MaverickUK/HDDSynthPro/docs/activity-link.md

# Activity link to the HDD Synth

IDE Synth Bay knows exactly what the emulated drive is doing; the HDD Synth only sees an activity LED. This link sends the drive's activity to an HDD Synth over a one-way UART, so the synth can play a different sound for sustained sequential transfers than for random access.

> **Protocol version 2 (0.19.0):** head positions (`$HDE`) for the HDD Synth's modelled drives, and authentic seek timing (`seek_timing`, with the model from the synth's `$HDM` on the reply wire): [below](#protocol-version-2-head-positions-and-the-synths-model), from [hddsynth-head-position-brief.md](hddsynth-head-position-brief.md). The HDD Synth side is in its firmware v0.21.0. Host-tested; not yet run on the rig or with the synth.

Status: **the IDE Synth Bay side is built (0.9.0)** and sends on the rig, with a loopback test (0.10.1): fit a jumper from GPIO 0 to GPIO 1 (EXT1 pins 4 and 5), then console `U`, or `pytest -m link`. Not yet run with the jumper; with the UART's internal loopback it passes. Still to do: the HDD Synth side, briefed in [hddsynth-activity-link-brief.md](hddsynth-activity-link-brief.md); its receiver can copy `activity_link::Receiver`.

As built, it differs from the plan below in two places:
- **UART0 is driven through the Pico SDK, transmit only**, not Arduino's `Serial1`. `Serial1.availableForWrite()` only says whether one byte fits and `write()` waits when the FIFO is full, so it couldn't keep the rule that core 0 never waits; it also enables a receive interrupt, which a floating GPIO 1 could trigger. Now GPIO 1 isn't touched, and a sentence is written only when the 32-byte TX FIFO is empty, so it always fits.
- **The last operation is tracked next to the link** (`activity_link::opOf()` on each media command), not in `activity::Classifier`, which stays as it was.

## What is sent

Three things, all of which the drive already knows:

| Field | Values | Source |
|---|---|---|
| Busy | 0 or 1 | The activity LED's own rule: a command is running, or one started in the last 25 ms (`cfg::LED_MIN_MS`). Instant, so the synth can start its access sound at once, as it does from the LED today. |
| Class | `I` idle, `S` sequential, `R` random | The activity classifier (`src/activity.*`): the recent mix of sequential commands and seeks. It decides within about 100-250 ms (`activity::Config`). |
| Operation | `R` read, `W` write, `-` none | The last media command. Not used by the synth yet; sent so a later version can play different read and write sounds without a protocol change. |

The synth plays its access sound while busy, as today, and chooses the sample by class: `sequential.wav` while sequential, `access.wav` otherwise.

## HDD Synth side

Built in HDDSynth_Native **v0.18.0**. On the synth's SD card, in `settings.json`:

```json
"EXPERIMENTAL_HDDSYNTHPRO_SUPPORT": true,
"SEQUENTIAL_LED_COLOUR": "#FF1800"
```

- `EXPERIMENTAL_HDDSYNTHPRO_SUPPORT` (default `false`) turns on the receiver on J6 and `sequential.wav`; it switches the synth's OLED off, since they share J6.
- `SEQUENTIAL_LED_COLOUR` is optional (default orange, `#FF1800`): the activity LED's colour during sequential transfers.
- `sequential.wav` is optional per pack; a pack without it plays `access.wav` for sequential transfers too.
- The synth's serial `s` stats show the link (`up`/`lost`, the last class, valid and rejected sentence counts), and it logs `[link] up` and `[link] lost`.

## Wiring

Ground and one data wire. **Never connect the two boards' 3.3 V pins:** each is powered on its own.

| IDE Synth Bay (BB48) | | HDD Synth MK5 (header J6) |
|---|---|---|
| GPIO 0 (UART0 TX), EXT1 pin 4 | 1 kΩ in series | pin 3, GP25 (UART1 RX; the OLED's SCL) |
| GND, EXT1 pin 2 | | pin 2, GND |
| GPIO 1 (UART0 RX), EXT1 pin 5 | 1 kΩ in series; only for `seek_timing = synth` | pin 4, GP24 (UART1 TX; the OLED's SDA) |
| (not connected) | | pin 1, 3.3 V |

- **Power over the link (IDE Synth Bay PCB, rev 0.3 on):** the board's J3 pin 1 takes **5 V** through a Schottky diode into its supply, so a future HDD Synth can power both boards from one supply. The Mk5's J6 pin 1 carries 3.3 V, so with the Mk5 leave pin 1 unconnected (the BB48 has no such input at all).

- The 1 kΩ resistor limits the current into the synth's pin if one board is powered and the other isn't (the HDD Synth runs on its supercap after a power cut, and an unpowered RP2350's pin would otherwise be fed through its protection diodes). It doesn't matter at 115200 baud.
- J6 carries either the OLED or the link, not both: the same pins.
- GPIO 0 and 1 are off the IDE bus and away from the BB48's pull-ups on GPIO 2/3 (see [wiring.md](wiring.md)).

## Protocol, version 1

- UART, **115200 baud, 8N1**, 3.3 V logic, one way (IDE Synth Bay → synth).
- ASCII lines in the style of NMEA, so a USB-serial adapter and a terminal show them as they are:

```
$HDA,1,<busy>,<class>,<op>*<checksum>\r\n
```

| Part | Meaning |
|---|---|
| `$HDA` | Sentence name: HDD activity |
| `1` | Protocol version |
| `<busy>` | `0` or `1` |
| `<class>` | `I`, `S` or `R` |
| `<op>` | `R`, `W` or `-` |
| `*<checksum>` | Two upper-case hex digits: the XOR of every byte between `$` and `*`, as in NMEA |

Examples, with their real checksums (use them as known answers in tests):

```
$HDA,1,0,I,-*28      idle
$HDA,1,1,S,R*4C      busy, sequential reads
$HDA,1,1,R,W*48      busy, random writes
$HDA,1,1,S,W*49      busy, sequential writes
$HDA,1,0,R,R*4C      not busy this instant, recent mix still random
```

Rules:
- A sentence is sent **on every change** of any field, and **every 200 ms** regardless, as a heartbeat.
- A receiver ignores any line that doesn't start with `$HDA`, fails its checksum or is longer than 80 bytes, and ignores extra fields after the ones it knows. A later version adds fields at the end and keeps these.
- A receiver treats the link as **present** after one valid sentence, and **lost** after 1 s without one. When lost it falls back to its own activity input.
- Bandwidth: a sentence is 20 bytes (about 1.7 ms on the wire). Even random 4 KB reads at ~76 commands a second change busy far less often than that, because busy holds for 25 ms; the link stays well under its 11.5 KB/s.

## Protocol, version 2: head positions and the synth's model

Added in 0.19.0 for the HDD Synth's modelled drives (its v0.20.0 on), which synthesise the drive with a virtual head. `$HDA` stays version 1, unchanged, and a synth older than v0.21.0 ignores the new sentences.

### `$HDE`: where the head goes (IDE Synth Bay → synth)

```
$HDE,2,<pos>,<op>,<sectors>*<checksum>\r\n
```

| Field | Value |
|---|---|
| `2` | Protocol version |
| `pos` | The command's first LBA as a fraction of the disk: `lba * 65535 / (total_sectors - 1)`, 0-65535. The synth places it on the stroke itself (zoned recording puts LBA 0 at the outer edge) |
| `op` | `R`, `W` or `-` (a verify or seek), as `$HDA`'s |
| `sectors` | The command's sector count |
| checksum | As `$HDA`'s |

Known answers: `$HDE,2,0,R,8*21`, `$HDE,2,32768,W,128*2F`, `$HDE,2,65535,R,1*28`.

- One for each media command as it starts: a read or write when core 0 gets its first sector (`Fetch` carries the command's first LBA and count), a verify or seek from its trace event. Always on with the link.
- At most one every 2 ms (`cfg::LINK_HEAD_GAP_US`, about its time on the wire): faster commands keep only the newest target (`s`: `head_replaced`). A due `$HDA` (a change, or the 200 ms heartbeat) goes first, and `$HDE` takes the gaps (`activity_link::nextSentence`).
- With seek timing on, each target goes out when the modelled seek starts, not when the command arrives, so the synth's head moves when IDE Synth Bay's does.
- `s` shows `head_sent`, `head_replaced` and `head_last`.

### `$HDM`: the synth's model (synth → IDE Synth Bay)

On the link's other wire (the synth's J6 pin 4, GP24, into GPIO 1), every 2 s and at once when its pack changes:

```
$HDM,2,<V|S>,<rpm>,<cylinders>,<fullStroke ms x10>,<track ms x10>,<settleDamp x100>,<step ms x10>,<stepRamp x100>,<zoned 0|1>*hh
$HDM,2,-*hh          a recorded pack: no model
```

- GPIO 1 is UART0 RX from start-up, pulled up inside (a UART line idles high, and only pull-downs are forbidden), so unconnected it reads idle. Core 0 reads the RX FIFO on every loop pass into a `LineAssembler` (from HDD Synth's `sentence.*`) and parses with HDD Synth's own `parseModelSentence()` (`drive_timing.*`). A lost sentence doesn't matter: the next comes 2 s later.
- Bad lines are counted (`s`: `hdm_valid`, `hdm_rejected`, `link_rx_errors`), never acted on. After 5 s without a valid `$HDM` the model is forgotten.
- Only `seek_timing = synth` needs it; `$HDE` and the presets work with TX and GND alone.

### Authentic seek timing

`seek_timing` in `HDDSYNTH.INI` ([settings.md](settings.md)): `off` (default), `synth`, or a preset (`stepper85`, `voice91`, `voice97`, `fdb05`, the synth's own). Console `H` switches it off and on until a restart.

For each sector core 0 reads or writes, `seek_timing::Scheduler` says when its result may go to core 1; until then the drive shows BSY, as a real drive does during a seek (IORDY is never held for it). Read-ahead and write-behind work underneath as before: the timing only decides when each sector is released. The same holds for writes, and for DMA, whose bursts wait for each sector's result.

```
x       = lbaToStroke(lba / total_sectors, zoned)              where the head must go
start   = max(now, head_free_at)                                the head must be free
arrive  = start + seekTimeUs(head_x, x)                         0 on the same track
wait    = rotationalWaitUs(arrive, lba, 63)                     the sector coming round
ready_k = arrive + wait + transferUs(k + 1, 63)                 sector k under the head
```

- One free-running microsecond clock; the platter's angle is that clock modulo a revolution. 63 sectors a track (identify's default geometry) set the rotational and transfer times.
- **Reading straight on:** a command that starts at the sector after the last one's doesn't seek or wait for the platter: it carries on from where the last ended, with up to a revolution read ahead if the host was slow to ask, as a drive's read-ahead or write cache allows. Without this a host whose next command comes a fraction of a millisecond after the last ended (DMA through the adapter) would wait nearly a whole turn every command, and sequential transfers would run at half the media rate.
- No command is held more than 1 s (`seek_capped` in `s`). The slowest preset, `stepper85`, takes 528 ms for a full stroke.
- Not modelled yet: `SEEK` commands don't move the modelled head (no fetch reaches core 0 for them), and a write's first sector is timed from when it arrives, after the host has sent it.

## IDE Synth Bay side: the plan (version 1)

All on core 0. Core 1 and the bus timing are untouched.

1. **Pins and docs.** `cfg::PIN_LINK_TX = 0` (and `PIN_LINK_RX = 1`, reserved) in `src/config.h`; a section in `docs/wiring.md` and the wiring diagram; a note in CLAUDE.md's pin rules.
2. **Last operation in the classifier.** `activity::Classifier` keeps whether the last media command read or wrote (from the command byte it already sees). Host-tested.
3. **`src/activity_link.*`**, in two parts:
   - pure C++, host-tested: `formatSentence(busy, state, op, buf)` with the checksum, and `LinkSender`, which decides when to send (on change, or 200 ms since the last);
   - the hardware part: `Serial1` (UART0) on GPIO 0 at 115200. It writes only when `Serial1.availableForWrite()` has room for the whole sentence, so it never blocks core 0 (which must keep serving fetches). A sentence that can't be sent is replaced by the next.
4. **`main.cpp`**: `loop()` feeds the link from the same busy flag as the LED and the classifier's state, once a millisecond with the activity update.
5. **Console:** `s` shows `link_sent=` and the last sentence; `L` turns the link on or off (on by default).
6. **Tests:**
   - C++: sentence format and checksum (known answers shared with the Python parser), the send rules (change, heartbeat, a full UART);
   - Python: `host/hddproto/activity_link.py`, a parser that is also the reference for the synth's, with `sim` tests;
   - on the rig, a loopback test: a jumper from GPIO 0 to GPIO 1, and console `U` reads back what was sent. No HDD Synth needed;
   - with the synth: run the activity rig test (`-m activity`) and watch the synth switch samples.
7. Version bump, CHANGELOG, and a section in [activity.md](activity.md).

## Later

- **Protocol version 3, designed (4 Nov 2026):** the CD-ROM on the HDD Synth's OLED, FDDSynthPro-style, and discs swapped from the synth: per-drive activity (`$HDU`), the disc (`$HDD`), the CD-ROM's position (`$HDP`), the disc list (`$HDL`) and requests from the synth (`$HDQ`, answered by `$HDR`), for the synth's next hardware revision, which gives the link pins of its own: [hddsynth-cdrom-display-brief.md](hddsynth-cdrom-display-brief.md).

- More sounds from the same link: separate read and write samples (the `op` field), seek sizes, spin-down and spin-up from the drive's STANDBY and wake.
- A reply from the synth on GPIO 1 (link up, which pack, volume), if it turns out to be useful.
