MaverickUK/HDDSynthPro/docs/dma.md

# Multiword DMA

Why the drive needs DMA modes, how the data phase works, and the steps to get there.

## Why

The USB-IDE adapter paces PIO reads itself, at about one data word per 1.1 µs, whatever the mode: PIO mode 3 gained reads 2% over mode 0 (0.15.0, `speed-log.md`). In DMA the drive raises DMARQ when it has data and the host strobes it out, rather than polling, so the adapter's PIO pace and its 10 ms poll after each READ may not apply. DMA is also how faster hosts expect a drive to move data.

## How multiword DMA works on the bus

1. The host writes READ DMA (C8h) or WRITE DMA (CAh). The drive sets BSY while it gets ready.
2. The drive raises **DMARQ** (IDE pin 21). The host answers with **DMACK#** (pin 29), and strobes DIOR# (read) or DIOW# (write) once per word, **with the chip selects off**.
3. **There's no IORDY.** Each read word must be on DD within tE of DIOR# falling (50 ns in mode 2), and each write word is valid only tG (20 ns) before DIOW# rises.
4. To pause, the drive lowers DMARQ **as a strobe begins** (within tL, 35 ns in mode 2): the host finishes that word and stops until DMARQ rises again.
5. After the last word the drive clears DRQ, sets the status and raises INTRQ.

| Mode | Cycle t0 | Strobe tD | Read data tE (max) | Write setup tG | DMARQ off tL (max) |
|---|---|---|---|---|---|
| 0 | 480 ns | 215 ns | 150 ns | 100 ns | 120 / 40 ns |
| 1 | 150 ns | 80 ns | 60 ns | 30 ns | 40 ns |
| 2 | 120 ns | 70 ns | 50 ns | 20 ns | 35 ns |

## The design

**A second PIO program for the data phase** ([src/ide_dma.pio](../src/ide_dma.pio)): `ide_dma_read` and `ide_dma_write`, which fill a PIO block's 32 instructions between them. `ide_bus` keeps every register access and ignores DMA strobes (no chip select). Each burst:
- core 1 puts the number of words, less one, in the TX FIFO;
- the program raises DMARQ (side-set on GPIO 31);
- reading, RP2350 DMA streams the sector buffer into the TX FIFO, one word per entry (16-bit DMA writes); the program presents each word when DIOR# falls and releases DD when it rises, so DD is driven only during a strobe;
- writing, the program takes each word as DIOW# rises (DIOW# skips the input synchroniser and DD doesn't, so `in pins` sees DD from just before the edge), and DMA moves the RX FIFO into the sector buffer;
- DMARQ falls on the instruction after the last strobe is seen (side-set takes effect when an instruction issues, even one that then waits, so it can't go on the `wait` itself), and the program raises IRQ 0.

A burst is a sector: the device has the next one fetched (read-ahead) or a buffer free (write-behind), or DMARQ stays low until it has.

**Core 1 starts each burst** (`serviceDma` in `main.cpp`): from the main loop's step 1, and with early answers also from the tight bus loop's idle work, since in DMA the host waits for DMARQ instead of polling, so the bus is quiet between bursts and the main loop's steps would wait out `EARLY_BUS_ONLY_US` (10 ms) each time: 12 s per 64 KB read until 0.30.0-dev.3.

**The CD-ROM build** ([atapi.md](atapi.md)) uses the same programs for PACKET's data phase (0.30.0-dev.3): each block of a reply or a disc read is one burst, of any length, with the packet itself still by PIO.

**DMACK# isn't watched.** A strobe with the chip selects off only comes after DMACK#, and DD is driven only while DIOR# is low, so a host that stops early never finds the bus driven. On the PCB DMACK# is on GPIO 3 for later use (Ultra DMA needs it).

**PIO blocks:** `ide_dma` takes the third block, which SDIO will want too; how they and the diagnostics share the three is in [pio-allocation.md](pio-allocation.md).

**The data lines change hands each burst.** On the RP2350 a GPIO is driven by one PIO block at a time (its function select), and `ide_bus` fills one block, so the DMA programs go in another (the IORDY timer and bus observer share the second; the third is free). Core 1 hands DD0-15 to the DMA block before a burst and back after it, so a status read between bursts is still answered by `ide_bus`. Inputs aren't affected: every block reads every pin.

**DMARQ is driven only during a DMA command**: an input otherwise, which the host pulls down.

## Steps

1. **Simulator (done):** `ide_dma.pio` against a multiword DMA host (`host/hddproto/mdma_host_model.py`, `host/tests/test_dma_sim.py`) in modes 0-2: every word right over two-sector transfers, read data within tE and held tF, DMARQ falling 10 ns after each burst's last strobe begins, short and single-word bursts, DD released between strobes.
2. **Firmware (done, 0.16.0; not yet tried on hardware):** READ DMA and WRITE DMA in `ata_device` (unit-tested), IDENTIFY's multiword DMA words (49 bit 8, 63) and SET FEATURES 20h-22h; `ide_dma.cpp` (the DMA channel, handing DD between blocks, DMARQ only during a DMA command, tidying up when a command is cut short). Offered only when `HDDSYNTH.INI` says `mode = mdma0-2`: a host told the drive does DMA would wait for DMARQ forever where it isn't wired.
3. **Hardware (done on the rig, 0.16.2, 29 Oct):** the adapter takes multiword DMA mode 2. Against PIO mode 3 on the built-in disk: sequential reads 5.14 MB/s (1.36), random 4 KB reads 969 a second (78), writes 9.76 MB/s (1.79). The adapter's 10 ms poll after each READ, a PIO behaviour, is gone. Slices 3-4 pass in DMA. Found and fixed on the way: DMARQ rose before the first word was in the FIFO, so word 0 of every sector was lost, and the end of each command held a status poll 1.54 µs.
4. **The bus observer checks DMA data (0.16.3):** reads with no chip select count as data; 331,090 sectors checked on the rig, 0 bad. Checking every word costs core 0 enough to halve DMA reads on the built-in disk (2.6 MB/s).
5. **Next:** a soak in DMA; then SDIO ([pio-allocation.md](pio-allocation.md)), since on an SD image the card (about 1.8 MB/s over SPI) is now the limit.

## The two wires on the BB48 rig

Added on 29 Oct 2026; the PCB's pins, so the same firmware runs on both:

| IDE pin | Signal | GPIO | BB48 pin | Direction |
|---|---|---|---|---|
| 21 | DMARQ | 31 | EXT2-11 | out, only during a DMA command |
| 29 | DMACK# | 3 | EXT1-7 | in (not read yet) |

GPIO 3 carries the BB48's 2.2 kΩ pull-up to 3.3 V (R17, for I2C). The host drives DMACK#, so that's harmless. With the wires in, set `mode = mdma2` (console `E`, then `!`), and the adapter can choose DMA. At rest console `p` shows `DMARQ=0 DMACK#=1`; those levels don't prove the wires (a loose DMARQ also reads 0), DMA working does.
