MaverickUK/HDDSynthPro/host/reference/slice0_probe_jmicron_summary.txt

2 lines before the first RESET# release (power coming up), not judged:
  RESET 520963297 ASSERT
  EV 521022282 WR BOTH 2 - d532 x1 0 0142d532
From the first release:
3001 trace lines, 3001 accesses, 0 commands, 5 reset edges, 0 stalls, 0 dropped
By register:
  RD   CMD.STATUS    430
  WR   CMD.DEVICE    429
  WR   CMD.SECCOUNT  428
  WR   CMD.LBALOW    428
  WR   CMD.LBAMID    428
  WR   CMD.LBAHIGH   428
  RD   CMD.DEVICE    428
  WR   CTL.DEVCTRL   1
  RD   CTL.ALTSTATUS 1
Sequence (first 60):
  +         0 us  RESET RELEASE
  +      4608 us  WR   CTL.DEVCTRL   0000
  +      5000 us  RESET ASSERT
  +     54985 us  RESET RELEASE
  +   2641261 us  WR   CMD.DEVICE    00a0
  +   2641320 us  RD   CMD.STATUS    0000
  +   2641321 us  RD   CTL.ALTSTATUS 0000
  +   2641322 us  RD   CMD.STATUS    0000
  +   2641323 us  WR   CMD.DEVICE    00a0
  +   2641324 us  WR   CMD.SECCOUNT  00a5
  +   2641325 us  WR   CMD.LBALOW    005a
  +   2641326 us  WR   CMD.LBAMID    00aa
  +   2641327 us  WR   CMD.LBAHIGH   0055
  +   2641327 us  RD   CMD.DEVICE    0000
  +   2641328 us  RD   CMD.STATUS    0000
  +   2641331 us  WR   CMD.DEVICE    00a0
  +   2641331 us  WR   CMD.SECCOUNT  00a5
  +   2641332 us  WR   CMD.LBALOW    005a
  +   2641333 us  WR   CMD.LBAMID    00aa
  +   2641334 us  WR   CMD.LBAHIGH   0055
  +   2641335 us  RD   CMD.DEVICE    0000
  +   2641336 us  RD   CMD.STATUS    0000
  +   2641338 us  WR   CMD.DEVICE    00a0
  +   2641339 us  WR   CMD.SECCOUNT  00a5
  +   2641339 us  WR   CMD.LBALOW    005a
  +   2641340 us  WR   CMD.LBAMID    00aa
  +   2641341 us  WR   CMD.LBAHIGH   0055
  +   2641342 us  RD   CMD.DEVICE    0000
  +   2641343 us  RD   CMD.STATUS    0000
  +   2641345 us  WR   CMD.DEVICE    00a0
  +   2641346 us  WR   CMD.SECCOUNT  00a5
  +   2641347 us  WR   CMD.LBALOW    005a
  +   2641347 us  WR   CMD.LBAMID    00aa
  +   2641348 us  WR   CMD.LBAHIGH   0055
  +   2641349 us  RD   CMD.DEVICE    0000
  +   2641350 us  RD   CMD.STATUS    0000
  +   2641352 us  WR   CMD.DEVICE    00a0
  +   2641353 us  WR   CMD.SECCOUNT  00a5
  +   2641354 us  WR   CMD.LBALOW    005a
  +   2641355 us  WR   CMD.LBAMID    00aa
  +   2641355 us  WR   CMD.LBAHIGH   0055
  +   2641356 us  RD   CMD.DEVICE    0000
  +   2641357 us  RD   CMD.STATUS    0000
  +   2641359 us  WR   CMD.DEVICE    00a0
  +   2641360 us  WR   CMD.SECCOUNT  00a5
  +   2641361 us  WR   CMD.LBALOW    005a
  +   2641362 us  WR   CMD.LBAMID    00aa
  +   2641362 us  WR   CMD.LBAHIGH   0055
  +   2641363 us  RD   CMD.DEVICE    0000
  +   2641364 us  RD   CMD.STATUS    0000
  +   2641366 us  WR   CMD.DEVICE    00a0
  +   2641367 us  WR   CMD.SECCOUNT  00a5
  +   2641368 us  WR   CMD.LBALOW    005a
  +   2641368 us  WR   CMD.LBAMID    00aa
  +   2641369 us  WR   CMD.LBAHIGH   0055
  +   2641370 us  RD   CMD.DEVICE    0000
  +   2641371 us  RD   CMD.STATUS    0000
  +   2641373 us  WR   CMD.DEVICE    00a0
  +   2641374 us  WR   CMD.SECCOUNT  00a5
  +   2641375 us  WR   CMD.LBALOW    005a
Opening sequence:
  RESET RELEASE
  WR CTL.DEVCTRL 0000
  RESET ASSERT
  RESET RELEASE
  WR CMD.DEVICE 00a0
  RD CMD.STATUS
  RD CTL.ALTSTATUS
  RD CMD.STATUS
  WR CMD.DEVICE 00a0
  WR CMD.SECCOUNT 00a5
  WR CMD.LBALOW 005a
  WR CMD.LBAMID 00aa
  WR CMD.LBAHIGH 0055
  RD CMD.DEVICE
  RD CMD.STATUS
  WR CMD.DEVICE 00a0
  WR CMD.SECCOUNT 00a5
  WR CMD.LBALOW 005a
  WR CMD.LBAMID 00aa
  WR CMD.LBAHIGH 0055
  RD CMD.DEVICE
  RD CMD.STATUS
  WR CMD.DEVICE 00a0
  WR CMD.SECCOUNT 00a5
  WR CMD.LBALOW 005a
  WR CMD.LBAMID 00aa
  WR CMD.LBAHIGH 0055
  RD CMD.DEVICE
  RD CMD.STATUS
  WR CMD.DEVICE 00a0
  WR CMD.SECCOUNT 00a5
  WR CMD.LBALOW 005a
  WR CMD.LBAMID 00aa
  WR CMD.LBAHIGH 0055
  RD CMD.DEVICE
  RD CMD.STATUS
  WR CMD.DEVICE 00a0
  WR CMD.SECCOUNT 00a5
  WR CMD.LBALOW 005a
  WR CMD.LBAMID 00aa
Quiet afterwards: True
Before: STATS events=197891954 dropped=195262929 stalls=0 ring=0 window=1 skipped=6040631
After:  STATS events=197894962 dropped=195262929 stalls=0 ring=0 window=1 skipped=8137725
