MaverickUK/HDDSynthPro/media/Defrag.png

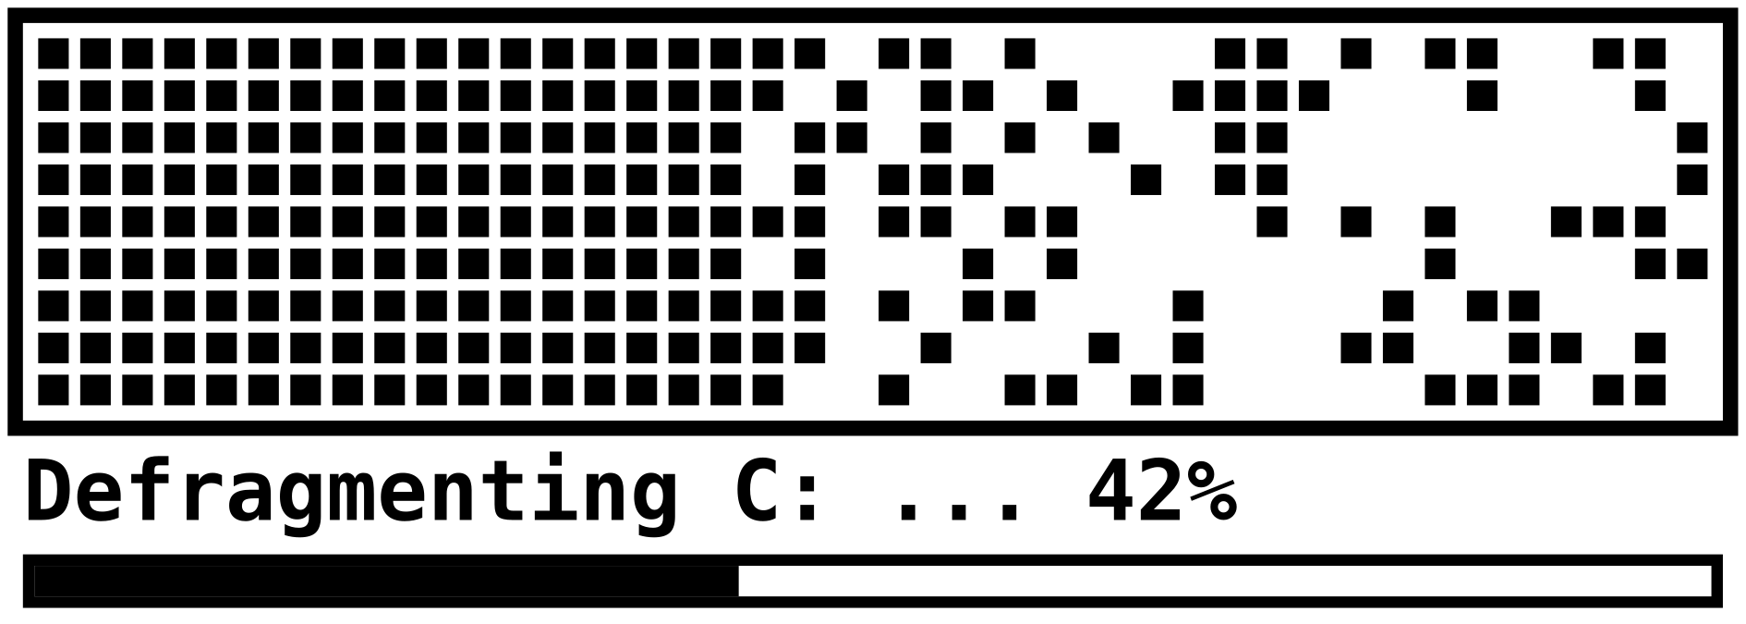
media/Defrag.png
