MaverickUK/HDDSynthPro/media/HDDSynthPro.png

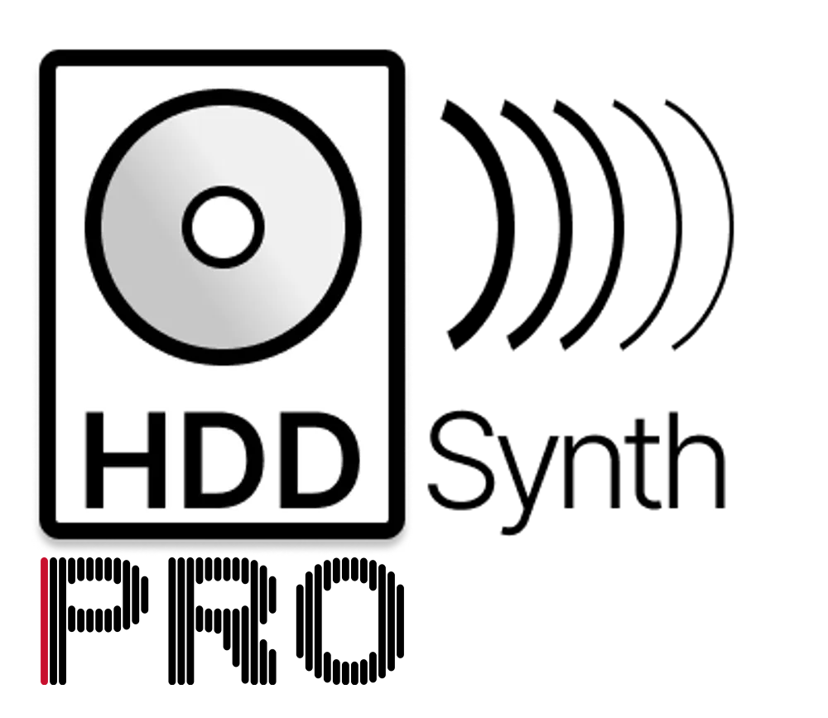
media/HDDSynthPro.png
