MaverickUK/HDDSynthPro/media/HDDSynthProMockSheet2.png

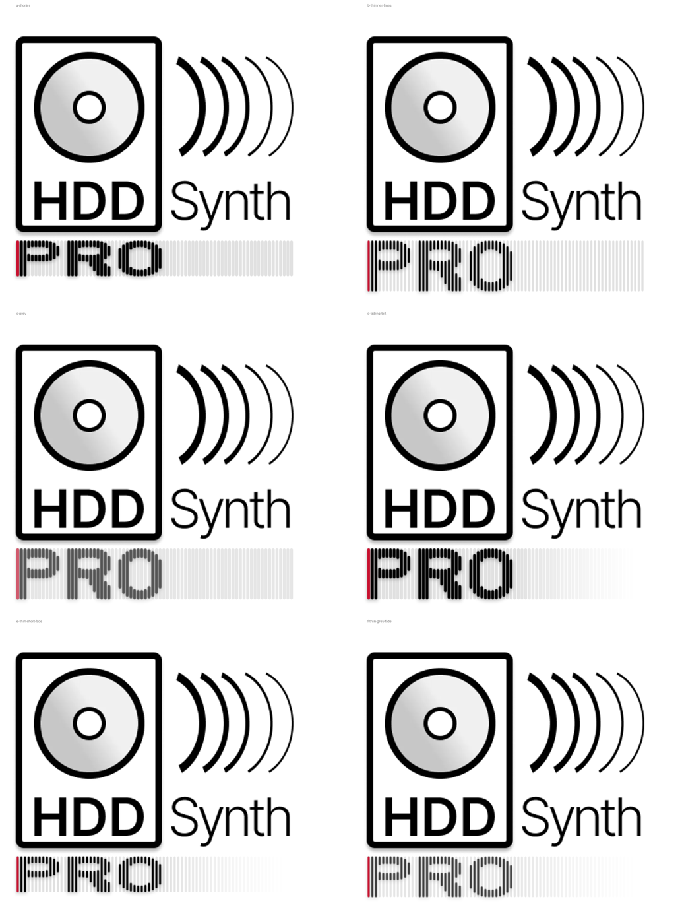
media/HDDSynthProMockSheet2.png
