MaverickUK/HDDSynthPro/media/HDDSynthProMockSheet.png

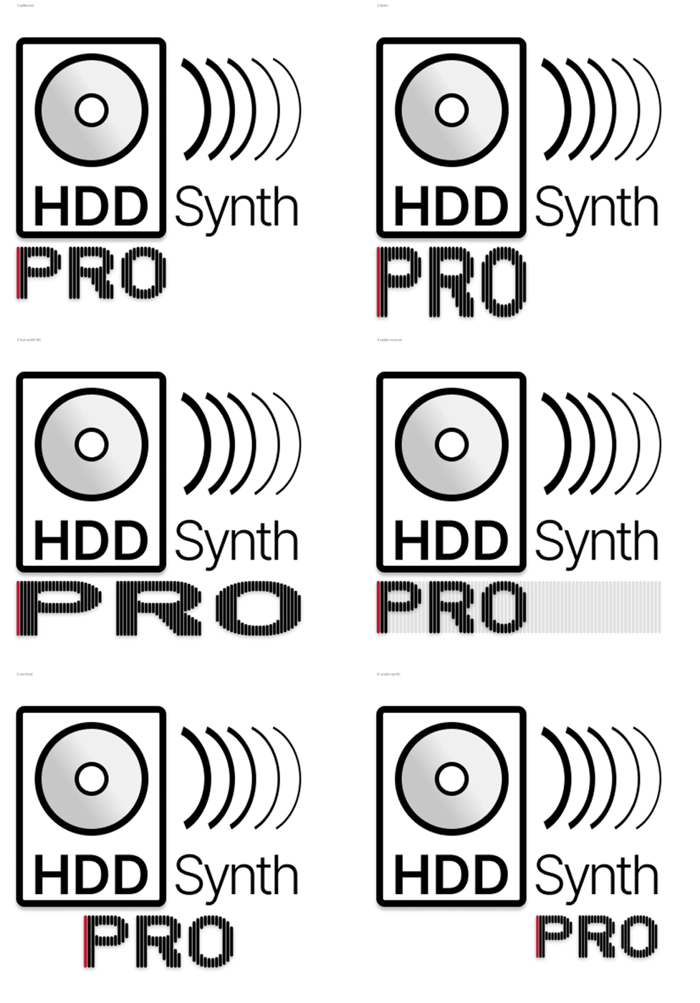
media/HDDSynthProMockSheet.png
