MaverickUK/HDDSynthPro/media/HDDSynthProWide2.png

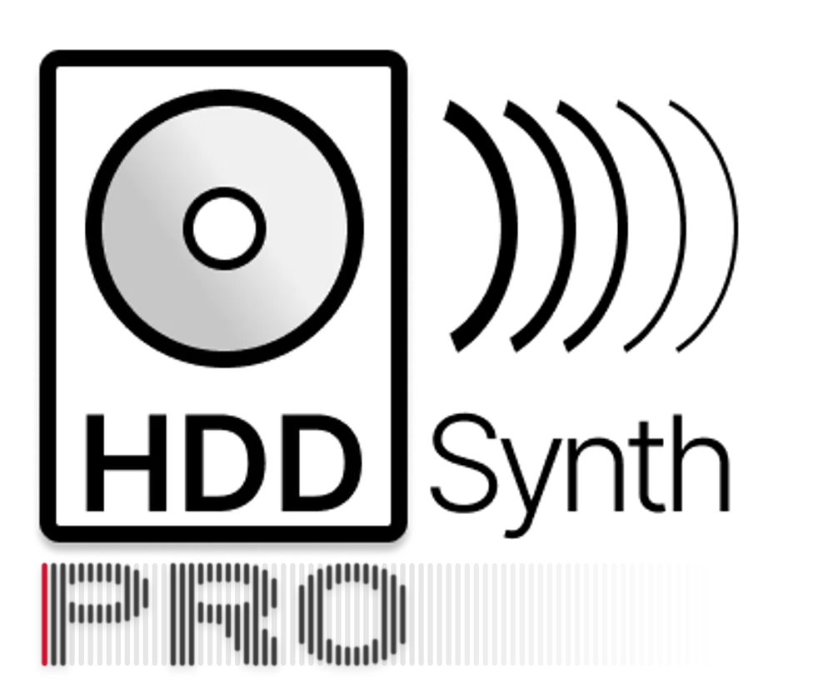
media/HDDSynthProWide2.png
