MaverickUK/HDDSynthPro/media/HDDSynthProWide.png

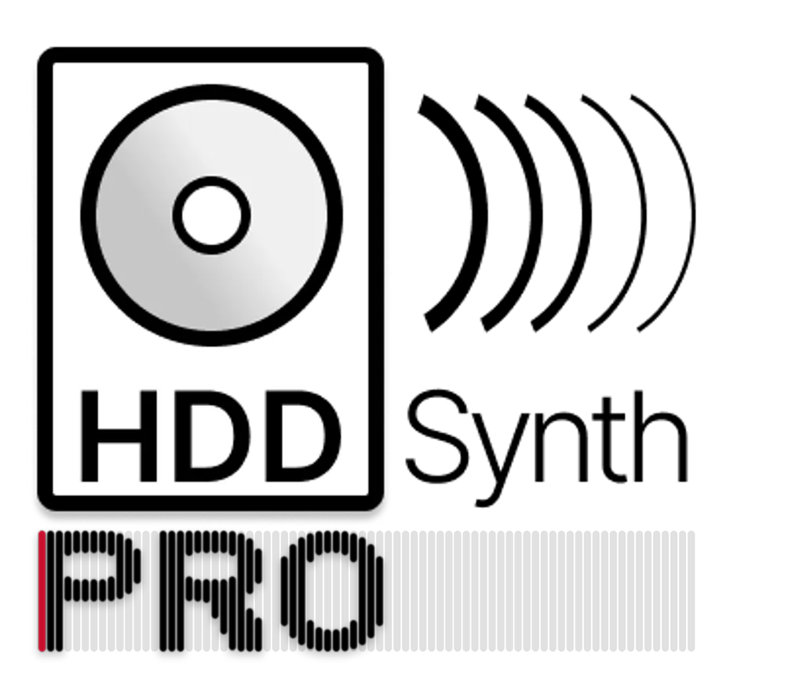
media/HDDSynthProWide.png
