MaverickUK/HDDSynthPro/media/ParkHeads.png

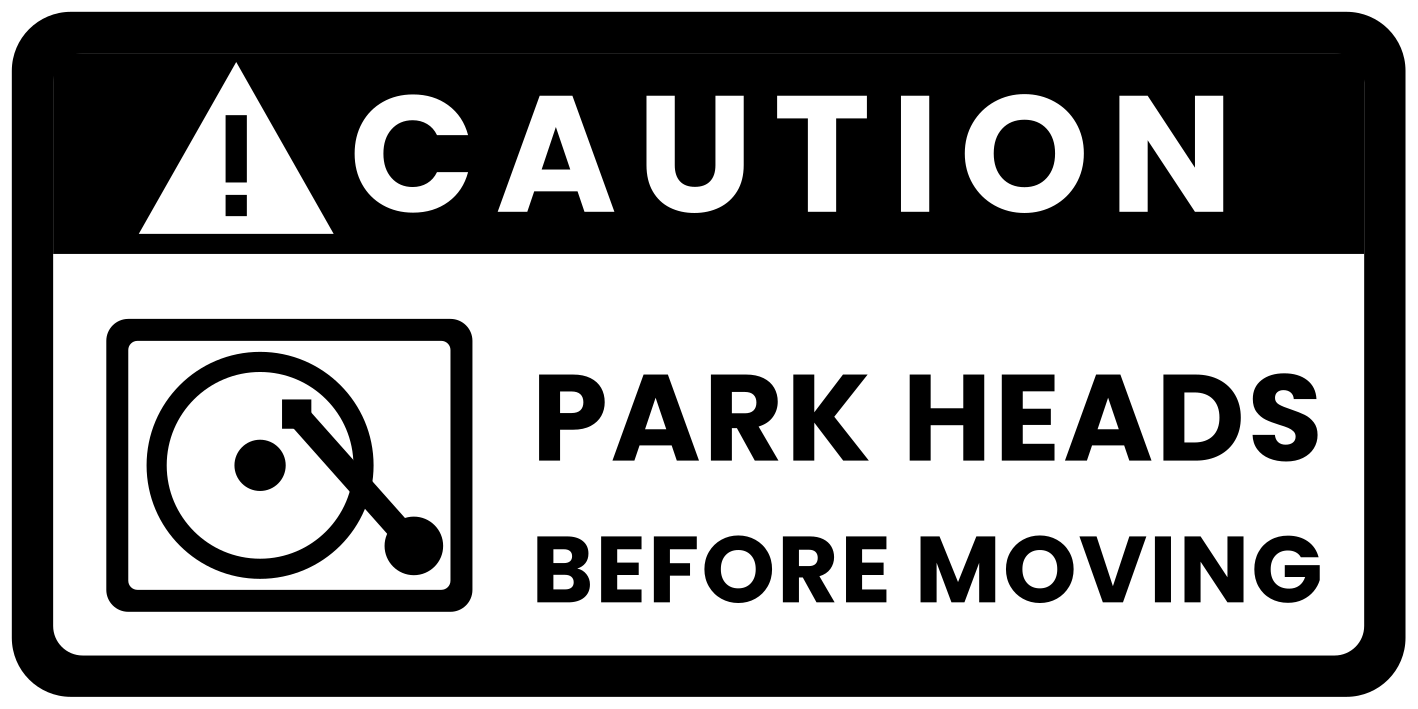
media/ParkHeads.png
