MaverickUK/HDDSynthPro/hardware/production/bom.csv

Designator | Footprint | Quantity | Value | LCSC Part #
C1, C2, C29, C36, C37, C6 | 0805 | 6 | 10uF | C15850
C10, C11, C9 | 0402 | 3 | 4.7uF | C23733
C12, C13, C14, C15, C16, C17, C18, C19, C20, C21, C22, C23, C24, C25, C26, C30 | 0402 | 16 | 100nF | C1525
C27, C28 | 0402 | 2 | 15pF | C1548
C3, C4, C5, C7, C8 | 0603 | 5 | 100nF | C14663
C31 | 0402 | 1 | 1uF | C52923
C32, C33, C34, C35 | 0402 | 4 | 10nF | C15195
D1, D2, D6 | D_SMA | 3 | SS14 | C2480
D3 | 0805 | 1 | Activity | C2297
D4 | 0805 | 1 | Power | C84256
D5, D7 | D_SOD-123 | 2 | B5819W | C8598
F1, F2, F3 | 1206 | 3 | 500mA | C19193043
J1 | USB_C_Receptacle_HRO_TYPE-C-31-M-12 | 1 | USB-C | C165948
J2 | JST_XH_B2B-XH-A_1x02_P2.50mm_Vertical | 1 | 5V in | C158012
J3 | PinSocket_1x04_P2.54mm_Vertical | 1 | Link | C2718488
J4 | microSD_TF-PUSH | 1 | microSD | C393941
J5 | IDC-Header_2x20_P2.54mm_Vertical_Pin20Unplated | 1 | IDE | C19193815
J6 | PinHeader_1x03_P2.54mm_Vertical | 1 | SWD | C2937625
J7 | PinHeader_2x22_P2.00mm_Vertical_Pin20Unplated | 1 | IDE 44 | C5371836
J8 | Molex_8981_1x04_P5.08mm_Vertical | 1 | Disk power | Molex 8981 style, 4 pins, 5.08 mm
J9 | PinHeader_1x04_P2.54mm_Vertical | 1 | CD audio
L1 | L_Abracon_AOTA-B201610S3R3 | 1 | 3.3uH | C42411119
Q1 | SOT-23 | 1 | AO3401A | C15127
R1, R2 | 0603 | 2 | 5.1k | C23186
R10, R11, R12, R13, R7, R8, R9 | 0603 | 7 | 10k | C25804
R14, R15 | 0603 | 2 | 33 | C23140
R16 | 0402 | 1 | 33 | C25105
R17, R19, R49, R50, R51, R52 | 0402 | 6 | 1k | C11702
R18, R44, R45, R46, R47, R53 | 0402 | 6 | 10k | C25744
R20, R3, R4, R6 | 0603 | 4 | 1k | C21190
R21, R22 | 0402 | 2 | 27 | C25100
R23, R24, R25, R26, R27, R28, R29, R30, R31, R32, R33, R34, R35, R36, R37, R38, R39, R40, R41, R42, R43 | 0402 | 21 | 0 | C17168
R48 | 0402 | 1 | 4.7k | C25900
R5 | 0603 | 1 | 470 | C23179
SW1 | SW_Push_1P1T_XKB_TS-1187A | 1 | BOOTSEL | C318884
SW2 | SW_Push_1P1T_XKB_TS-1187A | 1 | RESET | C318884
U1 | QFN-80-1EP_10x10mm_P0.4mm_EP3.4x3.4mm_ThermalVias | 1 | RP2350B | C42415655
U2, U3, U5, U6 | TSSOP-20_4.4x6.5mm_P0.65mm | 4 | SN74CB3T3245PWR | C15298
U4 | SOT-23-6 | 1 | USBLC6-2SC6 | C2687116
U7 | SOIC-8_5.3x5.3mm_P1.27mm | 1 | W25Q128JVSIQ | C97521
U8 | SOT-223-3_TabPin2 | 1 | AMS1117-3.3 | C6186
U9 | SOIC-8_3.9x4.9mm_P1.27mm | 1 | APS6404L-3SQR-SN | C5333729
Y1 | Crystal_SMD_3225-4Pin_3.2x2.5mm | 1 | 12MHz | C20625731
