MaverickUK/HDDSynthPro/hardware/HDDSynthPro.step

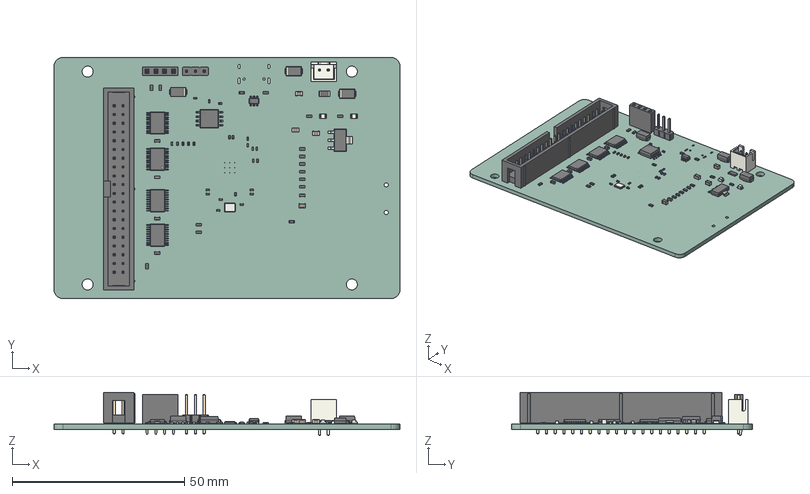
[picture p24: CAD file, 2026-10-28]
hardware/HDDSynthPro.step
100.3 x 69.9 x 12.5 mm
C_0603_1608Metric x 5
TSSOP-20_4.4x6.5mm_P0.65mm x 4
R_0603_1608Metric x 16
R_0402_1005Metric x 6
C_0402_1005Metric x 18
D_SMA x 3
JST_B2B_XH_A
C_0805_2012Metric x 4
SOIC-8_5.3x5.3mm_P1.27mm
PinSocket_1x04_P2.54mm_Vertical
IDC_Header_2x20_P254mm_Vertical
Crystal_SMD_3225-4Pin_3.2x2.5mm
LED_0805_2012Metric x 2
SOT-23-6
Fuse_1206_3216Metric
SOT-223
PinHeader_1x03_P254mm_Vertical
hddsynthpro_PCB
