MaverickUK/HDDSynthPro/docs/wiring.html

IDE Synth Bay · IDE wiring · pin map unchanged since firmware v0.1.0

# Olimex BB48 to a 40-pin IDE header

26 signal wires and the grounds. No power crosses between the boards: they share ground only. Pick any pin or row to see its wire.

Use a plain BB48, not the BB48R

On the R, GPIO 8 is the PSRAM chip-select and GPIO 9–11 and 24 go to its SD slot. Here those pins carry DD4–DD7 and CS1#.

Power order

BB48 on (USB-C) before the adapter's USB is plugged in; adapter unplugged before the BB48. Its pins are 5 V tolerant only while powered. The adapter drives the IDE lines whenever it is powered, even with nothing powered at the drive end, so an unpowered BB48 would be fed through its pins.

One strip per header pin

Before soldering the IDC helper, check with a meter that pins 1 and 2 (RESET# and GND) are on different Perma-Proto strips.

Leave these unconnected

BB48 +3.3V, 3V3_EN, VBUS and VSYS. IDE pins 20, 21, 28, 29, 32, 34 and 39.

## Pin to pin

Show all wires

Data DD0–15 Address DA0–2 Chip selects Strobes (33 Ω) IORDY · INTRQ · RESET# Ground

Left: the IDE header seen from above, pin 1 at the top, odd pins in the left column, pin 20 being the key. Right: the BB48 as drawn in Olimex's pinout, with USB-C at the top; EXT1 (GPIO 0–23) is the left row and EXT2 (GPIO 24–47) the right. Check this against the board's silkscreen. Grounds run through the Perma-Proto ground rail; they are drawn to the BB48's GND pin for clarity.

## Wiring checklist

Clear ticks

Done | IDE pin | Signal | BB48 pin | GPIO | Notes

The ticks are saved in this browser only.

## On the Perma-Proto

- Solder female headers for the BB48 rather than the board itself, so it can be swapped for your spare.
- Seat it across the centre channel at one end, with the EXT1 row (GPIO 0–23) facing the IDC helper at the other end. 21 of the 27 signals are on EXT1.
- Put the two 33 Ω resistors in DIOR# and DIOW#, close to the BB48.
- Run the IDE grounds and the BB48's GND to the same ground rail. Wire all seven IDE grounds if you can, and at least three spread along the header.
- Keep signal wires short, under 15 cm.
- Leave GPIO 32–37 free for the SD breakout in slice 5.

## First power-up check

With the adapter powered and idle, type p in the serial monitor. You should see something close to this:

PINS DD=.... DA=. CS0#=1 CS1#=1 DIOR#=1 DIOW#=1 IORDY=1 INTRQ=0 RESET#=1
- Strobes, chip selects and RESET# are high (idle).
- IORDY is high: the host pulls it up to 5 V.
- INTRQ and DD7 are low: the host pulls them down.
- The other DD and DA lines may float.

A strobe or chip select reading 0 at idle usually means a wire is on the wrong pin.
