MaverickUK/HDDSynthPro/CHANGELOG.md

# Changelog

All notable changes to this firmware. The format follows [Keep a Changelog](https://keepachangelog.com/en/1.1.0/) and versions follow [SemVer](https://semver.org/).

## [Unreleased]

## [0.32.3-dev.1] - 2026-11-11 (on `main`)

### Added
- **The drive says which bus program it would choose for the host** (step one of [docs/auto-bus.md](docs/auto-bus.md); nothing switches). `src/auto_bus.*` applies the design's rule from each RESET# release: no DMA offered, no ISA signature (DIOR# with no chip select), no read the host didn't wait for, 20 reads held past 1,000 ns all waited for, and 1,000 data sectors served. Core 0 prints `AUTOBUS lane|early (why) ... ms after reset` on each change; `s` adds `autobus`, `autobus_why`, `autobus_sectors` and `autobus_long`. Its inputs are new never-cleared totals (`bus_observer::dmaWordsTotal`, `iordy_timer::ignoredTotal` and `longTotal`, sectors served), so `r` and the timer's reset at RESET# can't upset it. Core 0 only: core 1's code unchanged (layout check). `test_auto_bus.cpp`: 7 tests. `retro_log.py` shows `AUTOBUS` and `EARLYDATA` lines. Not yet run on hardware.

## [0.32.2] - 2026-11-11

The CD-ROM's status polls held less: with a CD-ROM configured, register writes that can't change anything take a short path, and INTRQ is worked out inline (dev.1-4, below; [docs/release-notes/v0.32.2.md](docs/release-notes/v0.32.2.md)). The hard disk alone runs 0.32.1's code (layout unchanged).

- **On the Evesham** (`pcb_drive`, the card on SDIO, Doom's demo from `DOOM_SE.ISO`, 25 minutes): 0.55 reads per READ(10) past 1,250 ns, against 0.32.1's 1.32, all Alternate Status; the worst 2,390 ns, against 4,270. 1,405 READ(10), 20,546 sectors checked on the cable, 0 bad, `iordy_ignored=0`, no early reads, no card lost or restarted.
- **On the USB adapter:** `-m cdrom` on both drive builds, slices 3-4 with the CD-ROM beside the disk, and an hour's `-m cdsoak` (dev.4's entry). Slice 2 with a CD-ROM needs physical replugs (the adapter goes silent after `V`, as on 0.32.1).

## [0.32.2-dev.4] - 2026-11-11 (on `main`)

### Changed
- **Reads keep their INTRQ update with a CD-ROM again**, undoing that part of dev.2-3. On the USB adapter, which reads the CD-ROM by DMA, it made `-m cdrom` on `pcb_drive` a quarter slower (2.2-2.4 MB/s against 0.32.1's 3.1). The drive's time per READ(10) was unchanged at 7.1 ms; the gap to the next command grew from 13 to 19 ms. With it built out, 3.06 MB/s. The cause, something in the DMA path that still relies on a poll's INTRQ update, isn't found yet. The quiet writes and inline INTRQ stay. On the Evesham: 0.55 slow reads per READ(10), worst 2,390 ns (0.32.2's entry).

### Tested
- **`-m cdsoak`'s first run, an hour** on `pcb_drive` (dev.3 built without the read-side skip, the same core 1 code as dev.4), the USB adapter, the test disc as device 1 and the test disk as device 0: 498,293 CD reads (1,891,118 frames, by multiword DMA) and 99,935 disk reads between them, 0 wrong; 8,414,965 sectors checked on the cable, 0 bad, no gaps; `iordy_ignored=0`, worst read 2,850 ns. `-m cdrom` 3.06 MB/s (0.32.1: 3.1).

## [0.32.2-dev.3] - 2026-11-11 (branch `cd-slow-status`)

### Changed
- **Register accesses with a CD-ROM cost core 1 less**, so the CD-ROM's Status polls are held less. On the Evesham, slow reads per READ(10) went from 1.32 to 0.49, and the worst from 4,270 ns to 2,420. Each register write had cost core 1 about 1.6 µs, so a poll after the DOS driver's Device Control and Device writes waited behind both. `hdcd::Device::writeQuiet` handles the writes that can't start a command without `write()`'s bookkeeping; Device Control rewritten unchanged does nothing. Core 1 skips the INTRQ update after accesses that can't change it, and INTRQ is worked out inline. For `hdcd::Device` only: the hard disk alone keeps its code (layout unchanged). New test `hdcd_quiet_writes_match_write`. On the USB adapter (`bb48_drive`, the test disk and disc, MDMA 2): `-m cdrom` passes (64 MB of the disc at 2.95 MB/s), and slices 3 and 4 beside it (1,000 write-and-read-back cycles). Slice 2 sticks after its first re-detection on 0.32.1 just the same: with a CD-ROM configured the adapter goes silent after a `V` as after a restart, until a physical replug. Details: [docs/atapi.md](docs/atapi.md).

### Added
- `s` shows core 1's enabled interrupts (`c1_irq`): IRQ 26, the doorbell Arduino-Pico rings only for flash writes. `-DHDDPRO_C1_NO_IRQ=1` (bench) masks them.
- The access log (`-DHDDPRO_ACCESS_LOG=1`) splits each write into the device's part and INTRQ's, and no longer flags data reads falsely (core 1's PIO data loop now notes an empty FIFO).

## [0.32.1] - 2026-11-11

A CD-ROM on a PCI PC could hand it a wrong data word, about one in 2.5 million: fixed. From branch `cd-stale-word` (0.32.1-dev.1-6, below). For the people flashing it: [docs/release-notes/v0.32.1.md](docs/release-notes/v0.32.1.md).

- **Fixed:** a CD-ROM no longer turns `isa` on (dev.5), so the IORDY watchdog runs only where `HDDSYNTH.INI` asks for it. On the Evesham it had released IORDY mid-read, and Doom quit with a texture not found. 82,176 sectors were checked on the cable since the fix, none wrong, where the old rate gave about one per 15,000.
- **Changed:** with a CD-ROM on an ISA PC, set `isa = on` yourself; up to 0.32.0 the CD-ROM set it.
- **Added:** `EARLYDATA` and `iordy_early_data` (dev.4); the bus observer's strobe timing, `-DHDDPRO_OBSERVER_STROBE=1` (dev.1); `-m cdsoak` (dev.1); `STUCK` names a CD-ROM's command (dev.1).
- **Not in this release:** dev.6's watchdog, which starts its count over at every strobe. It's on branch `watchdog-strobes` until it has run on the ICL 386, which needs IOCS16# and so the BB48 rig or PCB rev 0.4. This release's watchdog is 0.32.0's.
- Tested: builds `bb48`, `bb48_drive` and `pcb_drive`, the core 1 checks (layout unchanged), 5,708 native checks and 426 simulation tests, and the Evesham (above).

## [0.32.1-dev.6] - 2026-11-11 (branch `cd-stale-word`; not in 0.32.1, kept on branch `watchdog-strobes`)

### Fixed
- **The IORDY watchdog (`isa = on`) starts its count over at every strobe**, not only when it sees IORDY high. Between back-to-back data reads IORDY is high at the pin only for a moment, so the old watchdog could take 23 µs of reads for one hold and release IORDY mid-read: the Evesham's wrong word (dev.5), which any host fast enough with `isa = on` could still have hit. It now also reads DIOR# and DIOW# on each 30 ns pass (a strobe lasts at least 70 ns), and its count, 767 passes, sits in ISR, set by `ide_bus.cpp` from the clock. A chip select left asserted with no strobe is released as before, 23 µs after the last strobe. 9 instructions (7 before): with `ide_bus`'s 23 they fill the block. Tested in simulation (`test_iordy_watchdog_sim.py`): back-to-back reads with IORDY never reading high between them are left alone (the old program released IORDY among them, and fails the new tests), and a stuck chip select after reads is still released. On the Evesham with `isa = on` (console `P i`, so the observer's image checks are off): it boots and serves Doom. Early reads came at a steady 1.3 per command (98 in 75, 2 of them `EARLYDATA`). The old watchdog gave about 4 per command and dev.5 none, so the new one still releases IORDY at times: perhaps legitimately, in gaps over 23 µs with the drive selected and no strobe (the ICL 386's longest was 11 µs), after which a read starts with IORDY high. Not proven safe on a PCI host: keep `isa = off` there. With the card's own settings (`isa = off`): Doom's demo on the Evesham read 40,536 sectors, all checked on the cable, with none wrong, no early reads, `iordy_ignored=0` and no card lost. With dev.5 that's about 82,000 sectors clean since the fix, where the old rate would have given about 5. Not yet tried on the ICL 386.

## [0.32.1-dev.5] - 2026-11-11 (branch `cd-stale-word`)

The Evesham's wrong CD-ROM data word, found and fixed. dev.2-4 were bench builds for the hunt. Their two experiments are gone again; dev.4's report stays.

### Fixed
- **A CD-ROM no longer turns `isa` on, so the IORDY watchdog no longer runs on PCI hosts.** To keep a CD-ROM on `ide_bus` (the data lane serves only the hard disk's blocks), the firmware forced `isa` on, which also starts `iordy_watchdog.pio`. On the Evesham (PCI, PIO 3, `isa = off` in `HDDSYNTH.INI`), the watchdog released IORDY in the middle of about one data read in 2.5 million words. It took a run of back-to-back reads for a single 23 µs hold, because it checks IORDY once every 45 ns and IORDY is high only for a moment between reads. The host then ended that read at its minimum, 225 ns, and latched DD before the drive drove it. It read the previous word, with DD7 drained low by its pull-down. Doom quit with `R_TextureNumForName: GST0T01` (10 Nov) and `DOORORAK` (11 Nov) not found. `ide_bus::begin` takes a new `lane` argument instead, and `isa` stays as `HDDSYNTH.INI` sets it, so the watchdog and IOCS16# run only with `isa = on`. Evidence, run by run: [docs/atapi.md](docs/atapi.md#a-wrong-data-word-on-the-evesham-doom-quits-10-nov-2026-0320).

### Added
- **`EARLYDATA t`**, a line for each data register read that starts with IORDY still high (the IORDY timer's early reads, data only), and `iordy_early_data` in `s`. On the Evesham it found one, at IDENTIFY PACKET during boot, and none near a wrong word.

### Tested
- **The Evesham, Doom's demo, observer on full checks, strobe timed:** 0.32.1-dev.1 gave 2 bad words in 20,344 sectors. dev.2 (DIOR# through the input synchroniser) gave 1 in 14,432 and dev.3 (DD at 8 mA) 1 in 20,545, so it isn't a DIOR# spike or slow drive. dev.4 (`EARLYDATA`) gave 1 in 19,284, with IORDY low at the bad read's start. dev.5 gave none in 41,640 sectors (where the four before averaged one per 15,000), with no early reads at all. Every bad word had a 225 ns strobe, the shortest in its sector.
- Builds `bb48`, `bb48_drive` and `pcb_drive`, the core 1 checks (layout unchanged), 5,708 native checks and 426 simulation tests.

### Known
- **The watchdog's weakness remains with `isa = on`:** an ISA host fast enough to read back to back with IORDY high only briefly between reads could hit it. A sturdier watchdog would start its count again at every strobe.

## [0.32.1-dev.1] - 2026-11-11 (branch `cd-stale-word`)

Diagnostics for the Evesham's wrong data word (below, *Found*). Core 1's code is unchanged: `check_core1_layout.py` finds every function of both drive builds where 0.32.0 had it, with and without the new build flag.

### Added
- **The bus observer can time each read's strobe** (`-DHDDPRO_OBSERVER_STROBE=1`, a bench diagnostic, off by default): `bus_observer_strobe`, a second program in `bus_observer.pio` (10 instructions to 8; the diagnostics' block then holds 31 of 32), counts its sampling loop's 15 ns passes while DIOR# is low. Its words keep the 21 sample bits and give 6 bits to the count (wrapping every 960 ns) and 5 to the sequence number (gaps still show, modulo 32). `BUSERR` then ends with `strobe_ns=` (the wrong word's read), `before_ns=`/`after_ns=` (the reads either side) and `sector_ns=min-max`. That tells the two explanations left apart: a read the host cut short (tens of ns, against hundreds for the rest) points at something electrical ending the strobe early; one as long as its neighbours means the drive offered the wrong word. Without the flag the observer, its words and `BUSERR` are as before. Tested: `test_bus_observer_sim.py` (the program's lengths, wrap and sequence), `test_pio_plan_sizes.py` (its 10 slots), and `test/run_native_tests.sh` now builds the C++ tests a second time with the flag (`run_tests_strobe`, the new `test_sector_check_reports_the_strobe_of_the_wrong_word` in both). On the PCB (`bb48_drive`, no host): it boots with the observer and the IORDY timer both on.
- **`-m cdsoak`** (`host/tests/test_cdrom_soak.py`): the test disc as device 1 read for `HDDPRO_SOAK_MINUTES` in Doom's pattern (mostly 1-3 frames anywhere), every byte checked, the observer on full checks, and device 0 read between if `HDDPRO_DISK_DEV` names it. Through the rig's adapter the CD's data goes by multiword DMA (it sets the DMA bit on every PACKET), so it can't reproduce a fault in `ide_bus`'s PIO data path; the test says which path it ran on. Not yet run.
- **The simulator's host model** (`ide_host_model.run_host`) can run read-only state machines beside the bus program (`observers=`), keep the last value on undriven DD lines (`dd_keeper=`), let IORDY rise slowly through the host's pull-up (`iordy_rise_ns=`), and end a chosen strobe after t2 whatever IORDY says (`Access.ignore_iordy`). Defaults unchanged.

### Changed
- **`STUCK` names the last command started on either device**, a CD-ROM's packet command included (`STUCK cmd=a0 READ_10 lba=3812 count=3 d1 ...`): it named the last hard disk command, as it recorded only ATA media commands.

### Tested (simulation; `host/tests/test_stale_word_sim.py`)
- **IORDY isn't late for back-to-back data reads:** `ide_bus` pulls it low again about 25-30 ns after DIOR# rises, so it's low at the next strobe's tA with recovery (t2i) down to 20 ns, far below PIO mode 3's 70 ns. The race guessed on 10 Nov (candidate 1 in docs/atapi.md) can't happen in the model.
- **A data read the host doesn't wait for, and so reads wrong, is always flagged** by `iordy_check` running beside `ide_bus`: in 1,165 such cases over core 1 latencies of 40-300 ns, strobes of 60-300 ns, recovery of 10-70 ns, a DD keeper and IORDY rising over 0-25 ns, every one flagged. So the Evesham's wrong word, with `iordy_ignored=0`, wasn't a host skipping its wait as the model knows it. Found on the way: with strobes 10 ns apart the synchronised observer can merge two reads into one word (iordy_check still flags the unwaited one).

### Found (0.32.0)
- **A wrong data word on the cable from the CD-ROM, in a retro PC** (10 Nov, the Evesham, PCB, 0.32.0, `ICL386MB.IMG` as C: and `DOOM_SE.ISO` as device 1, `ide_bus`, PIO 3). Doom's demo quit after about an hour with `R_TextureNumForName: GST0T01 not found`. The bus observer (`bb48_drive`, with the card on SPI to make room for it, full checks) flagged one sector: frame 4341, word 93 carried word 92's value (`TO` for `NE`), so `GSTONE1` arrived as `GSTOTO1`. The rest of the sector was right, and the card had read it right. That was 1 bad word in 11,294 sectors checked, with `iordy_ignored=0`. The same session's earlier failures fit it: errors on D: on dev.6, and a freeze with a striped screen on 0.32.0 over SDIO. The likeliest cause is the host reading a data word without waiting for IORDY, from a stale DD that `ide_bus.pio` had released; perhaps IORDY is pulled low too late for back-to-back reads. Analysis and next steps: [docs/atapi.md](docs/atapi.md#a-wrong-data-word-on-the-evesham-doom-quits-10-nov-2026-0320).
- **`STUCK` names the wrong command for a CD-ROM:** it records only ATA media commands, so it showed the last hard disk READ SECTORS while device 1's READ(10) was the one stuck.
- On 0.32.0 the Evesham also ran Doom cleanly for a session: 2,550 READ(10) and 253 READ SECTORS, none failed.

## [0.32.0] - 2026-11-10

One drive build per board, from branch `one-build` (0.32.0-dev.1-7); each step is below. For the people flashing it: [docs/release-notes/v0.32.0.md](docs/release-notes/v0.32.0.md).

- **`bb48_drive` and `pcb_drive` serve a hard disk, a CD-ROM drive or both, by `HDDSYNTH.INI`** (`device1 = cdrom` beside the disk, `device0 = cdrom` alone); `bb48_cdrom` and `bb48_hdcd` are gone. Core 1 has a loop per device kind, picked at boot, so the hard disk alone runs 0.31.0's code: PIO reads at 0.31.0's speed, writes within 2%.
- **The CD-ROM on the PCB's SDIO card bus.** A CD-ROM always runs `ide_bus`.
- **Core 1's hard disk code has a fixed place in RAM**, checked by CI (`scripts/core1_layout.py`, `check_core1_layout.py`); `check_core1_ram.py` follows calls through function pointers.
- **The access log** (`-DHDDPRO_ACCESS_LOG=1`), a bench diagnostic: what core 1 did before a read it answered late.
- Fixed: on the PCB, device 1's image or disc read through a PIO block the parked card had only borrowed.
- Tested: an hour's soak of each drive build (8.9 million sectors checked on the cable, 0 bad), `-m cdrom` with the CD-ROM as device 0 and 1, slices 2-4, a 30-minute SDIO card soak (0 wrong). Known: the CD-ROM's slow register reads at detection (up to about 8 us; docs/atapi.md): core 1 isn't late for them, and two candidate fixes made no difference, so the cause is looked for before the access reaches core 1. Slice 1's IORDY check still fails, as on every build since 0.28.0.
- The project is renamed IDE Synth Bay (below).

### Changed
- **The project is now IDE Synth Bay** (formerly HDD Synth Pro), as it serves CD-ROM drives as well as hard disks: the README (with the new logo, `media/IDESynthBay.png`), CLAUDE.md, the docs and these release notes use the new name. The repository, file names, identifiers, the console's `READY HDDSynthPro` and the drive's IDENTIFY model keep the old one, so nothing that matches them changes. The PCB (rev 0.4, branch `pcb-rev04`) carries the new logo.

### Tested
- **The PCB build in PIO (9 Nov, 0.31.0, the USB adapter):** `-m speed` from `HDDBENCH.IMG` over SDIO: reads 1.20 MB/s, 75 random 4 KB reads a second, writes 1.02 (the adapter's PIO pace); then `-m cardsoak` for 272 minutes: 4.97 GB written, 8.04 GB read, 606,804 commands, 8 full read-backs, **0 wrong**, no card lost or restarted, `iordy_ignored=0`. The IORDY timer, beside SDIO in that plan, counted 15.4 million reads past 1,250 ns (11.9 million Status, worst 2,070 ns; 3.5 million data, worst 1,710 ns), all waited for: early answers' known slow reads, at the rate the test disk showed without SDIO (8 Nov), so SDIO doesn't slow core 1.
- **The PCB in a retro PC (9 Nov, the Evesham, PIO 3), the benchmark image (`DOSBENCH.IMG`):**
  - `pcb_drive` on early answers: reads 2.29 MB/s (random 0.98 ms), writes 1.25 (the BB48 over SPI: 1.81 and 1.28); a 15-minute `HDDBENCH` soak: 64,792 commands, 2,390,875 sectors checked on the cable, 0 bad; no `NOIORDY`; worst Status read 1,020 ns, worst data read 500 ns. One data read at start-up was held 289 µs (at 52 s, as the BIOS started; waited for): not looked into yet.
  - `pcb_drive` on the data lane (`early_answers = off`): **reads 4.24 MB/s** (random 0.76 ms), writes 2.03 (the BB48 on the lane: 2.18 and 1.98, so SPI was what held the lane's reads back); 0 bad; 2,741 Status reads past 1,250 ns (worst 1,650 ns, the lane's known ones, [docs/data-lane.md](docs/data-lane.md)), all waited for.
- **The Evesham's unwaited CD data reads are gone on the PCB** (`bb48_hdcd`, `ide_bus`, Doom from `DOOM_SE.ISO` with its saves on C:, as on 4 Nov): 2,966 READ(10), **0 `NOIORDY`** (the BB48: 26); 3,663 data reads held past 400 ns, every one waited for, the worst 1,100 ns. So the 5 Nov guess (the Evesham doesn't sample IORDY on the data port) was wrong; the BB48's hand-wired, undamped DIOR# (the PCB has 33 Ω on DIOR#/DIOW#) is the likelier cause, by ringing seen as an early strobe end or a real one ([docs/atapi.md](docs/atapi.md)). The CD's slow Status reads are unchanged (worst 3,620 ns).

## [0.32.0-dev.7] - 2026-11-10 (branch `one-build`)

### Removed
- **dev.6's two candidate fixes for the CD-ROM's slow register reads** (`HDDPRO_HDCD_FAST_WRITES`, `HDDPRO_HDCD_LAZY_INTRQ`), measured on the bench and no help (below). The firmware's code is dev.5's again; the two tests dev.6 added to `test_hdcd` stay, as plain tests of two devices on one cable.

### Tested (10 Nov, the PCB, the USB adapter)
- **Slices 1-2** (`device1 = none`, the test disk, `mode = mdma2`, re-detections from the console): slice 2 passes; slice 1 fails its IORDY check as every build has since 0.28.0, at 1,640 ns (213 reads past 1,250 ns at detection, worst 1,730 ns, on Device). So the slow Device reads at detection aren't the CD-ROM's alone; with a CD-ROM they're three to five times longer.
- **A 30-minute card soak** (`-m cardsoak`, `HDDBENCH.IMG` over SDIO): 0 wrong, no card lost or restarted, writes 1.75 MB/s and reads 2.86 (0.31.0: 1.72 and 2.79).
- **The access log on the CD-ROM's slow reads** (three re-detections, `device1 = cdrom`, `dma = off`): about 140 reads held 4.9-7.7 us, and none of them froze the log. So core 1 had found its FIFO empty less than 1.25 us before answering each one: no long step and no backlog of register writes. The time goes before the access reaches core 1, in `ide_bus.pio`'s path from the strobe to its push, or in a way the log can't see. Its one freeze was a false alarm: core 1's PIO data loop doesn't note an empty FIFO, so 11.7 ms waiting there for the adapter counted as busy.
- **The candidate fixes, compared** (`cd_fixes.sh`, two re-detections each, the access log on; counts from the `SLOWREAD` lines): none 48 slow reads, worst 7,980 ns; fast writes 121 (twice the detections), worst 6,480; lazy INTRQ 213, worst 4,990. Per detection no fewer, and every variant far past 1,250 ns. Both together wasn't run (a console process held the port for its flash).

## [0.32.0-dev.6] - 2026-11-10 (branch `one-build`)

### Added
- **The access log** (`src/access_log.h`), a bench diagnostic built in only with `-DHDDPRO_ACCESS_LOG=1`: core 1 keeps a ring of its last 48 jobs (each access taken from the FIFO, each command run, each loop step over 0.5 us, the FIFO found empty) with its cycle counter, and when it answers a read the host is already strobing after more than 1.25 us busy, it freezes a copy, which core 0 prints as `ACCLOG` lines (how long before the late answer each began). `SLOWREAD` names a slow read but not its cause, and comes up to half a millisecond later. Off, every call compiles to nothing: core 1's layout is unchanged (`check_core1_layout.py`), and no log data is built in. On: RAM 96.3%, `check_core1_ram.py` passes.

### Build
- **`check_core1_ram.py` follows calls through function pointers.** Its docstring said core 1 makes none, but the early answers loop (`serveBusEarly`) calls its `timers`, `command` and `bus` callbacks through pointers, since before 0.30.0, so nothing checked that they and what they call were in RAM. They were. A function's address in a literal pool (odd, for Thumb, and exactly a function's start) now counts as a call: 95 functions reachable from `loop1` instead of 85, all in RAM. Found reviewing `one-build` before its merge; the review found nothing else to fix.

### Added, off
- **Two candidate fixes for the CD-ROM's slow register reads**, build switches in `src/hdcd_device.h`, off until measured on the bench (`host/runs/bench/cd_fixes.sh`, git-ignored, compares them): `HDDPRO_HDCD_FAST_WRITES` sends a Data write to the selected device only (the other's `write()` ignored it anyway) and a task-file register's (Features, Sector Count, LBA) to both by an inlined `latch()` (new in `ata::Device` and `atapi::Device`: `write()`'s path for those registers), skipping `write()`'s calls and `noteStarts`; `HDDPRO_HDCD_LAZY_INTRQ` skips `updateIntrq` after a task-file register's write, which can't change the interrupt or who drives it. Both keep what the host sees as it is: `test/run_native_tests.sh` now also builds `test_hdcd` with the fast writes on (`run_hdcd_fast`), and both builds pass, with two new tests (`hdcd_disk_writes_with_a_cdrom_beside_it`, `hdcd_task_file_writes_reach_both_devices`). Off, the firmware's hard disk code is unchanged (`check_core1_layout.py`) and so is the CD-ROM's (`hdcd::Device::write` 128 bytes); on, `hdcd::Device::write` is 300 bytes and `check_core1_ram.py` passes.
- **`docs/bench-checklist.md` rewritten** for the next session: the old one (4-5 Nov) named the builds 0.32.0 removed.

### Found, to measure
- **The CD-ROM's slow Device reads on `ide_bus`** (10 Nov, `pcb_drive` dev.5, `device1 = cdrom`, `dma = off`, detection through the USB adapter): one Device read held 4,900-5,620 ns just before every IDENTIFY and IDENTIFY PACKET, with an Alternate Status read of 2,100-2,400 ns after it, and Alternate Status at 3,300-3,400 ns before device 1's SET FEATURES and TEST UNIT READY. Repeatable to within 15%, so systematic. Not flash (core 1's literal pools hold flash addresses only in `mmc`'s per-command sense codes), not `selectUnit` (a few stores). The adapter's register check writes five registers back to back, then reads Device: with a CD-ROM each write runs both devices' `write`, `noteStarts` and `updateIntrq`'s two `intrq()` calls, perhaps 0.6 us, but that can't build a 5 us backlog by itself. The access log will say; [docs/atapi.md](docs/atapi.md) has the details.

## [0.32.0-dev.5] - 2026-11-09 (branch `one-build`, overnight)

### Build
- **Core 1's hard disk code has a fixed place in RAM, and CI checks it.** Arduino-Pico's linker script took `.time_critical*` in link order, the source files' alphabetical order, which is how `atapi_device.cpp` once landed between `ata_device.cpp` and `ide_bus.cpp`. `scripts/core1_layout.py`, run by PlatformIO after it generates the linker script, puts `CORE1_RAM` code first in `.data`, file by file in a listed order (0.31.0's), any other file's after them, between the symbols `__core1_hd_start` and `__core1_hd_end`. `scripts/check_core1_layout.py` compares every function there (address, size, name) with `scripts/core1_layout/<env>.txt` and fails on a difference; CI runs it, `rig.sh` warns. Every symbol in both drive builds is where it was (`nm` compared), so the firmware is unchanged; swapping two files in the list moved them, and the check failed, as meant. `host/tests/test_core1_layout.py` tests the linker patch.

### Changed
- **The hard disk's core 1 code is back where 0.31.0 had it.** dev.2-4 read 2.5% slower in PIO than 0.31.0 with byte-identical functions: the CD-ROM's code (`atapi::Device`, from `atapi_device.cpp`, which links before `ide_bus.cpp`) sat between `ata::Device` and `ide_bus`, moving everything after it about 3.6 KB. The CD-ROM's core 1 code now has a section of its own, `CORE1_RAM_CD` (`.after_data.core1_cd`, still RAM, placed after all of `CORE1_RAM`): `atapi_device`, `hdcd_device`, `mmc`, and the `hdcd::Device` copies of `ide_bus`'s and `main.cpp`'s per-access functions, which are now a plain function per device around an inlined template (`IDE_BUS_FOR`, `CORE1_FOR`), defined in 0.31.0's order. `ide_bus`'s hard disk functions start at 0.31.0's addresses (`laneSyncSlow` 0x20000e2c on); GCC's own order puts `serveOther` before `serviceOnce`, so the rest are within 0x390 bytes of theirs, and `main.cpp`'s are together as before.
- **Measured** (`pcb_drive` builds on the PCB, the USB adapter, PIO 3, early answers, the test disk): reads 1.20 MB/s at 337-338 µs a sector and 75.6-75.8 random reads a second, the same as 0.31.0's `pcb_drive` (1.20, 337 µs, 75.7); dev.4 1.18 (345 µs, 75.1). Writes 1.11 MB/s against 1.13 (dev.4 1.11): not core 1's per-access code, which matches 0.31.0's but for literal pools (disassembly compared) and `updateIntrq` (`intrqDriven()` forced inline, as GCC otherwise shares an out-of-line copy in flash); core 0, whose flash code grew, is the next suspect. Worst read 2,100 ns (0.31.0: 2,070).
- **Soaked** (10 Nov, overnight, the PCB, the USB adapter, the test disk, PIO 3, early answers, the bus observer on full checks, an hour each): `bb48_drive` dev.5 2,537 MB, 87,615 commands, 4,350,249 sectors checked on the cable, 0 bad, 0 gaps, no mismatches; `pcb_drive` dev.5 (the card on SPI, left so by the `bb48_drive` run) 2,664 MB, 91,741 commands, 4,567,256 sectors, 0 bad, 0 gaps, no mismatches. Both: `iordy_ignored=0`, worst read 2,110 ns (Status, early answers; 0.31.0 reaches 2,070), worst data read 1,740 ns, no resets.
- **The CD-ROM's code from its new section works** (10 Nov, `pcb_drive` on the PCB, the card on SDIO, the USB adapter, `device1 = cdrom`, `mode = mdma2`): Windows mounted `DOOM_SE.ISO` as D:, and with the test disc and the test disk `-m cdrom` passes (64 MB of the disc read at 3.46 MB/s, random and first and last frames), as do slices 3-4 beside it. Overnight it had looked broken: the card's settings were the Evesham's (`dma = off`), and this adapter sets the DMA bit on every PACKET (docs/atapi.md), so the drive refused TEST UNIT READY (ABRT), the adapter reset and detected again every 20 s, and Windows showed neither drive. Not a firmware fault; the release notes now say so.
- **Rig tests:** with a CD-ROM configured, Windows polls it (GET EVENT STATUS NOTIFICATION) once a second, so `DriveLog.wait_quiet()` never saw a quiet second and slices 1-2 timed out before their first cycle. A CD-ROM's routine polls (`GET_EVENT`, `TEST_UNIT_READY` and the `DONE` after each) no longer count as activity (`PollFilter`, `tests/test_drive_log.py`). Not yet rerun on the rig: the adapter went silent after the drive restarted with a CD-ROM configured (the known limit) and needs a replug.

## [0.32.0-dev.4] - 2026-11-09 (branch `one-build`)

### Fixed
- **`S` and `s` said the diagnostics ran after a disc had taken their PIO block** (console `M` into a CD-ROM that started with no disc on the card, on the PCB): `CONFIG pio ... iordy_timer=off bus_observer=off (the card took the diagnostics' block for a disc, until a restart)`, and `s` says `diag=off`.

### Tested (the PCB, `pcb_drive` dev.3)
- **SDIO with a CD-ROM as device 0:** after the BB48 builds the card ran over SPI with the warning; taken out and put back, it came up on SDIO, parked (`sdio-idle`) with the test disc served, and the adapter detected the CD-ROM on `ide_bus` from the settings alone. `M DOOM_SE.ISO` put the owner's ISO in over the borrowed block, which the card kept (`bus=sdio`); a following `S` didn't take it back. Windows read all 27 files (22.7 MB) at 6.70 MB/s, twice, the passes agreeing; no card lost or restarted, `iordy_ignored=0`.

## [0.32.0-dev.3] - 2026-11-09 (branch `one-build`)

### Fixed
- **A CD-ROM as device 0 was never detected through the USB adapter** on early answers (the setting's default): the adapter polled Status, held 1.8-2.4 µs each, and never sent a command, then dropped off USB, as with a CD-ROM as device 1 on 4 Nov (0.30.0-dev.10). `bb48_cdrom` had managed on early answers with `atapi::Device` alone; through `hdcd::Device` each access costs more. Now any CD-ROM runs `ide_bus` (console `P e` still picks early answers); `S` says `CONFIG with a CD-ROM as device 0, ide_bus`.

### Tested (the PCB, the USB adapter, Windows; dev.2 and dev.3)
- **A CD-ROM as device 1** beside the test disk (`mode = mdma2`): `-m cdrom` reads the whole 64 MB test disc right at 3.37 MB/s (0.30.0-dev.3, without read-ahead: 2.42), random and first/last reads pass; 9,107 sectors checked on the cable, 0 bad, `iordy_ignored=0`. The hard disk beside it in MDMA 2: reads 8.63 MB/s, 1,066 random 4 KB reads a second, writes 12.94 MB/s (0.30.0's `bb48_hdcd`: 9.02, 13.25).
- **A CD-ROM alone as device 0** (`device0 = cdrom`, `ide_bus`): the whole disc at 3.19 MB/s, random and first/last reads pass, 9,196 sectors checked on the cable, 0 bad, IDENTIFY PACKET DEVICE checked too; console `M`: `none`, `test`, a missing ISO (`not found`, then no disc), `test` again, and the host reads the disc after.

## [0.32.0-dev.2] - 2026-11-09 (branch `one-build`)

### Changed
- **One binary, two loops.** dev.1 ran `hdcd::Device` for every configuration, and the hard disk alone paid for it: on the PCB through the USB adapter, PIO 3, early answers, the test disk, 0.31.0's `bb48_drive` read 1.20 MB/s and wrote 1.13; 0.31.0's `bb48_hdcd` (no CD-ROM) 1.14 and 0.90; dev.1 1.17 and **0.83**, its worst read 2,730 ns (2,070), and five times the data reads past 700 ns. Now core 1's bus code is compiled twice: for `ata::Device`, the hard disk alone (with a second disk or folder as device 1, or none), and for `hdcd::Device`, with a CD-ROM as device 0 or 1. `loop1` picks one at boot (`runDrive<Dev>`) and builds the device in storage both share, so RAM holds one. `ide_bus`'s functions are a `CORE1_RAM` overload per device around an always-inlined template (an explicit template instantiation goes to flash whatever its section attribute; `check_core1_ram.py` caught it). `ata::Device::intrqDriven()` is always inlined, as GCC stopped inlining it in the new copy. RAM 95.5% (dev.1: 94.1%; 0.31.0's `bb48_drive`: 91.7%).
- **Measured, A-B-A-B** (each figure repeated to the digit on the same build, so differences are real):

  | | 0.31.0 `bb48_drive` | dev.2 |
  |---|---|---|
  | Early answers: reads | 1.20 MB/s | 1.17 |
  | Random 4 KB reads | 75.0-75.7 a second | 74.9-75.1 |
  | Writes | 1.13 MB/s | 1.11 |
  | Worst read | 2,070-2,080 ns | 2,130 |
  | Data reads past 700 ns (a speed run) | 24,700-28,100 | 21,100-21,300 |
  | Data lane: reads, random, writes | 1.53, 80.0, 1.68 | 1.53, 79.8-80.0, 1.64 |
  | Data lane: worst read | 1,380-1,410 ns | 1,360-1,370 |

  Slices 3-4 pass (259,397 sectors checked on the cable, 0 bad, `iordy_ignored=0`). The 2-2.5% left is where the code sits, not what it does: the hard disk's core 1 functions are byte for byte the size they were in 0.31.0, only about 3.6 KB further on in RAM, behind the CD-ROM code the linker now keeps (CLAUDE.md: *Core split*). A device at a fixed address in place of the pointer changed nothing (tried before dev.3, not kept).

## [0.32.0-dev.1] - 2026-11-09 (branch `one-build`)

One drive build per board ([docs/one-build-per-board.md](docs/one-build-per-board.md), step 2). Built and host-tested; not yet run on the board.

### Changed
- **`bb48_drive` and `pcb_drive` serve a hard disk, a CD-ROM drive or both, by `HDDSYNTH.INI`:** the `bb48_cdrom` and `bb48_hdcd` builds (and `HDDPRO_CDROM`, `HDDPRO_HDCD`) are gone. Core 1 always runs `hdcd::Device`, which before was `bb48_hdcd`'s alone, so the hard disk alone now pays its `cdSelected()` per access: to measure against 0.31.0's `bb48_drive` in PIO (the plan's step 1) before this merges. `cdSelected()` is now one mask and one compare, for no CD-ROM, one as device 1, or one alone as device 0.
- **The CD-ROM on the PCB:** discs are served over SDIO, as images are.
- **The READY line no longer names a build** (`READY HDDSynthPro 0.32.0-dev.1 slice3`). The rig tests find a CD-ROM drive by console `S` instead (`CONFIG device0=... kind=cdrom ...` or `device1=`); `host/bench_session.py` runs every step on `bb48_drive`, with each step's settings on top of those it found.
- `S` reports a CD-ROM as device 0 as `CONFIG device0=NAME kind=cdrom disc=... frames=N` (`bb48_cdrom` said `CONFIG cdrom=... serving=...`).
- CI builds, checks and releases three UF2s: `bb48-listen`, `bb48-drive` and `pcb-drive`.

### Added
- **`device0 = cdrom`** (or a `device0` name ending in `.ISO` or `.CUE`): a CD-ROM drive alone as device 0, as `bb48_cdrom` was: its disc from `cdrom`, the test disc with `cdrom = none` or console `T` (`J` still serves `HDDBENCH.IMG`, as a hard disk), on `ide_bus` (dev.3: below). `device1` is left out, and `S` says so. Settings files from 0.31.0 work unchanged (`device1 = cdrom`, `cdrom = NAME`).
- Host tests: the CD-ROM alone as device 0 in `hdcd::Device`, by PIO and by DMA; `device0 = cdrom` in `drive_config`.

### Fixed
- **The PCB parked the card under device 1's image** when device 0 served nothing from the card (`device0 = none`, or a CD-ROM with no disc): the PIO blocks were shared out before device 1's image, folder or disc was opened, so it was read through a borrowed block that the next console `S` gave back to the diagnostics. Device 1 is now chosen first. On 0.31.0 this already struck `device0 = none` with a `device1` image.
- **Console `M` on the PCB** putting a disc in a drive that started with none (the card parked): the disc now keeps the card's PIO block, as if served from boot, and the diagnostics stay off until a restart (it says so); a disc that can't be opened gives the block back.

## [0.31.0] - 2026-11-09

The PCB build, from branch `sdio` (0.31.0-sdio.1-4); each step is below. For the people flashing it: [docs/release-notes/v0.31.0.md](docs/release-notes/v0.31.0.md).

- **`pcb_drive`: the SD card on 4-bit SDIO** for the HDDSynthPro PCB, on our own copy of SdFat's PIO SDIO driver (`src/sdio_card.*`, fixed). By multiword DMA from the card through the USB adapter: reads 6.2-6.6 MB/s, writes 5.8-7.2, against SPI's 1.38 and 2.00.
- **`src/pio_plan.h`** shares out the PIO blocks at start-up; the test disk parks the card so the diagnostics keep their block, and console card operations borrow it back.
- A card left in SPI mode falls back to SPI with a warning, and the drive restarts onto SDIO when it's put back.
- `-m cardsoak`: hours of checked writes and reads on `HDDBENCH.IMG`. 10 hours on the release's driver, 0 wrong.
- CI runs on every branch, and releases `hddsynthpro-pcb-drive-vX.Y.Z.uf2`. The BB48 builds are unchanged from 0.30.0 (core 1 at dev.13's addresses and sizes).

## [0.31.0-sdio.4] - 2026-11-08 (branch `sdio`)

### Fixed
- **sdio.3's driver broke every multi-sector write** (found on the board, the first speed test): the driver's own `isBusy()` asks `status()`, inside writes and inside `syncDevice()`, so sdio.3's "end the transfer first" ended each write mid-stream (and `syncDevice()` called itself). Every other 128-sector WRITE DMA failed, took about 6 s, and was saved by the card restart and retry (`CARD lost and back`, 102 times in 10 minutes; `STUCK` lines); the data stayed right. Now the driver's own checks use `cardStatus()` (CMD13 as it stands) and only `status()`, for callers outside it, ends the transfer first.
- **On the PCB after the fix:** 20 of 20 `S` lookups; `-m speed` by DMA from the card: reads 6.32 MB/s, 688 random 4 KB reads a second, writes 5.83 MB/s, no `CARD` or `STUCK` lines; two whole-image write-and-verify passes (6.4-6.9 MB/s writing, 5.9 reading), 0 bad.
- **And the rest of sdio.2's checks, on sdio.4's driver:** a 10-minute card soak (1.07 GB written, 1.72 GB read, 0 wrong, no `CARD` lines); the test disk parks the card (`sdio-idle`, the diagnostics beside `ide_dma`), 20 of 20 borrowed lookups, `C` sees `HDDSYNTH.INI`, then slices 3-4 with full observer checks: 259,505 sectors checked on the cable, 0 bad, none dropped or lost, worst read 1,160 ns; and after `bb48_drive` the SPI fallback with its warning, then the card put back and the drive restarting onto SDIO by itself.
- **The overnight card soak on sdio.4 (8-9 Nov, 19:02-05:02, the PCB):** `pcb_drive` serving `HDDBENCH.IMG` over SDIO by multiword DMA, `-m cardsoak` for 600 minutes: 54.72 GB written and 83.26 GB read, every sector checked and 19 full read-backs, **0 wrong**, no card lost or restarted, no `CARD` or `STUCK` lines. Writes 1.42-1.97 MB/s and reads 2.15-2.73 in this random mix, about 15% slower after the first hour and steady after, as sdio.2's soak on SdFat's driver was.

## [0.31.0-sdio.3] - 2026-11-08 (branch `sdio`)

### Changed
- **`pcb_drive` runs the card on our own copy of SdFat's SDIO driver** (`src/sdio_card.*`, from SdFat 2.3.1's `PioSdioCard`, MIT licence; every change marked `HDDSynthPro:`), mounted through a small volume class (`CardFs` in `sd_card.cpp`, as SdFs does it), since SdFs can only use the library's own. The BB48 builds still use SdFs and SPI, and don't link it; their core 1 functions are at dev.13's addresses and sizes. Fixed in the copy:
  - `status()` (CMD13) and `cardCMD6()` end a read or write in progress first, so the wrong-sector reads of sdio.1 can't happen from any caller (sdio.1 worked around it in `cardSilent` only).
  - It claims the two state machines it uses, not all four, and frees only those; and it stops them, and gives the card's pins back to SIO, before removing its programs. The library's freed all four, other users' included, and left two machines running over whatever was loaded next: here, the diagnostics, after a parked card's borrow (sdio.2).
  - No debug printing to `Serial` (the library's `USE_DEBUG_MODE 1`).
  - No input synchroniser bypass, said so: the library's shifted by the GPIO number, past bit 31 for GPIO 34-39, so it never set any. 25 MHz has always run with the synchronisers in.
- `host/tests/test_pio_plan_sizes.py` checks `SDIO_SLOTS` against `src/sdio_card.pio`.
- **Not yet on the board:** built and host-tested while the card soak runs on sdio.2.
- **The card soak on sdio.2 (8 Nov, 14:03-17:53, the PCB, SdFat's driver):** `pcb_drive` serving `HDDBENCH.IMG` over SDIO by multiword DMA (no diagnostics in that set-up), `-m cardsoak` for 230 minutes: 20.73 GB written and 31.55 GB read in runs of 1-128 sectors, every sector checked as read and seven full read-backs of the image, **0 wrong**, no card lost or restarted. Random mixed transfers ran 1.66-1.85 MB/s writing and 2.4-2.5 reading for the first hour, then about 15% slower from 70-80 minutes on (1.36-1.46 and 2.13-2.27; a full read-back 11.1 s, then 13.5-13.8 s) and steady after; reads slowed too, so maybe the card warming up rather than its write housekeeping. Not measured further.

## [0.31.0-sdio.2] - 2026-11-08 (branch `sdio`)

### Added
- **`pcb_drive`: the test disk gets the diagnostics back.** With nothing on the card served (the test disk, `T`), SDIO is ended at boot and the card waits in SD mode (`card_bus=sdio-idle`), so the PIO plan is the BB48's: the IORDY timer and the bus observer run beside `ide_dma`, for soaks and timing runs. A card operation (`S`, `E`, `C`, `I`, `K`, a CUE sheet) borrows the block: `iordy_timer::end()` and `bus_observer::end()` (new: they free their state machines, programs and DMA channel) let SdFat's driver have it, and they start again when it's done (`sd_card::setPioLender`). `configExists()` and `mounted()` count a parked card as there, so `C` can't take it for missing and overwrite `HDDSYNTH.INI`. On the board: with `mode = mdma2`, `CONFIG pio card=sdio-idle dma=on iordy_timer=on bus_observer=on`; 20 of 20 `S` lookups, each borrowing the block; `C` said the file exists.
- **`pcb_drive` restarts to put a card back on SDIO.** Running over SPI because the card didn't start over SDIO at boot, the drive watches card detect: once the card has been taken out and one put back (power-cycled, so in SD mode), it restarts (`SD: a card was put back; restarting to run it over SDIO`), keeping `J` or `T`. Until then nothing sends the card an SPI CMD0, which would put it back in SPI mode (as `S` did on 8 Nov, after the card was put back by hand).
- **Tested on the PCB (8 Nov):** after 20 borrows, slices 3-4 on the test disk in multiword DMA with full observer checks: 263,190 sectors checked on the cable, 0 bad, none dropped or lost; worst read 1,160 ns, `iordy_ignored=0`. The restart: with the card on SPI after `bb48_drive`, the card taken out and put back printed the line and restarted, and the card came back on SDIO (parked, as the test disk was served).
- The BB48 builds' core 1 functions are still at dev.13's addresses and sizes.

## [0.31.0-sdio.1] - 2026-11-08 (branch `sdio`, from `hdd-cd`)

### Added
- **The PCB build, `pcb_drive`, with the SD card on 4-bit SDIO** ([docs/pio-allocation.md](docs/pio-allocation.md)). On the PCB (rev 0.3, 8 Nov), with an uncommitted experiment of the same driver serving `HDDBENCH.IMG` by multiword DMA: reads 6.59 MB/s against SPI's 1.38, random 4 KB reads 651 a second against 285, writes 7.20 MB/s against 2.00; two whole-image write-and-verify passes, 0 bad; 20 of 20 directory lookups (17 of 20 failed on the BB48's hand-wired leads, 29 Oct). The BB48 builds stay on SPI.
  - SdFat's PIO SDIO driver, at 25 MHz (a divider of 2 at 200 MHz). It takes a whole PIO block, so **`src/pio_plan.h`** (pure, `test_pio_plan.cpp`) decides at start-up what else runs: with the card on SDIO and DMA offered, `ide_dma` and no diagnostics; without DMA, the IORDY timer with the bus observer, or with IOCS16# for `isa = on`; on SPI, everything as before. `host/tests/test_pio_plan_sizes.py` holds its instruction counts to the assembled programs, SdFat's included.
  - A card that won't start over SDIO at boot while card detect (GPIO 40) says one is in (most likely left in SPI mode by other firmware: only a power cycle ends that) runs over SPI, and `S` says to take it out and put it back. SdFat's driver keeps its PIO block when it fails to start, so it's ended first.
  - A card that stops answering is found by card detect and CMD13 instead of the SPI CMD0, which would leave it in SPI mode.
  - **Found on the board: SdFat's SDIO driver returns the wrong sectors after a CMD13 in the middle of a read.** Its `readSector` leaves a multi-sector read (CMD18) open between calls and takes the next sector from it without a command; `status()` (CMD13) doesn't end it first, so the reads after it came from a stream out of step: CRC good, no error, other sectors' data. 19 of 20 `S` lookups failed (`image=none config=none` with both files there) while `wakeIfSilent` sent a CMD13 before each; ending the read first (`syncDevice()`, CMD12) made it 20 of 20. Its `readCID()` and `sectorCount()` give what it read at start-up, so a changed card's "still in?" check uses card detect instead.
  - `S`: `bus=sdio|spi` on the `SD ok` line, and `CONFIG pio card=... dma=... iocs16=... iordy_timer=... bus_observer=... bus_timing=...` with why any are off; `s`: `card_bus` and `diag=on|iordy_timer|off`.
  - CI builds and checks it and releases `hddsynthpro-pcb-drive-vX.Y.Z.uf2`.
- The BB48 builds' core 1 functions are at the same addresses and sizes as in 0.30.0-dev.13; `pcb_drive`'s are the same as `bb48_drive`'s.
- **On the PCB (8 Nov):** the card starts over SDIO from power-up (`bus=sdio`), 20 of 20 lookups; the plan as designed (`mode = auto`: the IORDY timer and bus observer; `mode = mdma2`: `ide_dma`, no diagnostics). After `bb48_drive` had left the card in SPI mode, `pcb_drive` ran it over SPI with the warning, and the plan gave the diagnostics and `ide_dma` back.
- **Not yet:** while the test disk is served the card still holds its block (so with DMA offered there are no diagnostics); giving it to the diagnostics, and lending it back for the console's file commands, is next.
## [0.30.0] - 2026-11-08

Everything since 0.28.0, from the branches `two-drives` (0.29.0-2d.x), `atapi-cdrom` (0.29.0), `data-lane`, `merge-cdrom` and `hdd-cd` (0.30.0-dev.1-13); each step is below. For the people flashing it: [docs/release-notes/v0.30.0.md](docs/release-notes/v0.30.0.md).

- **Two drives:** `device1` serves a second image, or a folder as a read-only FAT16 disk ([docs/two-drives.md](docs/two-drives.md)); `image` became `device0`.
- **CD-ROM drives** (exploratory): `bb48_cdrom` (the CD-ROM as device 0) and `bb48_hdcd` (a hard disk and a CD-ROM as device 1), serving an ISO or a BIN/CUE's data track by PIO or multiword DMA, discs changed from the console (`M`) ([docs/atapi.md](docs/atapi.md)).
- **The data lane** (`early_answers = off`), multiword DMA under early answers fixed, device 1 recovering from SD card dropouts, and the diagnostics for the Evesham's unwaited CD reads.

### Tested for the release (8 Nov, the HDDSynthPro PCB rev 0.3 on the Mac, the USB adapter)
- `bb48_drive` dev.13 (the PCB runs the BB48's firmware unchanged): slices 3-4 and `-m speed` on early answers, the default (reads 1.06 MB/s, writes 1.12, 74,143 sectors checked on the cable, 0 bad), and in multiword DMA 2 (reads 7.60 MB/s, writes 10.92; 259,432 sectors checked with full observer checks, 0 bad).
- **Device 1 gets over a card dropout (dev.11):** `bb48_hdcd`, `DOOM_SE.ISO` as device 1, read whole in a loop (23.4 MB, 1.29 MB/s); the card pulled and put back mid-read: reads failed while it was out, the board printed `CARD restarted: it stopped answering (1 in all)`, and every pass after matched the first (SHA-256).
- **Found: macOS reads a CD's whole device with READ CD (0xBE),** asking for raw 2,352-byte frames, which the drive refuses (ILLEGAL REQUEST): `/dev/diskN` fails, its data volume (`/dev/diskNs0`, READ(10)) reads. Windows and DOS use READ(10). Raw frames would need sync, header and EDC/ECC built for each frame (or taken from a BIN's raw frames).

## [0.30.0-dev.13] - 2026-11-05 (branch `hdd-cd`)

### Added
- **Measurements for the Evesham's unwaited CD data reads** ([docs/atapi.md](docs/atapi.md#the-eveshams-unwaited-cd-data-reads-4-nov-2026)), core 0 only:
  - `NOIORDY` lines name the command the last unwaited read fell in or followed, its device, and how long after it started and, if it had finished, after its DONE: `NOIORDY t reads=N data=N last=DATA after=READ(10) d1 +1840us`. `data=` counts the data register's. `src/command_history.h` (pure, `test_command_history.cpp`) keeps the last 16 commands from the CMD/DONE events, so a report collected after the next command started still finds the right one.
  - `s` adds `iordy_ignored_data` and, for the data register alone, its reads held past 400 ns by how long (`iordy_data_slow=` up to 700 ns / 1,000 / 1,250 / longer) and the worst (`iordy_data_max_ns`): how late core 1 answers data words, apart from the status polls that dominate `iordy_max_ns`.
- Every core 1 function in `bb48_drive`, `bb48_hdcd` and `bb48_cdrom` is at the same address and size as in dev.12 (only the linker's veneers moved), and `check_core1_ram.py` passes. **Not yet run on the board.**

## [0.30.0-dev.12] - 2026-11-05 (branch `hdd-cd`)

### Changed
- **dev.11's card retry is host-tested.** What to do when device 1's read, write or sync fails (retry once, after restarting the card; only while the card isn't lost or changed; reopen device 1's file first, and only at the same size) and how to restart the card (as device 0's image read would with an image on it, any card that answers CMD0 without one, nothing while lost or changed) moved from `sd_card.cpp` to `src/card_retry.h`: header-only templates over the card's operations, with no SdFat or SDK code, so `test_card_retry.cpp` drives them with a fake card (17 tests). Behaviour is unchanged. Core 0 only: every core 1 function in `bb48_drive`, `bb48_hdcd` and `bb48_cdrom` is at the same address and size as in dev.11 (only the linker's veneers are in a different order), and `check_core1_ram.py` passes. **Not yet run on the board** (nor is dev.11).

## [0.30.0-dev.11] - 2026-11-05 (branch `hdd-cd`)

From the Evesham session (dev.10, "Tested on a retro PC"). Core 0 only: every core 1 function in `bb48_drive`, `bb48_hdcd` and `bb48_cdrom` is at the same address and size as in dev.10 (only literal-pool words differ, the addresses of core 0's variables), and `check_core1_ram.py` passes. Built and host-tested; **not yet run on the board.**

### Fixed
- **Device 1 gets over a card that stopped answering.** Its image's reads and writes (a CD-ROM's ISO or BIN, or a second hard disk's image in `bb48_hdcd`) went through SdFat's file layer with no retry, so after one card dropout every read failed until the drive restarted: on the Evesham every read of a BIN failed with MEDIUM ERROR, and then `M DOOM_SE.ISO` said `not found`. Now a device 1 read, write or sync that fails is retried once after restarting the card (`device1Attempt`, `restartCard` in `sd_card.cpp`), with device 0's checks: with device 0's image on the card, its watch marks the card lost and `reattach()` brings it back only if it's the same card and image; with none (the test disk), any card that answers CMD0. Device 1's file is closed before every restart and reopened by name at its next read, only if it's still the same size. While device 0's card is lost or changed, device 1's reads fail at once, as device 0's do. A folder's reads aren't retried.
- **`S` and `M` wake a card that has gone silent.** SdFat keeps its volume after a card is pulled, so `S` printed `SD ok ... size_mb=0 image=none bench=none config=none` with the card in (as it did twice on the Evesham), and `M` couldn't find files that were there. Both now ask the card for its size first (CMD9, a few hundred microseconds), and restart it if it doesn't answer: `SD restarted: it had stopped answering`, or `SD error: the card doesn't answer, and couldn't be restarted`. So does reading a CUE sheet.
- **CARD lines for a loss and return between two looks.** `printCardChanges()` printed only when the card's state differed when it looked, so a dropout recovered by the retry within one pass printed nothing (two on the Evesham). It now also compares the loss and restart counts: `CARD lost and back NAME: it stopped answering and was restarted (N in all)`, and, with device 0 not on the card, `CARD restarted: it stopped answering (N in all)`. `s` gains `card_restarts`.

### Found (from the session's logs; no change)
- **Why the card dropped out.** The first dropout is explained: the card was moved to the Mac and back while the board ran, and nothing read the card until the Evesham booted, so SdFat still held the old volume and the card had woken in SD mode (`S`: `size_mb=0`). The first read of C: failed, and `attempt()` restarted it (`card_lost=1`). That's the design working, but `S` and `M` didn't notice (fixed above). The second came during Doom; the likeliest moment is a WRITE SECTORS to `C:\DOOMDATA` that took 174 ms (at 459 s; the others took under 20 ms), long enough for a write that failed, a restart and the retry, though a slow card write can take that long by itself. The third left the card silent between 23:13 and the power cycle: the CUE sheet and the BIN's directory entry were read (from the card: the board had never read them before), then the BIN's first data read failed within 150-200 µs, too fast for a card that is busy (SdFat's timeouts are hundreds of milliseconds) and as fast as one that doesn't drive MISO at all. So the card stopped responding in SPI mode, from a reset or the socket's contacts after it was reseated, not from anything the BIN's reads asked of it; after a power cycle the same reads worked. With dev.11 each dropout prints a timed CARD line. A bench check: pull and reseat the card with the board running, then `-m card` and a CD-ROM read.
- **The Evesham's unwaited CD data reads:** see [docs/atapi.md](docs/atapi.md#the-eveshams-unwaited-cd-data-reads-4-nov-2026).

## [0.30.0-dev.10] - 2026-11-04 (branch `hdd-cd`)

### Fixed
- **`bb48_hdcd` with a CD-ROM as device 1 runs on `ide_bus`, not early answers.** On the bench (USB adapter, Windows) early answers never got past the adapter's power-on probe: its register check (A5/5A/AA/55 written to Sector Count and LBA Low/Mid/High, then read back) recorded LBA High as 00 every time (11,879 times in 75 s) and no read-back, every Status read was held 1.7-2.4 µs, and the adapter retried for good, never offered USB a disk and dropped off USB (a replug after a long spell of it). With or without DMA offered; the hard disk alone (`device1 = none`) on early answers and `bb48_drive` were detected as before. Why is still open (the trace is kept for it). Console `P e` still picks early answers, to reproduce it; `S` says which program runs.

### Tested on the bench (4 Nov, the USB adapter on Windows)
- **PIO speed after dev.3's DMA fix:** the data lane 1.54 MB/s reads, 1.68 writes; early answers 1.21 and 1.13; as before. Slices 3-4 pass on the lane.
- **`bb48_hdcd` on `ide_bus`, `mode = mdma2`, a CD-ROM as device 1:** Windows shows both drives (the disk, and the CD-ROM as D:). The disk in MDMA 2: 9.02 MB/s reads, 1,142 random 4 KB reads a second, 13.25 MB/s writes (as `bb48_drive`). The CD-ROM's 64 MB test disc, every byte checked: 3.42 MB/s with read-ahead (the CD-ROM build without it: 2.42). Both at once: the disk 4.16/5.16 MB/s, the CD-ROM read without errors. Console `M` disc changes seen by Windows as they happen (`DOOM_SE.ISO` mounted as CDFS, ejected, mounted again), and every file on it read through Windows (22.7 MB).
- **`bb48_hdcd` soaked 60 minutes** (dev.10, `ide_bus`, MDMA 2, the test disk as device 0 with the bus observer's full checks, the CD-ROM's test disc read throughout): 1,981 MB written and read back with no mismatches, 139,009 commands (68,354 DMA), 11,976,335 sectors checked on the cable, 0 bad, 0 gaps, none dropped; the CD-ROM read 4.4 GB without an error. Worst read 3,280 ns (Alternate Status, the CD-ROM's known slow reads, [docs/atapi.md](docs/atapi.md)), so it ran with `HDDPRO_SOAK_IORDY_MAX_NS=4000`; at the default 2,000 it stopped after 5 minutes, with the data clean. An earlier try stopped after 10 minutes on two packets the CD-ROM refused with ILLEGAL REQUEST (opcodes it doesn't handle, which Windows sends now and then, as a real drive would answer): the soak now counts those instead of failing.
- **The adapter hangs when a CD-ROM vanishes under it, it seems:** every time the board was flashed, restarted or taken off the bus (console `V`) while the adapter had a CD-ROM as device 1, the adapter went silent (no bus accesses, gone from USB) until it was unplugged and plugged back in; with hard disks alone, flashes and re-detections worked all evening. So `bench_session.py`'s flash-then-re-detect can't run `bb48_hdcd` steps with a CD-ROM unattended: after a flash, replug the adapter by hand. (A retro PC restarts with the drive, so it shouldn't meet this.)
- `host/bench_session.py`: the soak (`--only hdcd-soak`) reads the CD-ROM throughout, and the background reader loads the test disc first and wraps at its end.
- Without DMA offered (`mode = auto`) the adapter's TEST UNIT READY (a PACKET with the DMA bit set) is refused and it resets and re-detects for good: `bb48_hdcd` with a CD-ROM needs `mode = mdma2` on this adapter, as the CD-ROM build does.

### Tested on a retro PC (4 Nov, evening, the Evesham: Athlon XP 2000+, PCI IDE, Windows 98 startup floppy)
`bb48_hdcd` dev.10, a normal build: `device0 = ICL386MB.IMG` (PIO 3, geometry 756/13/51 from its partition table), `device1 = cdrom`, `cdrom = DOOM_SE.ISO`, `mode = auto`, `early_answers = on`, `isa = off`, so `ide_bus`. Logs: `host/runs/retro-20261104-{225907,231130,232103}-evesham-hdcd*.log`.
- **Both drives found, on the primary channel** (the PC's own optical drive on the secondary). From the floppy, `OAKCDROM.SYS` and MSCDEX made the CD-ROM D: and C: was the image's MS-DOS 5 disk; `DIR` listed both.
- **Doom from the CD, its saves on C:** (`C:\DOOMDATA`): 3,361 commands (3,079 READ(10) from the CD, 237 READ SECTORS and 27 WRITE SECTORS on C:, 18 TEST UNIT READY), **every one with good status**; 5,360 sectors checked on the cable, `bus_bad=0`; no `STUCK`, `BUSERR` or `NOCS` (`dior_no_cs=0`, a PCI controller).
- **The host didn't wait for IORDY on 26 CD data reads** (`NOIORDY ... last=DATA`, each just after a READ(10), in its data phase); none on the hard disk's reads (0 at the DOS prompt). The game ran, so they were answered in time, but `ide_bus` doesn't promise that. On the CD-ROM build (early answers) this PC had 107 the same way (3 Nov).
- **The CD's slow status reads:** 16,746 reads held past 400 ns during Doom, worst 3,590 ns (Alternate Status, the driver polling between packets), 2,418 by the DOS prompt (worst 3,160 ns). The host waited for every one (`iordy_ignored` counts none on Status). The known slow reads ([docs/atapi.md](docs/atapi.md)); step 2b of the bench checklist profiles them.
- **Disc changes under MSCDEX** (console `M`): to `none`, `DIR D:` gave `CDR101: Not ready`; to the test disc, the next command got UNIT ATTENTION (medium may have changed), MSCDEX re-read the TOC and sector 16 and said `CDR103: CDROM not High Sierra or ISO-9660 format`, so it noticed the change rather than listing from its cache; to `DOOMBIN.CUE`, the same unit attention, then `DIR D:` and `DIR D:\DOOMCD` listed Doom's files.
- **BIN/CUE works on the board, on a retro PC:** `DOOMBIN.CUE`/`.BIN` (from `tools/iso_to_bincue.py DOOM_SE.ISO --audio 30`: MODE1/2352, then a silent audio track) read as `DOOMBIN.BIN, track 1 of 2 (2352-byte frames from byte 16), 11431 frames`, and served `DOOM_SE`'s files, no errors.
- **Found: the SD card dropped out several times during the session** and a disc change then failed. The card had been put back in while the board ran, and `S` twice reported `size_mb=0 image=none bench=none config=none` with the card in, recovering on its own in between (`card_lost=2 card_back=2`). Device 0 carried on (its reads go through `attempt()`, which restarts the card after a failed read); **device 1's reads go through SdFat's file layer with no retry**, so after a dropout every BIN read failed (MEDIUM ERROR, 3/xx, in 150-200 µs, MSCDEX resetting the CD-ROM and retrying) and `M DOOM_SE.ISO` gave `not found`. Unplugging the BB48 cleared it, and the BIN then read cleanly. Also, **no `CARD` line was printed for those dropouts**: `printCardChanges()` compares the state when it looks, so a loss and recovery between two looks goes unreported. Both to fix.

### Changed
- `scripts/retro_log.py` sends `M disc` lines with their Enter, as it does `E` lines (it sent `M` lines without one, so the drive waited at its disc prompt and took the next character typed as part of the name).

## [0.30.0-dev.9] - 2026-11-04 (branch `hdd-cd`)

### Added
- **BIN/CUE images for the CD-ROM drive** ([docs/atapi.md](docs/atapi.md#bincue-images-0300-dev9)): `cdrom = NAME.CUE`, `device1 = NAME.CUE` or console `M NAME.CUE` serves the CUE sheet's first track, if it is data, from the BIN it names: MODE1/2048, MODE1/2352, MODE2/2352 (XA form 1) or MODE2/2336, each frame's 2,048 data bytes read out of the raw ones. The data track ends where the next track in its file starts, so a mixed-mode game serves its data without its music (no audio tracks: the drive has no audio output); an audio CD is refused with the reason. `src/cue_sheet.*` (pure, `test_cue_sheet.cpp`) reads the first 1.5 KB of the sheet and maps the drive's sectors into the BIN (`RawTrackDisk`); `sd_card::readFileStart` reads the sheet (only reads). Core 0 only: the hard disk build's core 1 functions are at the same addresses and sizes; the CD-ROM builds use about 1.7 KB more RAM (`bb48_hdcd` 94.0%). The BIN's frames aren't 512-byte aligned, so it's read through SdFat's file layer, not the extent map. **Not yet tried on the board.**
- **A design for the drive choosing its own bus program** ([docs/auto-bus.md](docs/auto-bus.md)): `bus = auto`, early answers after every reset, the data lane once the host has shown no ISA signature (`dior_no_cs`), proved it waits for IORDY (reads held past its own strobe, none ignored) and got past detection, and back at the next reset or the first read it didn't wait for; switching block 0's program live; what's still unknown (a host changing timing without a reset), and what to record on each PC for it. Design only.
- **Found reviewing it:** a CUE sheet that failed to parse could blank the name of the BIN still open from the disc before (the card code keeps it, to reopen the file when a card comes back); it's now parsed into a copy and kept only on success. `INDEX 1` (no leading zero, as some tools write it) is read as `INDEX 01`.
- **`tools/iso_to_bincue.py`:** a BIN/CUE from an ISO to test with (MODE1 or `--mode2`, `--audio N` for a silent audio track after it; EDC/ECC left as zeros, which the drive never reads). Its four kinds read back through `RawTrackDisk` identical to the ISO.

## [0.30.0-dev.8] - 2026-11-04 (branch `hdd-cd`)

### Added
- **A candidate fix for the CD-ROM build's slow reads, off by default:** `-DEARLY_POLL_FIRST_NS=1000` makes early answers' tight loop wait up to that long after a command is queued for the host's next access (its first status poll), answer it (BSY), and only then run the command, so a long packet holds the host's second poll, which comes later, rather than its first. For the bench to measure with `CMD_PROFILE` ([docs/bench-checklist.md](docs/bench-checklist.md)); compiled and checked (`check_core1_ram.py`), not yet run on hardware. Normal builds are unchanged.

- **Release notes for 0.30.0** (`docs/release-notes/v0.30.0.md`, for the people flashing it), and CI's release uses `docs/release-notes/vX.Y.Z.md` when there is one (GitHub's generated notes otherwise) and publishes the CD-ROM and hard disk + CD-ROM UF2s too (`hddsynthpro-bb48-cdrom-...`, `hddsynthpro-bb48-hdcd-...`).

- **The register table's design brought up to date** ([docs/no-iordy.md](docs/no-iordy.md)): today's PIO block map (every block nearly full), where the table program would fit (DD's drivers in block 0, write capture in block 1, IORDY's diagnostics off), BSY after a command across blocks (`irq next`, two tables), and why it might end slow reads on every host and the ISA/PCI split with them.

- **A design for the HDD Synth's CD-ROM screen and disc swapping** ([docs/hddsynth-cdrom-display-brief.md](docs/hddsynth-cdrom-display-brief.md)): activity link protocol version 3, with known answers for both sides' tests, the synth's screens, HDDSynthPro's work, and the owner's decisions. Design only.
- **`host/bench_session.py`:** runs a bench session's rig steps by itself (docs/bench-checklist.md): flashes each build, sets the console up (settings, test disk, bus program), re-detects, runs the speed, slice and CD-ROM tests, changes discs while Windows watches, and writes a summary beside the last figures; restores the settings it changed.
- **Mock-ups of those screens** in the brief, drawn with the synth's own font and FDDSynthPro's layouts (`docs/oled-cdrom/`, from `tools/oled_mockups/render_cdrom.py`): the CD-ROM's home screen reading, seeking, idle, with no disc and with no link; the disc picker; ejecting, loading and a refused load; a laser trace; both drives at once. Protocol v3's `$HDL` gains each disc's frames (the picker's sizes), and `bb48_hdcd` sends `$HDD` for its hard disk too (the drives screen).

### Fixed
- Compiler warnings in the builds that don't use everything `main.cpp` holds (`chooseDevice1` in the CD-ROM build, `restart` in the listen build), and a device 1 note that could be cut short.

## [0.30.0-dev.7] - 2026-11-04 (branch `hdd-cd`)

### Added
- **Changing the CD-ROM's disc at run time:** console `M`, then an ISO's name, `test` (the test disc) or `none` (eject), and Enter, in `bb48_cdrom` and `bb48_hdcd`, until a restart. The host sees a real tray's behaviour: a media-removal event and NOT READY while it's out, then a new-media event and a unit attention, medium may have changed (28h; `mmc::discChanged`, `State::attention`). Core 0 ejects first and swaps files only once core 1 has taken the eject, which it does only when the device is idle (`atapi::Device::idle`), so no fetch for one disc is served from the next. Host tests: `mmc_disc_changes`, `atapi_changing_the_disc`, `hdcd_changing_the_disc_leaves_the_disk_alone`. On the board (no host on the bus): swaps between `DOOM_SE.ISO`, the test disc, none and a missing file, in both builds. Not yet seen by Windows or MSCDEX. The hard disk build is unchanged (its core 1 code at the same addresses).

## [0.30.0-dev.6] - 2026-11-04 (branch `hdd-cd`)

From a review of everything since 0.28.0 (`main`), before the next bench session.

### Fixed
- **`bb48_hdcd`: a device could act on what the other was selected for.** A device ignores register writes while it's busy, so with the host selecting the disk while the CD-ROM fetched, the CD-ROM still thought itself selected: the wrapper routed the disk's Status reads to it, and the CD-ROM could take the disk's next command (in a host test, an IDENTIFY DEVICE meant for the disk returned the CD-ROM's IDENTIFY PACKET DEVICE). `hdcd::Device` now keeps the Device register itself, from every write (and 0 after RESET#, SRST and EXECUTE DEVICE DIAGNOSTIC), routes by it, and gives both devices the register again before each command. Host tests: `hdcd_selecting_the_disk_while_the_cdrom_is_busy` (failed five ways before), `hdcd_resets_select_device_0`.
- **A CD-ROM's ISO marked read-only didn't open** (`can't open`), in both CD-ROM builds: images open for writing. Discs now open read-only (`sd_card::openImage`'s and `openDevice1Image`'s `read_only`), so an ISO copied off a CD with its read-only attribute works. A hard disk's image still opens for writing or not at all, since device 0's writes can reach the card's sectors directly.
- **Not a bug, but a measurement for the bench:** `-DCMD_PROFILE=1` (off in normal builds) adds `cmd_run_max_ns` and `cmd_run_max` to `s`, the longest time core 1 spent on a command while the host's next access waited, to tell whether the CD-ROM build's slow reads (up to 3.6 µs on the rig) come from running each packet in early answers' tight loop or from early answers itself. Read from the code: not flash (no function core 1 reaches loads from it), not the bus code's size ([docs/atapi.md](docs/atapi.md)).
- **The welcome disk's README** lists every setting (it lacked `early_answers`, `iordy`, `geometry` and `cdrom`), the CD-ROM options for `device1`, and a new "which settings for your computer" table, as does `docs/settings.md`; the sample `HDDSYNTH.INI` gains `cdrom` and the CD-ROM option in `device1`'s comment.
- **Device 1 could be device 0's own image** (`device1 = DOS.IMG` beside `device0 = DOS.IMG`, or naming `HDDSYNTH.IMG` when device 0 had fallen back to it): the PC would see one filesystem as two disks, and writes through either would corrupt it. Refused now: `CONFIG device1 not used: NAME: device 0 serves it already` (seen on the board).

## [0.30.0-dev.5] - 2026-11-04 (branch `hdd-cd`)

### Added
- **CD-ROM read-ahead** (`bb48_cdrom` and `bb48_hdcd`): a disc read fetches the next 512-byte sector into a second buffer while the host takes the one before, as the hard disk does, so the next block is usually ready at once; `read_ahead = off` or console `A` turns it off, as for the disk. Host-tested (`atapi_read_ahead_keeps_the_next_sector_ready`: one BSY wait for a two-frame read, eight without; a failing read-ahead reports MEDIUM ERROR after the sector before; one cut short by a reset is stale). Not yet measured on the bus. +512 bytes of RAM.

## [0.30.0-dev.4] - 2026-11-04 (branch `hdd-cd`)

### Added
- **`bb48_hdcd`: a hard disk as device 0 and a CD-ROM drive as device 1**, from one board. `device1 = cdrom` (serving the `cdrom` setting's disc) or a device1 name ending in `.ISO` makes device 1 a CD-ROM drive: the ISO, the test disc after console `T` or with `cdrom = none`, or no disc if the file isn't there. Otherwise the build serves what `bb48_drive` does. `hdcd::Device` (`src/hdcd_device.*`) behaves as two devices on one cable: both take every register write and RESET#, the selected one answers reads, runs commands and drives INTRQ, and DMA goes to whichever runs it. `atapi::Device` takes a position: at 1 it answers when DEV is 1, its fetches carry unit 1 and ids with the top bit set (so each result reaches the device that asked), and DEVICE RESET leaves it selected. With a CD-ROM, early answers replace the data lane. `CONFIG device1=cdrom kind=cdrom disc=... frames=...`; the READY line ends `slice3 hdcd`. Host tests: `test_hdcd.cpp` (nine cases), `test_config_device1_cdrom`. On the board: it starts and reports `ICL386MB.IMG` as device 0 and `DOOM_SE.ISO` as device 1; not yet on the bus (the USB adapter was off USB).
- A build of its own for now, since every access takes one more branch: `bb48_drive`'s core 1 code is unchanged (its bus functions at the same addresses), and in the hard disk build `device1 = cdrom` or an ISO isn't served (`CONFIG device1 not used: ... needs the bb48_hdcd build`) rather than served as a hard disk. CI builds `bb48_hdcd` and runs `check_core1_ram.py` on it. RAM: 8.9 KB more than `bb48_drive`.
- `bus_observer::begin` checks device 1's IDENTIFY PACKET DEVICE block when device 1 is the CD-ROM.
- DMA simulation: bursts of a CD-ROM's lengths (4, 9, 18 and 256 words) in modes 0-2, every word within tE and held tF.

## [0.30.0-dev.3] - 2026-11-04 (branch `merge-cdrom`)

### Added
- **The CD-ROM build moves PACKET's data by multiword DMA** when it's offered (by the same settings as the hard disk: `mode = mdma0-2`, or `dma = on` with `mode = auto`, and DMARQ wired). IDENTIFY PACKET DEVICE offers modes 0 to 2 (word 49 bit 8, word 63), SET FEATURES selects one, and a PACKET with its DMA bit takes the packet by PIO, then sends each block as an `ide_dma` burst (a reply whole, a disc read a 512-byte sector per burst), with no byte count limit and one interrupt, at the status phase. Not offered, the DMA bit is still refused (ABRT). Host tests: `atapi_offers_multiword_dma`, `atapi_dma_packets`, `atapi_dma_errors_and_resets_end_the_dma_command`.
- **On the rig** (the Windows rig's adapter, which sends every packet by DMA and so found no CD-ROM drive before): Windows 11 lists `HDDSYNTH PRO CD-ROM USB Device` as D:. `-m cdrom` passes: the whole 64 MB test disc read and checked byte for byte (2.42 MB/s) and random reads, 103,103 sectors checked on the cable by the bus observer, 0 bad, from 31 million DMA words. With the card's `DOOM_SE.ISO`, Windows mounts the CDFS volume `DOOM_SE` and all 27 files (22.7 MB) read without an error (1.36 MB/s: the card over SPI, and no read-ahead yet). Its polling (GET EVENT STATUS NOTIFICATION, once a second) completes in 25 us.

### Fixed
- **Multiword DMA under early answers** (the default bus program since 0.27.0) **took about 12 s per 64 KB read**: the tight bus loop never served DMA, and the main loop's DMA step waited for the bus to be quiet for 10 ms (`EARLY_BUS_ONLY_US`), which in DMA it is between every burst, since the host waits for DMARQ instead of polling. The tight loop's idle work now runs DMA as well. On the rig (hard disk build, MDMA 2, early answers): reads 8.84 MB/s, 1,000 random 4 KB reads a second, writes 12.48 MB/s, worst read 1,140 ns (0.18.1 on `ide_bus`: 7.70, 1,100, 13.9). Unseen until now because DMA is off by default and the retro PCs ran PIO; found by the CD-ROM build, which always runs early answers. The hard disk's core 1 bus functions are where they were; `loop1` grew by 92 bytes.
- **Not yet benchmarked in PIO after this change** (`-m speed` on the lane and early answers): the USB adapter dropped off USB when the board went back from the CD-ROM build to the hard disk's (below), and needs replugging.

### Rig
- The adapter went off USB altogether after the switch back from the CD-ROM build (no USB device, no probing on the IDE side: its controller hung), and only a replug or a PC restart will bring it back (restarting its root hub needs a reboot). Its USB serial number has come through in about 25 garbled variants over the weeks, so this is its decline as much as the switch. Earlier the same day one switch back went cleanly.

## [0.30.0-dev.2] - 2026-11-04 (branch `merge-cdrom`)

### Added
- **`dior_no_cs` in `s`, and a `NOCS` line:** DIOR# strobes with no chip select while the drive offers no DMA (`n/a` while it does). An ISA card passes every I/O read the PC makes to the cable this way (the ICL 386: 19.9 million in a session, which the bus observer counted as DMA words); a PCI controller or a USB adapter shouldn't strobe at all outside the drive's addresses. `NOCS <ms> ms after RESET# release` says how soon the first came after each release (or boot). Evidence for choosing the bus program by itself one day (the lane on PCI hosts, `ide_bus` on ISA ones); [docs/retro-test.md](docs/retro-test.md) asks for it on every PC. Core 0 only. On the rig: 0 through the USB adapter, over a speed run.

### Tested
- **The merge (dev.1) on the rig** (USB adapter, generated disk, the lane, PIO mode 3): `-m speed` as 2d.6 (1.54 MB/s reads, 80 IOPS, 1.68 MB/s writes, worst read 1,320 ns, Alternate Status), slices 3 and 4 pass. The hard disk build's core 1 bus functions are at 2d.6's addresses.
- **A 60-minute soak of dev.2** (the lane, generated disk, full observer checks): 3.3 GB, no mismatches, 112,290 commands, no resets, 5.6 million sectors checked on the cable, 0 bad; worst read 1,330 ns (Alternate Status, as last night's).
- **The CD-ROM build through the USB adapter** (first time; dev.2, the test disc): detected, but no CD-ROM drive for Windows. The adapter sends every PACKET with the DMA bit set (FEATURES 01h), though IDENTIFY PACKET DEVICE offers no DMA; the drive aborts it, as written, and the adapter polls for 17 s, resets it and starts again, every 20 s, never trying PIO. Not from the merge (the adapter decides before the drive answers anything but IDENTIFY). The fix would be PACKET in multiword DMA ([docs/atapi.md](docs/atapi.md)). Worst read 2,830 ns (Alternate Status), the CD build's known slow reads, now repeatable on the rig.

## [0.30.0-dev.1] - 2026-11-04 (branch `merge-cdrom`)

`two-drives` (0.29.0-2d.6) and `atapi-cdrom` (0.29.0) merged: one codebase with the data lane, two drives and the CD-ROM build. Their entries follow, each under its own branch.

### Changed
- **The bus code takes `DriveDevice`** (atapi-cdrom's per-build alias) throughout, the data lane's functions included; `atapi::Device` has every call the lane makes, so both builds compile it.
- **The CD-ROM build runs early answers where the settings would pick the data lane** (`CONFIG the CD-ROM build runs early answers, not the data lane`): the lane was written and tested for the hard disk's 256-word blocks, the CD-ROM proven on early answers and `ide_bus`. `isa = on` still gives `ide_bus`.
- **The CD-ROM build has one drive**, the CD-ROM as device 0: `device1` is the hard disk build's. Its notes read `CONFIG cdrom not used`, the hard disk's `CONFIG device0 not used`.
- `HDDSYNTH.INI` has `device0`, `device1` and `cdrom`; `image` is still device0's old name.

### Fixed
- **A trace clash the merge would have made:** two-drives marked device 1's `CMD` in bit 31 of the event, atapi-cdrom put the packet's opcode in bits 24-31, so a READ(12) (A8h) would have printed as device 1's. The unit now has its own byte, in the padding after the event's kind (still 16 bytes, now checked by a `static_assert`; `config.h` said 12, which the padding never allowed); a host test holds READ(12) to device 0.

## Branch `two-drives`, unreleased

### Tested
- **The data lane soaked 400 minutes** on the USB adapter (2d.6, built-in disk, PIO mode 3, full observer checks, 3-4 Nov): 18.6 GB, no mismatches, 642,672 commands, no resets, 31.9 million sectors checked on the cable, 0 bad. Worst read 1,340 ns, Alternate Status ([docs/data-lane.md](docs/data-lane.md)).

## [0.29.0-2d.6] - 2026-11-03 (branch `two-drives`)

### Added
- Console `P` then `e`, `l`, `i` or `0`: the bus program (early answers, the data lane, `ide_bus`, or the settings') until a power cycle, whatever `HDDSYNTH.INI` says, kept in watchdog scratch 1 across the restart it triggers. For comparing programs on the rig with no card, or without editing the file.

### Fixed
- **The bus observer didn't check image data on the lane:** image checks were switched on with `early_answers` only. They are on now whenever `isa` is off (early answers or the lane), and off with `isa = on` even if `early_answers` is on (the ISA card's DIOR# with no chip select looks like data). On the rig, 16 MB read from `HDDSYNTH.IMG` on the lane: 5,805 sectors checked on the cable, 0 bad, no reads over 1,250 ns, 1.51 MB/s.
- With `RIG_WATCHDOG_MS`, the console's restarts (`!`, `J`, `T`, `P`) didn't happen: `watchdog_reboot` arms the watchdog and returns, and `loop()` went on feeding it. They now wait for the reset.
- The folder drive (2d.5) seen on the board: the test folder listed (its 32 KB list didn't fit, so half was taken) and read through the USB adapter, byte for byte as far as the adapter shows it ([docs/two-drives.md](docs/two-drives.md)).

## [0.29.0-2d.5] - 2026-11-03 (branch `two-drives`)

### Fixed
- **The board didn't start with a folder as device 1** (found on the ICL 386, below). Arduino-Pico's libstdc++ is built without exceptions, so `new (std::nothrow)` doesn't return nullptr when memory runs out: the `bad_alloc` it throws inside becomes `abort()`, and core 0 halts, USB with it. `chooseDevice1()` asked for 32 KB for the folder's list first, with 35,848 bytes free in all but not in one piece, so the board halted before it could try half. It now uses `malloc`, which returns nullptr, and halves as intended. Found on the rig with a build that printed each step (it stopped at the allocation); on the host, nothrow `new` does return nullptr, so `make_folder_img` never showed it. **Not yet seen working on the board:** the rig's card stopped answering after a restart (ACMD41 times out until it's power-cycled), so the folder wasn't listed again.

### Added
- `RIG_WATCHDOG_MS` (build flag, rig only): the hardware watchdog, fed by core 0's loop, so a build that halts restarts by itself and can be flashed again over USB, for work on the rig with nobody to replug it. Not for releases: console `K` and `I` block core 0 longer than it allows.

## 0.29.0-2d.4 on the retro PCs, 3 Nov evening

0.29.0-2d.4 on the ICL 386 and the Evesham, 3 Nov evening ([docs/retro-test.md](docs/retro-test.md#results-3-nov-2026-evening)). No firmware change.
- **The data lane on the Evesham:** it boots and runs HDDBENCH cleanly, reads 2.18 MB/s and writes 1.98 (early answers: 1.78 and 1.24). But about 1,400 Status reads a benchmark were held past ATA's 1,250 ns (worst 1,540), and the bus observer doesn't check data on the lane.
- **Two drives:** both PCs' BIOSes find device 1 without DASP#. An image as D: passed FDISK, FORMAT and `FC /B` on the 386 (`isa = on`) and `FC /B` on the Evesham (on the lane), with no failed commands.
- **Found: the board doesn't start with a folder as device 1** (`device1 = GAMES`): no USB serial port at power-up, every time, while the same folder lays out cleanly on the host. Fixed in 2d.5.

### Added
- `host/hddproto/test_folder.py`: a test folder for the folder drive, its files' contents following from their names, with `CHECK.BAT` for the retro PC (copies D: to `C:\HDDTEST` and compares each file) and a check of the copies on the Mac afterwards; `test_test_folder.py`.

## [0.29.0-2d.4] - 2026-11-03 (branch `data-lane`)

### Added
- **The data lane** ([docs/data-lane.md](docs/data-lane.md)): with `early_answers` and `isa` both off, data register reads are answered by PIO and DMA, without core 1. `ide_bus_data` (`ide_bus` with an address check at the strobe) hands each data read to `ide_data_in`, a second state machine in the same block whose FIFO (joined, 8 deep) a DMA channel fills from the device's block; the pair fill the block's 32 instructions. Core 1 starts the channel before the host can see DRQ, moves the device on as soon as the channel has queued the block's last word (STATUS still shows the block's DRQ, and INTRQ waits, until the host has read it), and starts the next block when `ide_data_in` takes the spare word the channel adds after each block. On the USB adapter (built-in disk, PIO mode 3): sequential reads 1.54 MB/s (`ide_bus` 1.38-1.41, early answers 1.18), random reads 80 a second, writes 1.65 MB/s; about 10 reads over 1,250 ns in a `-m speed` run, against about 50,000 with early answers. `s` shows `bus=` (which program serves the bus), and with the lane `lane_blocks` and `lane_switch_max_ns`.
- `pio_sim`: several state machines in one block (`PioBlock`), WAIT on an IRQ flag, and a DMA channel's model (`DmaToTx`); `test_data_lane_sim.py` (92 tests).

### Fixed
- **A command written while the host polled STATUS back to back could be left queued for good** (STATUS then read BSY forever): core 1's loop reached its command check only when the bus program's FIFO was empty. It now runs a queued command as soon as it has served the access. Found with the lane, which made each answer a little slower; `ide_bus` had the same weakness.

### Changed
- `early_answers` keeps its default (on) for now: the lane is chosen with `early_answers = off`. With the lane there's no IORDY watchdog (no room), so ISA cards need `isa = on`, and hosts that ignore IORDY on register reads still need `early_answers = on`.
- `-m timing` skips on the lane (console `D` can't delay reads core 1 doesn't answer). The raw trace doesn't show data reads on the lane.

## [0.29.0-2d.3] - 2026-11-03 (branch `two-drives`)

### Changed
- **The settings are `device0` and `device1`**, ATA's own names for the two drives on a cable, in place of `image` and `slave` (`drive_config`). `image` still works, as `device0`'s old name, so settings files from 0.28.0 and earlier need no change; if a file has both, `device0` counts, with a warning. Console `E` treats the two names as one setting and rewrites an `image` line as `device0` in place, keeping its comment. `C` and the welcome disk's sample write `device0 = HDDSYNTH.IMG` and `device1 = none`.
- `S` prints `CONFIG ... device0=...`, `CONFIG device0 not used: ...`, `CONFIG device1=... kind=... sectors=...` and `CONFIG device1 not used: ...`; `s` shows `device1=` and `device1_sectors=`.
- Device 1's IDENTIFY: model `HDDSYNTH PRO D1`, serial `HSP-000001-D1`.
- `test/run_native_tests.sh` runs from Git Bash on Windows (MinGW g++, e.g. WinLibs): `python` for the welcome text, and UBSan in trap mode, since MinGW has no sanitizer runtimes (CI still runs ASan and UBSan). `scripts/rig.sh` passes it the Python it chose.

- **Going back to 0.28.0 or earlier** after `E` has rewritten a settings file: those releases don't know `device0`, warn `unknown key 'device0'` and serve `HDDSYNTH.IMG`. Put an `image =` line back for them.

### Tested
- On the rig (Windows, the JMicron-ID adapter, the built-in disk, PIO mode 3, early answers on), with no device 1: `-m speed` on 0.29.0-2d.2 against 0.28.0, the same day: sequential reads 1.18 MB/s on both, writes 1.06 MB/s against 1.08, 74.9 random 4 KB reads a second on both. The worst read (2,140 ns against 2,130, STATUS) is the same on both.
- **The USB adapter shows device 1** (its bridge is a JMicron JM20337): at each detection it sends IDENTIFY and SET FEATURES to both devices, and once its USB connection restarts (`pnputil /restart-device`; it reports its units only when it enumerates) Windows lists device 1 as a second disk (`USBSTOR\...&1`, named `HDDSYNTH PRO D`: the adapter keeps a short product name). Device 0 on the built-in disk and device 1 on `HDDBENCH.IMG`, 300 rounds of reads from device 0 interleaved with writes and read-backs on device 1: 13,158 and 15,534 sectors, 0 mismatches; the bus observer checked 13,456 of device 0's sectors on the cable, 0 bad, and no read went without IORDY.
- **The adapter's garbled names are its own fault:** after six re-detections with device 1 off, Windows had blank and ` P` names and a corrupted USB serial (`980220290922`) while the bus observer checked all 28 IDENTIFY blocks on the cable, 0 bad. A USB restart alone doesn't make it read IDENTIFY again (it keeps what it read at its last detection). Unplugging it cleared it for a few minutes; a PC restart didn't.
- **Early answers hold reads past ATA's 1,250 ns, a lot:** on 0.28.0 and on this branch alike, about 50,000 reads per `-m speed` run (mostly STATUS, median 1,350 ns, the worst 2,140), and 158,000 in slice 1's 20 detections (up to 3,670 ns), timed from DIOR# falling to IORDY's release. With `early_answers = off`: the worst read in traffic 1,160 ns, and reads 1.38 MB/s, writes 1.76, 78.4 random reads a second. Detection still has a few over 1,250 ns in normal mode (slice 1: 32 on this branch, worst 1,390 ns; 33 on 0.28.0, worst 1,580 ns; mostly Device register and STATUS reads around IDENTIFY), so slice 1 fails its IORDY check either way. Not from this branch; what to do about early answers is open.

## [0.29.0-2d.2] - 2026-11-02 (branch `two-drives`)

### Added
- Device 1's commands are marked in the trace: their `CMD` lines end in `d1` (`trace_format`, bit 31 of the event; `host/hddproto/trace.py` reads it as `Command.unit`). Device 0's lines are unchanged.

### Changed
- The folder drive's partition is whole tracks, to the disk's end, as FDISK makes them: mtools refused one that wasn't. CI checks a folder image with `fsck.fat`, `mtools` and pyfatfs on each push to the branch, and reports a failing tool's output as an annotation.

## [0.29.0-2d.1] - 2026-11-02 (branch `two-drives`)

An experiment: two drives on one cable, and a folder on the card as a drive ([docs/two-drives.md](docs/two-drives.md)). **Not yet tried on hardware**: built and host-tested overnight with the rig unplugged.

### Added
- **Device 1 (slave)**: `slave = NAME` in `HDDSYNTH.INI` gives the drive a second unit, so a retro PC sees two hard disks. `ata::Device` keeps each unit's identity, geometry, IDENTIFY block, standby and write cache, and swaps the selected unit's status, error and interrupt into place when the host changes the Device register's DEV bit. One command runs at a time on a cable, so the command engine, sector buffers, read-ahead, write-behind and DMA are shared; each `Fetch` carries its unit, and core 0 serves it from that unit's disk. Every per-access path is the one-drive code: the only new work on core 1 is at a Device register write. Both units reset together (the signature, diagnostics 01h); EXECUTE DEVICE DIAGNOSTIC selects device 0. The slave's IDENTIFY: model `HDDSYNTH PRO S`, serial `HSP-000001-S`, its own size and geometry (from its image's partition table), the master's transfer modes. With no `slave`, device 0 answers for an absent device 1 as before.
- **A folder as device 1, read-only** (`src/folder_disk.*`, host-tested): `slave = GAMES` serves the card's folder `GAMES` (and its subfolders) as a FAT16 volume laid out at start-up. Each file and folder gets one run of clusters in listing order, so the FAT is computed, not stored, and every sector is made when it's read: the partition table, boot record, FATs and folders from the list, files' sectors from the files on the card through one open file kept between reads. 8.3 names are made from the long names as Windows makes them (`LONGFI~1.TXT`); hidden and system entries and dot-files are left out. 32 bytes of RAM per entry, on the heap, up to `cfg::FOLDER_MAX_ENTRIES` (1,024) while leaving 16 KB of heap; the root holds 511; FAT16 stops at 2 GB (32 KB clusters). A folder that doesn't fit is served cut short, with a `CONFIG` line saying why. Writes fail with ABRT (DOS: a write fault); nothing on the card is written. Files are read-only in their attributes too.
- **A second image as device 1** (`slave = DATA.IMG`): through SdFat's file layer only (no extent map, no card watch), so the master's proven image path is untouched.
- Console: `S` prints `CONFIG slave=... kind=folder|image sectors=...`, the folder's entries, cluster size and whether it was cut short, or `CONFIG slave not used: ...`; `s` shows `slave=` and `slave_sectors=`.
- The bus observer checks IDENTIFY blocks against either unit's.
- Tests: `test_two_drives.cpp` (13: per-unit status, error, interrupt, geometry, standby, resets, a BIOS probe of both units, read-only refusals, the lone master unchanged); `test_folder_disk.cpp` (9: short names, volumes read back through a small FAT16 reader that follows the MBR, boot record, folders and FAT chains, cluster sizes up to 32 KB, the 2 GB budget, the entry and root caps, and the folder as device 1 through ATA commands); the `slave` setting; IDENTIFY of either unit. `make_folder_img` writes the volume for a real directory, and `scripts/check_folder_img.py` compares it, file by file, through pyfatfs; CI also runs `fsck.fat` and `mtools` on one.

### Not yet known
- Whether retro BIOSes see the slave without DASP#/PDIAG# (the BB48 has neither; PCB rev 0.4 adds them).
- Core 1's read timing with this build, one drive or two: `-m speed` and slices 1-4 first.
## Branch `atapi-cdrom`, unreleased

No firmware change: 0.29.0 on its first hardware, and a checker for DOS.

### Added
- **`CDCHECK.COM` on the test ISO** (`tools/cdcheck/cdcheck.asm`, NASM): checks every file on DOS, through the CD-ROM driver and MSCDEX, by size and CRC-32 against a table `hddproto.test_iso` builds into it. It reads the names DOS sees back from a first build of the disc (`iso9660_files`, `dos_names`), since `hdiutil` keeps long ISO 9660 names DOS can't open; those files are left out and counted. `CDCHECK /R` repeats until a key. Tested in DOSBox-X: the disc passes, a copy with one byte changed fails with ERRORLEVEL 1.

### Tested
- **The Evesham (Athlon XP 2000+), 3 Nov:** its BIOS lists the drive as an ATAPI device and tries to boot from it (READ(10), NOT READY with no disc). From a Windows 98 startup floppy (`OAKCDROM.SYS`, MSCDEX) the drive is D:; with `HDDSYNTH.ISO` (the test ISO), `DIR` lists it and `CDCHECK` passes all 13 files (216 READ(10) commands, none failed). The driver probes device 1 and correctly finds nothing (LBA High reads 00h after DEVICE RESET to it); its E: was the PC's own optical drive. It asks READ SUB-CHANNEL (42h) and gets ILLEGAL REQUEST, harmlessly. **A real disc**, `DOOM_SE.ISO` (22 MB): Doom runs from the CD in its `-cdrom` mode, its settings and saves in `C:\DOOMDATA` on the floppy's RAM drive (C: with no hard disk): 2,474 READ(10), none failed. 107 data reads didn't wait for IORDY (as the hard disk build's 247 on this PC on 31 Oct; early answers cover them), none with the test disc. **Reads past 1,250 ns:** about 19,500 over the session, worst 1,960 ns (Alternate Status), with `iordy_ignored=0`: the host waited for every one, but they're over ATA's limit. The hard disk build on early answers had none on this PC, so the CD build costs core 1 more per access somewhere; not yet found.

## [0.29.0] - 2026-11-03 (branch `atapi-cdrom`)

**Exploratory (branch `atapi-cdrom`), host-tested only; not yet on hardware.** A first CD-ROM drive: the MVP of [docs/atapi.md](docs/atapi.md)'s slices C1 and C2, a data disc over PIO. No audio, no DMA, no disc changes. The hard disk build is unchanged by it: its core 1 code is the same, instruction for instruction and address for address, as 0.28.0's (only the calls into flash for one-offs and the addresses of data moved, by 0x40 bytes, which keeps every word in its SRAM bank).

### Added
- **The `bb48_cdrom` build** (`-DHDDPRO_CDROM=1`): the drive as an ATAPI CD-ROM drive. `atapi::Device` (`src/atapi_device.*`) takes `ata::Device`'s place behind the same interface, picked per build by `src/drive_device.h`'s `DriveDevice`, so `ide_bus` and `loop1` are written once. It has the packet device's reset signature (14h/EBh), aborts IDENTIFY DEVICE with it, answers IDENTIFY PACKET DEVICE and DEVICE RESET, and runs PACKET in PIO: the 12-byte packet, data blocks of up to the host's byte count with an interrupt each, then the status phase; errors are CHECK CONDITION with the sense key in the Error register.
- **The packet commands** (`src/mmc.*`, pure C++): TEST UNIT READY, REQUEST SENSE, INQUIRY, START STOP UNIT, PREVENT ALLOW MEDIUM REMOVAL, READ CAPACITY, READ(10), READ(12), SEEK(10), VERIFY(10), READ TOC (formats 0, 1 and 2, LBA or MSF), GET CONFIGURATION (the CD-ROM profile), GET EVENT STATUS NOTIFICATION (polled, media events), MODE SENSE(6) and (10) (pages 01h and 2Ah) and SET CD SPEED. A unit attention after power-on and each hardware reset, as a real drive gives.
- **A disc read is one 512-byte DRQ block per sector fetched**: CD frame n is sectors 4n to 4n+3 of the image, so `ImageDisk` serves an ISO unchanged, and the fetch mailbox and core 1's fast lane carry the blocks. No read-ahead yet.
- **`cdrom = NAME.ISO`** in `HDDSYNTH.INI` (`HDDSYNTH.ISO` by default; the hard disk build ignores it): the ISO to serve, or `none` (or console `T`) for the generated test disc, CD frame n being generated sectors 4n to 4n+3. No ISO: an empty drive. `CONFIG cdrom=... serving=... frames=...`.
- The trace names a packet: `CMD <t> a0 READ_10 <frame> <frames>`. The READY line ends `slice3 cdrom`, and the hard disk's rig tests skip on that build. A first rig test, `-m cdrom` (`host/tests/test_cdrom.py`: the test disc read whole and at random), not yet run.
- CI builds `bb48_cdrom` and runs `check_core1_ram.py` on it; it isn't part of a release.
- **For the bench:** `hddproto/test_iso.py` builds a test ISO whose files can all be checked once mounted (checked here by mounting it with `hdiutil`), and `test_cdrom_iso.py` checks them on the disc the drive serves. `hddproto/packets.py` lists the ATAPI exchanges in a raw trace and the opcodes the CD-ROM build doesn't handle, for slice C0's recording of a real drive. docs/atapi.md has the bench steps. Host tests for awkward hosts: a byte count limit of 0 or odd, polling with interrupts off, a host giving up mid-block or mid-packet, a stale fetch after a reset, reads past a block.

## [0.28.0] - 2026-10-31

**Not yet tried on hardware** (built while the rig was out of reach); host-tested only. On the same firmware, 0.27.0's automatic geometry booted the ICL 386's MS-DOS 5 image on the Evesham with its BIOS on auto and only `image =` set (7,476 sectors checked on the cable, 0 bad; core 1 released IORDY 43,490 times, harmlessly). And the ICL 386 booted MS-DOS 5 and ran games on all defaults, early answers with `isa = off`: core 1's IORDY release (0.27.0) took over from `iordy_watchdog.pio`, 44,002 times in the session. There the bus observer flagged 11 of 3,667 sectors falsely: the ISA card strobes DIOR# with no chip select (19.9 million times), which it counts as DMA words, losing its place in the sectors.

### Added
- **Images split across files**, for disks over FAT32's 4 GB file limit (the Amiga 1200's 8 GB CF card): `image = NAME.IMG` continues in `NAME.I01`, `NAME.I02`... (up to 8 parts, `image_parts.h`), served as one disk. Every part's clusters go into the one extent map, each part checked against the file layer at its runs' starts, middle and end; a split image is served only through the map, so one that can't be mapped (more than 256 runs in all, a part before the last that isn't whole sectors) is refused with the reason in `CONFIG`. `CONFIG ... parts=`. The card's identity (media_watch) takes the size of all the parts.
- **`tools/split_image.py`** copies a disk or image into such parts on the card (4,095 MiB each), checking each part and the whole against the source.

## [0.27.0] - 2026-10-31

Toward working with no settings file: the geometry from the image's own partition table, and early answers for everyone, made safe for ISA cards.

### Added
- **`geometry = auto` uses the geometry the image's partition table was made with** (`geometryFromPartitions`): a partition ends on a cylinder boundary, so an entry whose start and end CHS agree with its LBA fields gives the heads and sectors per track (the ICL 386's image: 13 x 51). Only what IDENTIFY can report (16 heads at most); a table for a translated geometry (255 heads), or none, leaves 16 x 63. `CONFIG geometry=... (partition table)`.
- **Early answers let IORDY go after 23 us with no strobe** (`cfg::IORDY_STALL_US`, `ide_bus::checkIordyStall`): core 1 runs one instruction in the bus program that releases IORDY's side-set, the same rule as `iordy_watchdog.pio` with `isa = on`, for ISA cards that assert the chip selects for memory and refresh cycles. PCs look at IORDY only during a strobe, so it's harmless to them (the Evesham holds a chip select up to 75 us before a read). `s` shows `iordy_stall_released`.

### Fixed
- **Early mode records each command's DONE as it completes** (`recordDone`, from the tight loop's idle work and before the next command runs): it used to wait for the bus to go quiet, so a command followed straight by another had none, and the rig's checks failed although the data was right.

### Changed
- **`early_answers` is on by default.** It answers at the chip select and still holds IORDY for hosts that wait for it. `isa = on` overrides it with the program the ICL 386 was proven on (no early answers, `iordy_watchdog.pio`). On the USB adapter (Mac rig) slices 3-4 and `-m speed` pass in early mode (8 of 8), at a cost to a host that waits for IORDY, since every access takes core 1 two round trips and a write holds IORDY until core 1 has answered (that wait is also its flow control: releasing IORDY first lost every other word of a burst in simulation): reads 1.17 MB/s (1.40 in normal mode), writes 1.08 (1.74), random reads 75/s (77). The retro PCs are held to about 1.8 MB/s by the SD card anyway; `early_answers = off` gives the adapter its full speed.

## [0.26.2] - 2026-10-31

The USB adapter's regression run (slices 1-4, the first since 0.22.0) hung the drive at its first re-detection: after `ABSENT off` and the adapter's RESET#, core 0 printed nothing more and answered no console command, and the adapter never found the drive again.

After the fixes, on the Mac rig (NS1081): slices 3-4 pass (7 tests: the whole 64 MB disk, random reads, 1,000 write-and-read-back cycles, the long write), and `-m speed` matches the reference: 1.40 MB/s reads, 1.74 MB/s writes, 77 IOPS (1.36/1.79 in 0.15.0). Slices 1-2's re-detections work on the drive's side (each cycle: ABSENT, the adapter's RESET# after about 62 s, IDENTIFY twice, all 6 checked on the cable, 0 bad, worst read 1,320 ns), but afterwards the NS1081 gives macOS an empty vendor and product name, so the harness, which finds the drive by name, doesn't see it ("Media"; once "P"). A physical replug restores "PROTO".

### Fixed
- **Core 1's per-pass profiling is compiled out** (`C1_PROFILE`, off): the cycle counts, gap statistics and pass counter added for the Pentium (0.23.x) ran on every pass of the main loop, and in the normal (non-early) mode reads then ran past ATA's 1,250 ns IORDY limit through the adapter (up to 3,570 ns; nearly all over 400 ns). The adapter never saw DRQ after IDENTIFY and polled status for good, though the drive ran both IDENTIFYs. Early mode answers from its own tight loop, so the retro PCs never showed it. `c1_gap_ns`, `c1_pass_ns` and `c1_fifo_cyc` print only when it's built in.
- **`bus_timing::poll()` takes at most 16 reports a call.** It drained its FIFO in an unbounded loop, and while the drive is off the bus the adapter probes it about once a microsecond: the reports came faster than core 0 converted them, so the loop never ended and core 0 hung. The retro PCs never read that fast.

## [0.26.1] - 2026-10-31

After the card was pulled and put back while the drive ran, console `E` wrote `HDDSYNTH.INI` after restarting the card (0.23.16's retry, seen working: "the first try failed: code 12"), but reading the file had failed too, and `E` took it for missing: it rewrote the file from the defaults plus the one setting, losing `early_answers` and `geometry`.

### Fixed
- **Reading `HDDSYNTH.INI` is retried once after restarting the card**, as writing it is (unless the card answers and the file simply isn't there).
- **Console `E` never rewrites an existing settings file it can't read:** it says so and changes nothing. It starts from the defaults only when there's no file.

## [0.26.0] - 2026-10-31

The Evesham's BIOS (auto-detect) gave `ICL386MB.IMG` 16 heads x 63 sectors, from the drive's IDENTIFY, and stopped at "Missing operating system": the image comes from the 386's CF card, laid out for 13 heads x 51 sectors, so its boot code read sector 63 where the DOS boot sector is at 51.

### Added
- **`geometry` in `HDDSYNTH.INI`:** `auto` (16 x 63, as before) or `C/H/S`, e.g. `756/13/51`: the default geometry IDENTIFY reports (words 1, 3, 6) and the one the drive translates CHS by at power-up and after a hardware reset, so a BIOS's auto-detect matches an old drive's image. For an image on the card only (the welcome and generated disks keep the default); cylinders 1-16383, heads 1-16, sectors 1-63, and the cylinders are cut to fit an image that's smaller. `CONFIG geometry=` shows the one in use. `IdentifyInfo::geometry` and `startGeometry()` carry it.

## [0.25.0] - 2026-10-31

On the real Amiga 1200, 0.25.0 stopped after RECALIBRATE, before IDENTIFY, so it doesn't boot yet (see CLAUDE.md's status for what's next). On the same firmware, with `early_answers = on` and `iordy = on`, an Evesham Athlon XP 2000+ booted the benchmark image first time in PIO mode 3: 1.81 MB/s reads, 0.98 ms a random read, 1.28 MB/s writes, 0 bad sectors, and 43,799 sectors checked on the cable with 0 bad.

The raw trace (0.24.2) showed the Amiga 1200 reading IDENTIFY correctly word by word, but the drive missed most of the reads: the second IDENTIFY's command was still waiting for data when the Amiga, which had read all 256 words, gave up 4.5 s later and rebooted. Gayle's DA2-0 and chip selects are valid only before the strobe (110-200 ns from the chip select to DIOR#) and change as it starts, or just before. `ide_bus_early` took a change of address with no strobe yet as a new access and asked again; when the strobe followed at once, it either served it as another register or, with nothing selected, never saw it.

### Added
- **`ide_bus_noiordy`**, the bus program for `early_answers = on` with `iordy = off`: no side-set, so IORDY is never driven; once armed, a strobe is the armed address's whatever the lines show; and an address that changes with no strobe yet gets 60 ns, in which a strobe starting is the armed address's read. It fills its PIO block's 32 instructions. 60 ns is under Gayle's shortest t1 (110 ns), but a PC host's PIO mode 3 or 4 (t1 30 ns) could be misread, so it's for Amiga-like hosts only.
- **Core 1 ignores answer requests with neither chip select asserted** as the address of what follows (`earlyAddress`), so a write that starts as Gayle's lines change still lands on the armed register.
- Sim: `test_pio_bus_noiordy_sim.py`, a Gayle host model (address valid 110-200 ns before the strobe, garbage from it or 20 ns before it, 300 ns strobes): IDENTIFY's 256 words all right and all counted, Kickstart's register test, writes on the armed address.

## [0.24.2] - 2026-10-31

### Changed
- **With the raw trace on (`t`), early mode's tight loop serves data reads one access at a time** instead of in its fast data loop, so every access is recorded: the Amiga 1200's accesses after IDENTIFY were missing from the trace.

## [0.24.1] - 2026-10-31

With `iordy = off` the Amiga 1200 ran Kickstart's detection at Gayle's own pace (110-200 ns from chip select to strobe, strobes of 305-335 ns): the register test, RECALIBRATE, IDENTIFY. Then, 4.5 s after each IDENTIFY, it reset and started again. Some reads' reports showed no chip select (`NONE NONE` in the raw trace): Gayle drops the chip select early in the strobe, and the listen-only build saw none on any strobe. Early mode chose each answer from the address at the chip select, but took a read's side effects from its report, sampled 50 ns into the strobe, so a data read with no chip select there was never counted, and IDENTIFY would have come back as its first word over and over.

### Fixed
- **Early mode takes every access's address from its answer request** (`earlyAddress`, core 1): a read's report and a write's sample get the address of the request before them, made when the chip select appeared. The program only starts a strobe for the address it asked about (it asks again if the address changes first), so that's right by construction, whatever the host does with the chip select during the strobe.

## [0.24.0] - 2026-10-31

An Amiga 1200 (Gayle) stayed on a black screen with the drive on its IDE port, though it reached Kickstart's "insert disk" screen with nothing there, booted from its own CF card on the same adapter, and with the listen-only build attached. Gayle checks IORDY before it starts a strobe and waits while it's low, and the drive pulls IORDY low at the chip select and lets go only once the strobe has come: a deadlock. Early answers froze at once (CS0# held low, IORDY low, no strobe); `isa = on`'s watchdog broke each one after 23 us (a read 24.7 us after its chip select), and it still stalled after 4 reads.

### Added
- **`iordy = off` in `HDDSYNTH.INI`:** the drive never touches IORDY (it stays an SIO input, so the bus programs' side-set can't reach it). With `early_answers = on` each register's value is ready by the strobe anyway: Gayle leaves about 200 ns from the chip select to the strobe, and its strobes last 0.9-1.6 us. `CONFIG` shows `iordy=`.

## [0.23.16] - 2026-10-31

The benchmark image (`tools/bench-image`) ran on the ICL 386: 1.51 MB/s reads, 0.72 MB/s writes, 1.09 ms a random read, and 0 bad sectors over a 14-minute soak. That morning console `E` failed twice with `SD error: can't write HDDSYNTH.INI`, though reads of the card worked and a restart cleared it. The first time the card had been pulled and put back while the drive was idle, which nothing noticed (`card_lost=0`), so SdFat still held the old card's state; the second time had no clear cause.

### Fixed
- **Console `E` restarts the card and tries again when writing `HDDSYNTH.INI` fails**, as image reads and writes already do: the image is reopened and checked to be on the same card (`reattach`), or with no image served the card is just restarted. A failure now prints SdFat's error code and data from both tries.

## [0.23.15] - 2026-10-31

0.23.13's on-cable check then caught three bad sectors with Windows' driver loaded: each time word 0 alone, with bit 12 set where it should be clear (959c for 859c). The DD lines idle high (`p`: DD=ffff), so the first word of a sector has to pull its zeros down from high, and DD12, the line that floated high on writes too (0.23.11), sometimes hadn't got there when DIOR# rose.

### Changed
- **With `early_answers = on`, DD0-15 are driven at 8 mA** (4 mA otherwise, as before: on the USB adapter's DMA, 8 mA with fast slew made the lines noisier, 0.17.1).

## [0.23.14] - 2026-10-31

With 0.23.13 the Pentium booted Windows 95 with its driver loaded, cleanly, and ran about 11,000 commands: 21,360 sectors checked on the cable, none wrong (spot checks: about three in four served sectors went unchecked).

### Fixed
- **Image sectors holding text were taken for IDENTIFY blocks** (338 false `BUSERR ... IDENTIFY` lines in one boot): a block that matches a served sector is now data, checked before IDENTIFY, and the space padding of IDENTIFY's strings no longer counts towards recognising one.

## [0.23.13] - 2026-10-31

With 0.23.12 the Pentium's FAT copies matched after two boots (0.23.11's write fixes hold), but with Windows' driver loaded it showed its registry error screen. `SYSTEM.DAT` and `USER.DAT` on the image were sound, so Windows read them wrongly.

### Added
- **The bus observer checks image data on the cable** (with `early_answers = on`): core 0 keeps a copy of each of the last 16 sectors it serves (`sector_check::Checker::expect`), and each 256-word data block the host takes off the bus is matched against them. A block that matches none prints `BUSERR ... lba=` against the closest copy, with the first wrong word and the bits lost and gained; `bus_sectors`/`bus_bad` count them, and `s` shows `bus_image` and `bus_expect_missed` (copies the host never read).

## [0.23.12] - 2026-10-31

With 0.23.11 the Pentium still crashed with Windows' driver loaded (fatal exception 0E), with no late reads and no failed commands. The one anomaly: Windows' driver issues each of its first reads twice, about 1.2 ms apart, the first abandoned while still BSY. That's typical of a driver that gave up waiting, perhaps for an interrupt.

### Added
- **The raw trace (`t`) works in early mode:** the tight bus loop records each access it serves (not the answer requests). It used to turn the tight loops off, which changed the timing being traced.
- **`s` shows `intrq_rises` and `commands`:** interrupts raised (INTRQ driven high from low) beside commands started, to see whether interrupts go missing.

## [0.23.11] - 2026-10-31

**With Windows 95's 32-bit disk driver (`ESDI_506.PDR`) loaded, the Pentium reached its desktop** (0.23.10, 3,758 reads and 158 writes). Then ScanDisk found the two FAT copies differing, which they still did after its repair and a proper shutdown. Windows writes both copies from one buffer, so the drive had stored writes wrongly. Reads were sound: `gm15.bnk`, which WaveSynth failed to load, was identical to the clean backup's, and FC had compared 187 files cleanly.
- Two entries differed by bit 12 alone, set where it should have been clear: DD12 floating high. `ide_bus_early` sampled writes about 5 ns after DIOW# rose (since 0.22.0), and a PIIX in compatible timing lets DD go at once.
- 24 entries in one copy were the other's shifted by a 16-bit word: a whole write missed. A write waits for its request's answer before the program arms again, and core 1 could be up to about 1 µs into a main-loop pass (after 50 µs of quiet, or returning to start each command), so the next write went by unseen.

### Fixed
- **`ide_bus_early` samples a write while DIOW# is still low.** `not_read` waits 35 ns before jumping to `write`, so the data has settled. IORDY stays low until the sample is taken and the answer thrown away, then is released for the strobe's end and pulled low again for a next write with CS held. Still 32 instructions; the armed loop is 35 ns slower to see a strobe.
- **Core 1 stays in the tight bus loop through commands:** `serveBusEarly` runs a queued command itself (`runCommandEarly()`, which records its `CMD` line), and returns to the main loop only after 10 ms of quiet (`EARLY_BUS_ONLY_US`, was 50 µs). `DONE` lines and core 0's view of a running command now update only when the bus goes quiet, so a long busy spell may print a spurious `STUCK`.
- Sim: `test_write_data_gone_as_diow_rises` (t4 = 0, waiting and non-waiting hosts).

## [0.23.10] - 2026-10-31

0.23.9's `contiguous=` showed the Pentium's image fragmented. It was fragmented by restoring it with macOS `cp`, which frees the file's clusters and allocates new ones, and still fragmented after rewriting it, as macOS reused the holes.

### Changed
- **Image reads and writes go straight to card sectors through a map of the image's runs** (`sd_card`'s extents, up to 256). The map comes from `contiguousRange()` (one run, FAT32 or exFAT) or a walk of the image's FAT32 chain at open (about 0.3 s for 4 GB). Whatever the fragmentation, a sector costs the same wherever it is, and it's quicker than SdFat's file layer even for one run. Before using the map, a few sectors are read both ways (the map, the file layer) and compared: the first runs' and the last one's starts, the middle, the end. A fragmented exFAT image, more than 256 runs or a map that doesn't check out keeps the file layer. `CONFIG ... extents=` shows the runs in use (0: the file layer).

## [0.23.9] - 2026-10-30

### Fixed
- **Seeks in a large image are direct again.** The image is opened with `seekSet()` reads, and SdFat seeks directly only in a file it knows is one unbroken run (`FILE_FLAG_CONTIGUOUS`). Otherwise a seek backwards walks the cluster chain from the file's start. With the Pentium's 4 GB image, FC comparing two files in safe mode took 172 ms a read, alternating between sectors 33,371 and 5,504,290. `sd_card` now calls `contiguousRange()` after opening the image (and after a card comes back), which sets the flag. `CONFIG ... contiguous=yes|no` reports it: a fragmented image still seeks slowly.

## [0.23.8] - 2026-10-30

With 0.23.7 and a fresh copy of the CF card, Windows got as far as its desktop stage, then MSGSRV32 failed: corrupt data still, though only a few data reads were counted late (after Windows' own IDENTIFY). Two ways to deliver bad data without `iordy_ignored` counting it, both when core 1 is in its 660 ns main loop after a quiet spell of over 50 µs, between Windows' commands:

### Changed
- **`ide_bus_early` samples a write before throwing its answer away.** It waited for core 1's answer first, so with a late answer a host that doesn't wait had ended its strobe, and taken its data with it, before the program sampled: a register write (an LBA byte, say) captured wrong, and the wrong sector read cleanly. Still 32 instructions.
- **In early mode core 1 goes back into the tight bus loop after every main-loop pass,** not only after an access, so a quiet spell's first access finds it polling.
- **The tight loop runs the device's BSY timers** (`busyTimers()`: the data-out hold and waking, which were loop1's step 3). The host may poll status throughout the hold, and the loop never went quiet to return to the main loop.
- Sim: `test_no_iordy_write_with_a_late_answer` (core 1 answering 300 ns after the request, after the strobe).

## [0.23.7] - 2026-10-30

**With 0.23.6 the Pentium 200 got through its BIOS's detection** (IDENTIFY, INIT_PARAMS, SET FEATURES for PIO mode 3) **and started Windows from `P200.IMG`:** 1,047 reads and 92 writes, all completing cleanly. Then a fatal exception 0D. Seven data reads had been late, all in the second after Windows' own disk driver identified the drive again; it evidently reads in the PIIX's compatible timing for a moment (data words get t1 80 ns and strobes of 185 ns).

### Changed
- `early_answers`' data lane only polls the FIFO and RESET# while waiting. The fetch handshake (posting the read-ahead, taking results) happens straight after each data read, when the next request is a recovery time away; each item took 100-200 ns, enough to make a request miss.

## [0.23.6] - 2026-10-30

With 0.23.5 eight data reads failed, all among IDENTIFY's first words, answered 1.3-3 µs late: core 1 left its tight loops for the main loop around the command (its bookkeeping, a timer read) and whenever the lane met a status poll.

### Changed
- `early_answers`: after starting a command, core 1 goes straight back to the tight bus loop; the command's bookkeeping waits until the bus is quiet. The bus loop runs the data lane itself when a block starts. The lane serves other accesses (status polls) inline and carries on, leaving only for a new command or the block's end. Some commands' `CMD` trace lines may be lost in this mode.

## [0.23.5] - 2026-10-30

With 0.23.4 only the first status read after the reset failed, but 12 of IDENTIFY's 256 data words were late. The PIIX drops the chip select between data words and gives each t1 80 ns and a strobe of 175-195 ns (`RDTIME`), so core 1 has about 200 ns.

### Changed
- The early lane and bus loop check the RX FIFO (up to 32 reads in a row, `rxWaiting`) between each housekeeping item (RESET#, fetch posts and results), not once a round, so a request waits a few cycles.
- `ide_bus.cpp` reads the FIFO's empty flag with its own always-inlined `rxEmpty()`; the SDK's had ended up out of line in flash.

## [0.23.4] - 2026-10-30

`c1_gap_ns` showed core 1's main loop taking about 660 ns a pass on average, and up to 880, even idle. That's about 150 cycles of calls and checks, not slow memory: a micro-benchmark (`c1_bench_*`, in `s`) puts PIO, RAM and SIO reads at about a cycle each from RAM code. A request could wait most of the PIIX's 400 ns before core 1 looked at it.

### Changed
- **`early_answers`: after an access, core 1 stays in a tight bus loop** (`ide_bus::serveBusEarly`). It serves each access inline, posts fetches and takes their results (so BSY ends while the host polls), and leaves when the bus has been quiet for `EARLY_BUS_ONLY_US`, a command is queued, a data-in block starts, or RESET# changes. Not while the raw trace is on.
- Console `D`'s delay waits on core 1's cycle counter, always inlined: the SDK's `busy_wait_at_least_cycles()` had ended up out of line in flash.

### Added
- `s`: `c1_pass_ns` (core 1's average loop pass), `c1_fifo_cyc` (its FIFO check, average/longest) and the micro-benchmark (diagnostics on this branch).

## [0.23.3] - 2026-10-30

On the Pentium the timing probe measured t1 = 110 ns and strobes of 335-345 ns in the PIIX's compatible timing. That's more relaxed than PIO mode 0's minimum, yet the drive answered as late as 490 ns into the strobe. So it's core 1's response time, not the host's speed.

### Added
- **`c1_gap_ns` in `s`:** core 1's longest main-loop pass, by what the pass did (an access, the fast lane, a command, bus-only, steps 0-4), timed with core 1's own cycle counter (DWT CYCCNT, enabled in `setup1`). A long pass is a register read left waiting. Console `r` clears it.

## [0.23.2] - 2026-10-30

### Added
- **`bus_timing.pio`, a read timing probe** (22 instructions, only reads pins, in the third PIO block when DMA isn't offered). For each read it measures t1 (chip select to DIOR# falling) and the strobe (DIOR# low), to ±20 ns. Core 0 prints the first 64 after start-up or console `r` as `RDTIME n t1_ns= strobe_ns=` lines; `s` shows `rd_timed`, `rd_t1_ns` and `rd_strobe_ns` (minimum-maximum). It sizes the no-IORDY design to a real host: on the Pentium's PIIX, IORDY was often not yet low when DIOR# fell (`iordy_early`), so t1 there is short.
- `pio_sim`: `in` shifting left (`in_shift_left`). `test_bus_timing_sim.py` checks t1 from 0 to 200 ns and strobes from 100 to 400 ns.

## [0.23.1] - 2026-10-30

On the Pentium, 0.23.0 got the BIOS as far as IDENTIFY, but data reads took 1.3-2 µs and 28 words were wrong: core 1 answered each request only after a pass of its main loop.

### Changed
- **`early_answers` gets a fast lane** (`ide_bus::serveDataInEarly`): during a data block, core 1 answers data requests from the sector buffer in a tight loop. A data read's report moves it on by one; anything else catches the device up and is served normally.
- **After any access, core 1 watches only the bus for `EARLY_BUS_ONLY_US` (50 µs),** skipping its bookkeeping, so the next request finds it free.
- `Device::dataInRemaining()` is always inlined (`check_core1_ram.py` found an out-of-line copy in flash).

## [0.23.0] - 2026-10-30

Early answers, for hosts that don't wait for IORDY (docs/no-iordy.md). A Pentium 200's PIIX runs in compatible timing, which ignores IORDY, until its Phoenix BIOS has identified the drive, and the BIOS never got that far. Its register reads ended before core 1 answered: the DEVICE read-back that checks a drive is there got `9004`, and 31 of IDENTIFY's 256 words were wrong. Experimental, and off by default.

### Added
- **`early_answers` in `HDDSYNTH.INI`:** runs `ide_bus_early` (in `ide_bus.pio`) in place of `ide_bus`. At the chip select it asks core 1 for the register's value, an answer request with bits 21-31 zero, so the value is in the TX FIFO when DIOR# falls, t1 (70 ns or more) sooner than now.
  - A write throws its answer away. So does an address or chip select that changes while armed; Y holds the address asked about, and the program asks again.
  - A read still reports itself, in a sample taken during the strobe, so core 1 applies its side effects.
  - After each access the program arms again, so the next data word is asked for before the host's next strobe.
  - IORDY is low from the chip select as before, released only when nothing is selected, so hosts that wait still can.
  - 32 instructions, so no `iordy_watchdog` (not with `isa`), and core 1's fast data path is off in this mode.
- Core 1 (`ide_bus::serve`): an answer request gets `peek()`, with no side effects. A read's sample gets `consumeRead()`. Writes are unchanged.
- Sim: `ide_host_model` can be a host that never waits for IORDY (`waits_for_iordy=False`), and keeps DA's t1 when the address changes with CS held. `test_pio_bus_early_sim.py`:
  - a never-waiting host gets register reads, IDENTIFY's 256 words and a written register's read-back right, as long as core 1 answers within 160 ns of the chip select;
  - hosts that wait still get their data in PIO modes 0-3;
  - an address change with CS held; flow-controlled writes; a chip select with no strobe.
- **Not yet run on any host.**

## [0.22.0] - 2026-10-30

`isa = on` done with a watchdog. 0.21.2's 60 ns releases didn't free the ICL 386: it froze again after F1. A released IORDY rises through the host's pull-up and the cable's capacitance, which takes far longer than 60 ns. And the old trace showed the BIOS waits up to 11 µs between a status read and its first data read, with the drive still selected, more than the bus program's countdown (31 passes at most) can hold.

### Changed
- **`ide_bus.pio` is one program for every host again,** with no countdown. IORDY goes low at the chip select (`arm`) and stays low until a strobe or the chip select ends, as up to 0.20.0. Down from 32 instructions to 23:
  - **Writes are sampled as DIOW# rises.** `wait 1 gpio 27` and then `in pins, 23` take DD, DA and the chip selects about 5 ns after the edge (ATA holds the data 10-30 ns, t4). `in null, 9` forces DIOW# and the bits above it to 0, so core 1 still reads the sample as a write. Before, the program kept the last sample taken while DIOW# was low, in a loop.
  - **Flow control moved to the push:** the autopush stalls with IORDY low while the RX FIFO is full, so the host's next access waits.
  - **A read's sample** comes from `in pins, 32` with autopush, and DIOR# is tested with `jmp pin`. The state machine starts at `idle`.

### Added
- **`iordy_watchdog.pio`** (7 instructions, in `ide_bus`'s PIO block, started with `isa = on`): when IORDY has been held low for 4,608 cycles (23 µs) without being released, it writes the pin's direction to released. `ide_bus` pulls it low again at its next `arm` or `read`, so a stalled cycle gets as long as the pull-up needs. Real accesses hold IORDY about 1 µs at most. The block always holds the watchdog, so the diagnostics' `iordy_check` can't land beside `ide_bus`'s DIOR# synchroniser bypass.
- Sim: `pio_sim` counts the bits shifted into ISR (partial `in` with autopush) and does `set pindirs`. `test_pio_bus_sim.py` passes in PIO modes 0-3 on the new program (writes included), and on the ISA host. `test_iordy_watchdog_sim.py` covers: a stuck hold released at 23.2 µs; reads, and a 15 µs hold, left alone; and holds that don't add up.
- **Not yet run on the USB adapter:** the write path changed for every host. Run slices 1-4 (writes) and `-m speed` there before trusting it.

### Removed
- 0.21.x's countdown and `isaProgram()` patching.

## [0.21.2] - 2026-10-30

On 0.21.1 the ICL 386 got through detection and the BIOS ran on, with no freeze. But its MBR read lost one word (`NOIORDY reads=1`), and the boot code stopped with part of a message ("ion"). The card keeps the drive selected while an address stays on the bus. After the status read, the BIOS took longer than the 2.6 µs timeout to start reading data, and the timeout had released IORDY until the chip select went.

### Changed
- **The ISA timeout repeats:** after 2.6 µs without a strobe, `timeout` releases IORDY for 60 ns (`jmp idle side 0 [7]`, then `idle` and `arm`) and pulls it low again, for as long as the chip select lasts. A stalled memory or refresh cycle ends at the first IOCHRDY sample (every 125 ns) that falls in a release, and a read is held whenever it comes. The ATA program never gets there.
- Tried and dropped: an 11.5 µs timeout made by delaying all nine steps of the armed loop. The loop then acted on a chip select sampled 120 ns earlier. The 386 deselects the drive briefly between a status read and the first data read, and the sim caught the data read losing IORDY (`test_isa_program_meets_ata_timing[0]`).
- Sim: the timeout's periodic release (held 2-3.2 µs, released 50-80 ns), and a read whose strobe lands anywhere in that cycle after a long chip select, which must have IORDY low within 80 ns.

## [0.21.1] - 2026-10-30

`isa = on` reworked: 0.21.0's IORDY from the strobe was too late for the ICL 386's 16-bit ISA cycles. IORDY went low about 76 ns after DIOR#; 12 data reads ended first (`iordy_ignored=12`), IDENTIFY reached the BIOS with 28 wrong words (`BUSERR`), and it then verified a nonexistent sector 64 times (IDNF). IORDY from the chip select (0.20.0) had read IDENTIFY cleanly.

### Changed
- **`ide_bus.pio` rearranged, with a countdown on a chip select that brings no strobe.** `arm` pulls IORDY low at the chip select, as ever, and loads Y. As assembled, Y = 2^32 - 1, which never times out (ATA hosts). With `isa = on`, `ide_bus.cpp` patches it to `set y, 31` and gives the `timeout` step 7 cycles' delay: about 2.6 µs without a strobe, then `timeout` releases IORDY until the chip select goes, ending a stalled memory or refresh cycle. That's longer than an ISA host's gaps between data reads, about 1.5 µs. A read after a timeout pulls IORDY low as it starts (late, as in 0.21.0).
- To fit the countdown's three instructions into 32: DIOR# is tested with `jmp pin` (from the pin, which skips the synchroniser) instead of from the sample; a read's sample is `in pins, 32` with autopush instead of `mov isr` and `push`; the write path falls into `arm` and the read path into `idle`. The state machine starts at `idle` (`pio_sm_init`, `restart()`).
- Sim: the PIO simulator gained autopush and `set`. All of `test_pio_bus_sim.py`'s PIO mode 0-3 timing tests pass on the rearranged program, and the ISA program passes them too. New tests: the ISA timeout (released 2.6 µs after a chip select with no strobe, and stays released), the ATA program holding IORDY throughout, and IDENTIFY bursts and flow-controlled writes on the ISA host.
- **Not yet run on the USB adapter:** the bus program every host uses has changed shape. Run slices 1-2 and `-m speed` there before trusting it.

## [0.21.0] - 2026-10-30

`isa = on`, for ISA IDE cards that pass IORDY to the ISA bus. On 0.20.0 the ICL 386 detected the drive, then froze for good while printing "Hard disk 0 auto initialization", with the keyboard dead. The pins showed CS0# low with DA2-0 = 0, IORDY low and no strobe, for minutes. Console `V` (the drive off the bus) released IORDY: it read high, so the card does wire it, and the address lines moved again. The card decodes CS0# from the address alone, so a memory cycle (or a DRAM refresh) whose address aliased 1F0h selected the drive. The bus program pulls IORDY low at a chip select, to meet ATA's 35 ns, and holds it until a strobe that a memory cycle never brings, while the card passes IORDY to IOCHRDY, which stalled that very cycle.

### Added
- **`isa` in `HDDSYNTH.INI`** (off by default; `CONFIG ... isa=`). On, `ide_bus::begin()` loads the bus program with three side-sets moved (`isaProgram()`, from the public labels `armed`, `read` and `write`): IORDY stays released in `armed` and goes low at `read` and while `write` waits for room. So a chip select with no strobe never touches IORDY. IORDY goes low at most 76 ns after DIOR# falls, against an ISA bus's first IOCHRDY sample about 125 ns in (`IsaBus` in `ide_host_model.py`). Too slow for ATA hosts, hence the setting. A write with room in the FIFO pulls IORDY low for one PIO cycle (5 ns): at most one extra ISA wait state.
- `test_pio_bus_sim.py`: the patched program against the ISA host (reads, IDENTIFY's 256 words, flow control on writes, and a chip select held for 10 µs with no strobe, which must leave IORDY alone), and checks that the default program still pulls IORDY low at the chip select. `pio_sim.assemble()` reads a program's public labels.

## [0.20.0] - 2026-10-30

IOCS16#, for 16-bit ISA IDE cards that pass it to the ISA bus. On 0.19.1 the ICL 386's BIOS got through detection, but every 16-bit data read reached the drive as two 8-bit reads, of the data register (1F0h) and then the error register (1F1h): 513 pairs for one sector and IDENTIFY. So each word's high byte came from the error register, and the BIOS took 15 heads and 17 sectors from the garbled IDENTIFY. Needs one wire on the rig: IDE pin 32 to GPIO 2 (EXT1-6).

### Added
- **`iocs16.pio`** (6 instructions): pulls IOCS16# (GPIO 2, open drain) low while CS0# is low and DA2-0 = 0, and only then, since an 8-bit register addressed as 16-bit would come back on the wrong byte lane. Two loops that set the pin on every pass, so it doesn't glitch. In simulation it follows the address within 40 ns, both ways (`test_iocs16_sim.py`; ATA-1 allows 90 ns).
- It needs a PIO block, and the diagnostics' has 3 instructions spare, so it takes `ide_dma`'s: `setup1()` starts `ide_dma` when multiword DMA is offered and `iocs16` otherwise. ISA hosts never use DMA. Every `ide_dma` entry point already did nothing until `begin()`.

### Changed
- `docs/wiring.md`, `docs/wiring.html` and CLAUDE.md: IDE pin 32 is IOCS16# on GPIO 2. GPIO 2 used to be kept off the bus for the BB48's 2.2k pull-up (R17), which is harmless for an open-drain line the host also pulls up. PCB rev 0.4 already plans it there.

## [0.19.1] - 2026-10-30

Two fixes for real ISA IDE controllers, found on the first retro PC (an ICL 386): its BIOS sent EXECUTE DIAGNOSTIC, never got the interrupt and reported "Hard disk controller error".

### Fixed
- **INTRQ is driven low between interrupts** while the drive is selected with nIEN clear, and released otherwise (`Device::intrqDriven()`, `ide_bus::updateIntrq(dev)`). It used to be driven high only, and released otherwise, relying on the host's pull-down (the USB adapters have one). The ICL's ISA card has none: the undriven line floated high (`p` showed `INTRQ=1` throughout), so the BIOS's edge-triggered IRQ 14 never saw the diagnostic's interrupt.
- **Reads of the control block other than Alternate Status aren't driven.** An ISA card's CS1# covers 3F0-3F7, where the floppy controller answers 3F2-3F5 and bit 7 of 3F7; the trace showed the BIOS setting up the floppy there, and the drive answered those reads too, against the floppy controller. Core 1's answer now carries which DD lines to drive in its upper half (all, or none for `Reg::None`), and `ide_bus.pio` drives them with `out pindirs, 16` in place of `mov pindirs, ~null`, so the program keeps its 32 instructions. `test_pio_bus_sim.py` checks CTL 2-5 and 7 reads leave DD alone, in PIO modes 0-3.

## [0.19.0] - 2026-10-30

Activity link protocol version 2, for the HDD Synth's modelled drives: where the head goes, and authentic seek timing. From docs/hddsynth-head-position-brief.md; the synth's side is HDDSynth_Native v0.21.0. Host-tested; not yet run on the rig or with the synth.

### Added
- **`$HDE`, head targets** (`activity_link.*`): `$HDE,2,<pos>,<op>,<sectors>*hh` for each media command, `pos` being its first LBA as a fraction of the disk (0-65535), so the synth's head goes where the host's commands really go. Reads and writes are sent when core 0 gets their first sector, verifies and seeks from their trace events. At most one every 2 ms, the newest (`HeadPacer`); a due `$HDA` goes first (`nextSentence()`). `s` shows `head_sent`, `head_replaced`, `head_last`.
- **Authentic seek timing** (`seek_timing` in `HDDSYNTH.INI`: `off` by default, `synth`, or the synth's presets `stepper85`, `voice91`, `voice97`, `fdb05`). `seek_timing::Scheduler` (pure, host-tested) works out when the modelled drive would have each sector (seek, rotation, transfer, on one microsecond clock), and core 0 keeps each fetch's result until then, so the drive shows BSY as a real one does; IORDY is never held for it. Reads, writes (with write-behind too) and DMA alike. A command carrying straight on from the last one's next sector doesn't seek or wait a turn (a drive's read-ahead), so sequential transfers run at the media rate. Capped at 1 s a command. With timing on, `$HDE` goes out when the modelled seek starts. Console `H` switches it off and on until a restart; `S` shows the setting and model, `s` shows `seek_timing`, `seek_active`, `seek_rpm`, `seek_actuator` and the counts (`seek_commands`, `seek_held`, `seek_avg_us`, `seek_max_us`, `seek_total_us`, `seek_capped`).
- **`$HDM`, the synth's model**, on the link's other wire: GPIO 1 is now UART0 RX, with the internal pull-up. Core 0 assembles lines on each loop pass; `seek_timing = synth` follows the model it names, and forgets it after 5 s without one. `s` shows `hdm_valid`, `hdm_rejected`, `link_rx_errors`.
- **`drive_params.*`, `drive_timing.*`, `sentence.*`**, copied unchanged from HDDSynth_Native (6a68a71, v0.21.0), with their host tests (less the one against the synth's engine).
- **`-m seek`** (`host/tests/test_seek_timing.py`): with `seek_timing` set to a preset, random 4 KB reads run within 20% of the modelled time, sequential reads at about the media rate, and with `H` off as before.

### Changed
- **`ata::Fetch`** carries the command's first LBA and sector count (core 1 sets them from the command it already decoded), so core 0 can tell where each command starts. It grows from 16 to 20 bytes.
- **The loopback test (`U`)** checks both directions: `$HDA` and `$HDE` read back, plus one `$HDM` it sends itself and reads back. `LOOPBACK` adds `head_sent`, `head_valid` and `model=ok|missing|bad`; GPIO 1 no longer changes function for it.
- `HDDSYNTH.INI`'s defaults (and the welcome disk's copy) list `seek_timing = off`; the README lists it.

## [0.18.1] - 2026-10-30

The bus observer no longer holds multiword DMA back: spot checks by default, full checks on request.

### Changed
- **Spot checks** (`bus_observer.*`, the default). Checking a sector costs core 0 more than serving it, so at DMA's rate the observer slowed the drive to about 2.2 MB/s on the test disk. Now the drive comes first: core 0 serves fetches every 32 words checked, and when the checks fall more than half the ring (2,048 samples) behind, the waiting samples are dropped, counted in `bus_dropped`. Checking resumes at the next sector start, found from its header (the LBA, then the LBA inverted) even in the middle of a DMA command, or at the next status read. Every sector of PIO and of short DMA commands is still checked; on long DMA transfers a few percent. On the test disk, MDMA 2: sequential reads 7.70 MB/s (5.14 on 0.16.2, before the observer checked DMA; 2.0 with full checks), random 4 KB reads 1,100 a second (969), writes 13.9 MB/s (9.76).
- **Full checks** (console `O`, until a restart): every sector, as before, slowing DMA reads to about 2 MB/s. `s` shows `bus_checks=spot|full`. The soak switches to full checks itself (`HDDPRO_SOAK_SPOT_CHECKS=1` keeps spot checks).

### Fixed
- **Overruns the observer couldn't see.** Its samples are numbered in 11 bits (2,048), and since 0.17.1 its ring holds 4,096, so core 0 falling a whole ring behind left no jump in the numbers. Spot checks now treat any spell of more than 400 µs between looks at the ring as a possible overrun (DMA could fill it in 490 µs), drop what's waiting, and count it in `bus_lost`. Full checks slow the drive instead, so the ring isn't overrun (the 10-hour soak's high-water mark was 2,570); the soak's 0 bad sectors show it wasn't.
- After dropped samples or a gap the checker waits for a sector boundary, rather than taking the next 256 words for a sector: in a DMA command those could be two sectors' halves.

### On the rig
- Test disk, MDMA 2 (`host/runs/tools/observer_load.py`, 48 MB in 64 KB reads): spot checks 8.77 MB/s, 767 sectors checked, 0 bad; full checks 2.00 MB/s, all 98,320 checked, 0 bad, 0 dropped. LBA 65535 5,000 times: 0 flagged. Slices 3-4 pass; a 3-minute DMA soak (full checks): 304 MB, 522,221 sectors checked, 0 bad. PIO mode 3 on the test disk: reads 1.38 MB/s, writes 1.87, as 0.18.0.

## [0.18.0] - 2026-10-29

A welcome disk with a README, instead of the test disk, when there's no card or no image to serve.

### Added
- **The welcome disk** (`src/welcome_disk.*`, host-tested): with no microSD card, or no image it can use, the drive serves a 64 MB disk with an MBR partition table and one FAT16 volume, `HDDSYNTHPRO` (partition type 06h, 2 KB clusters, ending with the last whole cylinder of IDENTIFY's 16-head, 63-sector geometry). It holds `README.TXT`, how to set the drive up, and `HDDSYNTH.INI` with the defaults, ready to copy to a card. Every sector is computed when read, like the test disk's, so it costs no RAM; writes go to the same RAM overlay, until a restart. Neither the MBR nor the boot record boots: both run INT 18h.
- **`welcome/README.TXT`**, the README's text, with ASCII art. `scripts/embed_welcome.py` checks it (plain ASCII, at most 80 characters a line), turns its line endings into CRLF, fills in `{VERSION}` and writes `src/welcome_text.h` (git-ignored) before each build (`extra_scripts` in `platformio.ini`) and before the host tests.
- **`.pio/native-tests/make_welcome_img`**, built by `test/run_native_tests.sh`: writes the welcome disk to a file, to see the README as a computer will before flashing. macOS's `fsck_msdos` passes it, and mounts it as `HDDSYNTHPRO` with both files.
- **Console `T`**: restarts the drive serving the test disk, card or no card, or back. It shares `J`'s watchdog scratch register, so a power cycle undoes it, and `T` and `J` undo each other. `s` shows `disk=welcome` or `disk=generated`.

### Changed
- **The test disk is served only on request** (`image = none`, or `T`), no longer whenever there's no card. The bus observer checks data sectors only on it, as before. Rig tests that need it (slices 3-4, the soak, `-m timing`) now skip on the welcome disk too, and say how to get the test disk.
- `RamOverlayDisk` takes the disk underneath at boot (`setBase()`), so the welcome disk and the test disk share its 256 KB.
- The defaults in `HDDSYNTH.INI` (console `C`, and the welcome disk's copy): the image falls back to the welcome disk.

### Fixed
- The host tests didn't compile on macOS: `activity_link::LINE_MAX` clashed with the `LINE_MAX` macro in macOS's `<limits.h>` (not seen on Windows or Linux). Now `MAX_LINE`.

### On the rig
- **Windows** (30 Oct, no card): mounts the welcome disk as `HDDSYNTHPRO` (FAT, healthy) with `README.TXT` and `HDDSYNTH.INI`, and adds its `System Volume Information` folder, which fits in the overlay. Slices 1-2 pass on it (20 re-detections each). `-m speed` on the test disk (`T`), PIO mode 3: reads 1.41 MB/s, writes 1.87, worst read 1,030 ns (0.17.x: 1.36 and 1.79), so the core 1 changes cost nothing.
- **Windows keeps the old disk's partitions after a switch**: after `T` from the welcome disk it still listed D: on the test disk, and refused raw writes inside it (`EBADF`), failing `-m speed`. The rig's Windows host now runs `Update-Disk` before opening the disk for writing, which makes Windows read the partition table again (`host_windows.py`; not firmware).
- Still to check: macOS mounting it (`.fseventsd`, `.Spotlight-V100`, in the 256 KB overlay).

## [0.17.1] - 2026-10-29

The three bus observer findings from the 6-hour DMA soak, fixed.

### Fixed
- **LBA 65535's word 3 in multiword DMA** (`ide_dma.pio`). That word takes all 16 data lines from 0 to 1 at once, and the switching was enough for the DMA read program, which watches DIOR# without the input synchroniser, to see the strobe end early and release DD before it had. The host had already latched the word (it read it right all through the soak), but the bus observer, sampling as DIOR# rises, saw `0000` in about one read of that sector in four. The program now waits 4-5 cycles (20-25 ns) after driving DD before watching DIOR#, well inside mode 2's 70 ns strobe (tD). On the rig (`host/runs/tools/dma_settle.py`, 5,000 reads of LBA 65535): 24% flagged before, 0 in 3 runs (about 7,600 checked) after; the host 0 wrong throughout. Stronger drive made it worse, as more switching noise would: 8 mA with fast slew failed the read at the host every time, so DD stays on the RP2350's default 4 mA, slow slew.
- **The observer's ring is 16 KB** (4,096 samples, from 1,024), and `s` shows its high-water mark, `bus_ring_max=used/size`. Sequential DMA reads on the built-in disk now peak at about 1,030 samples waiting, just over the old size: hence the soak's 94,071 missed words. 48 MB read in 64 KB requests: 0 gaps.
- **`bus_dma_words` is 64-bit**: at DMA's rate 32 bits wrap in a few hours.

### On the rig
- **A 60-minute DMA soak** (29 Oct, `soak_dma.sh 60`, built-in disk, write-behind on): passed. 6,455 MB, no mismatches, 221,957 commands all DMA, no resets, worst read 1,150 ns. The bus observer checked 11.1 million sectors: 0 bad (the 6-hour soak's rate would have given about 22), 0 gaps, `bus_ring_max` 1,034 of 4,096, and `bus_dma_words` 3.03 billion. The soak's progress lines now show `ring max`.
- **A 10-hour DMA soak** (29-30 Oct, `soak_dma.sh 600`, the same setup, with the soak's hourly 11-minute idle pauses): passed. 51.9 GB moved (693,681 reads, 375,843 writes), no mismatches, 1,791,444 commands all DMA, no resets, worst read 1,170 ns. The bus observer checked 89.0 million sectors: 0 bad and 0 gaps, through eight idle pauses (where 0.17.0's soak lost most of its words); `bus_ring_max` 2,570 of 4,096 (it rose in steps, to 2,322 by 4 hours and 2,570 at 8); `bus_dma_words` 24.4 billion. 5.2 GB an hour with the pauses, as 0.17.0's 6-hour soak.

## [0.17.0] - 2026-10-29

Write-behind on by default, and settings for it and the other options in `HDDSYNTH.INI`.

### Added
- **Four on/off settings in `HDDSYNTH.INI`** ([docs/settings.md](docs/settings.md)): `dma` (whether `mode = auto` may offer multiword DMA where DMARQ is wired; off), `write_behind` (on), `read_ahead` (on) and `activity_link` (on). They take on/off, yes/no, true/false or 1/0; a bad value or a repeat is a warning, as for the other settings. Console `E` sets them, and adds one the file doesn't have yet. `S` shows them all. The console's `W`, `A` and `L` still switch them until the next restart.
- The file `C` creates has them, with comments, and no longer says the firmware supports PIO mode 0 only.

### Changed
- **Write-behind is on by default.** Re-measured on 0.16.5: card writes 1.65 MB/s against 1.05, 192 MB written and read back clean, worst read 1,040 ns (its slow reads at 150 MHz are gone). The drive acknowledges a sector while storing it, so a power cut in that millisecond loses it; this adapter never sends FLUSH CACHE. `write_behind = off` puts it back.
- `cfg::AUTO_DMA` is now the `dma` setting (default `drive_config::DEFAULT_DMA`, off until the DMA soak).

### On the rig
- **A 20-minute DMA soak** (`host/runs/tools/soak_dma.sh 20`, the dry run for the long one): 2,242 MB, 0 mismatches, 77,415 commands all DMA, 3.84 million sectors checked on the cable, 0 bad, worst read 1,150 ns, no host resets. About 112 MB a minute, twice the PIO mode 3 soak's rate, with the observer checking every DMA word.
- **The 6-hour DMA soak** (29 Oct, multiword DMA mode 2, built-in disk, write-behind on): passed. 32.9 GB moved in 6 hours (439,693 reads, 237,479 writes), no mismatches, 1,134,579 commands all DMA, no host resets, worst read 1,150 ns; about 92% more data than the PIO mode 3 soak in the same time. The bus observer checked 51.6 million sectors and flagged 102, every one LBA 65535 word 3 (`0000` seen where `ffff` was due, all 16 lines rising at once, which the host read correctly): the bus still settling when the observer samples, up to about 15 ns before the host does, so later than DMA mode 2's 50 ns (tE). The data lines run on the RP2350's default 4 mA, slow-slew drive, the first suspect. It also missed 94,071 words (`bus_gaps`), almost all after the first idle pause: core 0 falling behind its 1,024-word buffer at DMA's rate. And `bus_dma_words` wraps at 2^32. All three to fix before DMA becomes the default.
- **DMA writes to the card**, with write-behind (the scratch image, `writeverify.py`): 2.23 MB/s against 1.65 in PIO mode 3, 128 MB written and read back clean, worst read 1,150 ns. The card is the limit (the built-in disk takes DMA writes at 9.8 MB/s).

## [0.16.6] - 2026-10-29

Ready for the PCB: the firmware switches its IDE bus on.

### Added
- **BUS_EN# (GPIO 41)**: rev 0.3's bus switches stay off until the firmware drives it low. Core 1 does, right after `ide_bus` has set the bus pins up, so the host never sees them in another state; the listen build does too, after setting its pins up. On the BB48 GPIO 41 is unconnected. With it, JP1 (which bypasses BUS_EN#) can stay open.
- `p` also shows `SD_CD=` (GPIO 40, the PCB's card detect; it floats on the BB48) and `BUS_EN#=`.
- [docs/pcb-bringup.md](docs/pcb-bringup.md): the first day with the board, step by step.

### Changed
- **The DMARQ test runs on core 1, after the bus switches are on** (it ran on core 0 before the bus was set up, so on the PCB it would have found the pin bare and never offered DMA). Core 1 also decides the DMA offer there, before anything builds IDENTIFY. On the rig: still `dmarq=wired`, reads unchanged.

## [0.16.5] - 2026-10-29

Catches a host that doesn't wait for IORDY, before trying a retro machine.

### Added
- **`iordy_check.pio`**: counts reads the host ended (DIOR# rising) while IORDY was still low, so it didn't wait for the data. ATA lets hosts ignore IORDY in PIO modes 0-2, and some older controllers do; they'd read garbage whenever core 1 is slower than their strobe. `s` shows `iordy_ignored=` and `iordy_ignored_reg=` (should be 0), and a `NOIORDY` line appears, at most once a second, if it isn't. It runs in the diagnostics' PIO block beside the IORDY timer and the bus observer (now 29 of its 32 instructions). Simulator tests: a host that waits, one that doesn't, back-to-back data reads where `ide_bus` pulls IORDY low again 20 ns after each strobe, and DMA strobes.
- On the rig, through the USB adapter (which honours IORDY): 0 across detection, reads and `-m speed`.

## [0.16.4] - 2026-10-29

The drive finds out at start-up whether DMARQ is wired.

### Added
- **DMARQ detection:** before choosing the disk and modes, core 0 turns on GPIO 31's internal pull-up (only pull-downs are forbidden) and reads it 1 ms later. The host pulls DMARQ down, so a wired pin reads 0 and a bare one 1; the pull-up goes off again. `S` shows `CONFIG dmarq=wired|absent auto_dma=0|1`. On the rig: `wired`.
- **DMA is never offered without DMARQ**, even when `HDDSYNTH.INI` asks for it (`mode = mdma2`): `S` warns, and the drive offers PIO. A host told the drive does DMA would otherwise wait for DMARQ forever.
- **`cfg::AUTO_DMA`**: whether `mode = auto` offers DMA when DMARQ is wired. Off until DMA has had a soak; then `auto` gives DMA on the PCB and the wired rig, and PIO mode 3 on a BB48 without the wire. On the PCB the bus switches must be on (BUS_EN#) for the test to see the host.
- Not yet tried on the rig: a BB48 without the wire reading `absent`.

## [0.16.3] - 2026-10-29

The bus observer checks DMA data on the cable.

### Added
- **The bus observer checks multiword DMA reads**, as it does PIO data reads. It already recorded every DIOR# strobe; the checker (`sector_check`) now takes a read with no chip select, which is a DMA word, as data. A DMA transfer is whole sectors back to back, and the status poll after each command starts a new sector, so they stay in step. `s` shows `bus_dma_words=`. Three new unit tests, one replaying 0.16.1's lost first word (caught).

### On the rig (built-in disk, `mode = mdma2`)
- Slices 3-4 and `-m speed` pass with the observer checking: 331,090 sectors checked on the cable, 0 bad, 0 gaps, from 89 million DMA words (the 17,188 skipped were the tests' own random writes read back). Worst read 1,030-1,100 ns.
- **With the observer checking every DMA word, reads on the built-in disk run at 2.60 MB/s instead of 5.14**: core 0 now computes each sector twice, once to serve it and once to check it. Writes (9.77 MB/s) and images (where the observer checks only IDENTIFY) aren't affected. A soak checks everything; if full speed is wanted under test, the checker could skip sectors when it falls behind.

## [0.16.2] - 2026-10-29

Multiword DMA works on the rig: reads 3.8 times faster, writes 5.5 times, random reads 12 times.

### Fixed
- **The first word of every DMA read burst was lost.** `ide_dma_read` raised DMARQ on its `pull` of the first word, and side-set takes effect when an instruction issues, even one that then waits. Core 1 puts the burst's count in the FIFO and only then starts the DMA channel, so DMARQ rose while the FIFO was empty, and the host's first strobe found nothing on DD: word 0 of every sector read 0048h on the rig, the other 255 right. DMARQ now rises on the first instruction after the pull. The simulator's DMA model now brings the words a little after the count, as the hardware does (`dma_delay_ns`); with the old program 9 of its 15 DMA tests fail.
- **A status poll after each DMA command was held 1,540 ns.** `ide_dma::endCommand()` reset the whole program even after a command that finished normally, in one bookkeeping step, just as the host polls. It now only switches DMARQ off then; the full reset is kept for a command cut short mid-burst.
- The trace names READ DMA's no-retry form and WRITE DMA (`ca ?` before). The activity classification and the HDD Synth link already counted DMA commands as reads and writes.
- Rig tests count DMA commands as well as PIO ones (slices 3-4, `-m speed`).

### On the rig (Windows, the built-in disk, with DMARQ and DMACK# wired; `mode = mdma2`)
- **The adapter takes multiword DMA mode 2** (SET FEATURES 03h, 22h) and reads and writes by READ DMA and WRITE DMA.
- Against PIO mode 3 on the same disk (`-m speed`): sequential reads 5.14 against 1.36 MB/s; random 4 KB reads 969 against 78 a second; sequential writes 9.76 against 1.79 MB/s. **The adapter's 10.9 ms per read command is gone (0.11 ms)**: in DMA the drive tells the adapter it's ready, where in PIO the adapter waited about 10 ms before polling. Reads now cost 98 µs a sector on the drive's side (the bus, fetches from the built-in disk, and a burst per sector), where the bus itself would allow 31.
- Data: slices 3 and 4 pass in DMA (the whole disk read and compared, writes read back), and 8,200 sectors read and checked by hand, 0 wrong. Six redetect cycles took DMA every time, no slow reads, no lost disk. Worst read 1,080-1,100 ns. The bus observer can't check DMA data yet.

## [0.16.1] - 2026-10-29

### Fixed
- **DMARQ (GPIO 31) was left with the RP2350's internal pull-down on**, its power-on default: `ide_dma` never turned it off. The rules forbid internal pull-downs (erratum E9), and the host pulls DMARQ low anyway. Off now.
- DMACK# (GPIO 3) is set up as an input with no internal pulls, so it can be read.

### Added
- `p` also prints `PINS DMARQ=... DMACK#=...` (drive build). With the two DMA wires added on the rig (29 Oct): DMARQ 0, DMACK# 1 at rest, as expected; idle levels can't prove the wires, DMA working does.

## [0.16.0] - 2026-10-28

Multiword DMA, built but not yet tried on hardware: it needs DMARQ wired.

### Added
- **READ DMA and WRITE DMA** (C8h-CBh) in multiword DMA modes 0-2 ([docs/dma.md](docs/dma.md)), offered only when `HDDSYNTH.INI` says `mode = mdma0`, `mdma1` or `mdma2`: on the BB48 rig DMARQ and DMACK# aren't wired yet, and a host told the drive does DMA would wait for DMARQ forever. The PIO mode offered alongside is `auto`'s (3).
  - `ide_dma.pio`: the data phase, in a PIO block of its own, fed (reads) or drained (writes) by an RP2350 DMA channel, since DMA has no IORDY and mode 2 gives 50 ns from DIOR# to data. Proven in the simulator against a multiword DMA host in modes 0-2 (`host/tests/test_dma_sim.py`).
  - `ide_dma.cpp`: core 1 runs a burst per sector, handing DD0-15 to the DMA block for a read burst and back to `ide_bus`'s after it, and drives DMARQ (GPIO 31) only during a DMA command (its output forced off otherwise). A command cut short (RESET#, SRST, a new command, an error) stops the burst and releases both.
  - `ata_device`: the same fetches, read-ahead and write-behind as PIO; one interrupt, at the end; no BSY between sectors. IDENTIFY word 49 bit 8 and word 63 (modes supported, the fastest selected), SET FEATURES 20h-22h. 10 new unit tests.
- `cfg::PIN_DMARQ` (GPIO 31) and `cfg::PIN_DMACK_N` (GPIO 3), as on the PCB. `S` shows `mdma_offered=`.

### On the rig
- With DMA not offered (the default), nothing changes: slices 3 and 4 pass in PIO mode 3, reads 1.38 MB/s and writes 1.79, and the bus observer checked 335,019 sectors on the cable, 0 bad (1 gap: words it missed, not wrong ones). The worst read during the tests was 1,030 ns (920 on 0.15.0): the new code moved core 1's in RAM.
- **10-hour soak** (Windows, generated disk, PIO mode 3, 200 MHz; 28-29 Oct): clean. 28.9 GB moved (385,288 reads, 209,009 writes), 0 mismatches, 995,797 commands, 49.5 million sectors checked on the cable with 0 bad and 0 gaps, no host resets, worst read 1,060 ns (steady all night). Against the 0.12.0 soak (150 MHz, PIO mode 0) at the same point: 7.8% more data, and 180 ns more margin on the worst read.

## [0.15.0] - 2026-10-28

PIO modes 1-3: the adapter now runs the bus in mode 3.

### Added
- **PIO modes 1, 2 and 3.** IDENTIFY offers modes up to `HDDSYNTH.INI`'s `mode` (word 51 for 1-2, word 64 for 3, words 67-68 the cycle time), and SET FEATURES accepts flow-control modes up to the one offered. `auto` offers mode 3, the fastest there is (`drive_config::AUTO_PIO_MODE`). The bus program is the same in every mode: IORDY holds the host while core 1 answers, as in mode 0.
- `S` shows `pio_offered=` in the CONFIG line.

### On the rig (Windows)
- **The adapter takes mode 3**: it asks for mode 4 (SET FEATURES 0Ch) and, refused, for the fastest IDENTIFY offers in word 64 (0Bh). It never asks for modes 1 or 2: offered mode 2, it fell back to mode 0.
- On the generated disk, mode 0 against mode 3: reads 1.33 against 1.36 MB/s (297 against 287 µs per sector), writes 1.58 against 1.79 MB/s (+13%). Reads barely change because the adapter, not the bus, sets their pace: about 1.1 µs a data word in both modes, where the simulator gives the bus program about 440 ns a word in mode 3. So faster PIO modes can't speed reads up much on this adapter; DMA modes may (on the PCB, which has DMARQ and DMACK#).
- Mode 3's data checked: slices 3 and 4 pass (reads against the generated disk, writes read back), and the bus observer checked 262,868 sectors on the cable, 0 bad. `iordy_early` now counts most reads: in mode 3 the chip selects come only 30 ns before the strobe, so IORDY falls just after it (about 10 ns), still well before the host samples it (35 ns).

### Simulator
- The host model has modes 1-4 (`ide_host_model.PIO_MODES`, `FAST_PIO_MODES`), with mode 3-4's strobe recovery (t2i), and records IORDY falling after the strobe as a negative lead. `test_pio_bus_sim.py` holds the bus program to modes 0-3's timings (IORDY low at least 15 ns before the host samples it: 24 ns in mode 3).
- **Mode 4 is not offered**: its write data is valid only 20 ns before DIOW# rises, and the program samples a write every 35 ns, so the last sample can miss it (the simulator loses words); and a read straight after a write leaves IORDY 6 ns. It needs a reworked write path.
- Fixed: `test_iordy_timer_sim.py` and the slice 3 test's read past the end of the disk (Windows refuses it, macOS returns nothing).

## [0.14.0] - 2026-10-28

200 MHz instead of 150: headroom on every read.

### Changed
- **The RP2350 runs at 200 MHz** (`board_build.f_cpu` in `platformio.ini`; Raspberry Pi certifies it), up from the default 150. Core 1 answers every read in instructions, so the time a read is held shrinks with the clock: the worst read during traffic and detection fell from 1,173-1,320 ns to 850-920 ns.
- **The peripheral clock stays on the system clock** (`peripheralClockFromSystem()`, before SPI and the link's UART start). Setting another clock moves it to the 48 MHz USB clock, where the card's SPI would top out at 24 MHz; at 200 MHz, 25 MHz is ÷8, exact as ÷6 was at 150.
- The bus program's data settle before IORDY is released is 8 cycles: 40 ns now, 53 before. ATA asks only that the data be valid when IORDY rises (tRD = 0), and the delay was already at its maximum. The PIO simulator runs at 200 MHz (`pio_sim.CLOCK_HZ`), and `ide_bus.pio` meets every ATA mode 0 timing there; the IORDY timer's test works its threshold out from the clock, as the firmware does.
- `s` shows `clk_sys_mhz=` and `clk_peri_mhz=`.

### On the rig (Windows)
- Reads 1.31 MB/s, up from 1.23 (`-m speed`: 10.9 ms per command + 301 µs per sector, against 318-328), worst read 850 ns.
- Detection: 12 redetect cycles, 0 slow reads (0.13.0: 2 in 24, 1,253-1,320 ns), worst 850 ns; 29 IDENTIFY blocks checked on the cable, 0 bad.
- Writes to `HDDBENCH.IMG`: 0.94 MB/s with write-behind off, as before. With write-behind on (`W`), 1.61 MB/s, and 160 MB written and read back with 0 bad sectors and 0 slow reads, against about 2,000 reads held 1.5-2.0 µs per 16 MB at 150 MHz; but the worst read was 1,250 ns, the limit itself, so write-behind stays off by default for now.

## [0.13.0] - 2026-10-28

A microSD card put back while the drive runs is served again, if it's the same card with the same image.

### Added
- **Re-mounting the card** (`src/media_watch.*`, host-tested; `sd_card.cpp`). A card pulled out is noticed when an image read or write fails: the drive prints `CARD lost`, and from then on the image's reads and writes fail at once instead of each waiting on the card. Every 250 ms core 0 looks for the card coming back, with a single CMD0 sent by hand (about half a millisecond; SdFat's own start-up retries it for 2 s with no card). A card that answers is started again and the image reopened, and it's served again (`CARD back HDDSYNTH.IMG`) only if it's the same card (its CID's maker and serial number) and the image is unchanged: the same size, place on the card and modify time (the drive never sets that time, so only a computer changes it).
- **Anything else isn't served**: `CARD changed: another card` (or `image modified`, `image replaced`, `image not found`, `can't mount`) and reads and writes keep failing until the right card is back, or the drive restarts. The host caches what it knows of the disk's file system, and its next writes would corrupt a different card or an edited image. While a different card is in, the drive checks once a second that it still is (reading its CID).
- **A card pulled and put back while the drive is idle costs nothing**: a read or write that fails is retried once after restarting the card, if it comes back as the same card.
- `s` shows `card=` (`none`, `present`, `lost` or `changed`), `card_lost=` and `card_back=`.
- **`-m card`** (`host/tests/test_card.py`): the card pulled and put back while idle and during reads, with the data compared before and after; with `HDDPRO_SECOND_CARD=1`, another card refused. Needs someone at the rig; reads only.

### On the rig
- Card in: reads 1.23 MB/s and writes to `HDDBENCH.IMG` 0.92 MB/s, as before, worst read 1,226 ns.
- `-m card` on Windows passes. A swap while idle is invisible: the next read found the card restarted, restarted it and was retried. Pulled during reads: the read in progress failed after 345 ms (UNC) with `CARD lost`, later ones in about 170 µs. The adapter resets and re-detects the drive about every 21 s and retries the read: with the card back within 20 s the retry succeeded and the host saw no error, only a slow read; left out 90 s, the host saw four failed reads, then the fifth retry succeeded. Either way Windows kept the disk and the data read the same afterwards. Not yet tried: a second card (`HDDPRO_SECOND_CARD=1`).
- Starting with no card, tried on the rig at last: the built-in disk after 2.0 s (`SD error: no card`, `card=none`), and Windows reads its pattern right.
- The overnight soak on 0.12.0 (generated disk, Windows): 10 hours clean. 26.8 GB moved (357,427 reads, 192,546 writes), 0 mismatches, 920,973 commands, 45.9 million sectors checked on the cable with 0 bad and 0 gaps, no host resets, worst read 1,240 ns (ALTSTATUS).

## [0.12.0] - 2026-10-27

Serve the built-in test disk with the card in.

### Added
- **`image = none`** in `HDDSYNTH.INI` (any case): serve the built-in 64 MB test disk instead of an image, leaving the card alone. The soak test needs it (only that disk's data can be checked on the cable by the bus observer), and until now it was served only with no card in. Set it with console `E image = none` and `!`; `E image = HDDSYNTH.IMG` and `!` put the image back. `J` still comes first. The file `C` creates mentions it.

## [0.11.1] - 2026-10-27

The STATUS read after IDENTIFY, within ATA's limit (nearly always).

### Fixed
- **The adapter's first status poll after a command was held 1,346-1,386 ns** (ATA allows 1,250): it polls at once after IDENTIFY and SET FEATURES 03h/08h, while core 1 was still on the command's trace bookkeeping or its next bookkeeping step. Core 1 now answers any access already waiting before that bookkeeping, and for 4 µs after a command starts (`cfg::COMMAND_QUIET_US`) only serves the bus. Recording the CMD line or posting a READ's fetch 4 µs later costs nothing; the adapter waits about 10 ms after a READ.

### On the rig (Windows, redetect cycles)
- Measured in A-B-A order against v0.11.0 after a PC restart, which cleared the adapter's decline (below): v0.11.0 6/24 double detections, 2 lost or renamed disks, 50 slow reads; this fix 2/24, 0, 4 slow reads (1,253-1,320 ns, around IDENTIFY: 4 in 48); v0.11.0 again 3/12, 2, 26. Reads 1.23 MB/s, worst read during traffic 1,173 ns, as before.
- Before the restart the same fix had looked far worse (11/12 double detections). The adapter was then declining in every build, the baseline included, after the PC had run for days with it plugged straight in: it was corrupting its own USB serial number and the disk's name. Restarting the PC cleared that, and 24 cycles on v0.11.0 afterwards didn't decline.

## [0.11.0] - 2026-10-27

Re-detection without a replug, and two detection bugs it found.

### Added
- **Console `V`**: the drive leaves the bus (the bus program stopped, DD, IORDY and INTRQ released, the device reset) and comes back at the adapter's next RESET# assert, a second `V`, or after 120 s. With a read sent meanwhile, the adapter fails it, resets about 20 s later and probes; the drive is back before that reset ends, so it is detected again (IDENTIFY, SET FEATURES) and the read is retried. About 30 s, and the host keeps the disk. Coming back later, after the adapter had started probing an empty bus, once left it with a garbled IDENTIFY.
- **`HDDPRO_REPLUG=redetect`**: `rig.replug()` does that cycle (`Host.redetect()`), so slices 1-2 run their 20 cycles with no hands on the rig. A re-detection, not a power-up probe: not for slice 0.
- **IDENTIFY checked on the cable**: the bus observer compares IDENTIFY blocks with the drive's own on the words that never change (serial, firmware, model, capacity), and prints `BUSERR t IDENTIFY ...` for a bad one; `s` shows `bus_identify=` and `bus_identify_bad=`. On an SD image only for 10 s after each RESET# release (detection), since checking every word costs core 0 enough to slow reads from 1.23 to 1.16 MB/s.
- **`STUCK`**: a command running over 3 s prints the last fetch core 0 served and whether its result is still waiting for core 1.

### Fixed
- **The drive stayed BSY for good when the host wrote a command over an unread block.** The JMicron sometimes gives up on a READ (or IDENTIFY) partway and writes the next command with no reset. `startCommand` kept the old data pointer, so the device looked mid-transfer: loop1 then never took the new fetch's result (`STUCK ... results_waiting=1`), and the new sector would have been taken for a read-ahead. Windows dropped the disk. A new command now abandons an unread block and any read-ahead; host tests reproduce both cases.
- **Busy (the activity LED and the HDD Synth link's busy flag) stayed on after a command was cut short** by RESET#, SRST or a new command, since it never counted as completed. After a detection the link said busy until the next command ended. A cut-short command now counts as completed.

### Found
- The STATUS read straight after each IDENTIFY is held 1,266-1,293 ns (now 1,346-1,386 with the fix above in the command path): the adapter polls at once while core 1 is still running the command. Deferring the command's trace bookkeeping only moved the slow read to SET FEATURES, so that was reverted. Slice 1's IORDY check fails on it.
- The JMicron read IDENTIFY with three words in four zero twice (once after a redetect that came back late, once after a reflash), and Windows named the disk "HD P". Not seen in 69 IDENTIFYs checked on the cable since.

### On the rig (Windows, no hands)
- 30 redetect cycles, each followed by 4 MB of reads from the SD image: all detected, 69 IDENTIFYs checked on the cable with none bad, 8 abandoned READs recovered (each a hang before the fix), the disk kept its name. Before the fix: hangs in about 1 cycle in 5. Reads 1.23 MB/s outside the IDENTIFY window.

## [0.10.2] - 2026-10-27

The slice 0 test, reworked so it can pass while the adapter probes forever.

### Added
- **The listen build's capture window** (console `w`, `cfg::LISTEN_WINDOW_EVENTS`): with it on, each RESET# assert opens a window of 3,000 bus accesses, and the rest are counted (`skipped=` in `s`) but not recorded until the next RESET#. Two windows fit in the 8,192-event ring, so the adapter's double reset pulse never drops an event, and the trace goes quiet between pulses. Off by default, so recording a real drive works as before.
- `trace.opening_sequence()`: the first steps of a trace in printed order, repeats merged and read data left out (the bus floats with no drive), for comparing one probe with another.

### Changed
- **`test_slice0`** turns the window on, asks for a replug, and judges the trace from the first RESET# release: no stalls, drops or overlapping strobes, STATUS read or DEVICE written, and the opening sequence matches the saved reference. The reference is kept per adapter, `host/reference/slice0_probe_<adapter>.txt`, named by `HDDPRO_ADAPTER` in `host/rig.env` (adapters probe differently).

### On the rig (Windows, no replug)
- The adapter on the Windows rig enumerates as a JMicron (USB `152D:2338`), not the NS1081. With the listen build on, a read from Windows failed after 23 s, then the adapter pulsed RESET# (first a double pulse: 49 ms low, 4.4 ms high, 49 ms low; then one every 4.78 s) and ran the device-presence check after each (DEVICE=A0, SECCOUNT/LBA=A5/5A/AA/55, read DEVICE and STATUS back), about 420,000 accesses a second. Over 90 s: 18 windows of 3,000 accesses, 0 dropped, 0 stalls, 33.5 million skipped; 16 of 18 openings identical (the other two: inside the double pulse, and the window cut off when the recording ended). The test's checks pass on that trace.
- Back on the drive build the adapter found the drive again by itself; Windows had dropped the disk, and `pnputil /restart-device` on the adapter brought it back without a replug.
- Still to do with a physical replug: `scripts/rig.sh -m slice0 --save-reference`, then a second run to compare.

## [0.10.1] - 2026-10-27

The activity link's loopback test.

### Added
- **Console `U`**: with a jumper from GPIO 0 (TX) to GPIO 1 (RX), reads back what the link sends for 1 s and prints `LOOPBACK pass|fail|no-data sent= valid= rejected= errors= bytes= last=`. It passes when every sentence sent arrived valid, with no UART errors. GPIO 1 is the UART's input, with a pull-up, only while the test runs, and goes back as it was afterwards. It runs on core 0 without waiting, and resets the UART between sentences as it starts, so what the UART read before (breaks from the unconnected input, and the overrun mark that follows) doesn't count.
- `activity_link::parseLine` and `Receiver`, a byte-at-a-time receiver with the reference parser's rules (`host/hddproto/activity_link.py`), host-tested with the cases the synth's brief lists. The HDD Synth's receiver can be a copy.
- `host/tests/test_link_loopback.py` (`-m link`): `U` idle and during reads.

### Changed
- The synth's brief no longer says to reject versions other than 1: a later version only adds fields at the end, so a receiver accepts it and ignores those fields, as both reference parsers do.

### On the rig (Windows, no jumper)
- `U` reports `no-data` (5 sent, nothing read, no errors) and the link carries on. With the UART's internal loopback (a throwaway build that set its LBE bit), `U` passed three times in a row, idle and during mixed reads from the SD image (5-6 sentences, all valid). Before the reset at the start, the second run failed on one overrun error.

## [0.10.0] - 2026-10-27

Settings on the SD card.

### Added
- **`HDDSYNTH.INI`** (docs/settings.md, `src/drive_config.*`): `image = <file>` chooses the disk image, and `mode = auto` (or `pio0`-`pio4`, `mdma0`-`mdma2`, `udma0`-`udma6`) the transfer mode to offer. Plain `key = value` text with comments; Notepad's CRLF and byte-order mark are fine. Missing file or keys mean the defaults (`HDDSYNTH.IMG`, `auto`), so a card without it behaves as before. Mistakes are reported and skipped, never fatal.
- The disk, in order: `HDDBENCH.IMG` after console `J`; the configured image; `HDDSYNTH.IMG` if that can't be used (not found, or empty); the generated disk. With no card the images aren't tried, so start-up without one still takes one 2-second wait.
- Modes other than PIO 0 are accepted with a warning and mean `auto` until they exist, so settings written now keep working.
- Console: `S` adds `CONFIG` lines (the settings, the image served, why a configured image wasn't used, warnings); `C` creates the file with the defaults; `E` then `key = value` sets one setting, keeping the file's comments and line endings; `!` restarts. `s` shows `image_name=` and `config=`.
- The firmware may now write `HDDSYNTH.INI` (only with `C` or `E`), as well as the image it serves and the images `I`/`K` create.

### On the rig (Windows)
- Without the file: as before. `C`, then `E image = HDDBENCH.IMG` and a restart: served the scratch image. `image = MISSING.IMG`: fell back to `HDDSYNTH.IMG`, reported as `MISSING.IMG: not found`. `mode = udma5`: warned, used auto. An unknown key was refused. `J` still wins over the file. Left the card with the default file.
- Not yet tried on the rig: starting with no card (needs the card pulled).

## [0.9.0] - 2026-10-27

The activity link to an HDD Synth, this side.

### Added
- **The activity link** (`src/activity_link.*`, docs/activity-link.md): the drive sends `$HDA,1,<busy>,<class>,<op>*<checksum>` sentences on UART0 TX (GPIO 0, 115200 8N1), on every change and every 200 ms, so an HDD Synth can play a different sound for sequential transfers than for random access. Busy is the LED's own flag; the class comes from the activity classifier; op is whether the last media command read or wrote.
- Driven through the Pico SDK, transmit only: a sentence is written only when the 32-byte TX FIFO is empty, so core 0 never waits on it. GPIO 1 (UART0 RX) is reserved and untouched.
- Console `L` turns it off and on; `s` shows `link=`, `link_sent=` and `link_last=` (the last sentence).
- `host/hddproto/activity_link.py`, the receiver's reference parser (it ignores bad checksums, other sentences and lines over 80 bytes, and accepts extra fields), with `sim` tests; C++ tests for the format, the checksum (the spec's known answers, shared with the Python tests) and the send rules.
- `test_ns1081_detection`: the adapter's detection sequence, from the drive's traces, as a host test.

### On the rig (Windows, SD scratch image)
- Sends: an idle heartbeat every 200 ms (`$HDA,1,0,I,-*28`), and 541 sentences over the speed and activity tests.
- No cost to the bus: reads 1.26 MB/s, 76 IOPS, writes 0.92 MB/s, worst read 1,120 ns, no slow reads, as 0.8.24. Core 1's code is unchanged and sits where it did.
- The activity test passes (each phase 95.5-99% in the right state).
- Not yet received by anything: the loopback test needs a jumper from GPIO 0 to GPIO 1.

## [0.8.24] - 2026-10-26

Write-behind's slow status reads traced to core 0, and fixed there.

### Fixed
- **Core 0 could spend hundreds of microseconds draining the IORDY timer's reports** (one for every read held over 400 ns). `iordy_timer::poll()` drained until the FIFO was empty, and since 0.8.23 converted every report to nanoseconds (a 64-bit division) to find the ones past 1,250 ns. When reports came every few microseconds it fell behind and stayed there. Read-aheads were picked up late, so the host found BSY at block ends and backed off (reads 0.87 instead of 1.27 MB/s), and the polling of the PIO's FIFO held up core 1's own PIO accesses. Each report is now compared with a limit worked out once at start-up, only reads past it are converted, and one call takes at most 8 reports. If reports come faster than that, the PIO drops the extra ones (it never waits), so `iordy_slow` can undercount. Core 1's code is unchanged.

### On the rig (Windows, generated disk)
- Write-behind on, 3-minute soaks: 0 slow reads (0.8.23: 32 and 39, worst 1,280 ns).
- Write-behind on, 30-minute soak: 1,609 MB, 55,660 commands, no mismatches, no resets, 0 slow reads; worst read 1,160 ns (STATUS); 2.76 million sectors checked on the cable, none bad.
- Write-behind on, 8-hour soak (27 Oct): 22.1 GB, 760,100 commands, clean; worst read 1,173 ns.
- **On the SD card (`HDDBENCH.IMG`, 16 MB of 64 KB writes) write-behind still holds reads**: writes 1.47 MB/s instead of 0.90, but about 1,600-2,800 ALTSTATUS reads per run past 1,250 ns, worst 1.5-2.0 us; off, none. There a store (about 550 us) outlasts the next block, so the drive waits in BSY for it at every block end, and core 0 is busy with SPI while the host reads status. Ruled out on the rig: contention on the fast peripheral bus (the bus counters show less with write-behind on), core 1's `time_us_32()` stalling behind core 0's SPI traffic on the APB (never over 12 cycles), and DMA (SdFat polls the SPI). Posting the next store before raising INTRQ, instead of in the following pass, didn't help and made the adapter hang (a write never completed; reverted). Next: watch it on a logic analyser, with GPIO markers from core 1.
- Reads 1.27 MB/s, as 0.8.23 (4 MB sequential, 64 KB requests).
- Found on the way, and not kept: inlining `Device::intrq()` or adding an inline data-word write changed only where core 1's code sat in RAM, yet held about 40% of data reads past 400 ns (3% before). That flood of reports is what exposed the core 0 problem. Caching the PIO FIFO pointers made the fast lane faster than ever, and with it the host reset the drive twice in 6 minutes (a command never completed); not understood yet.

## [0.8.23] - 2026-10-26

What holds status reads past 1.25 us with write-behind on: measured, not yet fixed.

### Added
- **`SLOWREAD t register ns`** for every read IORDY held past ATA's 1,250 ns (`cfg::IORDY_LIMIT_NS`), from the IORDY timer. The time is when core 0 collected the report, up to a sector's store after the read. The Python parser keeps them (`Trace.slow_reads`).
- `s` shows `write_behind=`.

### On the rig (Windows, generated disk, 3-minute soaks)
- Write-behind on: 32 and 39 slow reads in two runs, all ALTSTATUS, all during writes, median 1,253 ns, worst 1,280. Write-behind off: none in 13.5 hours.
- A pass probe (core 1 timing each pass of its loop by what it did, with its SysTick) showed bookkeeping passes of 400-730 ns even idle, and passes over 1 us for finishing a written sector, posting its store and taking the result. But its own bookkeeping pushed slow reads to 2,000-16,000 per run, so it was removed rather than kept as a tool that misleads.
- Finishing the written sector later instead of at its last word made it worse: as core 1's next job, 931 slow reads (ALTSTATUS); after the host's ALTSTATUS read, 18,820, and after its STATUS read, 18,431 (now STATUS). The work after a block (finish the sector, post the store, take the result) only fits before both status reads if it starts at once. Not kept.
- Next: make core 1's loop passes cheaper.

## [0.8.22] - 2026-10-25

A scratch image for benchmarks, and write-behind (built, measured, off by default). 0.8.16 to 0.8.21 were rig builds, not released.

### Added
- **`HDDBENCH.IMG`, a scratch image for tests that write freely.** Console `K` creates it (64 MB, zeros; refuses if it exists or there's no room). Console `J` restarts the drive serving it, or back: the choice is kept in a watchdog scratch register, which a power cycle clears, so after power-off the drive always serves `HDDSYNTH.IMG`. `s` shows `disk=bench`; `S` shows `image=` and `bench=` (open, present or none). The speed test measures writes on it; the soak and slices 3-4 still need the generated disk, and `require_generated_disk` now insists on it.
- **Write-behind** (`Device::setWriteBehind`, console `W`): the host sends the next sector into the other buffer while core 0 stores the last, and the command completes only when every sector is stored. A failed store is reported, at its sector, once the block in progress ends. Unit-tested, including under ThreadSanitizer. **Off by default**: on the rig it lifts writes to the SD card from 0.92 to 1.51 MB/s with every byte intact, but it holds some status reads during writes 1.5-2.0 µs (ATA allows 1.25), not yet understood.
- After each data-out block but the last, the drive shows BSY for at least 10 µs (`cfg::DATA_OUT_BSY_US`) before DRQ and INTRQ ask for the next one. The NS1081 reads Status straight after a block, clearing any interrupt, then waits for INTRQ; without the hold, write-behind sometimes left it waiting forever.

### Fixed
- `SpscRing::push`/`pop` and `FetchMailbox::post`/`takeResult` are always inlined; a new call site made GCC call copies in flash (caught by `check_core1_ram.py`).

### On the rig
- SD card writes on the bench image: 0.92 MB/s (553 µs a sector), against 1.55 MB/s into the RAM overlay. Creating the 64 MB image took 30 s.
- Generated disk, write-behind off: reads 1.27 MB/s, writes 1.55 MB/s, worst read 1,106-1,120 ns; 5-minute soak clean, 434,799 sectors checked on the cable.
- Handling the mailbox in the middle of every block (0.8.17) made the adapter stop after SET FEATURES at detection, twice; posting stores only (0.8.19) didn't. Not understood.

## [0.8.15] - 2026-10-25

The SD path made safe for real use, and the worst read back near 1 µs with read-ahead kept. 0.8.7 to 0.8.14 were rig builds, not released.

### Added
- **FLUSH CACHE flushes the storage.** The device goes BSY and core 0 calls `BlockSource::flush()`; on the image that is SdFat's `sync()`, which also waits for the card. A failed flush aborts.
- **IDENTIFY declares a write cache and FLUSH CACHE** (words 82/85 bit 5, 83/86 bit 12), so hosts that flush know to. **SET FEATURES 02h/82h** turn the write cache on and off; off, each written sector is synced before the write completes. A hardware reset turns it back on.
- SET FEATURES trace lines show the subcommand and its count.
- `disk_ms` in `s`: how long choosing the disk took at boot.
- Console `A` switches read-ahead (debug, for comparisons, like `F`).

### Changed
- Core 1's fast lane posts the read-ahead only after the block's first data word, answers a status poll before catching the device up, and handles anything but a data read out of line, so its loop keeps its values in registers.

### Fixed
- The worst read with read-ahead was 1,160-1,240 ns; it's 1,053-1,080 again (0.8.2: 960-1,053), with read-ahead on or off. Found by bisecting: 0.8.2 still measured 960-1,053 on the day, 0.8.6 1,160-1,173.

### On the rig
- The NS1081 never sends FLUSH CACHE, not on unmount and not for `F_FULLFSYNC`: the flush is for other hosts.
- At detection it asks for PIO flow-control mode 4 (SET FEATURES 03h, 0Ch) before falling back to mode 0, which we refuse because IDENTIFY doesn't offer it.
- With no card the drive gives up after 2.0 s (SdFat's timeout) and serves the generated disk.
- Generated disk: 1.24 MB/s, worst read 1,080 ns; 5-minute soak clean, the bus observer checked 431,217 sectors.

## [0.8.6] - 2026-10-25

### Added
- **Read-ahead.** The device keeps two sector buffers: while the host reads one, core 0 fills the other with the read's next sector, and DRQ for it comes as soon as the host finishes. A failed read-ahead is reported at its own sector; a late one after a reset is ignored. Core 1's fast lane posts the read-ahead and takes its result while it waits between words, one small job per pass.
- Unit tests for read-ahead (hidden fetch, separate buffers, failure at the right sector, stale after reset); also clean under ThreadSanitizer.

### On the rig
- Image-disk reads 1.26 MB/s (from 0.84), 318 µs a sector (from 519). Worst read 1,160-1,173 ns. Two full reads of the image identical.

## [0.8.3] - 2026-10-25

### Changed
- **The SD card's SPI clock is 25 MHz** (`cfg::SD_SPI_MHZ`, from 12). Image-disk reads go from 0.59 to 0.84 MB/s; three full reads of the image gave identical hashes.

## [0.8.2] - 2026-10-25

### Fixed
- **The worst read is back near 1 µs** (1,026-1,053 ns, from 1,146 in 0.8.1). Core 1's general access handling is inlined into `serviceOnce` and the fast lane again, instead of costing every access a call. The bus decode helpers (`bus_sample.h`) and `Device::peek` are always inlined, since GCC otherwise calls copies in flash, as `check_core1_ram.py` showed.

### On the rig
- 5-minute soak: no mismatches; the bus observer checked 381,436 sectors.

## [0.8.1] - 2026-10-25

The start of the speed work, logged in `docs/speed-log.md`: sequential reads from 0.87 to 1.05 MB/s.

### Added
- **Core 1's fast lane for data reads** (`ide_bus::serveDataIn`, `Device::dataInRemaining`/`consumeDataWords`): while the host reads a DRQ block, core 1 answers each data register read straight from the buffer. Anything else leaves the lane and is served as before. Off while the raw trace or the debug delay is on; console `F` switches it for comparisons.
- **`scripts/check_core1_ram.py`**: fails if anything core 1 calls from `loop1` (other than start-up and reset one-offs) is in flash. `scripts/rig.sh` runs it before flashing the drive build, and so does CI.
- `test -m speed`: the benchmark behind the speed log.

### Fixed
- 0.8.0 (not released) held reads up to 2.6 µs: GCC called an out-of-line `std::atomic<bool>::load`, which lives in flash. Core 1's shared flags are now `SharedFlag`, whose load and store are always inlined.

### On the rig
- Sequential reads 1.05 MB/s (from 0.87), 398 µs per sector (from 501); writes unchanged at 1.56 MB/s. Worst read 1,146 ns (from 1,000), the same with the lane off.
- 10-minute soak: no mismatches; the bus observer checked 762,610 sectors.

## [0.7.3] - 2026-10-25

### Added
- **A bus observer** (`bus_observer.pio`, `bus_observer.*`, `sector_check.*`): a third PIO program samples DD0-15 and the register bits just before every DIOR# rise, DMA copies the samples to a ring in RAM, and core 0 checks each data sector against the generated disk. `s` shows `bus_sectors`, `bus_bad`, `bus_skipped` and `bus_gaps`; a wrong sector prints a `BUSERR` line (LBA, first wrong word, bits lost and gained). It tells whether a mismatch the host sees was already wrong on the cable.
- The soak labels each mismatch "wrong on the cable" (with the `BUSERR` line) or "right on the cable", and logs the observer's counts.

### On the rig
- 3 minutes of soak traffic: 207,564 sectors checked, none wrong, no samples missed. The worst read rose from about 955 ns to 1,000 ns, probably the observer's DMA on the bus.

## [0.7.2] - 2026-10-25

Diagnostics for the rare read mismatch the overnight soak found: one sector in 8 hours (17 GB), always the first sector of the second command when a long read is split at 128 sectors, with bits that should be 1 read as 0.

### Added
- **The IORDY timer counts reads that start while IORDY is still high** (`iordy_early`, `iordy_early_reg` in `s`), when the host might not wait for the data. On the rig: none in 15 minutes of soak traffic, so the adapter's strobe recovery isn't racing the bus program's re-arm.
- **Console `D` and a digit** (debug): core 1 answers every data read that many × 250 ns later. `-m timing` steps it from 0 to 2,250 ns and checks the reads. On the rig the adapter waited for reads held up to 3.2 µs with no errors, so it doesn't give up on IORDY near our worst read (about 1 µs).
- The host model's strobe recovery (`Mode0.t2i`) for back-to-back accesses with CS held.

### Changed
- The soak waits 11 minutes once an hour, longer than macOS's disk sleep, so the drive goes into standby and the next access wakes it; it logs standbys, wakes and early reads. Overnight: 6 standbys and wakes, all clean.

## [0.7.1] - 2026-10-24

### Added
- **The BB48's LED (GPIO 25) is the drive's activity light**, like a hard disk's: lit while a command runs, and for at least 25 ms after any command starts (`cfg::LED_MIN_MS`), so a command of a few microseconds still shows. Core 1 counts commands as they start; core 0 drives the LED, so the bus loop gains two relaxed atomic stores per command.

### Documentation
- Brought the docs up to date with slices 4–5 on hardware: the README status, `docs/bringup.md` (the slice 1 IORDY limit, slice 4, the soak, an SD card section, the adapter's quirks), `docs/plan.md` (SD pins, slice status), `docs/wiring.md` (GPIO 25) and CLAUDE.md.

## [0.7.0] - 2026-10-24

The drive's disk can now live on the SD card (slice 5): macOS formatted it, mounted it, and the files survived a power cycle.

### Added
- **A disk image on the SD card, `HDDSYNTH.IMG`.** At boot core 0 mounts the card and, if the image is there, serves it as the disk (`ImageDisk`, over the `ImageFile` interface; SdFat over SPI underneath). Without a card or an image the drive uses the generated disk with its RAM overlay, as before.
  - Core 1 waits at boot for core 0 to choose the disk, so IDENTIFY reports the image's real size. Until then the bus pins stay inputs.
  - Console `s` shows `disk=image|generated` and `sectors=`; `S` adds `image=open|present|none`.
- **Console `I`** creates `HDDSYNTH.IMG`: 64 MB, one contiguous run, zero-filled (about 50 s). It refuses if the file exists or the card lacks room, and never touches any other file. The card's other contents are never formatted, deleted or changed.
- Host tests for `ImageDisk`: byte order, the last sector, out-of-range access, SD errors as failed fetches, and a write-then-read through the drive.

### Changed
- Slice 3, slice 4 and the soak skip when the drive serves an image. Their reads compare against the generated pattern, and slice 4 and the soak write to sectors 100,000–100,255, which would corrupt a formatted image. The read-write raw-disk fixture refuses an image outright.

### On the rig
- macOS partitioned and formatted the image (MBR, FAT32), mounted `HDDSYNTH`, and two files written to it, one a byte-exact copy of the README, were intact after a full power cycle. Worst read throughout: 993 ns.

## [0.6.4] - 2026-10-24

The first step of slice 5: the microSD card answers.

### Added
- **The microSD breakout's pin map** (`cfg::PIN_SD_*`): CLK, CMD and DAT0–DAT3 on GPIO 34–39, so the same leads serve SPI now (SPI0's pins, DAT3 as chip select) and 4-bit SDIO later (DAT0–3 consecutive). The breakout has no pull-ups; 10 kΩ ones are fitted on CMD and DAT0–DAT3.
- **Console `S`** (drive build): starts the card over SPI at 12 MHz with SdFat and reports its type, size and filesystem. It only reads. It refuses to start if SPI0 rejects the SD pins, because SPI0's default pins on this board are IDE data lines (GPIO 4–7).
- `docs/wiring-sd.html` (interactive) and a section in `docs/wiring.md`.

### On the rig
- `SD ok type=SDHC/SDXC size_mb=30436 fs=FAT32` on a 32 GB card, first time.

## [0.6.3] - 2026-10-24

### Fixed
- **The status poll straight after a command could wait up to 1.6 µs** (ATA allows 1.25 µs). The IORDY timer's register field showed it was always a STATUS read just after IDENTIFY or SET FEATURES.
  - Core 1 now runs a queued command and goes straight back to the bus. The CMD trace line is recorded later, with the time taken when the command ran.
  - Core 1 records at most one trace line per bookkeeping step, so a fast command's CMD and DONE lines no longer come back to back.
  - On the rig the worst read around detection is now 993–1006 ns over the last replugs, down from 1.03–2.2 µs.

### Changed
- Core 1 has high priority on the bus fabric (`BUSCTRL_BUS_PRIORITY`), so core 0's USB and other traffic can't delay its PIO accesses.
- Console `s` adds `bus_contested` and `bus_stalls`: contested accesses and stall cycles on the fast peripheral bus (where the PIO is), from the bus fabric's performance counters. They reset with the read timings. During detection they total about 3,000 stall cycles (20 µs), too few to matter.

## [0.6.2] - 2026-10-24

### Changed
- **The IORDY timer names the slow read.** Each report carries the register the read was for (DA2–0, CS0#, CS1#, sampled as DIOR# falls), and console `s` adds `iordy_max_reg` and `iordy_max_at_us` (when core 0 collected the worst report). The PIO simulator models `in`.

### Found on the rig
- The worst read around detection is a DATA read (2.2 µs on one replug), not a status poll. An earlier marker also put a slow read at the start of IDENTIFY's data.
- The NS1081 can't be made to re-detect the drive without a physical replug. A `uhubctl` replug doesn't reset its IDE side. A drive that only answers BSY makes it soft-reset at once. If the drive also ignores the soft reset, the adapter gives up on it until replugged.

## [0.6.1] - 2026-10-24

### Changed
- **A Command write only sets BSY on the bus** (`Device::queueCommand`); core 1 runs the command as its next job (`runQueuedCommand`). A status poll straight after the write sees BSY at once, as with a real drive. `write(StatusCommand, ...)` still runs a command at once, for tests and other callers.
- **Mid-sector, core 1 only serves the bus and watches RESET#.** While the host streams a DRQ block's 256 words (`Device::transferring()`), the other bookkeeping waits.
- The trace's CMD line is recorded when the command starts, from the queue.

### Measured on the rig
- Slices 1–4 and the activity test pass. Slice 1's IORDY check passes on some replugs and not others: the worst read around detection varies from 1.03 to 1.35 µs between runs (ATA allows 1.25 µs). In heavy traffic it stays at about 1 µs. The cause of the detection outliers is not yet known; these changes didn't move them.

## [0.6.0] - 2026-10-24

The drive is now a read/write IDE disk in PIO mode 0 (slice 4).

### Added
- **WRITE SECTORS** (30h, and the obsolete 31h). The data-out handshake follows ATA:
  - DRQ without an interrupt for the first sector;
  - BSY while core 0 stores each sector;
  - then DRQ and an interrupt for the next sector, or, after the last, completion with an interrupt.
  - A store that fails ends the command with ABRT and the failing LBA in the task file.
  - The handshake runs through the same `Fetch` and mailbox as reads, with `Fetch::store` set.
- **A RAM overlay disk** (`RamOverlayDisk`, `src/block_source.h`): writes are kept in RAM on top of the generated disk, for up to 512 distinct sectors (256 KB, `cfg::RAM_DISK_SECTORS`). Everything else reads the generated pattern; a write to a new sector when the overlay is full fails. `BlockSource` gains `write()`.
- **Write flow control in the bus program.** Writes don't wait for core 1, so a 256-word sector could outrun it and lose words. If the PIO's RX FIFO is full, IORDY now stays low until it has room, so the host waits instead.
  - In simulation, a core 1 taking 1 µs per word lost 98 of 256 words before this change and none after; the longest IORDY hold is 906 ns.
  - `ide_bus.pio` is now 32 instructions, a PIO block's whole instruction memory.
- Slice 4 rig test (`-m slice4`): 1,000 write-then-read cycles of random data in a 256-sector window, a long write, and the sectors around the window unchanged. It writes the generated content back afterwards, so slice 3 still passes.
- The PIO simulator models `mov x, status` (the RX FIFO level), and core 1 taking time over each access (`Core1(service_ns=...)`).

### Measured on the rig
- **Slice 4 passes:** 16,000 sectors written and read back at random, no mismatches, 0.5 MB/s each way.
- **Slices 3 and 4 pass together.** Over about 245 million reads, the longest IORDY hold was 986 ns, inside ATA's 1250 ns. The 1.28 µs seen in 0.5.5 happens only around detection.

## [0.5.5] - 2026-10-24

### Changed
- **Core 1 puts the bus first.** It serves every access waiting in the FIFO back to back, and only when the FIFO is empty does it do one small bookkeeping step before looking again.
- **Reads are answered before their side effects.** `Device::read()` is split into `peek()` (inline, no side effects) and `consumeRead()`. The bus layer hands `peek()`'s value to the PIO, then calls `consumeRead()`. The register is looked up from a 32-entry table instead of being decoded on every access.
- Slice 1 checks the IORDY timer against ATA's 1250 ns (tB). Core 1's own `read_max_ns` estimate is gone, with its cycle-counter setup.

### Measured on the rig
- The longest read went from 3.7 µs to 1.79 µs (tight loop), then to 1.28 µs (lean read path). Typical reads are still over 400 ns: what is left is fixed overhead around core 1. The next step is DMA-fed data reads, which would bypass core 1.

## [0.5.4] - 2026-10-24

### Added
- **An IORDY timer** (`src/iordy_timer.pio`, drive build): a second PIO program that only reads pins and times each read from the host's side, from DIOR# falling until IORDY is high again. Reads held longer than `cfg::IORDY_REPORT_NS` (400 ns) are counted and timed; console `s` shows `iordy_slow` and `iordy_max_ns`.
  - It runs in simulation too (`tests/test_iordy_timer_sim.py`).

### Changed
- `read_max_ns` and the IORDY timer both restart when the host releases RESET#. While the host powers up its strobes float low, which looked like one long read (up to 11 µs).

### Measured on the rig
- Nearly every read is held over 400 ns, and about 45% over 1 µs; the worst is 3.7 µs, against ATA's 1250 ns (tB). The NS1081 waits for IORDY, so nothing fails, but core 1 is too slow to answer reads.
- `read_max_ns`, core 1's own estimate, reads about 7 µs: it overestimates and will be replaced by the timer.

## [0.5.3] - 2026-10-23

### Fixed
- **The NS1081 hung after waking the drive from standby**, failing every read until it was replugged. When IDLE IMMEDIATE (or IDLE) wakes the drive from standby, it now shows BSY for 50 µs (`cfg::WAKE_BUSY_US`) and then completes with an interrupt, as a CF card does.
  - The adapter reads Status straight after the command, so an interrupt raised at once was cleared before it waited for it.
  - Found by listening to a CF card on the adapter's 44-pin header with the listen build.
  - After the wake the adapter waits about 2.5 s, as it does with the CF card, then reads normally.

### Verified on the rig
- **Slice 3 passes:** a full 64 MB read (0.65 MB/s) and random reads, with no mismatches, resets or errors.
- With the raw bus trace off, `read_max_ns` is about 1.9 µs. The 7–10 µs in 0.5.2 was measured with the trace on, which records every access on core 1.

### Known problems
- With the raw bus trace (`t`) on, one full-disk read stalled: the adapter set nIEN, waited 30 s, then reset the drive, and later dropped off USB. The trace slows core 0's sector fetches. Keep it off for data tests.
- `read_max_ns` (about 1.9 µs) is still over the slice 1 limit of 800 ns.

## [0.5.2] - 2026-10-23

### Fixed
- **An 18 µs stall on core 1 at every hardware reset.** Restoring the default geometry recomputed the IDENTIFY checksum over all 512 bytes, from flash. It now adjusts the checksum for the five changed words, in RAM. INITIALIZE DEVICE PARAMETERS benefits too.
- **The PIO program restarts when the host releases RESET#**, with empty FIFOs and DD and IORDY released. When the host is unplugged or powering up, its strobes float low. A write-path sample with DIOR# also low got an answer the PIO never pulled, which would leave every later read one answer behind.

### Changed
- Console `s`: `loop_max_ns` is now `read_max_ns`, the longest a read waited for its answer. It is measured from the last time core 1 saw the FIFO empty. Console `r` resets it.

### Known problems
- `read_max_ns` reports 7–10 µs on the rig, mostly during the adapter's register probe, although no read was answered after its strobe ended (0 in about 23,000). Not yet explained; a logic analyser on DIOR#, IORDY and CS0# should settle it.
- After the NS1081 puts the drive in standby and wakes it (IDLE IMMEDIATE), it fails every read without touching the bus, until it is replugged. The drive answers both commands with status 50.

## [0.5.1] - 2026-10-23

First run on hardware: the NS1081 adapter detects the drive build, and macOS sees the 64 MB disk.

### Fixed
- **Core 1 was too slow to answer reads on hardware** (up to 37 µs, against a budget of about 1 µs). The adapter gave up on reads, and the bus program fell out of step with the bus.
  - Core 1's per-access code ran from flash, and core 0 kept evicting it from the shared cache. It now runs from RAM (`CORE1_RAM`, `src/core1_ram.h`).
  - Arduino-Pico's periodic SysTick interrupt on core 1 is turned off.
  - Core 1 now checks the bus FIFO between each step of its loop, not once per pass.
  - `loop_max_ns` now reports the longest gap between those checks, which is how long a read can wait to be seen: about 650 ns (it was a whole pass).

### Changed
- Docs: the adapter is USB-powered (its brick only powers a drive), so the power-order rule is about its USB cable. `uhubctl` doesn't cut VBUS on the rig's hub, so only a physical replug restarts the adapter's IDE side.

## [0.5.0] - 2026-10-22

### Added
- **Activity classification (drive build), for the HDD Synth to choose a sequential or a random sound.**
  - Each media command is sequential (it carries on one of 4 tracked streams) or a seek, with its distance. The state comes from the share of seeks over a 250 ms window, with hysteresis and a 100 ms dwell.
  - The first command of a burst is neutral, and the drive wakes as Sequential and needs 3 commands to call Random.
  - Idle comes 150 ms after the last command ends.
  - Printed as `ACT` lines on each change; `s` shows the totals and the state.
  - See `docs/activity.md`.
- Console `m` prints a `MARK` timestamp, so tests can line phases up with the trace.
- `test/tools/classify_trace`: replays a recorded trace through the classifier, for tuning.
- Rig test `-m activity`: sequential, idle, random and interleaved phases from the Mac, each at least 90% in the right state.

## [0.4.0] - 2026-10-22

### Added
- A solder-bridge test, run from the console in both builds with the IDE cable unplugged: `x` explains it, then `Y` within 10 s runs it.
  - Every bus pin and its header neighbours (GPIO 0–3, 31) are pulled up; each bus pin in turn is driven low for 50 µs.
  - It reports `STUCK` (low with nothing driven: shorted to GND or the LED) and `SHORT` pairs, then reboots.
  - Core 1 is paused while it runs.
  - The analysis (`short_test.*`) is host-tested against simulated boards with known faults.
- `docs/bringup.md`: the checklist for hardware day, from continuity checks to slice 3.

## [0.3.0] - 2026-10-22

### Added
- The housekeeping commands that USB bridges and BIOSes send while setting a drive up, pulled forward from slice 6 so a bridge doesn't give up on the drive during setup:
  - SET FEATURES "set transfer mode": accepts PIO default (00h) and PIO flow-control mode 0 (08h); aborts DMA, faster PIO, IORDY off and the other subcommands;
  - INITIALIZE DEVICE PARAMETERS: sets the CHS translation used by CHS reads and reported in IDENTIFY words 54–58 (checksum updated); kept across a soft reset, reset by a hard one;
  - READ VERIFY (range check, no data), SEEK (70h–7Fh) and RECALIBRATE (10h–1Fh);
  - STANDBY, IDLE (and their immediate forms) and CHECK POWER MODE, in both the current and the ATA-1 opcodes;
  - FLUSH CACHE.
- SET MULTIPLE MODE is explicitly aborted, since IDENTIFY offers no multiple mode.
- A virtual-host test of a bridge's setup sequence.

## [0.2.0] - 2026-10-22

### Added
- **The drive build (`bb48_drive`)**, for slices 1–3. Core 1 serves the bus with `ide_bus` and runs the ATA device. Core 0 fetches sectors from the generated 64 MB disk through a cross-core mailbox, and never blocks on USB serial.
  - It traces commands as `CMD`/`DONE` lines, with LBA, count, status, error and duration.
  - Console `t` adds raw register accesses; `r` resets the loop-time maximum.
  - `s` now reports `loop_max_ns`: core 1's longest loop pass, measured with the M33 cycle counter.
- READ SECTORS (and its no-retry alias) in `ata_device`:
  - core 1 shows BSY while core 0 fetches each sector, then one DRQ block and one interrupt per sector;
  - a sector count of 0 means 256;
  - LBA and default-geometry CHS addressing;
  - IDNF for out-of-range addresses, before any data is sent;
  - UNC when a fetch fails;
  - stale fetches after a reset are ignored.
- `BlockSource` with a `GeneratedDisk` backend, and `FetchMailbox`, the core 1 ↔ core 0 handoff. A two-thread test is clean under ThreadSanitizer.
- Rig tests for slice 1 (gets past detection, plus core 1's loop time). The slice 2 and 3 tests now check the drive's trace as well as the Mac's view, and every rig test skips unless the board runs the build it needs.
- `scripts/rig.sh` takes `PIO_ENV` to choose the build. CI builds both, and releases carry both UF2s.

### Added (no firmware change)
- `ata_device`: the drive's register file and command state machine for slices 1 and 2. It covers:
  - status and interrupts;
  - hard and soft reset with the ATA signature;
  - answering for the absent device 1;
  - IDENTIFY DEVICE and EXECUTE DEVICE DIAGNOSTIC;
  - aborting everything else.
  It is tested against a virtual host's start-up probe. Not yet on the bus.
- `ide_bus.pio`: the slice 1 bus program. It pulls IORDY low as soon as a chip select is asserted, answers reads with values from core 1, and captures writes. A co-simulation with a mode 0 host checks every timing it must meet. Built but not yet run by the firmware.
- `gen_disk`: the slice 3 test disk, computed from the LBA, in C++ and Python with shared known answers.
- Rig tests for slice 2 (capacity and IDENTIFY over repeated replugs) and slice 3 (full-disk and random reads through the raw device).
- GitHub Actions: builds the firmware and runs the no-hardware tests on every push; a `vX.Y.Z` tag publishes a release with the UF2.

## [0.1.0] - 2026-10-22

### Added
- Slice 0, listen only: a PIO program captures every IDE register access (DIOR#/DIOW#) without driving any pin.
- Core 1 timestamps each access and every RESET# edge into a trace ring; core 0 merges repeated accesses and prints the trace over USB serial.
- Serial console: `h` help, `p` pin levels, `s` stats, `b` reboot to bootloader.
- IDENTIFY DEVICE block builder for slice 2 (not yet served on the bus).
- Host tests:
  - C++ unit tests;
  - a PIO simulator that runs the real program against ATA mode 0 timings;
  - the slice 0 rig test with a manual or uhubctl replug.
