MaverickUK/HDDSynthPro/hardware/hddsynthpro.kicad_pcb

## KiCad design hardware/hddsynthpro.kicad_pcb (2026-11-12)

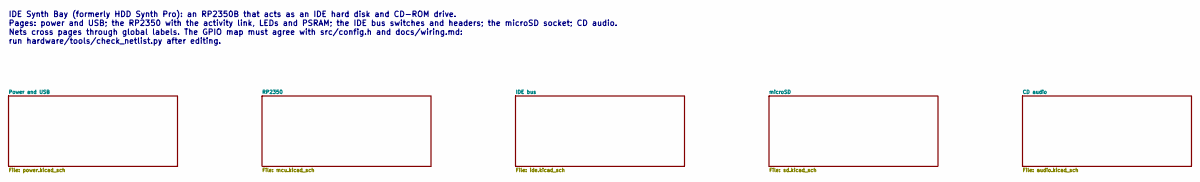
[picture p25: schematic hddsynthpro.kicad_sch, IDE Synth Bay]

Notes on the sheet:
IDE Synth Bay (formerly HDD Synth Pro): an RP2350B that acts as an IDE hard disk and CD-ROM drive. Pages: power and USB; the RP2350 with the activity link, LEDs and PSRAM; the IDE bus switches and headers; the microSD socket; CD audio. Nets cross pages through global labels. The GPIO map must agree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

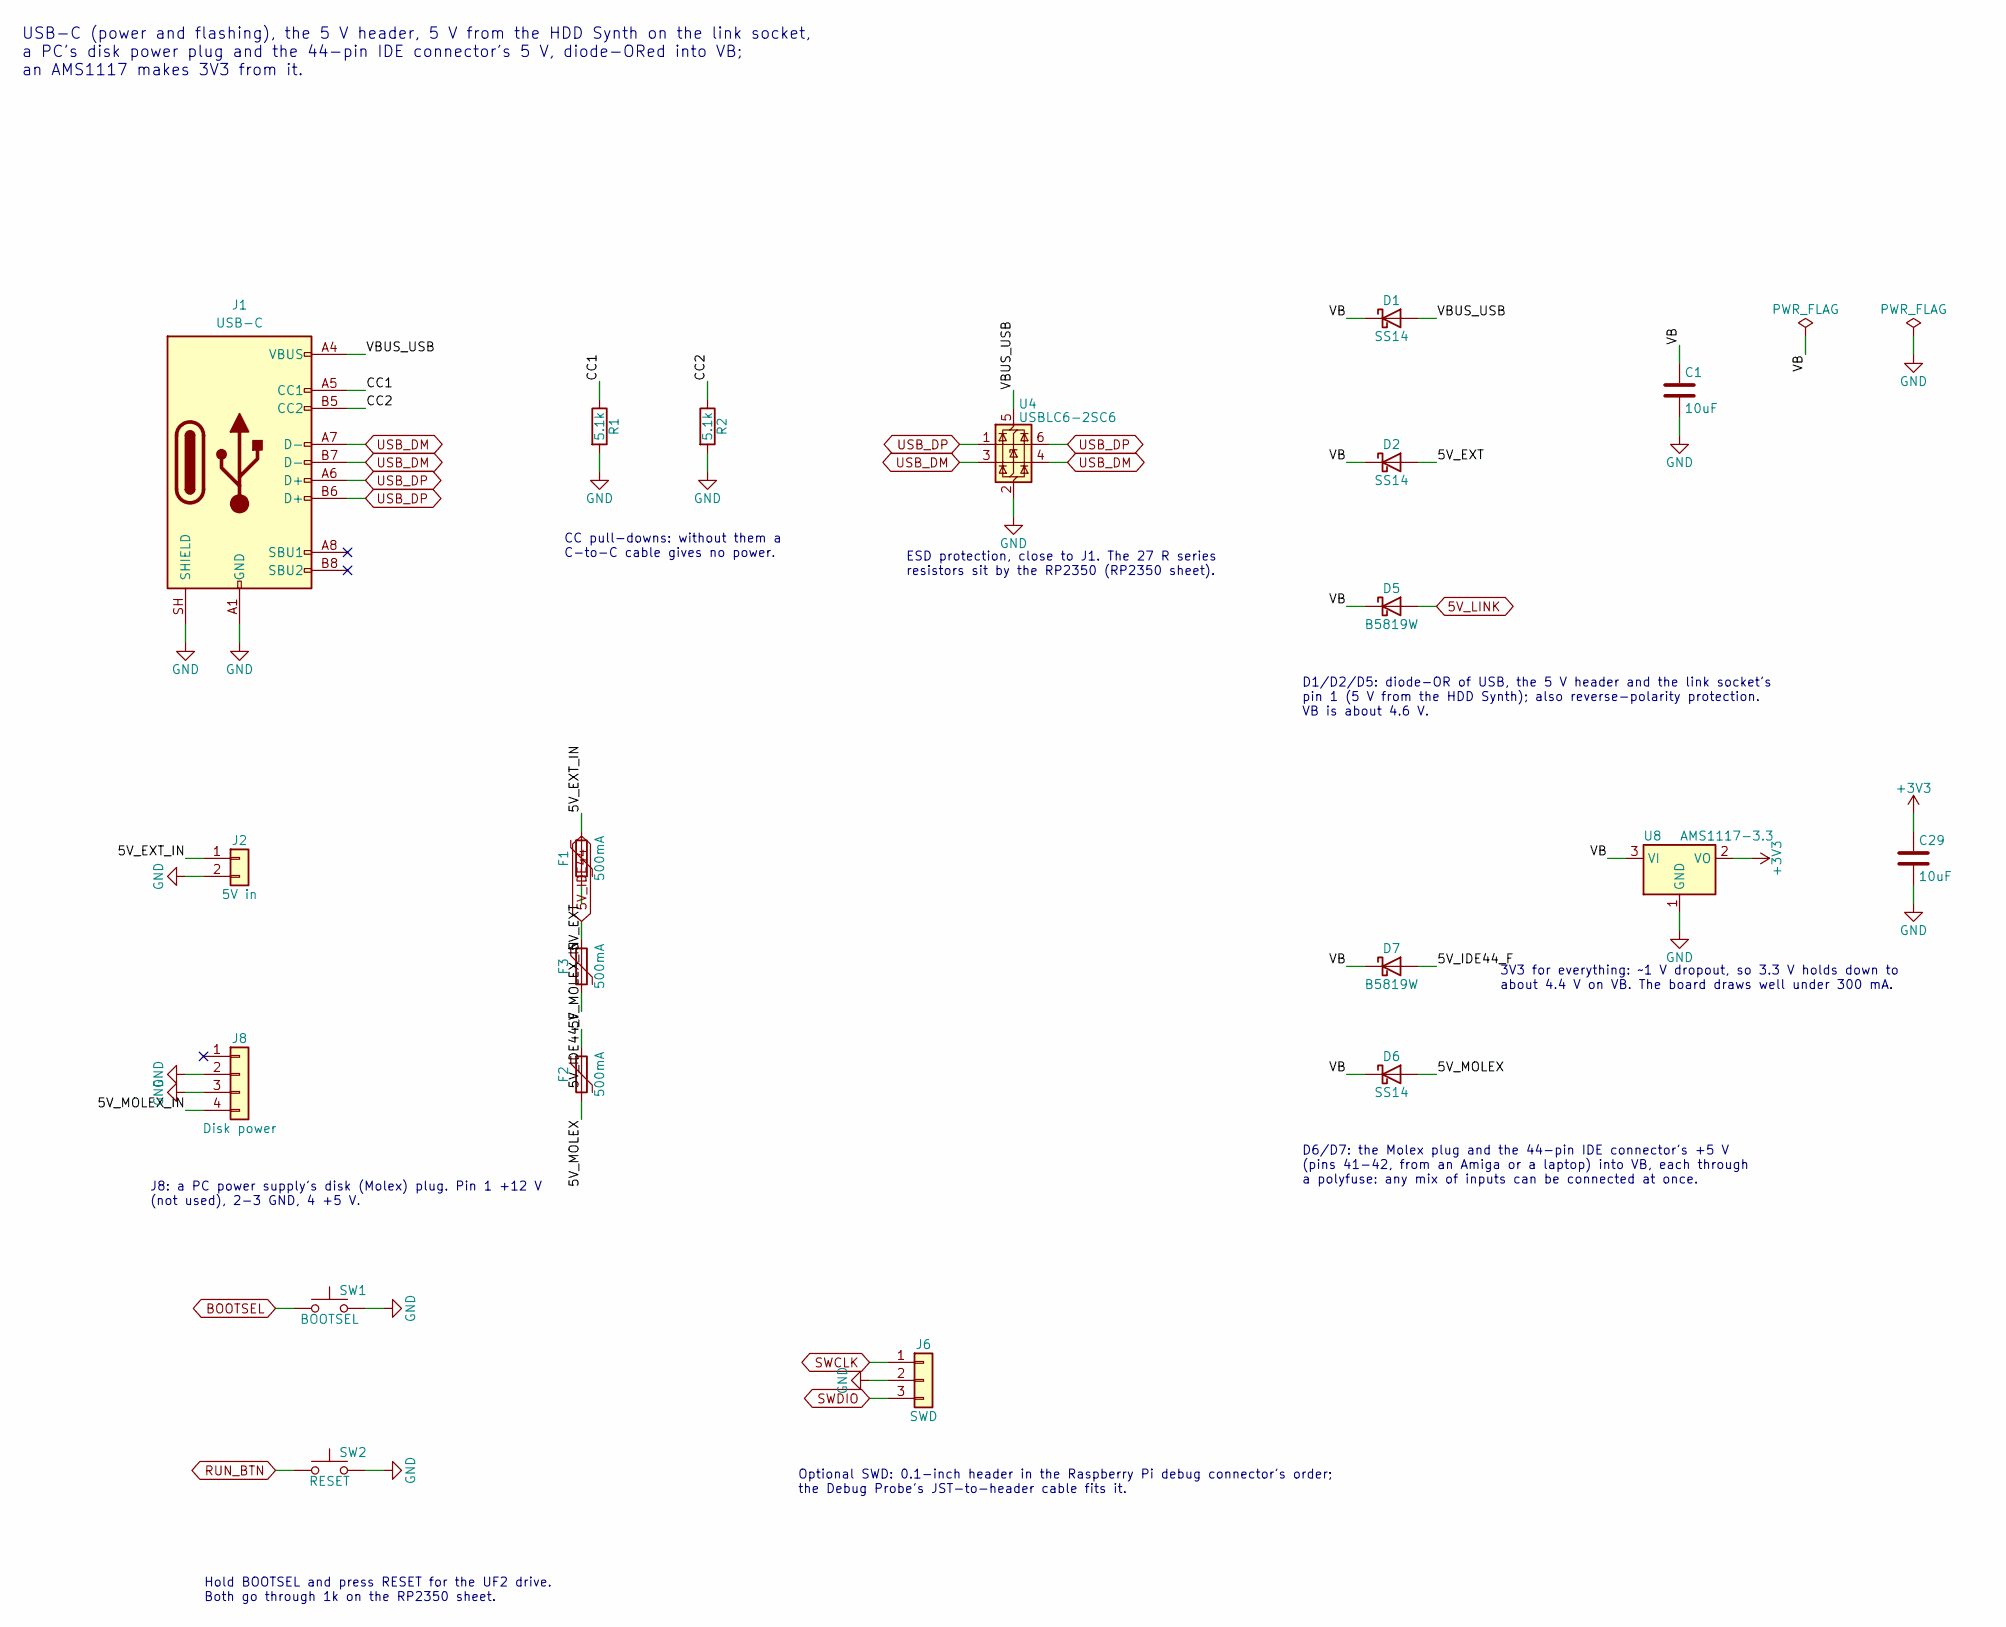
[picture p26: schematic power.kicad_sch, IDE Synth Bay: Power and USB]

Parts:
C1, C29: 10uF; C_0805_2012Metric; LCSC C15850
D1, D2, D6: SS14; D_SMA; LCSC C2480
D5, D7: B5819W; D_SOD-123; LCSC C8598
F1, F2, F3: 500mA; Fuse_1206_3216Metric; LCSC C19193043
J1: USB-C; USB_C_Receptacle_HRO_TYPE-C-31-M-12_OneMaskOpening; MPN HRO TYPE-C-31-M-12; LCSC C165948
J2: 5V in; JST_XH_B2B-XH-A_1x02_P2.50mm_Vertical; LCSC C158012
J6: SWD; PinHeader_1x03_P2.54mm_Vertical; LCSC C2937625
J8: Disk power; Molex_8981_1x04_P5.08mm_Vertical; MPN Molex 8981 style, 4 pins, 5.08 mm
R1, R2: 5.1k; R_0603_1608Metric; LCSC C23186
SW1: BOOTSEL; SW_Push_1P1T_XKB_TS-1187A; LCSC C318884
SW2: RESET; SW_Push_1P1T_XKB_TS-1187A; LCSC C318884
U4: USBLC6-2SC6; SOT-23-6; LCSC C2687116
U8: AMS1117-3.3; SOT-223-3_TabPin2; LCSC C6186

Connections:
5V_IDE44: F3.1; also elsewhere on the board
5V_LINK: D5.2 (A); also elsewhere on the board
+3V3: C29.1, U8.2 (VO); also elsewhere on the board
/Power and USB/5V_EXT: D2.2 (A), F1.2
/Power and USB/5V_EXT_IN: F1.1, J2.1
/Power and USB/5V_IDE44_F: D7.2 (A), F3.2
/Power and USB/5V_MOLEX: D6.2 (A), F2.2
/Power and USB/5V_MOLEX_IN: F2.1, J8.4
/Power and USB/CC1: J1.A5 (CC1), R1.1
/Power and USB/CC2: J1.B5 (CC2), R2.1
/Power and USB/VB: C1.1, D1.1 (K), D2.1 (K), D5.1 (K), D6.1 (K), D7.1 (K), U8.3 (VI)
/Power and USB/VBUS_USB: D1.2 (A), J1.A4 (VBUS), J1.A9 (VBUS), J1.B4 (VBUS), J1.B9 (VBUS), U4.5 (VBUS)
BOOTSEL: SW1.1; also elsewhere on the board
GND: C1.2, C29.2, J1.A1 (GND), J1.A12 (GND), J1.B1 (GND), J1.B12 (GND), J1.SH (SHIELD), J2.2, J6.2, J8.2, J8.3, R1.2, R2.2, SW1.2, SW2.2, U4.2 (GND), U8.1 (GND); also elsewhere on the board
RUN_BTN: SW2.1; also elsewhere on the board
SWCLK: J6.1; also elsewhere on the board
SWDIO: J6.3; also elsewhere on the board
USB_DM: J1.A7 (D-), J1.B7 (D-), U4.3 (I/O2), U4.4 (I/O2); also elsewhere on the board
USB_DP: J1.A6 (D+), J1.B6 (D+), U4.1 (I/O1), U4.6 (I/O1); also elsewhere on the board

Notes on the sheet:
USB-C (power and flashing), the 5 V header, 5 V from the HDD Synth on the link socket, a PC's disk power plug and the 44-pin IDE connector's 5 V, diode-ORed into VB; an AMS1117 makes 3V3 from it.
CC pull-downs: without them a C-to-C cable gives no power.
ESD protection, close to J1. The 27 R series resistors sit by the RP2350 (RP2350 sheet).
D1/D2/D5: diode-OR of USB, the 5 V header and the link socket's pin 1 (5 V from the HDD Synth); also reverse-polarity protection. VB is about 4.6 V.
J8: a PC power supply's disk (Molex) plug. Pin 1 +12 V (not used), 2-3 GND, 4 +5 V.
D6/D7: the Molex plug and the 44-pin IDE connector's +5 V (pins 41-42, from an Amiga or a laptop) into VB, each through a polyfuse: any mix of inputs can be connected at once.
3V3 for everything: ~1 V dropout, so 3.3 V holds down to about 4.4 V on VB. The board draws well under 300 mA.
Hold BOOTSEL and press RESET for the UF2 drive. Both go through 1k on the RP2350 sheet.
Optional SWD: 0.1-inch header in the Raspberry Pi debug connector's order; the Debug Probe's JST-to-header cable fits it.

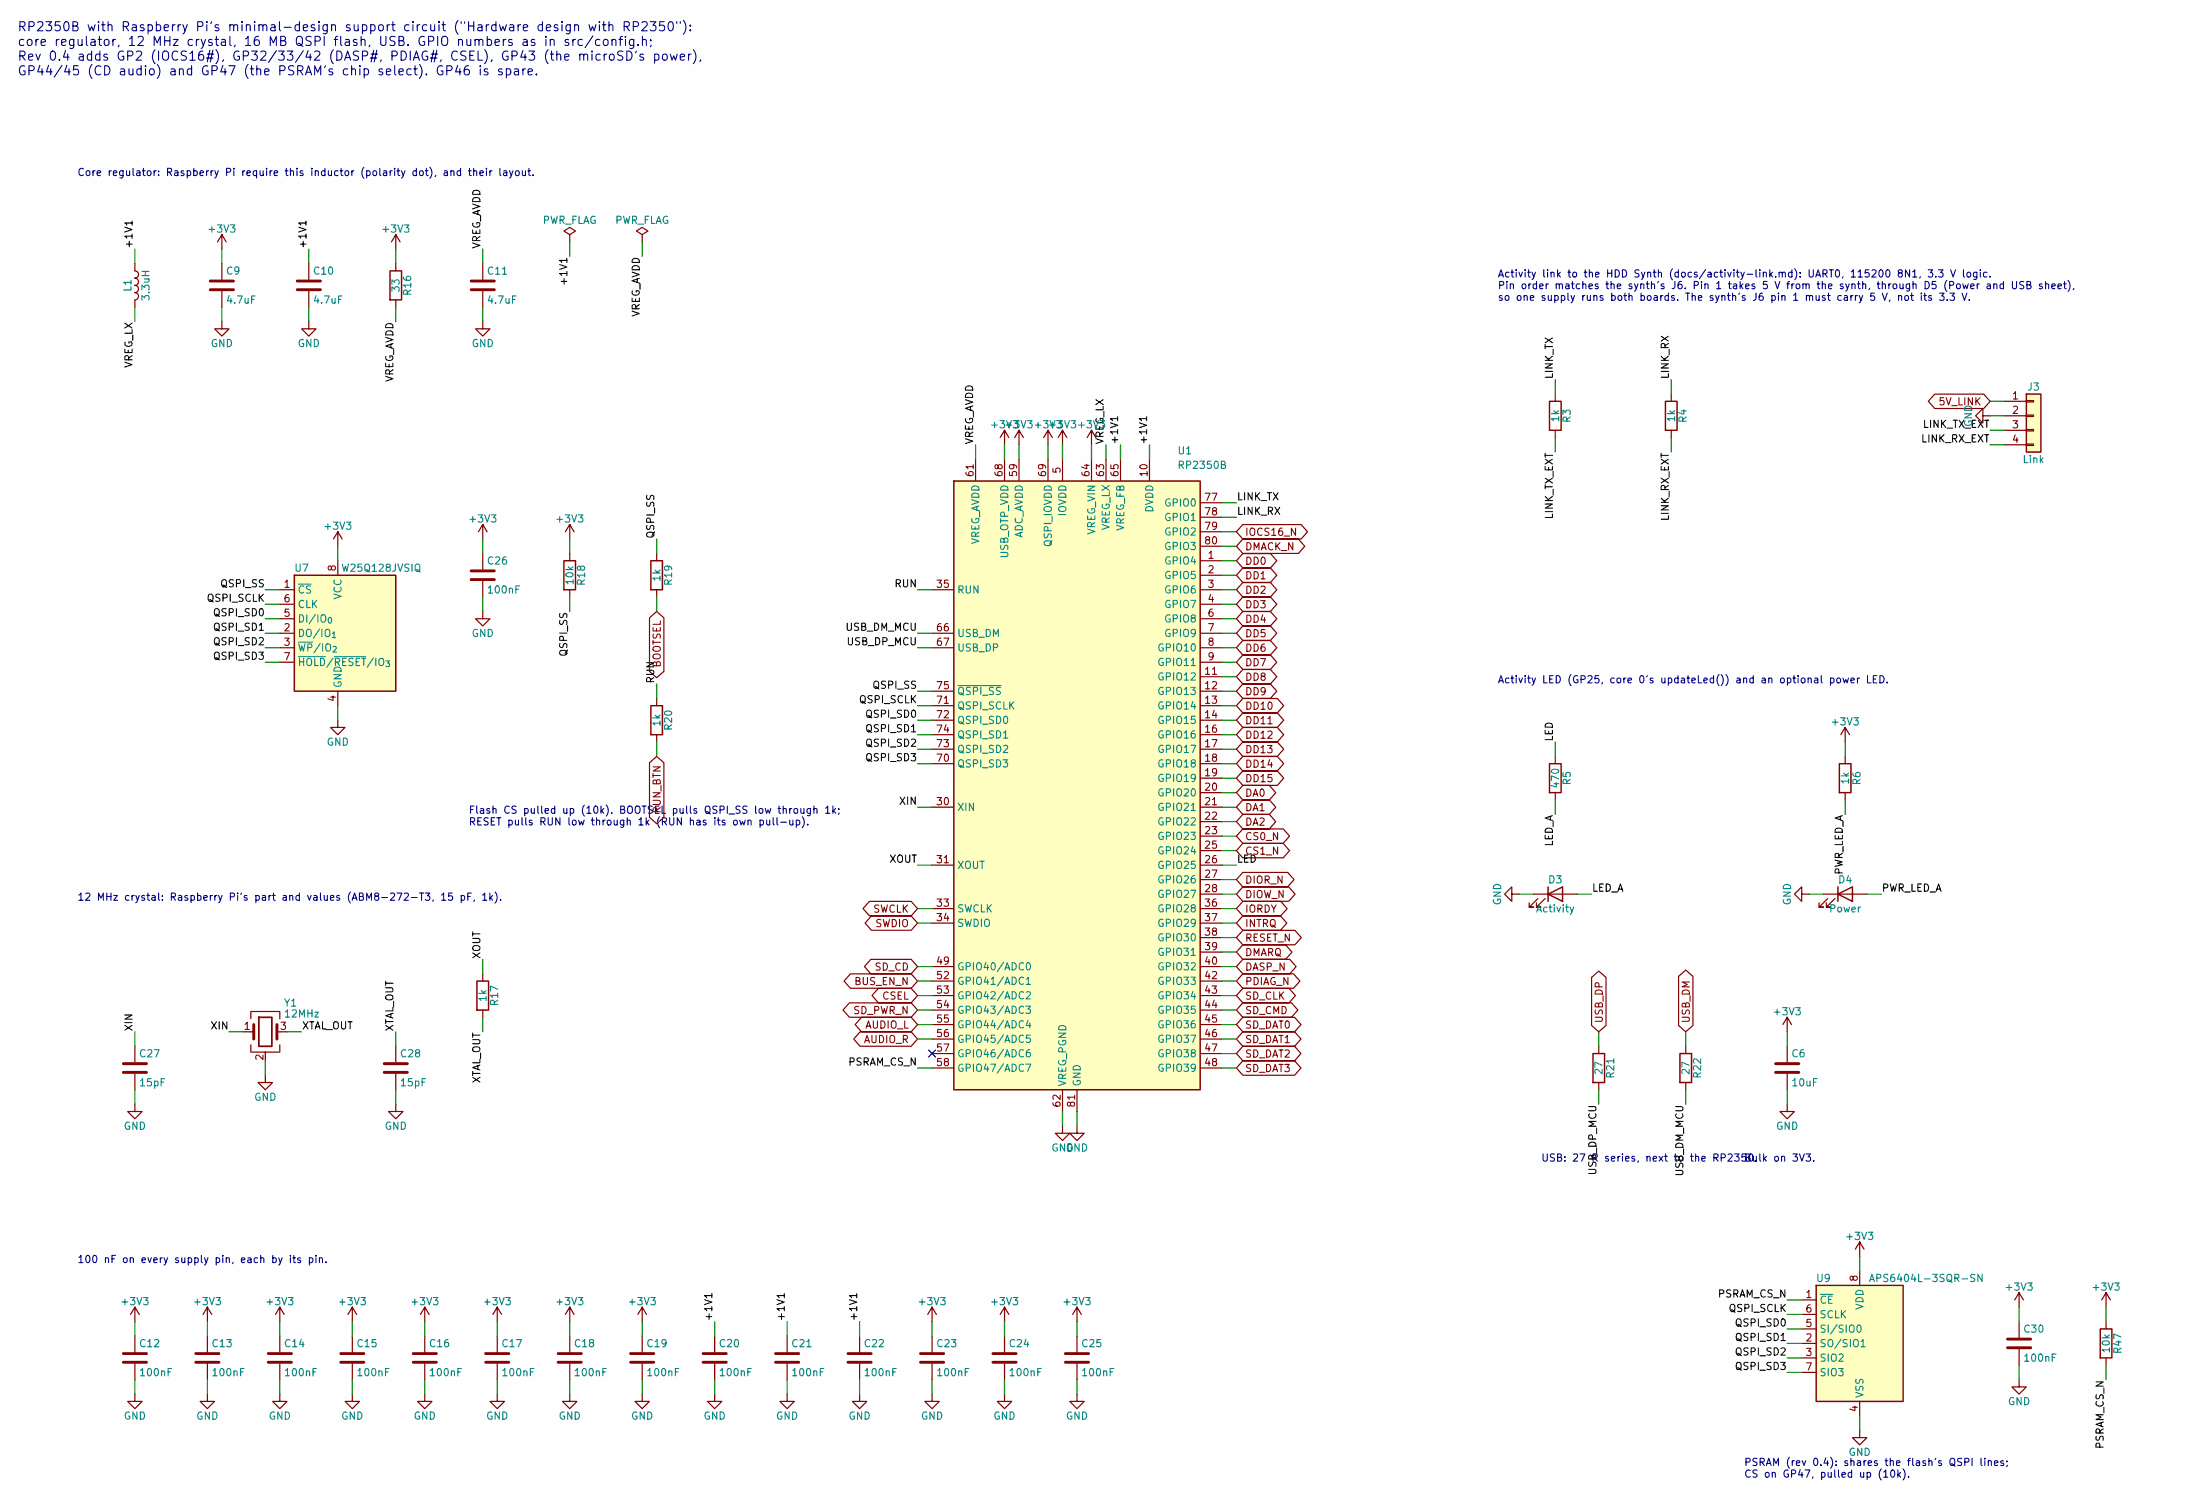
[picture p27: schematic mcu.kicad_sch, IDE Synth Bay: RP2350]

Parts:
C6: 10uF; C_0805_2012Metric; LCSC C15850
C9, C10: 4.7uF; C_0402_1005Metric_RPi_Wide; LCSC C23733
C11: 4.7uF; C_0402_1005Metric; LCSC C23733
C12, C13, C14, C15, C16, C17, C18, C19, C20, C21, C22, C23, C24, C25, C26, C30: 100nF; C_0402_1005Metric; LCSC C1525
C27, C28: 15pF; C_0402_1005Metric; LCSC C1548
D3: Activity; LED_0805_2012Metric; LCSC C2297
D4: Power; LED_0805_2012Metric; LCSC C84256
J3: Link; PinSocket_1x04_P2.54mm_Vertical; LCSC C2718488
L1: 3.3uH; L_Abracon_AOTA-B201610S3R3; MPN Abracon AOTA-B201610S3R3-101-T; LCSC C42411119
R3, R4, R6, R20: 1k; R_0603_1608Metric; LCSC C21190
R5: 470; R_0603_1608Metric; LCSC C23179
R16: 33; R_0402_1005Metric; LCSC C25105
R17, R19: 1k; R_0402_1005Metric; LCSC C11702
R18, R47: 10k; R_0402_1005Metric; LCSC C25744
R21, R22: 27; R_0402_1005Metric; LCSC C25100
U1: RP2350B; QFN-80-1EP_10x10mm_P0.4mm_EP3.4x3.4mm_ThermalVias_OneMaskOp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; LCSC C42415655
U7: W25Q128JVSIQ; SOIC-8_5.3x5.3mm_P1.27mm; LCSC C97521
U9: APS6404L-3SQR-SN; SOIC-8_3.9x4.9mm_P1.27mm; LCSC C5333729
Y1: 12MHz; Crystal_SMD_3225-4Pin_3.2x2.5mm; MPN Abracon ABM8-272-T3; LCSC C20625731

Connections:
5V_LINK: J3.1; also elsewhere on the board
+3V3: C6.1, C9.1, C12.1, C13.1, C14.1, C15.1, C16.1, C17.1, C18.1, C19.1, C23.1, C24.1, C25.1, C26.1, C30.1, R6.1, R16.1, R18.1, R47.1, U1.5 (IOVDD), U1.15 (IOVDD), U1.24 (IOVDD), U1.29 (IOVDD), U1.41 (IOVDD), U1.50 (IOVDD), U1.59 (ADC_AVDD), U1.60 (IOVDD), U1.64 (VREG_VIN), U1.68 (USB_OTP_VDD), U1.69 (QSPI_IOVDD), U1.76 (IOVDD), U7.8 (VCC), U9.8 (VDD); also elsewhere on the board
/RP2350/+1V1: C10.1, C20.1, C21.1, C22.1, L1.1, U1.10 (DVDD), U1.32 (DVDD), U1.51 (DVDD), U1.65 (VREG_FB)
/RP2350/LED: R5.1, U1.26 (GPIO25)
/RP2350/LED_A: D3.2 (A), R5.2
/RP2350/LINK_RX: R4.1, U1.78 (GPIO1)
/RP2350/LINK_RX_EXT: J3.4, R4.2
/RP2350/LINK_TX: R3.1, U1.77 (GPIO0)
/RP2350/LINK_TX_EXT: J3.3, R3.2
/RP2350/PSRAM_CS_N: R47.2, U1.58 (GPIO47/ADC7), U9.1 (~CE)
/RP2350/PWR_LED_A: D4.2 (A), R6.2
/RP2350/QSPI_SCLK: U1.71 (QSPI_SCLK), U7.6 (CLK), U9.6 (SCLK)
/RP2350/QSPI_SD0: U1.72 (QSPI_SD0), U7.5 (DI/IO_{0}), U9.5 (SI/SIO0)
/RP2350/QSPI_SD1: U1.74 (QSPI_SD1), U7.2 (DO/IO_{1}), U9.2 (SO/SIO1)
/RP2350/QSPI_SD2: U1.73 (QSPI_SD2), U7.3 (~WP/IO_{2}), U9.3 (SIO2)
/RP2350/QSPI_SD3: U1.70 (QSPI_SD3), U7.7 (~HOLD/~RESET/IO_{3}), U9.7 (SIO3)
/RP2350/QSPI_SS: R18.2, R19.1, U1.75 (~QSPI_SS), U7.1 (~CS)
/RP2350/RUN: R20.1, U1.35 (RUN)
/RP2350/USB_DM_MCU: R22.2, U1.66 (USB_DM)
/RP2350/USB_DP_MCU: R21.2, U1.67 (USB_DP)
/RP2350/VREG_AVDD: C11.1, R16.2, U1.61 (VREG_AVDD)
/RP2350/VREG_LX: L1.2, U1.63 (VREG_LX)
/RP2350/XIN: C27.1, U1.30 (XIN), Y1.1
/RP2350/XOUT: R17.1, U1.31 (XOUT)
/RP2350/XTAL_OUT: C28.1, R17.2, Y1.3
AUDIO_L: U1.55 (GPIO44/ADC4); also elsewhere on the board
AUDIO_R: U1.56 (GPIO45/ADC5); also elsewhere on the board
BOOTSEL: R19.2; also elsewhere on the board
BUS_EN_N: U1.52 (GPIO41/ADC1); also elsewhere on the board
CS0_N: U1.23 (GPIO23); also elsewhere on the board
CS1_N: U1.25 (GPIO24); also elsewhere on the board
CSEL: U1.53 (GPIO42/ADC2); also elsewhere on the board
DA0: U1.20 (GPIO20); also elsewhere on the board
DA1: U1.21 (GPIO21); also elsewhere on the board
DA2: U1.22 (GPIO22); also elsewhere on the board
DASP_N: U1.40 (GPIO32); also elsewhere on the board
DD0: U1.1 (GPIO4); also elsewhere on the board
DD1: U1.2 (GPIO5); also elsewhere on the board
DD2: U1.3 (GPIO6); also elsewhere on the board
DD3: U1.4 (GPIO7); also elsewhere on the board
DD4: U1.6 (GPIO8); also elsewhere on the board
DD5: U1.7 (GPIO9); also elsewhere on the board
DD6: U1.8 (GPIO10); also elsewhere on the board
DD7: U1.9 (GPIO11); also elsewhere on the board
DD8: U1.11 (GPIO12); also elsewhere on the board
DD9: U1.12 (GPIO13); also elsewhere on the board
DD10: U1.13 (GPIO14); also elsewhere on the board
DD11: U1.14 (GPIO15); also elsewhere on the board
DD12: U1.16 (GPIO16); also elsewhere on the board
DD13: U1.17 (GPIO17); also elsewhere on the board
DD14: U1.18 (GPIO18); also elsewhere on the board
DD15: U1.19 (GPIO19); also elsewhere on the board
DIOR_N: U1.27 (GPIO26); also elsewhere on the board
DIOW_N: U1.28 (GPIO27); also elsewhere on the board
DMACK_N: U1.80 (GPIO3); also elsewhere on the board
DMARQ: U1.39 (GPIO31); also elsewhere on the board
GND: C6.2, C9.2, C10.2, C11.2, C12.2, C13.2, C14.2, C15.2, C16.2, C17.2, C18.2, C19.2, C20.2, C21.2, C22.2, C23.2, C24.2, C25.2, C26.2, C27.2, C28.2, C30.2, D3.1 (K), D4.1 (K), J3.2, U1.62 (VREG_PGND), U1.81 (GND), U7.4 (GND), U9.4 (VSS), Y1.2 (G), Y1.4 (G); also elsewhere on the board
INTRQ: U1.37 (GPIO29); also elsewhere on the board
IOCS16_N: U1.79 (GPIO2); also elsewhere on the board
IORDY: U1.36 (GPIO28); also elsewhere on the board
PDIAG_N: U1.42 (GPIO33); also elsewhere on the board
RESET_N: U1.38 (GPIO30); also elsewhere on the board
RUN_BTN: R20.2; also elsewhere on the board
SD_CD: U1.49 (GPIO40/ADC0); also elsewhere on the board
SD_CLK: U1.43 (GPIO34); also elsewhere on the board
SD_CMD: U1.44 (GPIO35); also elsewhere on the board
SD_DAT0: U1.45 (GPIO36); also elsewhere on the board
SD_DAT1: U1.46 (GPIO37); also elsewhere on the board
SD_DAT2: U1.47 (GPIO38); also elsewhere on the board
SD_DAT3: U1.48 (GPIO39); also elsewhere on the board
SD_PWR_N: U1.54 (GPIO43/ADC3); also elsewhere on the board
SWCLK: U1.33 (SWCLK); also elsewhere on the board
SWDIO: U1.34 (SWDIO); also elsewhere on the board
USB_DM: R22.1; also elsewhere on the board
USB_DP: R21.1; also elsewhere on the board

Notes on the sheet:
RP2350B with Raspberry Pi's minimal-design support circuit ("Hardware design with RP2350"): core regulator, 12 MHz crystal, 16 MB QSPI flash, USB. GPIO numbers as in src/config.h; Rev 0.4 adds GP2 (IOCS16#), GP32/33/42 (DASP#, PDIAG#, CSEL), GP43 (the microSD's power), GP44/45 (CD audio) and GP47 (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
Core regulator: Raspberry Pi require this inductor (polarity dot), and their layout.
100 nF on every supply pin, each by its pin.
12 MHz crystal: Raspberry Pi's part and values (ABM8-272-T3, 15 pF, 1k).
PSRAM (rev 0.4): shares the flash's QSPI lines; CS on GP47, pulled up (10k).
Flash CS pulled up (10k). BOOTSEL pulls QSPI_SS low through 1k; RESET pulls RUN low through 1k (RUN has its own pull-up).
USB: 27 R series, next to the RP2350.
Bulk on 3V3.
Activity link to the HDD Synth (docs/activity-link.md): UART0, 115200 8N1, 3.3 V logic. Pin order matches the synth's J6. Pin 1 takes 5 V from the synth, through D5 (Power and USB sheet), so one supply runs both boards. The synth's J6 pin 1 must carry 5 V, not its 3.3 V.
Activity LED (GP25, core 0's updateLed()) and an optional power LED.

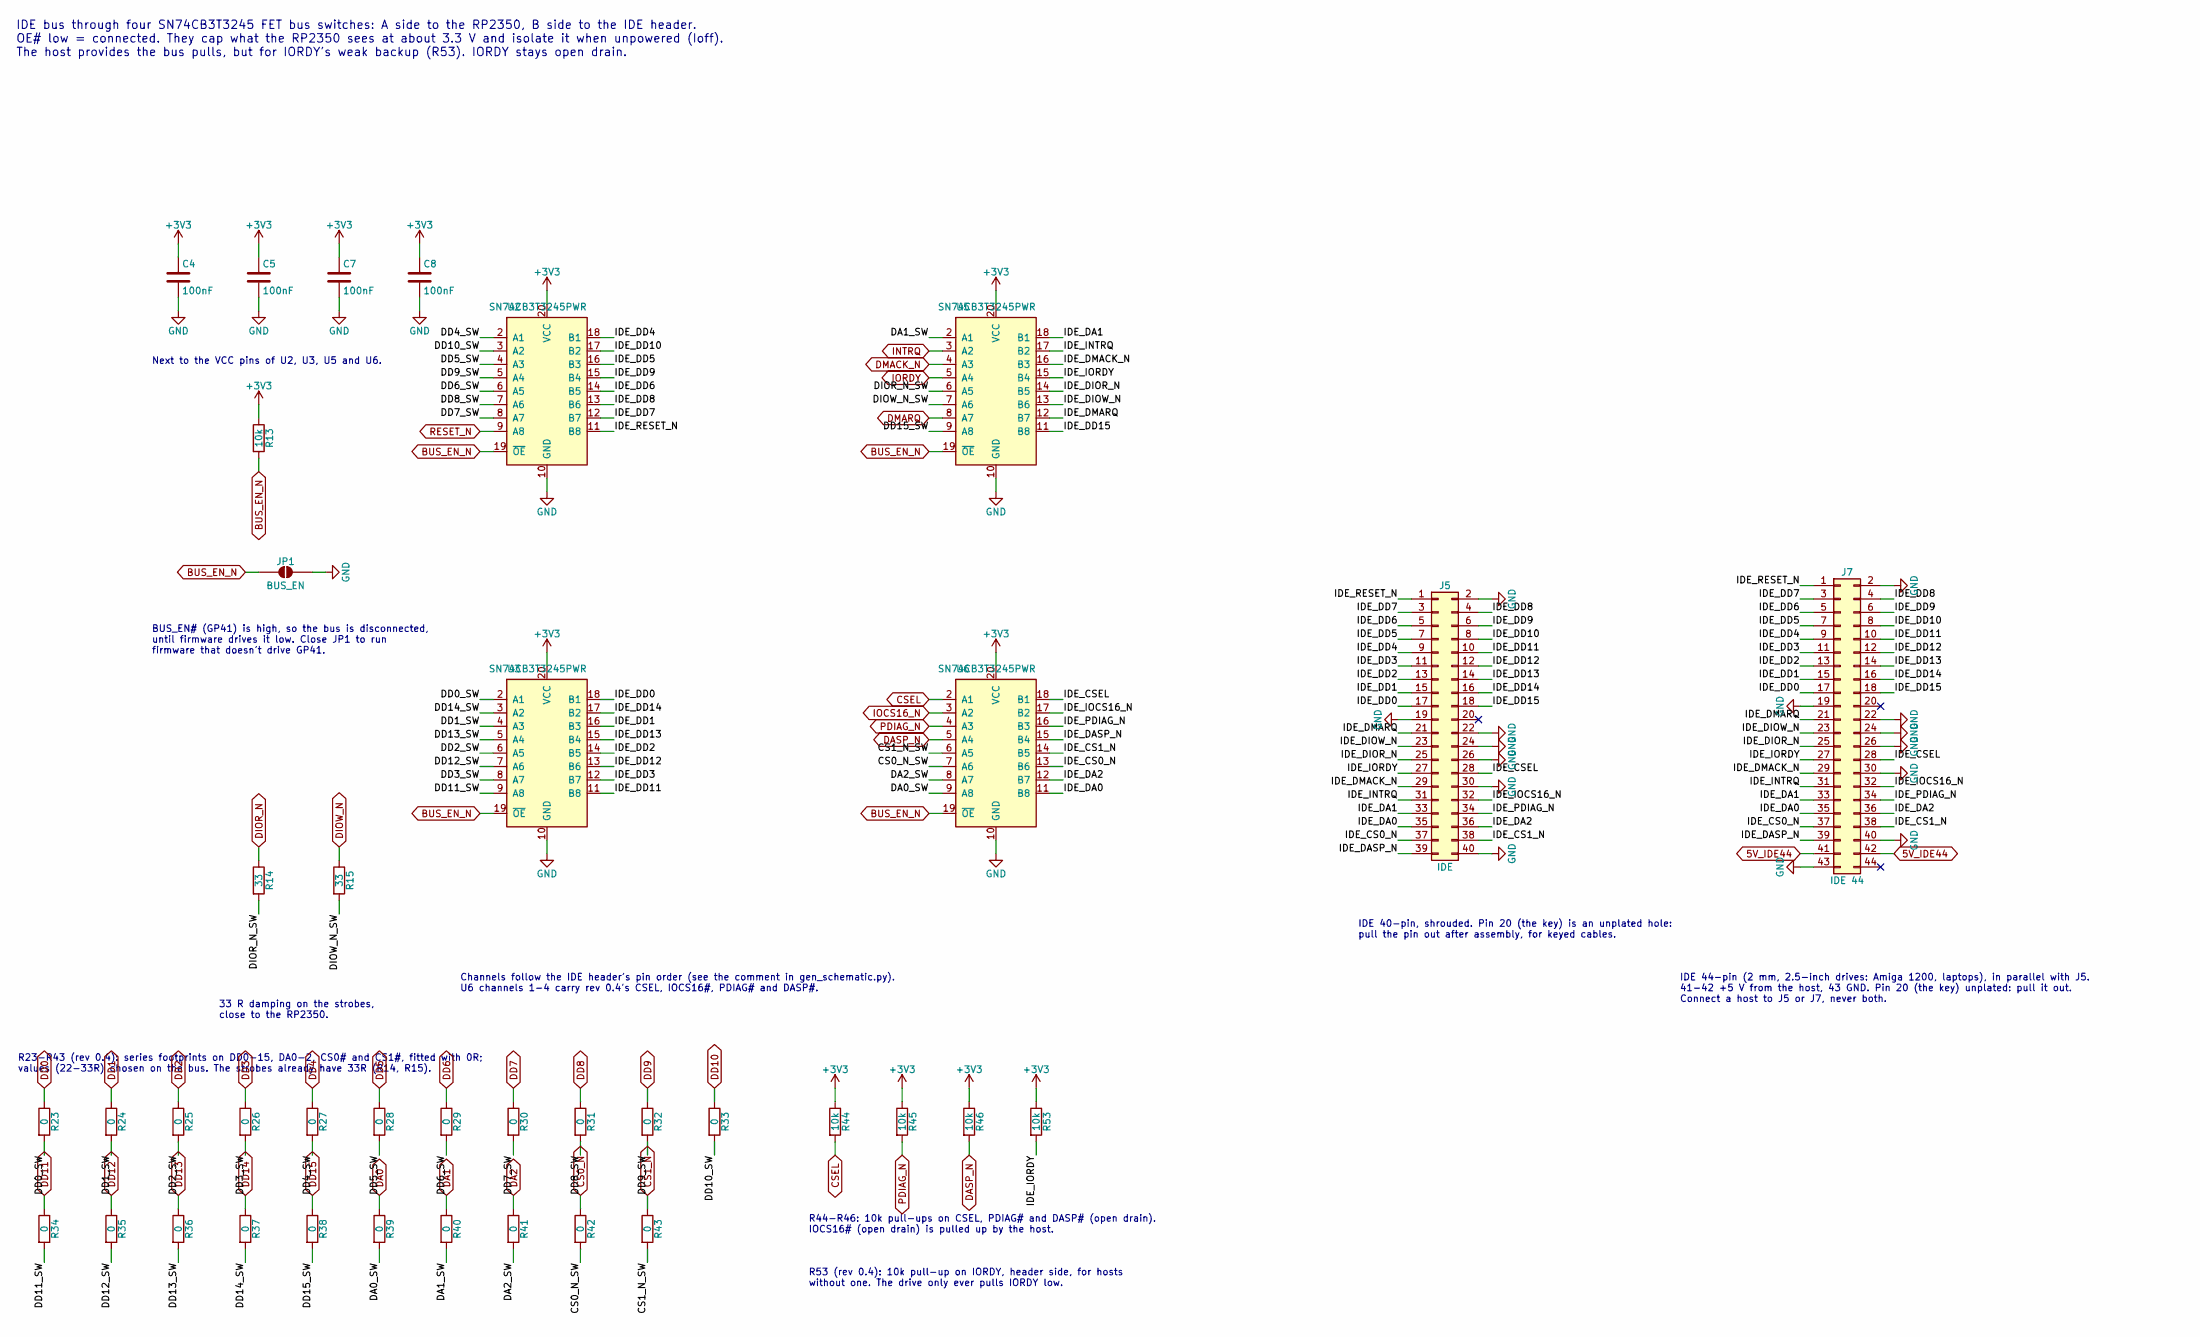
[picture p28: schematic ide.kicad_sch, IDE Synth Bay: IDE bus]

Parts:
C4, C5, C7, C8: 100nF; C_0603_1608Metric; LCSC C14663
J5: IDE; IDC-Header_2x20_P2.54mm_Vertical_Pin20Unplated; LCSC C19193815
J7: IDE 44; PinHeader_2x22_P2.00mm_Vertical_Pin20Unplated; LCSC C5371836
JP1: BUS_EN; SolderJumper-2_P1.3mm_Open_RoundedPad1.0x1.5mm
R13: 10k; R_0603_1608Metric; LCSC C25804
R14, R15: 33; R_0603_1608Metric; LCSC C23140
R23, R24, R25, R26, R27, R28, R29, R30, R31, R32, R33, R34, R35, R36, R37, R38, R39, R40, R41, R42, R43: 0; R_0402_1005Metric; LCSC C17168
R44, R45, R46, R53: 10k; R_0402_1005Metric; LCSC C25744
U2, U3, U5, U6: SN74CB3T3245PWR; TSSOP-20_4.4x6.5mm_P0.65mm; LCSC C15298

Connections:
5V_IDE44: J7.41, J7.42; also elsewhere on the board
+3V3: C4.1, C5.1, C7.1, C8.1, R13.1, R44.1, R45.1, R46.1, R53.1, U2.20 (VCC), U3.20 (VCC), U5.20 (VCC), U6.20 (VCC); also elsewhere on the board
/IDE bus/CS0_N_SW: R42.2, U6.7 (A6)
/IDE bus/CS1_N_SW: R43.2, U6.6 (A5)
/IDE bus/DA0_SW: R39.2, U6.9 (A8)
/IDE bus/DA1_SW: R40.2, U5.2 (A1)
/IDE bus/DA2_SW: R41.2, U6.8 (A7)
/IDE bus/DD0_SW: R23.2, U3.2 (A1)
/IDE bus/DD1_SW: R24.2, U3.4 (A3)
/IDE bus/DD2_SW: R25.2, U3.6 (A5)
/IDE bus/DD3_SW: R26.2, U3.8 (A7)
/IDE bus/DD4_SW: R27.2, U2.2 (A1)
/IDE bus/DD5_SW: R28.2, U2.4 (A3)
/IDE bus/DD6_SW: R29.2, U2.6 (A5)
/IDE bus/DD7_SW: R30.2, U2.8 (A7)
/IDE bus/DD8_SW: R31.2, U2.7 (A6)
/IDE bus/DD9_SW: R32.2, U2.5 (A4)
/IDE bus/DD10_SW: R33.2, U2.3 (A2)
/IDE bus/DD11_SW: R34.2, U3.9 (A8)
/IDE bus/DD12_SW: R35.2, U3.7 (A6)
/IDE bus/DD13_SW: R36.2, U3.5 (A4)
/IDE bus/DD14_SW: R37.2, U3.3 (A2)
/IDE bus/DD15_SW: R38.2, U5.9 (A8)
/IDE bus/DIOR_N_SW: R14.2, U5.6 (A5)
/IDE bus/DIOW_N_SW: R15.2, U5.7 (A6)
/IDE bus/IDE_CS0_N: J5.37, J7.37, U6.13 (B6)
/IDE bus/IDE_CS1_N: J5.38, J7.38, U6.14 (B5)
/IDE bus/IDE_CSEL: J5.28, J7.28, U6.18 (B1)
/IDE bus/IDE_DA0: J5.35, J7.35, U6.11 (B8)
/IDE bus/IDE_DA1: J5.33, J7.33, U5.18 (B1)
/IDE bus/IDE_DA2: J5.36, J7.36, U6.12 (B7)
/IDE bus/IDE_DASP_N: J5.39, J7.39, U6.15 (B4)
/IDE bus/IDE_DD0: J5.17, J7.17, U3.18 (B1)
/IDE bus/IDE_DD1: J5.15, J7.15, U3.16 (B3)
/IDE bus/IDE_DD2: J5.13, J7.13, U3.14 (B5)
/IDE bus/IDE_DD3: J5.11, J7.11, U3.12 (B7)
/IDE bus/IDE_DD4: J5.9, J7.9, U2.18 (B1)
/IDE bus/IDE_DD5: J5.7, J7.7, U2.16 (B3)
/IDE bus/IDE_DD6: J5.5, J7.5, U2.14 (B5)
/IDE bus/IDE_DD7: J5.3, J7.3, U2.12 (B7)
/IDE bus/IDE_DD8: J5.4, J7.4, U2.13 (B6)
/IDE bus/IDE_DD9: J5.6, J7.6, U2.15 (B4)
/IDE bus/IDE_DD10: J5.8, J7.8, U2.17 (B2)
/IDE bus/IDE_DD11: J5.10, J7.10, U3.11 (B8)
/IDE bus/IDE_DD12: J5.12, J7.12, U3.13 (B6)
/IDE bus/IDE_DD13: J5.14, J7.14, U3.15 (B4)
/IDE bus/IDE_DD14: J5.16, J7.16, U3.17 (B2)
/IDE bus/IDE_DD15: J5.18, J7.18, U5.11 (B8)
/IDE bus/IDE_DIOR_N: J5.25, J7.25, U5.14 (B5)
/IDE bus/IDE_DIOW_N: J5.23, J7.23, U5.13 (B6)
/IDE bus/IDE_DMACK_N: J5.29, J7.29, U5.16 (B3)
/IDE bus/IDE_DMARQ: J5.21, J7.21, U5.12 (B7)
/IDE bus/IDE_INTRQ: J5.31, J7.31, U5.17 (B2)
/IDE bus/IDE_IOCS16_N: J5.32, J7.32, U6.17 (B2)
/IDE bus/IDE_IORDY: J5.27, J7.27, R53.2, U5.15 (B4)
/IDE bus/IDE_PDIAG_N: J5.34, J7.34, U6.16 (B3)
/IDE bus/IDE_RESET_N: J5.1, J7.1, U2.11 (B8)
BUS_EN_N: JP1.1 (A), R13.2, U2.19 (~OE), U3.19 (~OE), U5.19 (~OE), U6.19 (~OE); also elsewhere on the board
CS0_N: R42.1; also elsewhere on the board
CS1_N: R43.1; also elsewhere on the board
CSEL: R44.2, U6.2 (A1); also elsewhere on the board
DA0: R39.1; also elsewhere on the board
DA1: R40.1; also elsewhere on the board
DA2: R41.1; also elsewhere on the board
DASP_N: R46.2, U6.5 (A4); also elsewhere on the board
DD0: R23.1; also elsewhere on the board
DD1: R24.1; also elsewhere on the board
DD2: R25.1; also elsewhere on the board
DD3: R26.1; also elsewhere on the board
DD4: R27.1; also elsewhere on the board
DD5: R28.1; also elsewhere on the board
DD6: R29.1; also elsewhere on the board
DD7: R30.1; also elsewhere on the board
DD8: R31.1; also elsewhere on the board
DD9: R32.1; also elsewhere on the board
DD10: R33.1; also elsewhere on the board
DD11: R34.1; also elsewhere on the board
DD12: R35.1; also elsewhere on the board
DD13: R36.1; also elsewhere on the board
DD14: R37.1; also elsewhere on the board
DD15: R38.1; also elsewhere on the board
DIOR_N: R14.1; also elsewhere on the board
DIOW_N: R15.1; also elsewhere on the board
DMACK_N: U5.4 (A3); also elsewhere on the board
DMARQ: U5.8 (A7); also elsewhere on the board
GND: C4.2, C5.2, C7.2, C8.2, J5.2, J5.19, J5.22, J5.24, J5.26, J5.30, J5.40, J7.2, J7.19, J7.22, J7.24, J7.26, J7.30, J7.40, J7.43, JP1.2 (B), U2.10 (GND), U3.10 (GND), U5.10 (GND), U6.10 (GND); also elsewhere on the board
INTRQ: U5.3 (A2); also elsewhere on the board
IOCS16_N: U6.3 (A2); also elsewhere on the board
IORDY: U5.5 (A4); also elsewhere on the board
PDIAG_N: R45.2, U6.4 (A3); also elsewhere on the board
RESET_N: U2.9 (A8); also elsewhere on the board

Notes on the sheet:
IDE bus through four SN74CB3T3245 FET bus switches: A side to the RP2350, B side to the IDE header. OE# low = connected. They cap what the RP2350 sees at about 3.3 V and isolate it when unpowered (Ioff). The host provides the bus pulls, but for IORDY's weak backup (R53). IORDY stays open drain.
Channels follow the IDE header's pin order (see the comment in gen_schematic.py). U6 channels 1-4 carry rev 0.4's CSEL, IOCS16#, PDIAG# and DASP#.
R23-R43 (rev 0.4): series footprints on DD0-15, DA0-2, CS0# and CS1#, fitted with 0R; values (22-33R) chosen on the bus. The strobes already have 33R (R14, R15).
R44-R46: 10k pull-ups on CSEL, PDIAG# and DASP# (open drain). IOCS16# (open drain) is pulled up by the host.
R53 (rev 0.4): 10k pull-up on IORDY, header side, for hosts without one. The drive only ever pulls IORDY low.
33 R damping on the strobes, close to the RP2350.
BUS_EN# (GP41) is high, so the bus is disconnected, until firmware drives it low. Close JP1 to run firmware that doesn't drive GP41.
Next to the VCC pins of U2, U3, U5 and U6.
IDE 40-pin, shrouded. Pin 20 (the key) is an unplated hole: pull the pin out after assembly, for keyed cables.
IDE 44-pin (2 mm, 2.5-inch drives: Amiga 1200, laptops), in parallel with J5. 41-42 +5 V from the host, 43 GND. Pin 20 (the key) unplated: pull it out. Connect a host to J5 or J7, never both.

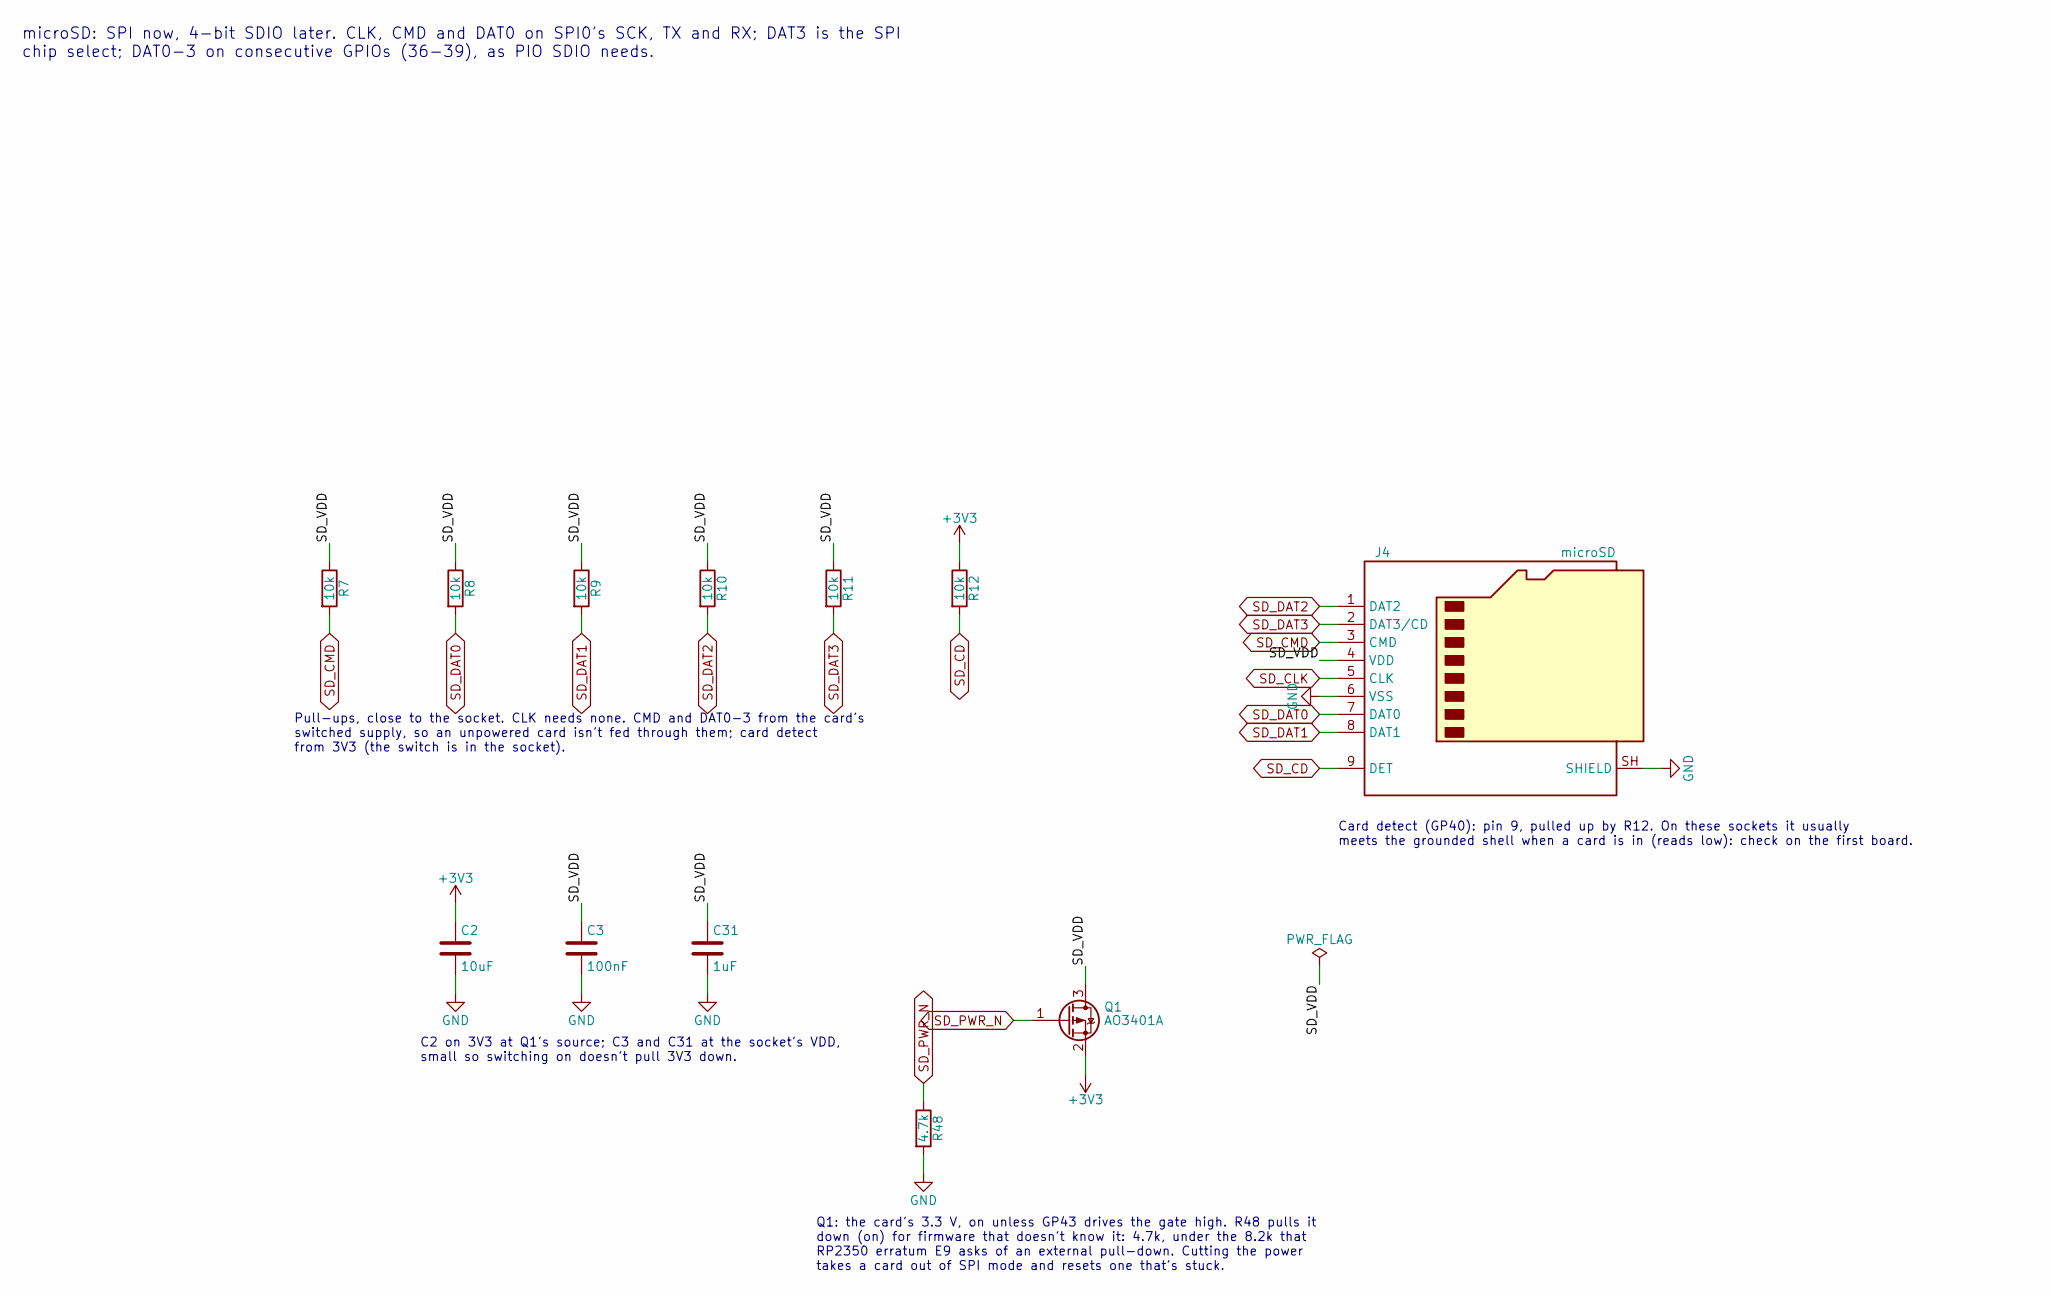
[picture p29: schematic sd.kicad_sch, IDE Synth Bay: microSD]

Parts:
C2: 10uF; C_0805_2012Metric; LCSC C15850
C3: 100nF; C_0603_1608Metric; LCSC C14663
C31: 1uF; C_0402_1005Metric; LCSC C52923
J4: microSD; microSD_TF-PUSH; MPN TF PUSH (generic push-push); LCSC C393941
Q1: AO3401A; SOT-23; LCSC C15127
R7, R8, R9, R10, R11, R12: 10k; R_0603_1608Metric; LCSC C25804
R48: 4.7k; R_0402_1005Metric; LCSC C25900

Connections:
+3V3: C2.1, Q1.2 (S), R12.1; also elsewhere on the board
/microSD/SD_VDD: C3.1, C31.1, J4.4 (VDD), Q1.3 (D), R7.1, R8.1, R9.1, R10.1, R11.1
GND: C2.2, C3.2, C31.2, J4.6 (VSS), J4.SH (SHIELD), R48.2; also elsewhere on the board
SD_CD: J4.9 (DET), R12.2; also elsewhere on the board
SD_CLK: J4.5 (CLK); also elsewhere on the board
SD_CMD: J4.3 (CMD), R7.2; also elsewhere on the board
SD_DAT0: J4.7 (DAT0), R8.2; also elsewhere on the board
SD_DAT1: J4.8 (DAT1), R9.2; also elsewhere on the board
SD_DAT2: J4.1 (DAT2), R10.2; also elsewhere on the board
SD_DAT3: J4.2 (DAT3/CD), R11.2; also elsewhere on the board
SD_PWR_N: Q1.1 (G), R48.1; also elsewhere on the board

Notes on the sheet:
microSD: SPI now, 4-bit SDIO later. CLK, CMD and DAT0 on SPI0's SCK, TX and RX; DAT3 is the SPI chip select; DAT0-3 on consecutive GPIOs (36-39), as PIO SDIO needs.
Card detect (GP40): pin 9, pulled up by R12. On these sockets it usually meets the grounded shell when a card is in (reads low): check on the first board.
Pull-ups, close to the socket. CLK needs none. CMD and DAT0-3 from the card's switched supply, so an unpowered card isn't fed through them; card detect from 3V3 (the switch is in the socket).
Q1: the card's 3.3 V, on unless GP43 drives the gate high. R48 pulls it down (on) for firmware that doesn't know it: 4.7k, under the 8.2k that RP2350 erratum E9 asks of an external pull-down. Cutting the power takes a card out of SPI mode and resets one that's stuck.
C2 on 3V3 at Q1's source; C3 and C31 at the socket's VDD, small so switching on doesn't pull 3V3 down.
