MaverickUK/HDDSynthPro/hardware/hddsynthpro.kicad_pcb

## KiCad design hardware/hddsynthpro.kicad_pcb (continued)

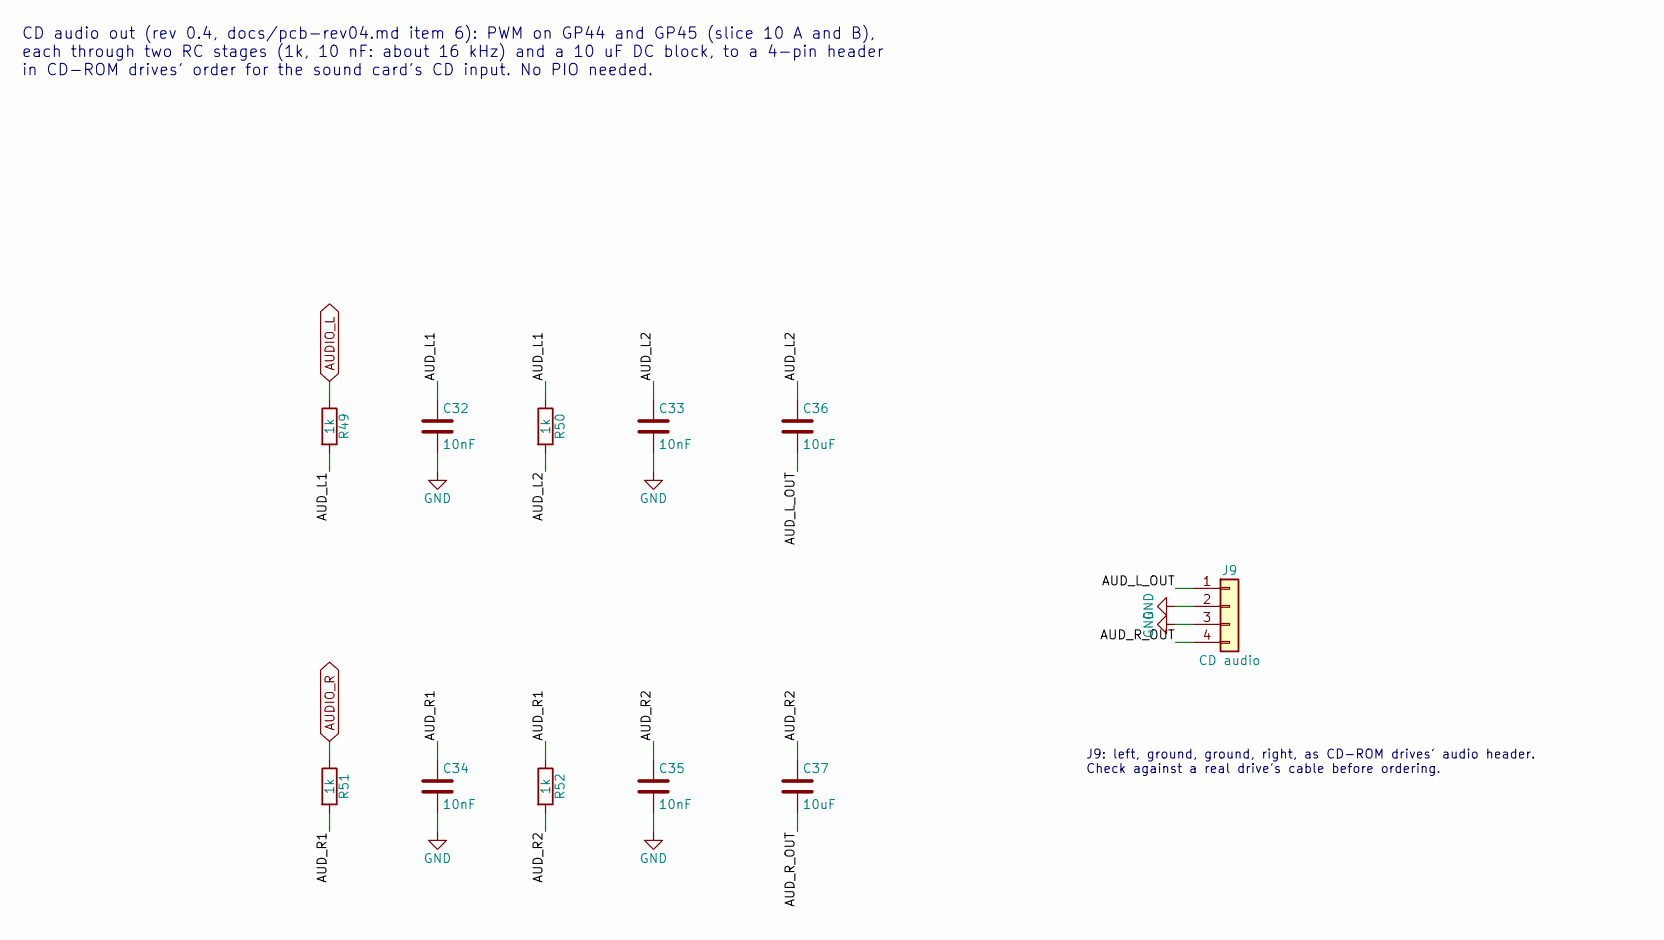
[picture p30: schematic audio.kicad_sch, IDE Synth Bay: CD audio]

Parts:
C32, C33, C34, C35: 10nF; C_0402_1005Metric; LCSC C15195
C36, C37: 10uF; C_0805_2012Metric; LCSC C15850
J9: CD audio; PinHeader_1x04_P2.54mm_Vertical
R49, R50, R51, R52: 1k; R_0402_1005Metric; LCSC C11702

Connections:
/CD audio/AUD_L1: C32.1, R49.2, R50.1
/CD audio/AUD_L2: C33.1, C36.1, R50.2
/CD audio/AUD_L_OUT: C36.2, J9.1
/CD audio/AUD_R1: C34.1, R51.2, R52.1
/CD audio/AUD_R2: C35.1, C37.1, R52.2
/CD audio/AUD_R_OUT: C37.2, J9.4
AUDIO_L: R49.1; also elsewhere on the board
AUDIO_R: R51.1; also elsewhere on the board
GND: C32.2, C33.2, C34.2, C35.2, J9.2, J9.3; also elsewhere on the board

Notes on the sheet:
CD audio out (rev 0.4, docs/pcb-rev04.md item 6): PWM on GP44 and GP45 (slice 10 A and B), each through two RC stages (1k, 10 nF: about 16 kHz) and a 10 uF DC block, to a 4-pin header in CD-ROM drives' order for the sound card's CD input. No PIO needed.
J9: left, ground, ground, right, as CD-ROM drives' audio header. Check against a real drive's cable before ordering.

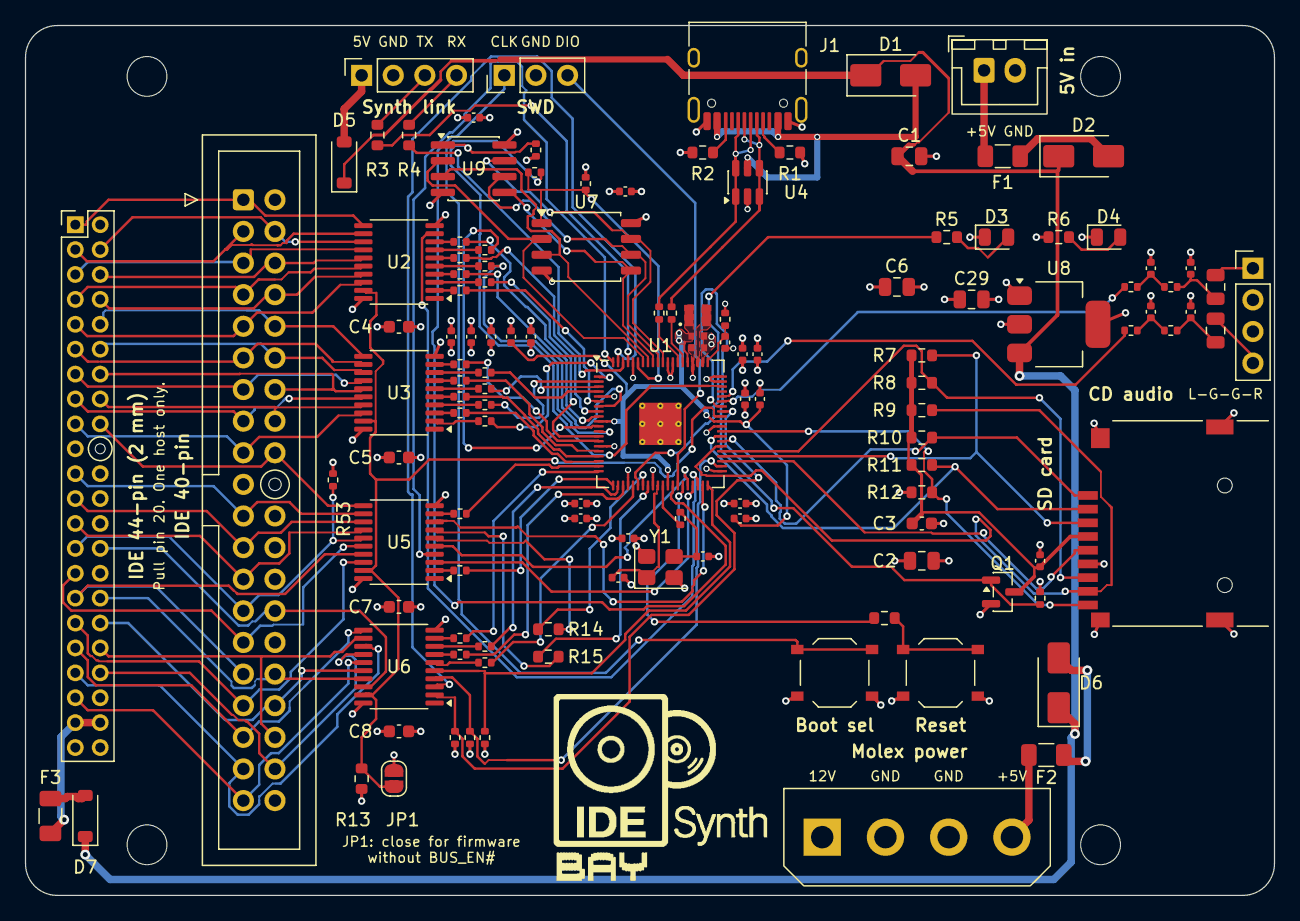
[picture p31: board hddsynthpro.kicad_pcb from above]

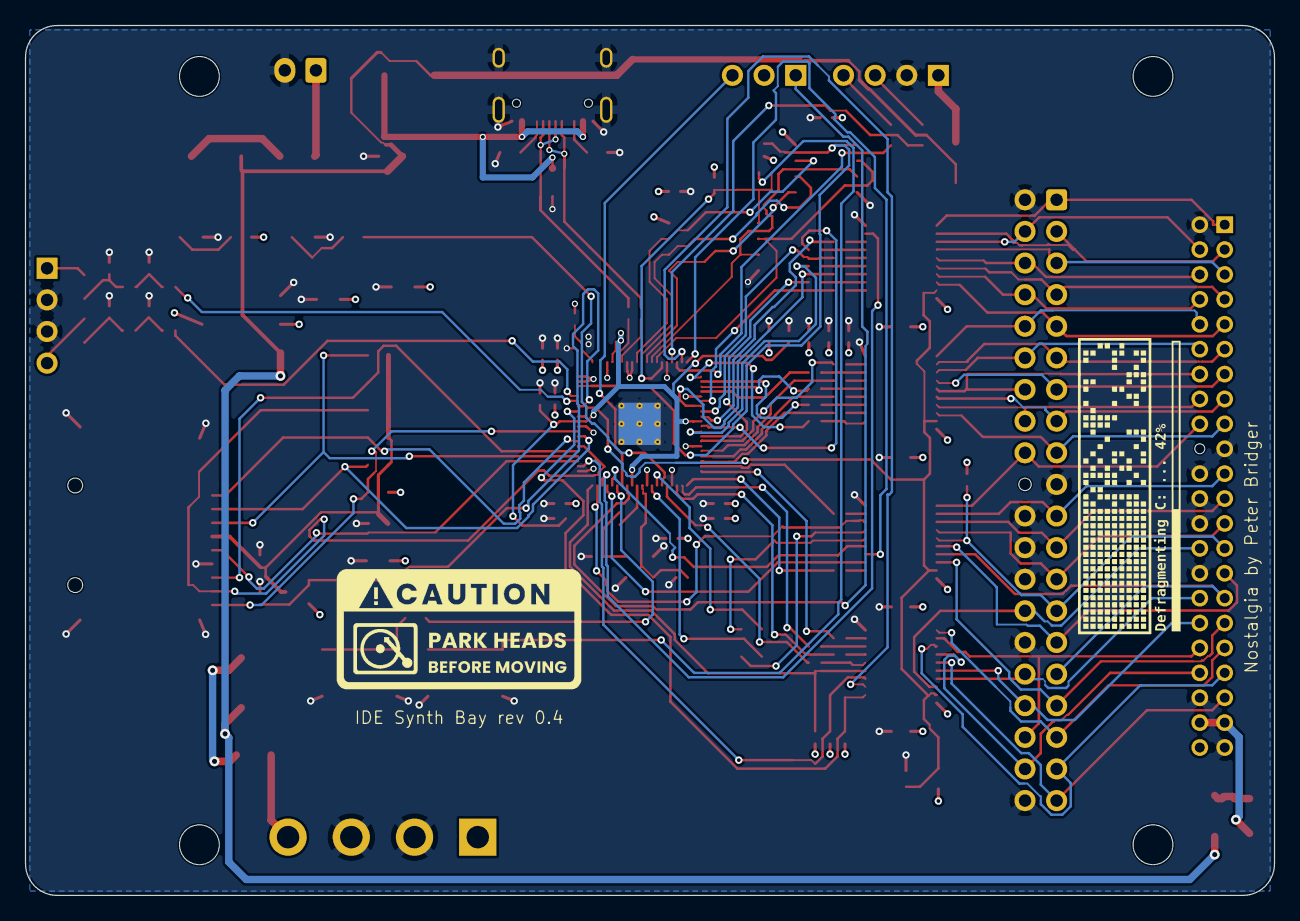
[picture p32: board hddsynthpro.kicad_pcb from below]

Board: 4 copper layers, 100.3 x 69.9 mm, 131 parts (2 on the bottom side), 147 nets.

Other parts of the board:
EGG1: EGG_ParkHeads
EGG2: EGG_Defrag
H1, H2, H3, H4: M3; MountingHole_3.2mm_M3
LOGO1: LOGO_IDESynthBay
