MaverickUK/HDDSynthPro/src/config.h

// Pin map and sizes. Pure constants, so host tests can include it.
// docs/wiring.md maps each pin to the IDE header.
#pragma once

#include <cstddef>

namespace cfg {

// The bus uses GPIO 4-30, all inside one PIO block's GPIO 0-31 window.
// Avoided on purpose:
//   GPIO 0-3  the BB48 pulls GPIO 2/3 up to 3.3 V through 2.2k (R17/R18,
//             UEXT/Qwiic I2C); GPIO 0/1 stay free for a UART if needed.
//   GPIO 25   the on-board LED (2.2k + LED to GND).
// DD, DA and CS# are on consecutive pins so one PIO read captures an access.
constexpr unsigned PIN_DD0 = 4;      // DD0-DD15 on GPIO 4-19
constexpr unsigned PIN_DA0 = 20;     // DA0-DA2 on GPIO 20-22
constexpr unsigned PIN_CS0_N = 23;   // CS0# (ATA "CS1FX-"): command block registers
constexpr unsigned PIN_CS1_N = 24;   // CS1# (ATA "CS3FX-"): control block registers
constexpr unsigned PIN_BOARD_LED = 25;  // on-board LED, not a bus line
constexpr unsigned PIN_DIOR_N = 26;
constexpr unsigned PIN_DIOW_N = 27;
constexpr unsigned PIN_IORDY = 28;   // host pulls up to 5 V via 1k: only ever drive low or release
constexpr unsigned PIN_INTRQ = 29;
constexpr unsigned PIN_RESET_N = 30;

// Multiword DMA's handshake (docs/dma.md). Wired on the PCB, and on the BB48
// rig since 29 Oct 2026 (IDE pin 21 to GPIO 31, pin 29 to GPIO 3). DMARQ is
// driven only during a DMA command; DMACK# isn't read yet (Ultra DMA will).
constexpr unsigned PIN_DMARQ = 31;
constexpr unsigned PIN_DMACK_N = 3;

// IOCS16# (IDE pin 32), for 16-bit ISA cards that pass it to the ISA bus
// (iocs16.pio). Open drain: pulled low while the data register is addressed,
// otherwise released. GPIO 2 is the only free pin in the PIO window (as PCB
// rev 0.4 plans); the BB48's 2.2k pull-up on it (R17) is harmless for an open
// drain signal the host also pulls up. Wired on the rig since 30 Oct 2026.
constexpr unsigned PIN_IOCS16_N = 2;

// early_answers: core 1 leaves its tight bus loop for the main loop only after
// the bus has been quiet this long, so the host's accesses almost never find it
// mid-pass (up to about 1 us): a write's answer that late can cost the next
// write (0.23.11, a word lost in a FAT sector on the Pentium).
constexpr uint32_t EARLY_BUS_ONLY_US = 10000;
// early_answers: if the drive has held IORDY this long since a chip select
// with no strobe, core 1 lets it go (ide_bus::checkIordyStall), as
// iordy_watchdog.pio does with `isa = on`: an ISA card that asserts the chip
// selects for memory and refresh cycles would otherwise stall the whole bus
// (an ICL 386). PCs look at IORDY only during a strobe, so it's harmless to
// them (the Evesham holds a chip select up to 75 us before a read).
constexpr uint32_t IORDY_STALL_US = 23;

// PCB only (rev 0.3; on the BB48 rig these GPIOs are unconnected, so driving
// and reading them there is harmless). The IDE bus goes through bus switches
// that start off: BUS_EN# held high by a pull-up until the firmware drives it
// low (closing JP1 bypasses it). SD_CD is the card socket's detect switch,
// pulled up, low with a card in (to be checked on the first board).
constexpr unsigned PIN_SD_CD = 40;
constexpr unsigned PIN_BUS_EN_N = 41;

// PCB rev 0.4 (docs/pcb-rev04.md; not used by the firmware yet, unconnected
// on rev 0.3 and the BB48). DASP#, PDIAG# and CSEL go through the bus
// switches like the rest of the bus, with 10k pull-ups on the RP2350's side:
// DASP# and PDIAG# open drain, CSEL read at reset (low = device 0). SD_PWR#
// is the microSD's power switch, pulled down on the board, so the card is
// powered unless the firmware drives it high. AUDIO_L/R are CD audio by PWM
// (slice 10 A and B). PSRAM_CS# is the QSPI PSRAM's chip select (XIP CS1).
constexpr unsigned PIN_DASP_N = 32;
constexpr unsigned PIN_PDIAG_N = 33;
constexpr unsigned PIN_CSEL = 42;
constexpr unsigned PIN_SD_PWR_N = 43;
constexpr unsigned PIN_AUDIO_L = 44;
constexpr unsigned PIN_AUDIO_R = 45;
constexpr unsigned PIN_PSRAM_CS_N = 47;

// Whether `mode = auto` offers multiword DMA where DMARQ is wired is the
// `dma` setting in HDDSYNTH.INI (drive_config::DEFAULT_DMA: off until DMA has
// had a soak). Never offered without DMARQ, whatever it says.

// The activity link to an HDD Synth (docs/activity-link.md): UART0 TX on
// GPIO 0 ($HDA, $HDE); UART0 RX on GPIO 1, pulled up, for the synth's $HDM
// (protocol version 2, seek_timing = synth).
constexpr unsigned PIN_LINK_TX = 0;
constexpr unsigned PIN_LINK_RX = 1;
constexpr uint32_t LINK_BAUD = 115200;
constexpr uint32_t LINK_HEARTBEAT_MS = 200;  // a sentence at least this often
constexpr uint32_t LINK_HEAD_GAP_US = 2000;  // $HDE at most this often (about its time on the wire)

constexpr unsigned BUS_FIRST_PIN = PIN_DD0;
constexpr unsigned BUS_LAST_PIN = PIN_RESET_N;

// The microSD breakout (slice 5). The same wires serve SPI now and 4-bit
// SDIO later: CLK, CMD and DAT0 are on SPI0's SCK, TX and RX pins, DAT3 is
// the SPI chip select, and DAT0-3 are consecutive, as PIO SDIO needs.
// CMD and DAT0-3 have 10k pull-ups to 3.3 V on the breakout's side.
constexpr unsigned PIN_SD_CLK = 34;   // SPI0 SCK
constexpr unsigned PIN_SD_CMD = 35;   // SPI0 TX (card DI)
constexpr unsigned PIN_SD_DAT0 = 36;  // SPI0 RX (card DO); DAT1-3 on 37-39
constexpr unsigned PIN_SD_DAT3 = 39;  // SPI chip select
// The SPI clock for the card, MHz. SPI0 divides the peripheral clock, which
// main.cpp keeps at the 200 MHz system clock, by an even number, so this
// rounds down: 25 is exact (÷8), the next step is 33.3 (÷6). At 150 MHz (up
// to 0.13.0) 25 was ÷6, and 37.5 didn't start on the hand-wired leads. Each
// step up was checked by hashing the whole image.
constexpr uint32_t SD_SPI_MHZ = 25;

// The PCB build (pcb_drive, HDDPRO_PCB): the card runs over 4-bit SDIO
// (docs/pio-allocation.md), about four times SPI's speed; the BB48 builds keep
// SPI, since SDIO failed on its hand-wired leads. SdFat's PIO SDIO driver takes
// a whole PIO block, so pio_plan decides what else fits. A card left in SPI
// mode (by earlier firmware or the BB48) won't start over SDIO until it's taken
// out and put back: at boot the drive then falls back to SPI and says so.
// The divider is PIO cycles / 4 per SD clock: 2 is 25 MHz at 200 MHz (default
// speed). 1 would be 50 MHz, beyond default speed: the driver doesn't switch
// the card to high speed (CMD6), so it isn't used.
#ifndef HDDPRO_PCB
#define HDDPRO_PCB 0
#endif
#define SD_SDIO HDDPRO_PCB
constexpr float SD_SDIO_CLKDIV = 2.0f;

// After a command starts, core 1 only serves the bus for this long before its
// next bookkeeping step, so the host's first status poll (the adapter's comes
// at once after IDENTIFY and SET FEATURES) never waits behind one. Without it
// that poll was held 1.29-1.39 us (ATA allows 1.25).
constexpr uint32_t COMMAND_QUIET_US = 4;
// With a command queued, core 1 answers at most this many accesses already
// waiting (the host's first status polls, BSY at once) before it runs the
// command. Bounded, so back-to-back polls can't keep a command queued for good
// (0.29.0-2d.4); not 0, or the first poll waits for the whole command.
constexpr unsigned COMMAND_POLLS_FIRST = 8;

// Trace ring between core 1 (producer) and core 0 (consumer):
// 8192 events x 16 bytes = 128 KB (12 bytes of data, padded).
constexpr size_t TRACE_RING_EVENTS = 8192;

// The listen build's capture window (console `w`): with no drive answering,
// the adapter probes about once a microsecond forever, faster than core 0 can
// print, so the ring overflows. With the window on, each RESET# assert opens
// a window of this many bus accesses, and the rest are counted but not
// recorded until the next one. Two windows fit in the ring, so the adapter's
// two detection resets never drop an event.
constexpr uint32_t LISTEN_WINDOW_EVENTS = 3000;
static_assert(2 * LISTEN_WINDOW_EVENTS + 64 < TRACE_RING_EVENTS, "two windows must fit in the trace ring");

// Core 0 prints a run of identical accesses once it has been quiet this long.
constexpr unsigned TRACE_FLUSH_MS = 20;

// How long IDLE IMMEDIATE shows BSY when it wakes the drive from standby. A CF
// card on the rig took about 25 us; a spinning disk takes seconds.
constexpr uint32_t WAKE_BUSY_US = 50;

// After each data-out block but the last, BSY for at least this long before
// DRQ and INTRQ ask for the next one. The NS1081 reads Status straight after
// a block, clearing any interrupt, and then waits for INTRQ: with write-behind
// the next block could be wanted at once, and it would wait forever.
constexpr uint32_t DATA_OUT_BSY_US = 10;

// The BB48's LED is the drive's activity light: lit while a command runs, and
// for at least this long, so a command of a few microseconds still shows.
constexpr uint32_t LED_MIN_MS = 25;

// The RAM overlay on the generated disk (block_source.h): how many distinct
// sectors can be written, at 512 bytes each.
constexpr size_t RAM_DISK_SECTORS = 512;

// A folder served as device 1 (docs/two-drives.md): the most files and
// folders its list holds, 32 bytes each, on the heap. Fewer if RAM is short
// (halved until it fits); a bigger folder is served cut short, with a warning.
constexpr uint16_t FOLDER_MAX_ENTRIES = 1024;
constexpr uint32_t FOLDER_HEAP_LEFT = 16 * 1024;  // heap kept free after the list

// The IORDY timer (iordy_timer.pio) counts and times reads that IORDY holds
// longer than this. ATA's limit is 1250 ns (tB).
constexpr uint32_t IORDY_REPORT_NS = 400;
// Reads held past ATA's limit also print a SLOWREAD line each.
constexpr uint32_t IORDY_LIMIT_NS = 1250;

}  // namespace cfg
