MaverickUK/HDDSynthPro/src/iordy_timer.cpp

#include "iordy_timer.h"

#include <atomic>

#include <hardware/clocks.h>
#include <hardware/pio.h>
#include <hardware/structs/busctrl.h>
#include <pico/time.h>

#include "bus_sample.h"
#include "config.h"
#include "iordy_check.pio.h"
#include "iordy_timer.pio.h"

namespace iordy_timer {

static PIO s_pio;
static uint s_sm;
static uint32_t s_threshold_iterations;
static uint32_t s_limit_iterations;  // cfg::IORDY_LIMIT_NS in loop iterations, for SLOWREAD
static uint32_t s_slow = 0;
static uint32_t s_max_iterations = 0;
static const char* s_max_register = "-";
static uint32_t s_max_at_us = 0;
static uint32_t s_early = 0;
static const char* s_early_register = "-";
static uint32_t s_early_data = 0;  // of them, data register reads (an EARLYDATA line each)
// iordy_check.pio: reads the host ended while IORDY was still low.
static PIO s_check_pio;
static uint s_check_sm;
static uint s_offset, s_check_offset;  // where the programs went, for end()
static uint32_t s_ignored = 0;
static const char* s_ignored_register = "-";
static uint32_t s_ignored_data = 0;
static uint32_t s_ignored_at_us = 0;
// For auto_bus: never cleared, so differences across a reset stay right.
static uint32_t s_ignored_total = 0;
static uint32_t s_long_total = 0;          // reads held past LONG_NS
static uint32_t s_long_iterations = 0;
constexpr uint32_t LONG_NS = 1000;  // longer than any host's strobe seen (ISA 375-500 ns, a PIIX 340)
// The data port's slow reads apart (a host may time it apart from the other
// registers): counts by how long IORDY held them, and the longest.
static uint32_t s_data_buckets[DATA_BUCKETS] = {};
static uint32_t s_data_bucket_iterations[DATA_BUCKETS - 1];  // each bucket's upper edge
static uint32_t s_data_max_iterations = 0;
// Core 1 starts the program while core 0 may already be polling.
static std::atomic<bool> s_started{false};
static std::atomic<bool> s_reset_requested{false};
// Reads past the limit, waiting for takeOverLimit(); core 0 only.
static OverLimit s_over[8];
static unsigned s_over_head = 0, s_over_count = 0;

// One loop iteration is 2 PIO cycles; the wait and the three instructions
// before the loop add 4.
static uint32_t iterationsToNs(uint32_t iterations) {
    return uint32_t((2ull * iterations + 4) * 1000000000ull / clock_get_hz(clk_sys));
}
static uint32_t nsToIterations(uint32_t ns) {
    return uint32_t((uint64_t(ns) * clock_get_hz(clk_sys) / 1000000000ull - 4) / 2);
}

// A read of the data register (command block, address 0).
static bool isData(uint32_t sample) {
    return bus::block(sample) == bus::Block::Command && bus::address(sample) == 0;
}

void begin(uint32_t threshold_ns) {
    uint offset;
    bool ok = pio_claim_free_sm_and_add_program_for_gpio_range(
        &iordy_timer_program, &s_pio, &s_sm, &offset, cfg::PIN_DD0,
        cfg::PIN_IORDY - cfg::PIN_DD0 + 1, true);
    hard_assert(ok);

    s_offset = offset;
    pio_sm_config c = iordy_timer_program_get_default_config(offset);
    sm_config_set_in_pins(&c, cfg::PIN_DD0);
    sm_config_set_in_shift(&c, true, false, 32);  // `in` shifts right: new bits on top
    sm_config_set_jmp_pin(&c, cfg::PIN_IORDY);
    pio_sm_init(s_pio, s_sm, offset, &c);

    uint64_t cycles = uint64_t(threshold_ns) * clock_get_hz(clk_sys) / 1000000000ull;
    s_threshold_iterations = uint32_t(cycles / 2);
    // The inverse of iterationsToNs(), worked out once: poll() compares each
    // report against it, and converts only the reads past the limit.
    s_limit_iterations = nsToIterations(cfg::IORDY_LIMIT_NS);
    for (int i = 0; i < DATA_BUCKETS - 1; ++i) s_data_bucket_iterations[i] = nsToIterations(DATA_BUCKET_EDGES_NS[i]);
    s_long_iterations = nsToIterations(LONG_NS);
    pio_sm_put(s_pio, s_sm, s_threshold_iterations);
    pio_sm_set_enabled(s_pio, s_sm, true);

    // The host-ignores-IORDY check, on the same pins (it fits beside this
    // program and the bus observer).
    ok = pio_claim_free_sm_and_add_program_for_gpio_range(
        &iordy_check_program, &s_check_pio, &s_check_sm, &offset, cfg::PIN_DD0,
        cfg::PIN_IORDY - cfg::PIN_DD0 + 1, true);
    hard_assert(ok);
    s_check_offset = offset;
    pio_sm_config k = iordy_check_program_get_default_config(offset);
    sm_config_set_in_pins(&k, cfg::PIN_DD0);
    sm_config_set_jmp_pin(&k, cfg::PIN_IORDY);
    pio_sm_init(s_check_pio, s_check_sm, offset, &k);
    pio_sm_set_enabled(s_check_pio, s_check_sm, true);

    busctrl_hw->counter[0].sel = BUSCTRL_PERFSEL0_VALUE_FASTPERI_ACCESS_CONTESTED;
    busctrl_hw->counter[1].sel = BUSCTRL_PERFSEL0_VALUE_FASTPERI_STALL_UPSTREAM;
    busctrl_hw->perfctr_en = 1;
    s_started.store(true, std::memory_order_release);
}

void poll() {
    if (!s_started.load(std::memory_order_acquire)) return;
    // A bounded batch: reports can come every few microseconds (a read held
    // past the threshold each), and core 0 must get back to the fetches.
    // Draining until empty, with each report converted to ns, kept it here
    // for hundreds of us, so read-aheads were late and reads slowed by a
    // third (0.8.24). If reports come faster than that, the PIO drops the
    // extra ones (push noblock): `iordy_slow` undercounts, the bus never waits.
    for (int i = 0; i < 8 && !pio_sm_is_rx_fifo_empty(s_pio, s_sm); ++i) {
        uint32_t report = pio_sm_get(s_pio, s_sm);
        uint32_t sample = report << 16;  // back to the sample layout
        if (bus::high(sample, cfg::PIN_IORDY)) {  // started before IORDY was low
            ++s_early;
            s_early_register = bus::registerName(bus::block(sample), bus::address(sample), false);
            if (isData(sample)) {  // a data read the host may not wait for: an EARLYDATA line (ns 0)
                ++s_early_data;
                s_over[(s_over_head + s_over_count) % 8] = OverLimit{0, "DATA", time_us_32()};
                if (s_over_count < 8)
                    ++s_over_count;
                else
                    s_over_head = (s_over_head + 1) % 8;
            }
            continue;
        }
        uint32_t iterations = s_threshold_iterations + (0xFFFFu - (report >> 16));
        const char* reg = bus::registerName(bus::block(sample), bus::address(sample), false);
        ++s_slow;
        if (iterations > s_long_iterations) ++s_long_total;
        if (isData(sample)) {
            int b = 0;
            while (b < DATA_BUCKETS - 1 && iterations > s_data_bucket_iterations[b]) ++b;
            ++s_data_buckets[b];
            if (iterations > s_data_max_iterations) s_data_max_iterations = iterations;
        }
        if (iterations > s_max_iterations) {
            s_max_iterations = iterations;
            s_max_register = reg;
            s_max_at_us = time_us_32();
        }
        if (iterations > s_limit_iterations) {
            s_over[(s_over_head + s_over_count) % 8] = OverLimit{iterationsToNs(iterations), reg, time_us_32()};
            if (s_over_count < 8)
                ++s_over_count;
            else
                s_over_head = (s_over_head + 1) % 8;  // full: drop the oldest
        }
    }
    // Reads the host didn't wait for: a few per call, like the reports above.
    for (int i = 0; i < 4 && !pio_sm_is_rx_fifo_empty(s_check_pio, s_check_sm); ++i) {
        uint32_t sample = pio_sm_get(s_check_pio, s_check_sm);
        ++s_ignored;
        ++s_ignored_total;
        s_ignored_register = bus::registerName(bus::block(sample), bus::address(sample), false);
        s_ignored_at_us = time_us_32();
        if (isData(sample)) ++s_ignored_data;
    }
    if (s_reset_requested.exchange(false, std::memory_order_relaxed)) reset();
}

void end() {
    if (!s_started.exchange(false, std::memory_order_acq_rel)) return;
    pio_sm_set_enabled(s_pio, s_sm, false);
    pio_sm_set_enabled(s_check_pio, s_check_sm, false);
    pio_remove_program_and_unclaim_sm(&iordy_timer_program, s_pio, s_sm, s_offset);
    pio_remove_program_and_unclaim_sm(&iordy_check_program, s_check_pio, s_check_sm, s_check_offset);
}

bool running() { return s_started.load(std::memory_order_acquire); }

uint32_t ignoredReads() { return s_ignored; }
uint32_t ignoredTotal() { return s_ignored_total; }
uint32_t longTotal() { return s_long_total; }
const char* ignoredRegister() { return s_ignored_register; }
uint32_t ignoredDataReads() { return s_ignored_data; }
uint32_t ignoredAtUs() { return s_ignored_at_us; }
uint32_t dataSlowReads(int bucket) { return s_data_buckets[bucket]; }
uint32_t dataMaxNs() { return s_data_max_iterations ? iterationsToNs(s_data_max_iterations) : 0; }

uint32_t slowReads() { return s_slow; }
uint32_t maxNs() { return s_max_iterations ? iterationsToNs(s_max_iterations) : 0; }
const char* maxRegister() { return s_max_register; }
uint32_t maxAtUs() { return s_max_at_us; }
uint32_t earlyReads() { return s_early; }
const char* earlyRegister() { return s_early_register; }
uint32_t earlyDataReads() { return s_early_data; }
bool takeOverLimit(OverLimit& read) {
    if (s_over_count == 0) return false;
    read = s_over[s_over_head];
    s_over_head = (s_over_head + 1) % 8;
    --s_over_count;
    return true;
}

uint32_t contestedAccesses() { return busctrl_hw->counter[0].value; }
uint32_t stallCycles() { return busctrl_hw->counter[1].value; }

void requestReset() { s_reset_requested.store(true, std::memory_order_relaxed); }

void reset() {
    s_slow = 0;
    s_max_iterations = 0;
    s_max_register = "-";
    s_max_at_us = 0;
    s_early = 0;
    s_early_register = "-";
    s_early_data = 0;
    s_ignored = 0;
    s_ignored_register = "-";
    s_ignored_data = 0;
    s_ignored_at_us = 0;
    for (auto& b : s_data_buckets) b = 0;
    s_data_max_iterations = 0;
    busctrl_hw->counter[0].value = 0;  // any write clears a counter
    busctrl_hw->counter[1].value = 0;
}

}  // namespace iordy_timer
