MaverickUK/HDDSynthPro/src/ata_device.cpp

#include "ata_device.h"

#include "core1_ram.h"

namespace ata {

CORE1_RAM Reg regFor(bool command_block, bool control_block, unsigned address) {
    if (command_block && !control_block) return static_cast<Reg>(address & 7);
    if (control_block && !command_block && address == 6) return Reg::AltStatusDevCtrl;
    return Reg::None;
}

Device::Device(const IdentifyInfo& info, const IdentifyInfo* device1) : has_device1_(device1 != nullptr) {
    for (unsigned n = 0; n < (has_device1_ ? 2u : 1u); ++n) {
        Unit& unit = units_[n];
        unit.info = n == 0 ? info : *device1;
        unit.geometry = startGeometry(unit.info);
        buildIdentify(unit.info, unit.identify);
    }
    resetToSignature();
}

// The host changed the Device register: which unit answers from now on.
CORE1_RAM void Device::deviceWritten() {
    uint8_t unit = (device_ & DEV_DEV) ? 1 : 0;
    if (!has_device1_) {
        absent_selected_ = unit == 1;
        return;
    }
    // Not mid-transfer: ATA forbids changing DEV then, and the command's
    // state belongs to the unit running it. (Writes while BSY never get here.)
    if (unit != unit_ && !(status_ & ST_DRQ)) selectUnit(unit);
}

CORE1_RAM void Device::selectUnit(uint8_t unit) {
    Unit& from = units_[unit_];
    from.status = status_;
    from.error = error_;
    from.irq = irq_pending_;
    unit_ = unit;
    status_ = units_[unit].status;
    error_ = units_[unit].error;
    irq_pending_ = units_[unit].irq;
}

CORE1_RAM void Device::resetToSignature() {
    // The ATA device signature: what a host checks after a reset to tell an
    // ATA drive (0000h in the LBA mid/high pair) from ATAPI (EB14h).
    sector_count_ = 1;
    lba_low_ = 1;
    lba_mid_ = 0;
    lba_high_ = 0;
    device_ = 0;
    error_ = 0x01;  // diagnostic code: device 0 passed, and device 1 passed or absent
    status_ = ST_DRDY | ST_DSC;
    // Both units set the signature, and device 0 is selected.
    unit_ = 0;
    absent_selected_ = false;
    units_[1].status = ST_DRDY | ST_DSC;
    units_[1].error = 0x01;
    units_[1].irq = false;
    data_ = nullptr;
    data_count_ = data_index_ = 0;
    irq_pending_ = false;
    waking_ = false;
    command_queued_ = false;
    // Abandon any read or write; a fetch still running on core 0 becomes stale.
    reading_ = false;
    writing_ = false;
    receiving_ = false;
    out_hold_ = false;
    flushing_ = false;
    fetch_pending_ = false;
    ++fetch_id_;
}

CORE1_RAM void Device::consumeRead(Reg reg) {
    if (absent_selected_) return;  // device 0 answers 00h and keeps its state
    if (reg == Reg::Data) {
        if (!(status_ & ST_DRQ) || !data_) return;
        if (++data_index_ >= data_count_) finishDataIn();
    } else if (reg == Reg::StatusCommand) {
        irq_pending_ = false;  // reading Status acknowledges the interrupt
    }
}

CORE1_RAM void Device::consumeDataWords(uint16_t n) {
    if (n == 0 || absent_selected_ || !(status_ & ST_DRQ) || !data_) return;
    data_index_ = uint16_t(data_index_ + n);
    if (data_index_ >= data_count_) finishDataIn();
}

CORE1_RAM void Device::write(Reg reg, uint16_t value) {
    uint8_t v = uint8_t(value);
    if (reg == Reg::AltStatusDevCtrl) {
        // Device Control is honoured even while busy: it is how a host
        // recovers a hung drive.
        bool was_srst = (device_control_ & DC_SRST) != 0;
        device_control_ = v;
        if (v & DC_SRST) {
            abandonCommand();
            dma_ = dma_burst_running_ = false;
            in_reset_ = true;
            status_ = ST_BSY;
            irq_pending_ = false;
            command_queued_ = false;
        } else if (was_srst) {
            in_reset_ = false;
            resetToSignature();
        }
        return;
    }
    // The host must not write the command block while BSY; ignore it if it does.
    if (status_ & ST_BSY) return;

    switch (reg) {
        case Reg::Data:
            if (!receiving_ || absent_selected_) break;  // no data-out phase: ignored
            sectors_[recv_buf_][received_++] = value;
            if (received_ >= SECTOR_WORDS) finishDataOut();
            break;
        case Reg::ErrorFeatures: features_ = v; break;
        case Reg::SectorCount: sector_count_ = v; break;
        case Reg::LbaLow: lba_low_ = v; break;
        case Reg::LbaMid: lba_mid_ = v; break;
        case Reg::LbaHigh: lba_high_ = v; break;
        case Reg::Device:
            device_ = v;
            deviceWritten();
            break;
        case Reg::StatusCommand:
            if (acceptsCommand(v)) startCommand(v);
            break;
        default: break;
    }
}

CORE1_RAM bool Device::acceptsCommand(uint8_t command) const {
    // Not while BSY (the host must not write the command block then), and
    // commands for the absent device 1 are not ours to run, except EXECUTE
    // DEVICE DIAGNOSTIC, which both devices act on.
    if (status_ & ST_BSY) return false;
    return !absent_selected_ || command == CMD_EXECUTE_DEVICE_DIAGNOSTIC;
}

CORE1_RAM void Device::queueCommand(uint8_t command) {
    if (!acceptsCommand(command)) return;
    queued_command_ = command;
    command_queued_ = true;
    status_ = ST_BSY | ST_DRDY | ST_DSC;
    irq_pending_ = false;  // writing Command clears a pending interrupt
}

CORE1_RAM void Device::runQueuedCommand() {
    if (!command_queued_) return;
    command_queued_ = false;
    startCommand(queued_command_);
}

CORE1_RAM void Device::hardReset(bool asserted) {
    if (asserted) {
        abandonCommand();
        in_reset_ = true;
        status_ = ST_BSY;
        irq_pending_ = false;
        waking_ = false;
        dma_ = dma_burst_running_ = false;
        command_queued_ = false;
        device_control_ = 0;
        reading_ = false;
        writing_ = false;
        receiving_ = false;
        out_hold_ = false;
        flushing_ = false;
        fetch_pending_ = false;
        ++fetch_id_;
        // A hardware reset (not a soft one) restores both units' power-on
        // CHS translation and write cache setting.
        for (unsigned n = 0; n < (has_device1_ ? 2u : 1u); ++n) {
            Unit& unit = units_[n];
            unit.geometry = startGeometry(unit.info);
            setCurrentGeometry(unit.identify, unit.geometry);
            unit.write_cache = true;
            setWriteCacheEnabled(unit.identify, true);
            unit.standby = false;
        }
    } else if (in_reset_) {
        in_reset_ = false;
        resetToSignature();
    }
}

CORE1_RAM bool Device::intrq() const {
    // INTRQ belongs to the selected device; nIEN masks it.
    return irq_pending_ && !absent_selected_ && !(device_control_ & DC_NIEN);
}

// ---- Commands ---------------------------------------------------------------

CORE1_RAM void Device::startCommand(uint8_t command) {
    // A command written while a data-in block is unread (DRQ): the host gave
    // up on it. ATA says it mustn't, but the JMicron does. Abandon it, or the
    // stale block looks like a transfer under way (loop1 then never takes a
    // fetch result) and the new command's first sector like a read-ahead,
    // and the drive stays BSY for good. A write can't be left like this: it
    // ends only when every sector is stored, and holds BSY until then.
    abandonCommand();  // whatever was running ends here
    dma_ = dma_burst_running_ = false;
    if (data_ || reading_) {
        data_ = nullptr;
        data_count_ = data_index_ = 0;
        reading_ = false;
        ahead_ok_ = ahead_failed_ = false;
        if (fetch_pending_) {  // a read-ahead under way: its result is stale now
            fetch_pending_ = false;
            if (++fetch_id_ == 0) ++fetch_id_;
        }
    }
    last_ = CommandInfo{command, 0, 0, unit_};
    ++commands_started_;
    irq_pending_ = false;  // writing Command clears a pending interrupt
    error_ = 0;
    switch (command) {
        case CMD_IDENTIFY_DEVICE:
            startDataIn(u().identify, 256);
            break;
        case CMD_EXECUTE_DEVICE_DIAGNOSTIC:
            resetToSignature();  // signature, error 01h, and an interrupt
            irq_pending_ = true;
            ++commands_completed_;
            break;
        case CMD_READ_SECTORS:
        case CMD_READ_SECTORS_NO_RETRY:
            u().standby = false;
            startRead();
            break;
        case CMD_READ_DMA:
        case CMD_READ_DMA_NO_RETRY:
            if (u().info.mdma_mode == NO_DMA) {
                fail(ER_ABRT);  // not offered
                break;
            }
            u().standby = false;
            dma_ = true;
            startRead();  // the same fetches and read-ahead; the words go by DMA
            break;
        case CMD_WRITE_DMA:
        case CMD_WRITE_DMA_NO_RETRY:
            if (u().info.mdma_mode == NO_DMA) {
                fail(ER_ABRT);
                break;
            }
            u().standby = false;
            dma_ = true;
            startWrite();
            break;
        case CMD_WRITE_SECTORS:
        case CMD_WRITE_SECTORS_NO_RETRY:
            u().standby = false;
            startWrite();
            break;
        case CMD_READ_VERIFY:
        case CMD_READ_VERIFY_NO_RETRY:
            u().standby = false;
            readVerify();
            break;
        case CMD_SET_FEATURES:
            setFeatures();
            break;
        case CMD_INITIALIZE_DEVICE_PARAMETERS:
            initializeDeviceParameters();
            break;
        case CMD_FLUSH_CACHE:
            // The drive keeps nothing back itself, but its storage may (SdFat's
            // cache, the card's own buffer), so core 0 flushes it under BSY.
            flushing_ = true;
            requestFetch();
            break;
        case CMD_STANDBY_IMMEDIATE:
        case CMD_STANDBY:
        case CMD_STANDBY_IMMEDIATE_OLD:
        case CMD_STANDBY_OLD:
            // STANDBY's Sector Count sets a standby timer; there is no spindle,
            // so the timer is accepted and ignored.
            u().standby = true;
            completeNoData();
            break;
        case CMD_IDLE_IMMEDIATE:
        case CMD_IDLE:
        case CMD_IDLE_IMMEDIATE_OLD:
        case CMD_IDLE_OLD:
            if (u().standby) {
                // Waking: busy for a moment, then the interrupt, as a CF card
                // does. The NS1081 reads Status straight after the command, so
                // an interrupt raised at once is cleared before it waits for it.
                u().standby = false;
                waking_ = true;
                status_ = ST_BSY | ST_DRDY | ST_DSC;
            } else {
                completeNoData();
            }
            break;
        case CMD_CHECK_POWER_MODE:
        case CMD_CHECK_POWER_MODE_OLD:
            sector_count_ = u().standby ? POWER_STANDBY : POWER_ACTIVE_OR_IDLE;
            completeNoData();
            break;
        default:
            if (command >= CMD_RECALIBRATE && command <= CMD_RECALIBRATE + 0x0F) {
                u().standby = false;
                completeNoData();  // nothing to move: back at cylinder 0 at once
            } else if (command >= CMD_SEEK && command <= CMD_SEEK + 0x0F) {
                u().standby = false;
                seek();
            } else {
                fail(ER_ABRT);  // includes SET MULTIPLE MODE: not advertised
            }
            break;
    }
}

CORE1_RAM void Device::finishWake() {
    if (!waking_) return;
    waking_ = false;
    completeNoData();
}

CORE1_RAM void Device::completeNoData() {
    status_ = ST_DRDY | ST_DSC;
    irq_pending_ = true;
    ++commands_completed_;
}

CORE1_RAM bool Device::checkRange(uint32_t count, uint32_t& lba) {
    bool valid = decodeAddress(lba);
    last_.lba = lba;
    last_.count = uint16_t(count);
    if (!valid || lba >= u().info.total_sectors || count > u().info.total_sectors - lba) {
        // Out of range: fail before doing anything, with the first
        // unreachable address in the task file.
        if (valid) setTaskFileLba(lba < u().info.total_sectors ? u().info.total_sectors : lba);
        fail(ER_IDNF);
        return false;
    }
    return true;
}

CORE1_RAM void Device::readVerify() {
    // Like READ SECTORS, but the data stays on the drive. Generated data
    // can't fail to read, so a range check is the whole job.
    uint32_t lba;
    if (checkRange(sector_count_ ? sector_count_ : 256, lba)) completeNoData();
}

CORE1_RAM void Device::seek() {
    uint32_t lba;
    if (checkRange(1, lba)) completeNoData();
}

CORE1_RAM void Device::setFeatures() {
    last_.lba = features_;  // for the trace: which subcommand, and its argument
    last_.count = sector_count_;
    // PIO default, or PIO flow-control mode 0 up to the one IDENTIFY offers.
    // The bus program serves every mode it offers the same way, so there's
    // nothing to switch.
    uint8_t pio_mode = u().info.pio_mode > MAX_PIO_MODE ? MAX_PIO_MODE : u().info.pio_mode;
    if (features_ == SF_SET_TRANSFER_MODE &&
        (sector_count_ == XFER_PIO_DEFAULT ||
         (sector_count_ >= XFER_PIO_FLOW_0 && sector_count_ <= XFER_PIO_FLOW_0 + pio_mode))) {
        completeNoData();
        return;
    }
    // Multiword DMA mode 0 up to the one IDENTIFY offers.
    uint8_t mdma = u().info.mdma_mode > MAX_MDMA_MODE ? MAX_MDMA_MODE : u().info.mdma_mode;
    if (features_ == SF_SET_TRANSFER_MODE && u().info.mdma_mode != NO_DMA &&
        sector_count_ >= XFER_MDMA_0 && sector_count_ <= XFER_MDMA_0 + mdma) {
        setMdmaModeSelected(u().identify, uint8_t(sector_count_ - XFER_MDMA_0));
        completeNoData();
        return;
    }
    if (features_ == SF_ENABLE_WRITE_CACHE || features_ == SF_DISABLE_WRITE_CACHE) {
        u().write_cache = features_ == SF_ENABLE_WRITE_CACHE;
        setWriteCacheEnabled(u().identify, u().write_cache);
        completeNoData();
        return;
    }
    // Faster PIO modes and every DMA mode aren't offered; nor is turning
    // IORDY off (01h), look-ahead or the power-on defaults.
    fail(ER_ABRT);
}

CORE1_RAM void Device::initializeDeviceParameters() {
    // Sector Count = sectors per track, Device bits 3-0 = heads - 1.
    uint16_t spt = sector_count_;
    uint16_t heads = uint16_t((device_ & 0x0F) + 1);
    if (spt == 0) {
        fail(ER_ABRT);
        return;
    }
    uint32_t cylinders = u().info.total_sectors / (uint32_t(heads) * spt);
    if (cylinders > 65535) cylinders = 65535;
    if (cylinders == 0) {
        fail(ER_ABRT);
        return;
    }
    setGeometry(Geometry{uint16_t(cylinders), heads, spt});
    completeNoData();
}

CORE1_RAM void Device::setGeometry(const Geometry& g) {
    u().geometry = g;
    setCurrentGeometry(u().identify, g);
}

CORE1_RAM bool Device::decodeAddress(uint32_t& lba) const {
    if (device_ & DEV_LBA) {
        lba = (uint32_t(device_ & 0x0F) << 24) | (uint32_t(lba_high_) << 16) |
              (uint32_t(lba_mid_) << 8) | lba_low_;
        return true;
    }
    // CHS, in the current translation (default, or INITIALIZE DEVICE PARAMETERS).
    uint32_t cylinder = (uint32_t(lba_high_) << 8) | lba_mid_;
    uint32_t head = device_ & 0x0F;
    uint32_t sector = lba_low_;  // 1-based
    if (sector == 0 || sector > u().geometry.sectors_per_track || head >= u().geometry.heads ||
        cylinder >= u().geometry.cylinders)
        return false;
    lba = (cylinder * u().geometry.heads + head) * u().geometry.sectors_per_track + (sector - 1);
    return true;
}

CORE1_RAM void Device::startRead() {
    uint32_t count = sector_count_ ? sector_count_ : 256;
    uint32_t lba = 0;
    if (!checkRange(count, lba)) return;
    reading_ = true;
    read_lba_ = lba;
    read_left_ = count;
    ahead_ok_ = ahead_failed_ = false;
    requestFetch();
}

CORE1_RAM void Device::startWrite() {
    uint32_t count = sector_count_ ? sector_count_ : 256;
    uint32_t lba = 0;
    if (!checkRange(count, lba)) return;
    writing_ = true;
    write_lba_ = lba;
    write_left_ = count;
    recv_left_ = count;
    filled_ = false;
    store_failed_ = false;
    out_hold_ = false;
    recv_buf_ = 0;
    startDataOut();  // no interrupt before the first block
}

CORE1_RAM void Device::startDataOut() {
    receiving_ = true;
    received_ = 0;
    status_ = ST_DRDY | ST_DSC | ST_DRQ;
}

CORE1_RAM void Device::finishDataOut() {
    receiving_ = false;
    --recv_left_;
    filled_ = true;
    filled_buf_ = recv_buf_;
    if (recv_left_ > 0 && !dma_) out_hold_ = true;  // PIO: BSY before the next block is wanted
    settleWrite();
}

CORE1_RAM void Device::releaseDataOut() {
    if (!out_hold_) return;
    out_hold_ = false;
    if (writing_) settleWrite();
}

// A write's next step, after the host finishes a sector or core 0 a store:
// start the waiting store, ask for the next sector if a buffer is free, or
// finish. One store at a time; with write-behind the host fills the other
// buffer meanwhile. The command ends only when every sector is stored.
CORE1_RAM void Device::settleWrite() {
    if (store_failed_) {
        filled_ = false;  // nothing after the failed sector is stored
        out_hold_ = false;
        if (receiving_ || fetch_pending_) return;  // the block or store under way ends first
        writing_ = false;
        setTaskFileLba(store_failed_lba_);
        fail(ER_ABRT);
        return;
    }
    if (filled_ && !fetch_pending_) {  // its store, without BSY
        filled_ = false;
        fetch_buf_ = filled_buf_;
        fetch_lba_ = write_lba_;
        fetch_pending_ = true;
        if (++fetch_id_ == 0) ++fetch_id_;
    }
    if (!receiving_ && !out_hold_ && recv_left_ > 0 && !filled_ && (write_behind_ || !fetch_pending_)) {
        recv_buf_ = fetch_pending_ ? uint8_t(fetch_buf_ ^ 1) : 0;  // the buffer not being stored
        startDataOut();
        if (!dma_) irq_pending_ = true;  // PIO data-out: interrupt when each later block is wanted
        return;
    }
    if (receiving_) return;
    if (write_left_ == 0) {
        writing_ = false;
        dma_ = false;
        completeNoData();  // all stored: the command ends with an interrupt
        return;
    }
    status_ = ST_BSY | ST_DRDY | ST_DSC;  // waiting for a store
}

CORE1_RAM void Device::requestFetch(bool busy) {
    if (busy) status_ = ST_BSY | ST_DRDY | ST_DSC;
    fetch_pending_ = true;
    if (++fetch_id_ == 0) ++fetch_id_;  // never 0: pendingFetchId() uses it for "none"
    fetch_lba_ = writing_ ? write_lba_ : read_lba_;
    // A read fills the buffer the host isn't reading; a write stores the one
    // it was written into.
    fetch_buf_ = writing_ ? 0 : (data_ == sectors_[0] ? 1 : 0);
}

CORE1_RAM void Device::readAhead() {
    if (read_ahead_ && reading_ && read_left_ > 0) requestFetch(false);  // no BSY: the host carries on reading
}

CORE1_RAM void Device::deliverSector(bool ok) {
    if (!ok) {
        setTaskFileLba(fetch_lba_);
        reading_ = false;
        fail(ER_UNC);
        return;
    }
    startDataIn(sectors_[fetch_buf_], SECTOR_WORDS);
    readAhead();
}

CORE1_RAM bool Device::pendingFetch(Fetch& fetch) {
    if (!fetch_pending_) return false;
    fetch = Fetch{fetch_id_, fetch_lba_, sectors_[fetch_buf_], writing_, flushing_ || (writing_ && !u().write_cache),
                  last_.count, last_.lba, unit_};
    return true;
}

CORE1_RAM void Device::fetchDone(uint32_t id, bool ok) {
    if (!fetch_pending_ || id != fetch_id_) return;  // stale: a reset came first
    fetch_pending_ = false;
    if (flushing_) {
        flushing_ = false;
        if (ok)
            completeNoData();
        else
            fail(ER_ABRT);
        return;
    }
    if (writing_) {
        if (ok) {
            ++write_lba_;
            --write_left_;
        } else {
            store_failed_ = true;
            store_failed_lba_ = write_lba_;
        }
        settleWrite();
        return;
    }
    ++read_lba_;
    --read_left_;
    if (data_) {  // a read-ahead, done while the host reads the previous sector
        ahead_ok_ = ok;
        ahead_failed_ = !ok;
        return;
    }
    deliverSector(ok);  // the host is waiting for it (BSY)
}

CORE1_RAM void Device::setTaskFileLba(uint32_t lba) {
    if (device_ & DEV_LBA) {
        lba_low_ = uint8_t(lba);
        lba_mid_ = uint8_t(lba >> 8);
        lba_high_ = uint8_t(lba >> 16);
        device_ = uint8_t((device_ & 0xF0) | ((lba >> 24) & 0x0F));
    } else {
        uint32_t per_cyl = uint32_t(u().geometry.heads) * u().geometry.sectors_per_track;
        uint32_t cylinder = lba / per_cyl;
        uint32_t rest = lba % per_cyl;
        lba_low_ = uint8_t(rest % u().geometry.sectors_per_track + 1);
        lba_mid_ = uint8_t(cylinder);
        lba_high_ = uint8_t(cylinder >> 8);
        device_ = uint8_t((device_ & 0xF0) | (rest / u().geometry.sectors_per_track));
    }
}

CORE1_RAM void Device::fail(uint8_t error) {
    dma_ = dma_burst_running_ = false;
    error_ = error;
    status_ = ST_DRDY | ST_DSC | ST_ERR;
    irq_pending_ = true;
    reading_ = false;
    writing_ = false;
    receiving_ = false;
    ++commands_completed_;
}

CORE1_RAM void Device::complete() {
    status_ = ST_DRDY | ST_DSC;
    ++commands_completed_;
}

CORE1_RAM void Device::startDataIn(const uint16_t* words, uint16_t count) {
    data_ = words;
    data_count_ = count;
    data_index_ = 0;
    status_ = ST_DRDY | ST_DSC | ST_DRQ;
    if (!dma_) irq_pending_ = true;  // PIO data-in: interrupt when each block is ready
}

CORE1_RAM void Device::finishDataIn() {
    data_ = nullptr;
    data_count_ = data_index_ = 0;
    if (reading_ && (ahead_ok_ || ahead_failed_)) {  // the next sector is in: on at once
        bool ok = ahead_ok_;
        ahead_ok_ = ahead_failed_ = false;
        deliverSector(ok);  // or its error, at the sector it belongs to
        return;
    }
    if (reading_ && fetch_pending_) {
        status_ = ST_BSY | ST_DRDY | ST_DSC;  // the read-ahead isn't in yet: wait for it
        return;
    }
    if (reading_ && read_left_ > 0) {
        requestFetch();  // read-ahead off: the next sector, under BSY
        return;
    }
    reading_ = false;
    if (dma_) {
        dma_ = false;
        completeNoData();  // DMA: the interrupt comes at the end
        return;
    }
    complete();  // no interrupt at the end of a PIO data-in transfer
}

CORE1_RAM bool Device::dmaBurstReady(DmaBurst& burst) {
    if (!dma_ || dma_burst_running_ || absent_selected_) return false;
    if (reading_ && data_ && (status_ & ST_DRQ)) {
        burst = DmaBurst{data_ + data_index_, nullptr, uint16_t(data_count_ - data_index_)};
    } else if (writing_ && receiving_) {
        burst = DmaBurst{nullptr, sectors_[recv_buf_] + received_, uint16_t(SECTOR_WORDS - received_)};
    } else {
        return false;  // BSY: a fetch, a store or a full buffer first
    }
    dma_burst_running_ = true;
    return true;
}

CORE1_RAM void Device::dmaBurstDone() {
    if (!dma_burst_running_) return;
    dma_burst_running_ = false;
    if (data_) {
        data_index_ = data_count_;
        finishDataIn();  // the next sector at once if read-ahead has it, else BSY
    } else if (receiving_) {
        received_ = SECTOR_WORDS;
        finishDataOut();  // its store, and the next buffer
    }
}

}  // namespace ata
