MaverickUK/HDDSynthPro/src/sector_check.cpp

#include "sector_check.h"

#include "bus_sample.h"
#include "gen_disk.h"

namespace sector_check {

// A sector with at most this many wrong words is a generated sector with
// errors; more, and it's other data that happens to start like one.
constexpr unsigned MAX_BAD_WORDS = 128;

static unsigned popcount16(uint16_t v) {
    unsigned n = 0;
    for (; v; v &= v - 1) ++n;
    return n;
}

// IDENTIFY's words that never change after start-up: serial (10-19),
// firmware and model (23-46), LBA28 capacity (60-61). The rest change with
// SET FEATURES and INITIALIZE DEVICE PARAMETERS (and the checksum with them).
static bool identifyWordIsStable(unsigned i) {
    return (i >= 10 && i <= 19) || (i >= 23 && i <= 46) || i == 60 || i == 61;
}

void Checker::setIdentify(const uint16_t words[256], unsigned unit) {
    for (unsigned i = 0; i < 256; ++i) identify_[unit][i] = words[i];
    have_identify_[unit] = true;
}

unsigned Checker::compareIdentify(unsigned unit, Mismatch& m) const {
    m = Mismatch{IDENTIFY_LBA, 0, 0, 0, 0, 0, 0};
    unsigned matches = 0;
    for (unsigned i = 0; i < 256; ++i) {
        if (!identifyWordIsStable(i)) continue;
        uint16_t want = identify_[unit][i];
        uint16_t seen = words_[i];
        if (seen == want) {
            if (want != 0 && want != 0x2020) ++matches;  // zeros and padding prove nothing: text has spaces
            continue;
        }
        if (m.bad_words == 0) {
            m.first_word = uint16_t(i);
            m.seen = seen;
            m.want = want;
        }
        ++m.bad_words;
        m.bits_lost = uint16_t(m.bits_lost + popcount16(want & ~seen));
        m.bits_gained = uint16_t(m.bits_gained + popcount16(seen & ~want));
    }
    return matches;
}

bool Checker::checkIdentify(bool& is_identify) {
    is_identify = false;
    Mismatch m{};
    unsigned matches = 0;
    for (unsigned unit = 0; unit < 2; ++unit) {
        if (!have_identify_[unit]) continue;
        Mismatch mu;
        unsigned n = compareIdentify(unit, mu);
        if (n > matches) {
            matches = n;
            m = mu;
        }
    }
    if (matches < IDENTIFY_MIN_MATCHES) return false;
    is_identify = true;
    ++identify_checked_;
    if (m.bad_words == 0) return false;
    ++identify_bad_;
    noteStrobes(m);
    mismatch_ = m;
    return true;
}

void Checker::expect(uint32_t lba, const uint16_t words[256]) {
    if (expect_count_ == EXPECT_SLOTS) {  // the oldest was never seen: let it go
        expect_first_ = (expect_first_ + 1) % EXPECT_SLOTS;
        --expect_count_;
        ++expect_missed_;
    }
    Expected& e = expected_[(expect_first_ + expect_count_) % EXPECT_SLOTS];
    e.lba = lba;
    for (unsigned i = 0; i < 256; ++i) e.words[i] = words[i];
    ++expect_count_;
}

void Checker::noteStrobes(Mismatch& m) const {
    if (!HAS_STROBE) return;
    unsigned i = m.first_word;
    m.strobe_ns = strobes_[i];
    m.strobe_before_ns = i > 0 ? strobes_[i - 1] : 0;
    m.strobe_after_ns = i < 255 ? strobes_[i + 1] : 0;
    m.strobe_min_ns = m.strobe_max_ns = strobes_[0];
    for (unsigned k = 1; k < 256; ++k) {
        if (strobes_[k] < m.strobe_min_ns) m.strobe_min_ns = strobes_[k];
        if (strobes_[k] > m.strobe_max_ns) m.strobe_max_ns = strobes_[k];
    }
}

Mismatch Checker::compare(uint32_t lba, const uint16_t* want) const {
    Mismatch m{lba, 0, 0, 0, 0, 0, 0};
    for (unsigned i = 0; i < 256; ++i) {
        uint16_t seen = words_[i];
        if (seen == want[i]) continue;
        if (m.bad_words == 0) {
            m.first_word = uint16_t(i);
            m.seen = seen;
            m.want = want[i];
        }
        ++m.bad_words;
        m.bits_lost = uint16_t(m.bits_lost + popcount16(want[i] & ~seen));
        m.bits_gained = uint16_t(m.bits_gained + popcount16(seen & ~want[i]));
    }
    return m;
}

// Whether the block is one of expect()'s copies exactly: then it's good,
// and that copy and the older ones are done with.
bool Checker::matchesExpected() {
    for (unsigned k = 0; k < expect_count_; ++k) {
        const Expected& e = expected_[(expect_first_ + k) % EXPECT_SLOTS];
        unsigned i = 0;
        while (i < 256 && words_[i] == e.words[i]) ++i;
        if (i < 256) continue;
        expect_missed_ += k;
        expect_first_ = (expect_first_ + k + 1) % EXPECT_SLOTS;
        expect_count_ -= k + 1;
        ++checked_;
        return true;
    }
    return false;
}

// The block against expect()'s copies, oldest first: the first that matches
// is good; failing that, it's reported against the closest. Either way that
// copy and the older ones are done with.
bool Checker::checkExpected() {
    if (expect_count_ == 0) {
        ++skipped_;
        return false;
    }
    unsigned best = 0;
    Mismatch best_m{};
    for (unsigned k = 0; k < expect_count_; ++k) {
        const Expected& e = expected_[(expect_first_ + k) % EXPECT_SLOTS];
        Mismatch m = compare(e.lba, e.words);
        if (k == 0 || m.bad_words < best_m.bad_words) {
            best = k;
            best_m = m;
        }
        if (m.bad_words == 0) break;
    }
    expect_missed_ += best;
    expect_first_ = (expect_first_ + best + 1) % EXPECT_SLOTS;
    expect_count_ -= best + 1;
    ++checked_;
    if (best_m.bad_words == 0) return false;
    ++bad_;
    noteStrobes(best_m);
    mismatch_ = best_m;
    return true;
}

bool Checker::observe(uint32_t word, bool data) {
    uint32_t seq = (word >> SEQ_SHIFT) & SEQ_MASK;
    bool gap = have_seq_ && seq != ((last_seq_ - 1) & SEQ_MASK);
    have_seq_ = true;
    last_seq_ = seq;
    if (gap) {
        ++gaps_;
        count_ = 0;  // part of this sector is missing,
        aligned_ = false;  // and where the next one starts
    }
    uint32_t sample = word & SAMPLE_MASK;
    bus::Block block = bus::block(sample);
    bool dma = block == bus::Block::None;  // DIOR# with no chip select: a DMA word
    if (!dma && (block != bus::Block::Command || bus::address(sample) != 0)) {
        count_ = 0;  // not the data register: the next data read starts a sector
        aligned_ = true;
        return false;
    }
    if (dma) {
        ++dma_words_;
        ++dma_words_total_;
    }
    strobes_[count_] = uint16_t(strobeNs(word));
    words_[count_++] = bus::data(sample);
    if (count_ < 256) return false;
    count_ = 0;
    if (!aligned_) return false;  // perhaps two sectors' halves: not checked
    return finishSector(data);
}

bool Checker::finishSector(bool data) {
    if (!data && matchesExpected()) return false;
    bool is_identify;
    bool bad = checkIdentify(is_identify);
    if (is_identify) return bad;
    if (!data) return checkExpected();
    // The LBA from words 0-1, or failing that from ~words 2-3.
    uint32_t candidates[2] = {
        uint32_t(words_[0]) | (uint32_t(words_[1]) << 16),
        ~(uint32_t(words_[2]) | (uint32_t(words_[3]) << 16)),
    };
    for (uint32_t lba : candidates) {
        if (lba >= disk_sectors_) continue;
        uint8_t bytes[gen_disk::SECTOR_BYTES];
        gen_disk::sector(lba, bytes);
        Mismatch m{lba, 0, 0, 0, 0, 0, 0};
        for (unsigned i = 0; i < 256; ++i) {
            uint16_t want = uint16_t(bytes[2 * i] | (bytes[2 * i + 1] << 8));
            uint16_t seen = words_[i];
            if (seen == want) continue;
            if (m.bad_words == 0) {
                m.first_word = uint16_t(i);
                m.seen = seen;
                m.want = want;
            }
            ++m.bad_words;
            m.bits_lost = uint16_t(m.bits_lost + popcount16(want & ~seen));
            m.bits_gained = uint16_t(m.bits_gained + popcount16(seen & ~want));
        }
        if (m.bad_words > MAX_BAD_WORDS) continue;
        ++checked_;
        if (m.bad_words == 0) return false;
        ++bad_;
        noteStrobes(m);
        mismatch_ = m;
        return true;
    }
    ++skipped_;
    return false;
}

}  // namespace sector_check
