MaverickUK/HDDSynthPro/src/sd_card.h

// The microSD card (slice 5), on core 0. The drive's disk can be an image
// file on it: HDDSYNTH.IMG, the one HDDSYNTH.INI names, or HDDBENCH.IMG for
// tests that write freely. The card may hold other files: nothing here ever
// formats it, and the only files it writes are the image being served,
// images it is asked to create, and HDDSYNTH.INI.
#pragma once

#include <Arduino.h>

#include "block_source.h"
#include "folder_disk.h"
#include "media_watch.h"

namespace sd_card {

constexpr const char* IMAGE_NAME = "HDDSYNTH.IMG";
constexpr const char* BENCH_IMAGE_NAME = "HDDBENCH.IMG";  // scratch, for benchmarks

// Starts the card and prints one line: "SD ok type=... size_mb=... fs=..."
// or "SD error ...". Only reads. Blocks core 0 for up to about a second.
void printInfo(Print& out);

// The card's bus: "sdio" (the PCB build) or "spi". sdio() says whether it
// holds a PIO block; core 1 reads it once, after core 0 has chosen the disk,
// to share out the rest (pio_plan). Core 0 calls sharePio() then: from then
// on SDIO is tried only if it was running, since its block may be in use.
const char* busName();
bool sdio();
void sharePio();
// The PCB: a disc put in at run time (console `M`) kept the PIO block the
// diagnostics lent the parked card, so they're off until a restart.
bool keptDiagnosticsBlock();
// The PCB build: with nothing on the card served (the test disk), sharePio()
// ends SDIO and its block goes to the diagnostics ("sdio-idle"). A card
// operation (S, E, C, I, K...) then calls `lend` to have the diagnostics stop
// and free the block, runs over SDIO, and calls `reclaim` to start them again.
// Set before sharePio(); without them the card stays on SDIO.
void setPioLender(bool (*lend)(), void (*reclaim)());
// The PCB build, running the card over SPI because it didn't start over SDIO
// at boot: true once that card has been taken out and one put back. A card
// put back has been power-cycled, so it starts over SDIO, but only at boot
// (its PIO block went to something else): the caller restarts the drive.
// Until then nothing sends the card the SPI CMD0 that would end that.
bool wantsSdioRestart();

// Mounts the card and opens image `name` if it is there. Returns the image,
// or nullptr (no card, no image, or an error, written to `log`).
// Closes any image opened before. `name` must outlive the open image.
// `read_only`: opened for reading only, for a CD-ROM's disc, which is never
// written, so an ISO with the read-only attribute (as files copied off a CD
// often have) opens too. A hard disk's image opens for writing, or not at all.
ImageFile* openImage(const char* name, Print& log, bool read_only = false);
// Why the last openImage() returned nullptr: "no card", "not found" or "can't open".
const char* openError();

// Whether the open image is one unbroken run of clusters (then seeks are fast).
bool imageContiguous();
// How many runs the image is read and written through directly (0: SdFat's
// file layer, as for a fragmented exFAT image or a map that didn't check out).
unsigned imageExtents();
// The files the served image is in: 1, or more for a split image (NAME.IMG,
// NAME.I01...: image_parts.h), which is served through the extent map only.
unsigned imageParts();

// The settings file (drive_config.h). readConfig() reads up to `size` bytes
// of it into `buf`: false if there is no card or no file; `truncated` if the
// file was longer. writeConfig() replaces it (or creates it) with `text`.
// readConfig() mounts the card first if it isn't (errors go to `log`).
bool readConfig(char* buf, size_t size, size_t& len, bool& truncated, Print& log);
bool writeConfig(const char* text, size_t len, Print& out);
bool configExists();
// Whether the card is mounted: after a failed mount at boot, the caller
// skips the images rather than waiting for the card again for each one.
bool mounted();

// Creates image `name`, zero-filled and `sectors` long, if it doesn't exist
// and the card has room. Takes about a minute for 64 MB, during which core 0
// serves nothing else; the drive goes on using its current disk until reboot.
// Returns false (and says why) without changing anything if it can't.
bool createImage(const char* name, uint32_t sectors, Print& out);

// The card the image is on (media_watch.h). A card pulled out is noticed when
// an image read or write fails; from then on they fail at once, and the image
// is served again only when the same card comes back with it unchanged.
// A read or write that fails is retried once after restarting the card, so a
// card pulled and put back while the drive was idle costs nothing.
const media_watch::Watch& media();
// Times the card was started again after it stopped answering (device 0's or
// device 1's reads, or `S` and `M` finding it silent): CARD lines and `s`.
uint32_t restarts();
// Device 1's disk (docs/two-drives.md), kept apart from the image above so
// device 0's proven path is untouched: a second image through SdFat's
// file layer only (no extent map), or a folder, read-only. An image read or
// write that fails is retried once after restarting the card, with the same
// checks as device 0's (the same card and image); while device 0's card is
// lost or changed they fail at once. A folder's reads aren't retried.
// Reads the first `size` bytes of file `name` (a CD's CUE sheet) into `buf`:
// `truncated` if there's more. Only reads. False, with `why`, if it can't.
bool readFileStart(const char* name, char* buf, size_t size, size_t& len, bool& truncated, const char*& why,
                   Print& log);
// Whether `name`, in the card's root folder, is a folder.
bool isFolder(const char* name);
// Opens image `name` for device 1, or returns nullptr (with openError()).
// `read_only` as for openImage: a CD-ROM's disc (bb48_hdcd).
ImageFile* openDevice1Image(const char* name, Print& log, bool read_only = false);
// Folder `name`'s files and subfolders, for folder_disk::Volume: listed in
// the card's own order, hidden and system entries and names starting with
// a dot left out. A file is read through one open file, kept between reads.
folder_disk::FolderSource& folderSource(const char* name);

// Core 0's loop: while the card is lost, looks for it coming back (a CMD0
// every media_watch::PROBE_MS, under a millisecond); while a different card
// is in, checks that it still is. Restarting a card that answers takes tens
// of milliseconds.
void serviceMedia();

}  // namespace sd_card
