MaverickUK/HDDSynthPro/(commit log)

2026-10-22 Slice 0: listen-only IDE bus trace on the Olimex BB48 (v0.1.0)
    A PIO program captures every IDE register access without driving any
    pin; core 1 timestamps accesses and RESET# edges into a ring, core 0
    merges repeats and streams the trace over USB serial. Includes the
    IDENTIFY block builder for slice 2, C++ host tests, a PIO simulator
    that runs the real program against ATA mode 0 timings, the pytest rig
    (macOS host layer), the wiring table and the amended prototype plan.
    [bus_sample.h, config.h, drive_log.py, host_macos.py, ide_listen.cpp, ide_listen.h, identify.cpp, identify.h]
2026-10-22 Use the platform's built-in pioasm step
    The platform already assembles src/*.pio into headers next to their
    sources; drop the duplicate pre-build script and stop tracking the
    generated header.
2026-10-22 Add the interactive wiring diagram (docs/wiring.html)
    The BB48 to IDE header diagram with a soldering checklist, as a
    standalone page, linked from the README and docs/wiring.md. Also
    retitles the README to HDD Synth Pro.
2026-10-22 Prepare slices 1-3 without hardware
    - ata_device: register file and command state machine (status,
    interrupts, hard/soft reset with signature, absent device 1,
    IDENTIFY, EXECUTE DEVICE DIAGNOSTIC, ABRT for the rest), tested
    against a virtual host's start-up probe.
    - ide_bus.pio + ide_bus.cpp: the slice 1 bus program. IORDY goes low on
    chip select, reads are answered by core 1, writes captured. The PIO
    simulator now covers side-set, pindirs, pull, wait and jmp pin, and a
    mode 0 host model checks tA, t5, t6z, the 1.25 us IORDY limit,
    contention and IORDY never driven high. Not yet used by the firmware.
    - gen_disk: the slice 3 test disk in C++ and Python with shared known
    answer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
    [ata_device.cpp, ata_device.h, check.h, gen_disk.h, gen_disk.py, host_macos.py, ide_bus.cpp, ide_bus.h]
2026-10-22 Add the drive build and READ SECTORS (v0.2.0)
    - bb48_drive (FIRMWARE_SLICE=3): core 1 serves the bus with ide_bus
    and runs ata_device; core 0 fetches sectors from the generated disk
    through FetchMailbox and never blocks on USB serial. Commands are
    traced as CMD/DONE lines; `t` adds raw accesses; `s` reports core 1's
    longest loop pass from the M33 cycle counter.
    - ata_device: READ SECTORS with BSY while core 0 fetches, a DRQ block
    and interrupt per sector, count 0 = 256, LBA and CHS, IDNF before any
    data when out of range, UNC on a failed fetch, stale fetches ignored.
    - BlockSource/GeneratedDisk and FetchMailbox, with a two-thread test
    (clean under TSan: SANITIZE=thread test/run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
    [ata_device.cpp, ata_device.h, block_source.h, drive_log.py, fetch_mailbox.h, ide_listen.cpp, ide_listen.h, main.cpp]
2026-10-22 Record the NS1081 adapter and automate replugs with uhubctl
    The adapter is a Norelsys NS1081 behind a Realtek RTS5411 hub that
    uhubctl controls (both USB 3 and USB 2 halves, -e on macOS). Replug now
    switches every target in HDDPRO_UHUBCTL off, waits, then on; rig.sh
    loads host/rig.env. Tested live: the adapter leaves and re-enumerates.
2026-10-22 Match the drive by its full name; record what the CF card showed
    The NS1081 splits the ATA model into SCSI vendor/product, so diskutil's
    MediaName would be just "PROTO"; find_disk now matches the full
    IORegistry name. A SanDisk CF card worked through the IDE port; the
    adapter's logic is powered by its brick (LED stays lit with USB off).
2026-10-22 Wiring: the adapter drives the IDE lines even with the drive end unpowered
    Seen with a CF adapter whose LEDs stayed lit from the signal lines; an
    unpowered BB48 would be back-fed the same way.
2026-10-22 Handle the housekeeping commands bridges send during setup (v0.3.0)
    Pulled forward from slice 6 so a bridge's setup can't stall slice 2:
    SET FEATURES transfer mode (PIO default / flow-control mode 0; DMA,
    faster PIO, IORDY off and other subcommands abort), INITIALIZE DEVICE
    PARAMETERS (current CHS translation, IDENTIFY words 54-58 and checksum
    updated; reset by hard reset only), READ VERIFY, SEEK, RECALIBRATE,
    STANDBY/IDLE/CHECK POWER MODE (current and ATA-1 opcodes), FLUSH CACHE.
    SET MULTIPLE MODE aborts. Adds a virtual-host bridge setup test.
    [ata_device.cpp, ata_device.h, identify.cpp, identify.h, test_ata_device.cpp, trace_format.cpp, version.h]
2026-10-22 Add a solder-bridge test and the bring-up checklist (v0.4.0)
    Console `x` then `Y` (IDE cable unplugged) pulls up every bus pin and
    its header neighbours, drives each bus pin low in turn for 50 us with
    core 1 paused, reports STUCK and SHORT pins, then reboots. The analysis
    is host-tested against simulated boards with known faults.
    docs/bringup.md walks hardware day from continuity checks to slice 3.
    [main.cpp, short_test.cpp, short_test.h, test_main.cpp, test_short_test.cpp, version.h]
2026-10-22 Add design targets and a draft BOM for the custom PCB
    Targets multiword DMA mode 2 / PIO mode 4 (16.7 MB/s): Ioff LVC buffers
    on every bus line, ATA termination, SDIO 4-bit storage, a pin budget
    that keeps the fast signals in one PIO window, drive-connector power
    with a USB mux, and the optional HDD Synth parts from MK5.
2026-10-22 PCB BOM: I2C expander, images on SD, broad host compatibility
    Slow controls move to a TCA9555 (and RGB to a PCA9633), closing the pin
    budget at 47 of 48 with 30 fast pins in one PIO window. Flash holds
    firmware only; SD holds images, with PSRAM as a write cache tied to the
    supercap. Adds IOCS16# from PIO, a 44-pin header, DOM-style pin-20
    power behind a jumper and polyfuse, power OR-ing, and a host
    compatibility table.
2026-10-22 Classify drive activity as idle, sequential or random (v0.5.0)
    For the HDD Synth to pick a sequential or random sound instead of one
    LED-driven access sound. activity.* (pure, host-tested) marks each media
    command sequential (continuing one of 4 streams) or a seek with its
    distance, and the recent mix as IDLE/SEQ/RAND with hysteresis, a dwell,
    a neutral burst-opening seek and quick settling after waking. The drive
    build runs it on core 0 and prints ACT lines; `m` prints MARK lines.
    Adds a trace replay tool for tuning, a rig test with sequential, random,
    interleaved and idle phases, and docs/activity.md.
2026-10-23 Run core 1 from RAM; first drive detection on hardware (v0.5.1)
    Core 1's per-access code ran from flash, and core 0 evicted it from the
    shared XIP cache, so reads were answered up to 37 us late and the adapter
    gave up on them. Mark it CORE1_RAM and turn off core 1's SysTick, and check
    the bus FIFO between each step of the loop. loop_max_ns now reports the
    longest gap between those checks: about 650 ns. The NS1081 detects the
    drive.
    Docs: the adapter is USB-powered, and uhubctl doesn't cut VBUS on the
    rig's hub, so only a physical replug restarts its IDE side.
    [ata_device.cpp, core1_ram.h, ide_bus.cpp, ide_listen.cpp, identify.cpp, main.cpp, test_slice1.py, version.h]
2026-10-23 Fix the reset stall, restart the PIO after reset, time reads (v0.5.2)
    - Restoring the default geometry at reset recomputed the IDENTIFY checksum
    over 512 bytes from flash (18 us on core 1). Adjust it for the changed
    words only, in RAM, with a unit test.
    - Restart the PIO program when the host releases RESET#, so nothing left
    from the bus going dead (a write-path sample with DIOR# low, answered
    but never pulled) can leave reads one answer behind.
    - Replace loop_max_ns with read_max_ns: the longest a read waited for its
    answer, measured from the last time core 1 saw the FIFO empty.
    Known problems, in the changelog: read_max_ns reports 7-10 us on the rig,
    and the NS1081 fails reads a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
    [host_macos.py, ide_bus.cpp, ide_bus.h, identify.cpp, identify.h, main.cpp, test_main.cpp, test_slice1.py]
2026-10-23 Show BSY when waking from standby, so the NS1081 carries on (v0.5.3)
    After the adapter put the drive in standby, its IDLE IMMEDIATE completed at
    once and raised INTRQ, which the adapter's own status read cleared before it
    waited for the interrupt; it then failed every read until replugged. Waking
    now shows BSY for 50 us and then interrupts, as a CF card does (seen by
    listening to one on the adapter's 44-pin header). Verified on the rig: the
    adapter waits ~2.5 s after the wake, then reads normally.
    [ata_device.cpp, ata_device.h, config.h, main.cpp, test_ata_device.cpp, version.h]
2026-10-24 Time reads from the host's side with a PIO IORDY timer (v0.5.4)
    A second PIO program, reading pins only, times each read from DIOR#
    falling to IORDY high and reports those held over 400 ns; console `s`
    shows the count and the longest. Both it and read_max_ns restart when the
    host releases RESET#, so the host's power-up (strobes floating low) no
    longer looks like a long read.
    On the rig nearly every read is held over 400 ns and the worst is 3.7 us,
    against ATA's 1.25 us: core 1 answers reads too slowly.
    [config.h, iordy_timer.cpp, iordy_timer.h, main.cpp, test_iordy_timer_sim.py, version.h]
2026-10-24 Put the bus first on core 1 and answer reads before side effects (v0.5.5)
    - loop1() serves every waiting access back to back and does one small
    bookkeeping step only when the FIFO is empty.
    - Device::read() splits into an inline peek() and consumeRead(); the bus
    layer answers with peek() and catches up afterwards. Registers come from
    a 32-entry table instead of being decoded per access.
    - Slice 1 checks the IORDY timer against ATA's 1250 ns (tB); core 1's own
    read_max_ns estimate is gone.
    On the rig the longest read went from 3.7 us to 1.28 us. Typical reads are
    still over 400 ns, which is fixed overhead around core 1; DMA-fed data
    reads come next.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
    [ata_device.cpp, ata_device.h, ide_bus.cpp, ide_bus.h, main.cpp, test_slice1.py, version.h]
2026-10-24 Add WRITE SECTORS with a RAM overlay disk and write flow control (v0.6.0)
    The drive is now a read/write IDE disk in PIO mode 0 (slice 4).
    - WRITE SECTORS (30h/31h) with ATA's data-out handshake, through the same
    Fetch and mailbox as reads (Fetch::store); a failed store ends with ABRT.
    - RamOverlayDisk keeps up to 512 written sectors in RAM on top of the
    generated disk, so the disk keeps its size and contents.
    - The bus program holds IORDY on a write while its RX FIFO is full, so a
    256-word sector can't outrun core 1. In simulation a slow core 1 lost 98
    of 256 words before and none after. ide_bus.pio is now 32 instructions.
    - The PIO simulator models mov-from-STATUS and core 1's time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
    [ata_device.cpp, ata_device.h, block_source.h, config.h, ide_bus.cpp, ide_host_model.py, main.cpp, pio_sim.py]
2026-10-24 Queue commands on the bus and keep core 1 on the bus mid-sector (v0.6.1)
    - A Command write from the bus only sets BSY (Device::queueCommand); core 1
    runs the command next. write(StatusCommand) still runs it at once.
    - While a DRQ block is streaming, core 1 serves the bus and checks RESET#
    only.
    - The trace's CMD line is recorded as the command starts.
    Slices 1-4 and the activity test pass on the rig. The worst read around
    detection still varies from 1.03 to 1.35 us between replugs; its cause is
    not yet known.
    [ata_device.cpp, ata_device.h, ide_bus.cpp, main.cpp, test_ata_device.cpp, version.h]
2026-10-24 Name the register of the slowest read in the IORDY timer (v0.6.2)
    Each slow-read report now carries the register (DA2-0, CS0#, CS1# sampled
    as DIOR# falls), and console `s` shows iordy_max_reg and iordy_max_at_us.
    The PIO simulator models `in`.
    On the rig the worst read around detection is a DATA read (2.2 us on one
    replug), not a status poll. The NS1081 can only be made to re-detect the
    drive by a physical replug.
2026-10-24 Get back to the bus straight after running a command (v0.6.3)
    The status poll right after IDENTIFY or SET FEATURES could wait up to
    1.6 us, because core 1 ran the queued command and recorded its trace
    lines in one go. Core 1 now runs the command and returns to the bus,
    records the CMD line later (with the time taken when it ran), and writes
    at most one trace line per bookkeeping step. Worst read around detection
    on the rig: about 1 us (993-1006 ns), from 1.03-2.2 us.
    Also gives core 1 high bus priority, adds fast-peripheral bus contention
    counters to `s`, and keeps .claude/settings.local.json out of git.
2026-10-24 Add the slice 6 soak test
    Hours of mixed traffic with every byte checked: random reads across the
    generated disk, random writes read back in the RAM overlay window, and
    idle pauses. Every five minutes it checks the drive's own view (no failed
    commands, resets or lost trace events; IORDY within 1250 ns). A mismatch
    is diagnosed in the log: whose data came back, shifted or not, whether a
    re-read is right.
    On the rig a 60-minute run passed (2.3 GB, no mismatches, IORDY max
    953 ns); one earlier shakedown saw a single transient mismatch, not yet
    explained.
    [test_soak.py]
2026-10-24 Wire up the microSD breakout and add an SD card check (v0.6.4)
    The breakout sits on GPIO 34-39 so the same leads serve SPI now (SPI0's
    pins, DAT3 as chip select) and 4-bit SDIO later. Console `S` starts the
    card over SPI with SdFat and reports its type, size and filesystem; it
    refuses to start if SPI0 rejects the SD pins, since SPI0's defaults on
    this board are IDE data lines. Adds docs/wiring-sd.html and a wiring.md
    section. On the rig: SDHC, 30436 MB, FAT32, first time.
2026-10-24 Serve the disk from an image file on the SD card (v0.7.0)
    Slice 5: at boot core 0 mounts the SD card and, if HDDSYNTH.IMG is there,
    serves it as the disk (ImageDisk over an ImageFile, SdFat over SPI);
    otherwise the generated disk with its RAM overlay as before. Core 1 waits
    for the choice so IDENTIFY reports the image's size. Console `I` creates a
    zero-filled 64 MB image only if none exists and there's room; nothing
    else on the card is ever touched.
    Slice 3, slice 4 and the soak skip on an image, since they compare with
    the generated pattern and two of them write to it.
    On the rig macOS formatted the image FAT32 and mounted it; files written
    to it survived a full power cycle.
    Co-Authored-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
    [block_source.h, main.cpp, sd_card.cpp, sd_card.h, test_ata_device.cpp, test_slice3.py, test_slice4.py, test_soak.py]
2026-10-24 Light the BB48's LED for drive activity, and bring the docs up to date (v0.7.1)
2026-10-24 Soak: idle long enough for macOS's disk sleep, and keep the descriptor while paused
    The 60 s pauses never produced a standby: macOS's disksleep is 10 minutes,
    and the adapter's '40 s idle' timer wasn't backed by evidence. Pauses are now
    11 minutes once an hour (configurable), with the raw device closed. While
    paused the descriptor points at /dev/null instead of being freed, which
    another thread could reuse (the first attempt failed with EBADF).
    [test_soak.py]
2026-10-25 Diagnose the rare read mismatch: early-read counter, debug read delay (v0.7.2)
    The IORDY timer now reports reads that start before IORDY is low, and
    console D<digit> makes core 1 answer data reads late. On the rig neither
    the strobe recovery nor an IORDY timeout explains the mismatch: no early
    reads in 15 minutes, and clean reads with IORDY held up to 3.2 us.
2026-10-25 Add a bus observer that checks data sectors on the cable (v0.7.3)
    A third PIO program samples the bus just before each DIOR# rise; DMA
    copies the samples to a RAM ring and core 0 checks every data sector
    against the generated disk, printing BUSERR for a wrong one. The soak
    now says whether a mismatch was already wrong on the cable.
    [bus_observer.cpp, bus_observer.h, main.cpp, sector_check.cpp, sector_check.h, test_bus_observer_sim.py, test_main.cpp, test_sector_check.cpp]
2026-10-25 Answer data reads from a fast lane on core 1 (v0.8.1)
    While the host reads a DRQ block, core 1 answers data reads straight
    from the buffer. Sequential reads go from 0.87 to 1.05 MB/s. A new check
    fails the build if core 1 can reach code in flash, which is what slowed
    the first attempt (an out-of-line std::atomic<bool>::load).
    [ata_device.cpp, ata_device.h, core1_ram.h, ide_bus.cpp, ide_bus.h, main.cpp, test_ata_device.cpp]
2026-10-25 WIP: FLUSH CACHE, write cache, SET FEATURES trace, read-ahead tuning and switches (0.8.11, untagged)
    FLUSH CACHE flushes the storage; IDENTIFY declares a write cache and FLUSH
    CACHE; SET FEATURES 02h/82h switch the cache (off: each sector synced);
    SET FEATURES lines show the subcommand; disk_ms in stats; console A and F
    switch read-ahead and the fast lane for comparisons. The read-ahead is
    posted after the first data word of a block. Worst read ~1,190 ns: being
    bisected.
2026-10-25 Worst read back near 1 us with read-ahead; FLUSH CACHE and write cache (v0.8.15)
    Bisected the read-ahead's cost to its handover: the read-ahead is now
    posted after a block's first data word, status polls in the fast lane are
    answered before the bookkeeping, and the lane's rare case is out of line.
    Worst read 1,053-1,080 ns at 1.24 MB/s. FLUSH CACHE flushes the SD card;
    IDENTIFY declares a write cache, which SET FEATURES 02h/82h switch.
2026-10-25 Scratch bench image and write-behind, off by default (v0.8.22)
    HDDBENCH.IMG (console K, J) lets benchmarks write to the card without
    touching HDDSYNTH.IMG. Write-behind lifts card writes from 0.92 to
    1.51 MB/s with data intact, but holds some status reads 1.5-2 us during
    writes, so it is off until that is understood. A 10 us BSY after each
    data-out block keeps the NS1081 from missing INTRQ.
    [ata_device.cpp, ata_device.h, config.h, fetch_mailbox.h, main.cpp, sd_card.cpp, sd_card.h, spsc_ring.h]
2026-10-25 Soak: optionally ride out host-side resets; record today's soaks on 0.8.22
    HDDPRO_SOAK_TOLERATE_RESETS=1 logs a host reset (macOS resetting the
    adapter, as a USB glitch did at 13:34), waits for the re-detection,
    restarts the read timings, reopens the disk and re-checks the write
    window, at most 3 times. Mismatches and faults in normal traffic still
    stop it. Today on 0.8.22: 1 h clean before that reset, then 4.5 h clean.
    [test_soak.py]
2026-10-25 Activity link docs: the HDD Synth side is built (HDDSynth_Native v0.18.0)
    The synth's setting is EXPERIMENTAL_HDDSYNTHPRO_SUPPORT (a feature flag, in
    place of the brief's ACTIVITY_LINK), plus SEQUENTIAL_LED_COLOUR (default
    orange) for the activity LED during sequential transfers.
2026-10-26 Run the rig from Windows as well as macOS
    host.py holds what doesn't depend on the OS (replug, find_disk, and
    pread/pwrite, which Python lacks on Windows); make_host() picks
    host_macos.py or the new host_windows.py, which finds the drive with
    Get-Disk and opens \.\PhysicalDriveN (needs an administrator terminal).
    pyserial doesn't report the USB product on Windows, so find_port falls
    back to the only port with the board's vendor ID (Olimex 15BA). rig.sh
    copes with Git Bash (venv layout, python, PlatformIO's path) and skips the
    native tests without a c++; .exe tool lookups; .gitattributes keeps shell
    scripts LF.
    On Windows 11 through the NS1081: a 5-minute soak on 0.8.22 clean, 9,300
    commands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
    [drive_log.py, host.py, host_macos.py, host_windows.py, pio_sim.py, test_activity.py, test_iordy_timeout.py]
2026-10-26 Record the 8-hour Windows soak on 0.8.22 (13.5 h clean in all)
    380 minutes from Windows, cut by a Windows Update restart, then the last
    100: 22.1 GB, 760,622 commands, 37.8 million sectors checked on the cable,
    no mismatches, worst read 1,120 ns. With the 5.5 h from macOS, the old
    mismatch's chance of still being there at its old rate is near 1%.
    Windows never sent STANDBY in the idle pauses, so standby and wake
    weren't tested from it.
2026-10-26 Measure write-behind's slow status reads; print SLOWREAD lines (v0.8.23)
    Every read IORDY holds past ATA's 1,250 ns now prints a SLOWREAD line
    (register, ns), and the Python parser keeps them. With write-behind on,
    3-minute soaks on the generated disk give 32-39, all ALTSTATUS after a
    written block, worst 1,280 ns; off, none.
    A per-pass probe (core 1 timing its loop passes with SysTick) showed
    bookkeeping passes of 400-730 ns even idle and over 1 us for finishing a
    sector, posting its store and taking the result, but its own work pushed
    slow reads into the thousands, so it isn't kept. Finishing the sector
    later (as the next job, after ALTSTATUS, after STATUS) only moved the
    slow read to STA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
2026-10-26 Keep core 0 from falling behind on IORDY reports; write-behind's slow reads gone (v0.8.24)
    iordy_timer::poll() drained the IORDY timer's FIFO until empty and, since
    0.8.23, converted every report to ns (a 64-bit divide) to find SLOWREADs.
    With a report every few microseconds core 0 stayed there for hundreds of
    microseconds: read-aheads were picked up late (reads 0.87 instead of
    1.27 MB/s when more reads crossed 400 ns) and its polling of the PIO held
    up core 1's PIO accesses, which is what pushed write-behind's status reads
    past 1.25 us. Reports are now compared with a limit worked out once, only
    those past it are converted, and a call takes at most 8.
    Write-behind on: 0 slow reads in 3- an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
2026-10-27 Record the overnight soak on 0.8.24 with write-behind on (21.5 h clean in all)
    8 hours from Windows with write-behind on: 22.1 GB, 760,100 commands, no
    mismatches, no resets, no reads past 1,250 ns (worst 1,173 ns), 37.9
    million sectors checked on the cable. Core 1's code is the same as
    0.8.22's, so the rare mismatch has now gone unseen for 21.5 hours.
    Write-behind's last check before it goes on by default: the SD card.
2026-10-27 Add the HDDSynthPro PCB: a PGA2350 IDE drive board in KiCad
    hardware/ holds a 4-layer, 85 x 76 mm board: the PGA2350 (RP2350B) with
    the 40-pin IDE header on the left edge behind four SN74CB3T3245 bus
    switches (5 V tolerant, isolated when unpowered), USB-C and a 5 V input
    diode-ORed, the activity-link socket, microSD, LEDs and the logo. ERC and
    DRC are clean, with no differences between schematic and board.
    The GPIO map is the one in src/config.h; tools/check_netlist.py traces
    every IDE line from its GPIO to its header pin and checks it. The board
    adds GP41 (BUS_EN#, the switches' enable; JP1 ties it low for firmware
    that doesn't drive it), GP40 (card detect) and reserves GP31/GP3 for DMA.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
    [hddsynthpro.kicad_pcb, hddsynthpro.kicad_sch, ide.kicad_sch, mcu.kicad_sch, power.kicad_sch, sd.kicad_sch]
2026-10-27 Add the board's 3D model and the Fabrication Toolkit's JLCPCB output
    HDDSynthPro.step is the assembled board's 3D model; production/ holds the
    Gerbers, BOM and positions the KiCad Fabrication Toolkit plugin wrote for
    JLCPCB, with its settings in fabrication-toolkit-options.json.
    [HDDSynthPro.step, bom.csv, designators.csv, positions.csv]
2026-10-27 Record write-behind on the SD card: still slow reads, and what's ruled out
    On HDDBENCH.IMG write-behind lifts writes from 0.90 to 1.47 MB/s but holds
    about 2,000 ALTSTATUS reads per 16 MB past 1.25 us (worst 1.5-2.0 us).
    Ruled out on the rig: fast peripheral bus contention, core 1's timer read
    stalling behind core 0's SPI traffic, DMA. Posting the next store before
    raising INTRQ made the adapter hang and was reverted. Next: GPIO markers
    on a logic analyser. Write-behind stays off by default.
2026-10-27 Test the NS1081's detection sequence in CI; note that 37.5 MHz SD needs rewiring
    test_ns1081_detection replays the adapter's detection as the drive's trace
    shows it on every replug and host reset: two RESET# pulses, IDENTIFY twice
    (INTRQ, then Status to acknowledge), SET FEATURES for PIO flow-control
    mode 4 refused with ABRT, mode 0 accepted, then a write and reads. It was
    only visible on the rig with a physical replug.
    SD at 37.5 MHz (SD_SPI_MHZ = 50) was tried on 0.8.24: the card didn't
    start (SdFat error 30), so the drive fell back to the generated disk.
    Recorded in the speed log; the leads need shortening first.
    [test_ata_device.cpp]
2026-10-27 Send the drive's activity to an HDD Synth over a UART (v0.9.0)
    The activity link's HDDSynthPro side (docs/activity-link.md): $HDA
    sentences with busy (the LED's flag), the classifier's idle/sequential/
    random and the last command's read/write, on UART0 TX (GPIO 0, 115200),
    on every change and every 200 ms. Written through the Pico SDK only when
    the TX FIFO is empty, so core 0 never waits; GPIO 1 stays untouched.
    Console L turns it off and on; s shows what it sent.
    host/hddproto/activity_link.py is the receiver's reference parser; C++ and
    Python tests share the spec's known answers. On the rig it sends (541
    sentences over the speed and activity tests) at no cost to the bus: reads
    1.26 MB/s,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
2026-10-27 Choose the disk image and transfer mode in HDDSYNTH.INI on the SD card (v0.10.0)
    docs/settings.md: `image = <file>` and `mode = auto|pio0..udma6`, plain
    key = value text read at start-up (src/drive_config.*, pure and
    host-tested). A missing file or key means the defaults, so a card without
    it behaves as before; mistakes are reported (console S) and skipped. The
    disk: HDDBENCH.IMG after J, the configured image, HDDSYNTH.IMG if that
    can't be used, the generated disk. Modes other than PIO 0 are accepted
    with a warning and mean auto until they exist.
    Console C creates the file with the defaults, E sets one setting keeping
    the file's comments, ! restarts. The firmware may now write HDDSYNTH.INI,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
    [drive_config.cpp, drive_config.h, main.cpp, sd_card.cpp, sd_card.h, test_drive_config.cpp, test_main.cpp, version.h]
2026-10-27 Add the activity link's loopback test, console U (v0.10.1)
    With a jumper from GPIO 0 to GPIO 1, U reads back what the link sends for
    a second and checks it with activity_link::Receiver, a byte-at-a-time
    receiver with the reference parser's rules that the HDD Synth can copy.
    The UART is reset between sentences as listening starts, so breaks read
    before GPIO 1 was its input, and the overrun mark after them, don't count.
    [activity_link.cpp, activity_link.h, main.cpp, test_activity_link.cpp, test_link_loopback.py, version.h]
2026-10-27 Rework the slice 0 test around a capture window after each RESET# (v0.10.2)
    With no drive answering, the adapter probes forever and the listen build's
    trace ring overflowed, so the test could never pass. Console w now records
    a window of 3,000 accesses after each RESET# assert and only counts the
    rest; the test judges the trace from the first release and compares its
    opening with a reference kept per adapter (HDDPRO_ADAPTER). Its checks
    pass on a probe recorded on the Windows rig, whose adapter is a JMicron.
    [config.h, main.cpp, test_slice0.py, test_trace_parse.py, trace.py, version.h]
2026-10-27 Re-detect the drive without a replug, and fix two detection bugs it found (v0.11.0)
    Console V takes the drive off the bus until the adapter's next RESET#, so a
    failed read makes the adapter reset, probe and detect it again: a hands-free
    replug for slices 1-2 (HDDPRO_REPLUG=redetect). Thirty cycles of it found:
    - A command written over an unread data-in block (the JMicron gives up on a
    READ or IDENTIFY partway) kept the stale block, so loop1 never took the
    new fetch's result and the drive stayed BSY for good. Now abandoned.
    - A command cut short by a reset never counted as completed, so the LED
    and the HDD Synth link's busy flag stayed on. Now counted.
    The bus observer also checks IDE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
    [ata_device.cpp, ata_device.h, bus_observer.cpp, bus_observer.h, fetch_mailbox.h, host.py, ide_bus.cpp]
2026-10-27 PCB rev 0.2: RP2350B on the board instead of the PGA2350 module
    The PGA2350 is replaced by an RP2350B with Raspberry Pi's minimal-design
    support circuit: their core regulator (polarity-marked inductor), 12 MHz
    crystal, W25Q128 flash and USB 27R, with their regulator, QSPI and USB
    layout copied relative to the VREG_LX pin; an AMS1117 makes 3V3. GPIO
    numbers are unchanged. Supply pins each have a via under the chip.
    Cheaper parts from the HDD Synth Mk5: HRO TYPE-C-31-M-12 USB-C, TS-1187A
    buttons, and a generic TF PUSH microSD socket. The CB3T3245 bus switches
    stay. Every symbol carries its LCSC part number, and Fabrication Toolkit
    offsets where JLCPCB's footprint differs from KiCad's; jlcpcb.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
    [hddsynthpro.kicad_pcb, hddsynthpro.kicad_sch, ide.kicad_sch, mcu.kicad_sch, power.kicad_sch, sd.kicad_sch]
2026-10-27 Record the Windows rig's adapter trouble and why the slow-read fix isn't shipped
    The same USB-IDE adapter enumerates as a JMicron on the Windows PC, plugged
    straight in, and by the end of a long session corrupted its own USB serial
    and the IDENTIFY names while the bus observer saw every IDENTIFY right on
    the cable. A fix for the slow STATUS read after IDENTIFY took slow reads to
    zero but made the adapter re-detect and drop the disk far more often, so it
    stays out; CLAUDE.md says how to retry it fairly.
2026-10-27 PCB rev 0.3: HDD Synth Mk5 outline and holes, 5 V in on the link socket
    - The board takes the Mk5's outline (100.33 x 69.88 mm, 2.54 mm corners)
    and its four M3 holes, so the two boards stack on standoffs. The IDE
    header moves inside the left-hand holes; everything else shifts right.
    The logo still fits on the front.
    - J3 pin 1 takes 5 V from the HDD Synth through D5 (SS14) into VB, beside
    USB and the 5 V header, so one supply can run both boards. The Mk5's J6
    pin 1 is 3.3 V, so leave it unconnected with a Mk5.
    - check_netlist.py checks the new input; rerouted with Freerouting: ERC 0,
    DRC 0 errors, 0 unconnected, 0 parity issues.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
    [bom.csv, designators.csv, hddsynthpro.kicad_pcb, hddsynthpro.kicad_sch, ide.kicad_sch, mcu.kicad_sch, positions.csv, power.kicad_sch]
2026-10-27 Serve the built-in test disk with the card in: image = none (v0.12.0)
    The soak and slices 3-4 need the generated disk, since only its data can
    be checked on the cable, but it was served only with no card. `image =
    none` in HDDSYNTH.INI (console E, then !) serves it and leaves the card
    alone. A 5-minute soak on it from Windows: 266 MB, no mismatches, 456,215
    sectors checked on the cable.
    Also: slices 1 and 2 pass 20 unattended redetect cycles each on 0.11.1,
    and CLAUDE.md keeps SD at 37.5 MHz for the custom PCB.
2026-10-28 Re-mount the SD card when the same card comes back unchanged (v0.13.0)
    A card pulled out is noticed when an image read or write fails (CARD lost);
    reads and writes then fail at once, and a hand-sent CMD0 every 250 ms looks
    for it coming back. The image is served again (CARD back) only if it's the
    same card (CID) with the image unchanged (size, first sector, modify time):
    another card or an edited image would be corrupted by the host's cache, so
    it's refused (CARD changed) until the right card is back or a restart. A
    failed read or write is retried once after restarting the card, so a card
    swapped while idle costs nothing. Rig test -m card, for the bench.
    Also records the 10-hour soak on 0.1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
    [main.cpp, media_watch.cpp, media_watch.h, sd_card.cpp, sd_card.h, test_card.py, test_main.cpp, test_media_watch.cpp]
2026-10-28 test_card: the adapter may hide the failed read by retrying it
    When the card is back before the adapter's reset (about 20 s after the
    failed read), the reset retries the read and it succeeds, so the host sees
    a slow read and no error. Seen twice on Windows.
    [test_card.py]
2026-10-28 Record the card re-mount passing on the rig
2026-10-28 Slice 0 passes with a physical replug; save the reference only from a passing run
    By hand, the test now has the adapter unplugged until the bus is quiet
    (plugged in with no drive it pulses RESET# every 4.8 s, which was taken for
    the power-up), and waits for the first access, about 2.6 s after the
    adapter's second reset, instead of 2 s of quiet. A reference is written only
    after the checks pass. The Windows rig's reference, and a second power-up
    matching it.
    [test_slice0.py]
2026-10-28 Run the RP2350 at 200 MHz instead of 150 (v0.14.0)
    Core 1 answers every read in instructions, so the clock is headroom: the
    worst read in traffic and detection fell from 1,173-1,320 ns to 850-920 ns,
    detection's slow reads are gone (0 in 12 redetect cycles), and reads rose
    from 1.23 to 1.31 MB/s. The peripheral clock is kept on the system clock, so
    the card's SPI stays at 25 MHz. The bus program's data settle before IORDY
    is 40 ns now (ATA's tRD is 0); the PIO simulator runs at 200 MHz and the bus
    program meets every mode 0 timing there. Write-behind on the card holds no
    reads now (160 MB verified, 1.61 MB/s), but its worst read is 1,250 ns, so it
    stays off by default.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
2026-10-28 Offer PIO modes 1-3; the adapter now runs the bus in mode 3 (v0.15.0)
    IDENTIFY offers PIO modes up to HDDSYNTH.INI's `mode` (auto: 3), and SET
    FEATURES accepts them. The adapter asks for mode 4, then takes the fastest
    word 64 offers (3), never 1 or 2. The bus program serves every mode the same
    way, holding IORDY while core 1 answers; the simulator now holds it to modes
    0-3's timings. Mode 4 isn't offered: its write data can fall between two of
    the program's samples.
    On the rig, mode 3 against mode 0 on the generated disk: reads 1.36 against
    1.33 MB/s, writes 1.79 against 1.58. The adapter itself paces reads at about
    1.1 us a word in any PIO mode, so DMA modes, not faster PIO, are the way to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
2026-10-28 Multiword DMA's data phase, proven in the simulator (docs/dma.md)
    ide_dma.pio serves READ DMA and WRITE DMA words from the FIFOs, fed by
    RP2350 DMA, since there's no IORDY in DMA and mode 2 gives 50 ns from
    DIOR# to data. A multiword DMA host model holds it to modes 0-2's timings:
    every word right over two-sector transfers, read data within tE and held
    tF, DMARQ falling 10 ns after each burst's last strobe begins, short and
    single-word bursts, DD released between strobes. Not in the firmware yet.
    [mdma_host_model.py, pio_sim.py, test_dma_sim.py]
2026-10-28 Multiword DMA in the firmware, offered only with mode = mdma0-2 (v0.16.0)
    READ DMA and WRITE DMA run the same fetches, read-ahead and write-behind as
    PIO, with one interrupt at the end. ide_dma.cpp runs ide_dma.pio in a PIO
    block of its own, fed or drained by a DMA channel, hands DD0-15 to that
    block for each read burst and back after it, and drives DMARQ (GPIO 31)
    only during a DMA command. Not yet tried on hardware: on the BB48 rig DMARQ
    and DMACK# aren't wired, so DMA is offered only when HDDSYNTH.INI asks for
    it. With it off, nothing changes: slices 3-4 pass in PIO mode 3, 335,019
    sectors checked on the cable, 0 bad.
2026-10-28 Design: how SDIO, DMA and the diagnostics share the three PIO blocks
    One build, blocks assigned at start-up; the diagnostics are off only when an
    image is served with DMA offered. Records the options weighed, why one
    build (core 1's layout, and so test results, stay the same in every
    configuration), what's given up, and how to build it, including that a card
    put in SPI mode stays there until power-cycled.
2026-10-28 Add PCBWay fab output, update the 3D model, write up unattended soaks
    [HDDSynthPro.step]
2026-10-28 PIO allocation: on hold until DMA runs; what SdFat's SDIO driver showed
2026-10-29 Multiword DMA works on the rig: fix the lost first word and a slow poll (v0.16.2)
    With DMARQ and DMACK# wired, the adapter takes multiword DMA mode 2. Two
    bugs found on the way: DMARQ rose on the pull of the first word, before DMA
    had put it in the FIFO, so word 0 of every sector read 0048h (DMARQ now
    rises after the pull; the simulator's DMA now arrives after the count, as
    on the hardware, and catches it); and ending each command reset the whole
    DMA program in one step, holding the status poll after it 1.54 us.
    On the built-in disk, against PIO mode 3: reads 5.14 against 1.36 MB/s,
    random 4 KB reads 969 against 78 a second, writes 9.76 against 1.79 MB/s.
    The adapter's 10 ms poll per READ w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
    [config.h, ide_dma.cpp, mdma_host_model.py, test_dma_sim.py, test_slice3.py, test_slice4.py, test_speed.py, trace_format.cpp]
2026-10-29 The bus observer checks multiword DMA data on the cable (v0.16.3)
    A read with no chip select is a DMA word; the checker now takes it as data.
    331,090 sectors checked on the rig in DMA, 0 bad. Checking every word halves
    DMA reads on the built-in disk (core 0 computes each sector twice).
2026-10-29 Soak: count DMA commands and DMA words, and HDDPRO_SOAK_REQUIRE_DMA
    So a DMA soak's log shows it moved data by DMA, and fails if the host falls
    back to PIO.
    [test_soak.py]
2026-10-29 Find out at start-up whether DMARQ is wired, and never offer DMA without it (v0.16.4)
    A pull-up on GPIO 31 against the host's pull-down: a wired pin reads 0. DMA
    is refused, with a warning, when HDDSYNTH.INI asks for it without DMARQ.
    cfg::AUTO_DMA (off until the DMA soak) lets mode = auto offer it.
2026-10-29 Record the SDIO experiment on the rig: unreliable on the hand-wired leads
    25 MHz: directory lookups failed; 12.5 MHz: reads fine but a write dropped
    the card. Slower gives nothing over SPI, so SDIO waits for the PCB.
2026-10-29 PCB rev 0.4: what to add, in priority order (docs/pcb-rev04.md)
2026-10-29 Catch a host that doesn't wait for IORDY (v0.16.5)
    iordy_check.pio counts reads whose DIOR# rose while IORDY was still low: such
    a host reads garbage. s shows iordy_ignored; NOIORDY lines if it's not 0.
    Simulator tests cover hosts that wait, hosts that don't, back-to-back data
    reads and DMA strobes. 0 on the rig through the USB adapter.
    [iordy_timer.cpp, iordy_timer.h, main.cpp, test_iordy_check_sim.py, version.h]
2026-10-29 Switch the PCB's IDE bus on, test DMARQ after it, and write the bring-up plan (v0.16.6)
    Core 1 drives BUS_EN# (GPIO 41) low once ide_bus has set the bus pins up, and
    only then tests DMARQ and decides the DMA offer; the listen build switches
    the bus on too. p shows SD_CD and BUS_EN#. docs/pcb-bringup.md is the first
    day with the board. Unconnected pins on the BB48: no change on the rig.
2026-10-29 Write-behind on by default, and on/off settings in HDDSYNTH.INI (v0.17.0)
    dma, write_behind, read_ahead and activity_link: on/off in the settings
    file, set with console E, shown by S; W, A and L still switch them until a
    restart. Write-behind defaults on (card writes 1.65 against 1.05 MB/s, 192 MB
    verified, worst read 1,040 ns). cfg::AUTO_DMA becomes the dma setting.
2026-10-29 CLAUDE.md: rewrite the status section from the current state (0.17.0)
2026-10-29 Record the 20-minute DMA soak and DMA writes to the card
2026-10-29 Record the 6-hour DMA soak: data clean, three observer findings to fix before DMA is the default
2026-10-29 Fix the bus observer's DMA findings: settle before watching DIOR#, a 16 KB ring, a 64-bit word count (v0.17.1)
    The DMA read program now waits 20-25 ns after driving DD before watching
    DIOR#, whose unsynchronised input took all 16 lines switching for the end
    of the strobe (LBA 65535's word 3: 24% flagged, now 0). The observer's
    ring grows to 16 KB with a high-water mark in `s`, and bus_dma_words is
    64-bit.
    [bus_observer.cpp, bus_observer.h, main.cpp, sector_check.h, version.h]
2026-10-29 Record 0.17.1's 60-minute DMA soak: 0 bad, 0 gaps; the soak shows the observer's ring high-water mark
2026-10-29 Design note: answering hosts that don't wait for IORDY (docs/no-iordy.md)
    A register table in RAM looked up by PIO and DMA without core 1, the data
    register streamed by DMA, and the PIO setting BSY after a command. Also
    notes the BB48's missing IOCS16# for some ISA cards, in the retro checklist.
2026-10-30 0.18.0 on the rig and the 10-hour DMA soak; refresh Windows' partitions before raw writes
    The welcome disk mounts on Windows with its README; slices 1-2 pass;
    -m speed matches 0.17.x. Windows kept the welcome disk's volume after a
    switch to the test disk and refused writes inside it, so the Windows host
    runs Update-Disk before opening the disk for writing. Also records
    0.17.1's 10-hour DMA soak: 51.9 GB, 89 million sectors checked, 0 bad,
    0 gaps.
2026-10-30 Bus observer spot checks: DMA at full speed, full checks on console O (v0.18.1)
    Checking a sector costs core 0 more than serving it, so the observer held
    multiword DMA reads to about 2 MB/s. By default it now serves fetches
    between checks, drops samples it can't keep up with (bus_dropped), and
    resumes at the next sector start, found from the sector's LBA header even
    mid-command. Possible overruns, which the 11-bit sequence numbers can't
    show with a 4,096-sample ring, are detected by time (bus_lost). Console O
    switches to full checks; the soak uses them. Test disk, MDMA 2: reads
    7.70 MB/s (was 5.14), writes 13.9 MB/s (9.76).
2026-10-30 Head positions and seek timing (0.19.0); first retro PC boots: ICL 386 over ISA (0.19.1-0.22.0)
    0.19.0, activity link protocol version 2 (docs/hddsynth-head-position-brief.md):
    $HDE head targets per media command, authentic seek timing (seek_timing in
    HDDSYNTH.INI, holding results on core 0 by HDD Synth's drive model), and the
    synth's $HDM received on GPIO 1. Host-tested only.
    ICL HRA 386 with a plain ISA IDE card, now booting MS-DOS 5 from the SD card:
    - 0.19.1: INTRQ driven low between interrupts (the card has no pull-down, so
    IRQ 14 never saw an edge); no answers on the control block's other ports,
    where the floppy controller lives (3F2h-3F5h).
    - 0.20.0: IOCS16# from iocs16.pio on GP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
2026-10-30 Read timing probe: t1 and strobe per read, for sizing the no-IORDY design (0.23.2)
2026-10-30 Early answers: core 1's tight bus loop after each access (0.23.4)
    [ide_bus.cpp, ide_bus.h, main.cpp, version.h]
2026-10-30 Early answers: stay in the tight loops through commands and status polls (0.23.6)
    [ide_bus.cpp, main.cpp, version.h]
2026-10-30 Early answers: sample writes before discarding, stay in the tight loop when idle, BSY timers there (0.23.8)
    [ide_bus.cpp, ide_bus.h, main.cpp, test_pio_bus_early_sim.py, version.h]
2026-10-30 SD image: mark it contiguous after opening, so seeks are direct (0.23.9)
    A 4 GB image took 172 ms a read when the host alternated between far-apart
    sectors: SdFat walked the cluster chain on every backward seek.
2026-10-31 SD image: read and write card sectors through a map of the image's runs (0.23.10)
    The Pentium's 4 GB image was fragmented (14 runs) by restoring it with macOS
    cp, and SdFat walked its cluster chain on every backward seek: 172 ms a read.
    The map is built at open (contiguousRange, or the FAT32 chain) and checked
    against the file layer before use.
2026-10-31 no-iordy.md: the Pentium boots Windows 95 (BIOS path); Windows' own driver still corrupts
2026-10-31 Early answers: sample writes while DIOW# is low; run commands from the tight loop (0.23.11)
    The Pentium's FAT copies differed after Windows wrote them: bit 12 floated high
    (writes sampled after DIOW# rose) and a word was lost (a write missed while
    core 1 was in a main-loop pass).
    [config.h, ide_bus.cpp, ide_bus.h, main.cpp, test_pio_bus_early_sim.py, version.h]
2026-10-31 Early mode: raw trace from the tight loop, and an INTRQ edge count (0.23.12)
    [ide_bus.cpp, ide_bus.h, main.cpp, version.h]
2026-10-31 Bus observer: check image data on the cable against the sectors served (0.23.13)
2026-10-31 Bus observer: served sectors are data before IDENTIFY; padding doesn't identify (0.23.14)
    [sector_check.cpp, sector_check.h, test_sector_check.cpp, version.h]
2026-10-31 Early answers: drive DD at 8 mA, as DD12 lost word 0's zero bit on the Pentium (0.23.15)
2026-10-31 Console E: restart the card and retry when writing HDDSYNTH.INI fails (0.23.16)
    [sd_card.cpp, version.h]
2026-11-02 Two drives: ata::Device answers as master and slave, each unit's state swapped in on select
    Both units share the task file and one command engine (one command at a
    time on a cable); the selected unit's status, error and interrupt are
    swapped into place when the host changes DEV, so per-access paths are
    unchanged. Each Fetch carries its unit. With no device 1 the device
    answers for it as before. docs/two-drives.md has the design, and the
    folder drive's.
    [ata_device.cpp, ata_device.h, test_main.cpp, test_two_drives.cpp]
2026-11-02 Device 1 in the firmware: the slave setting, a folder or a second image, fetches by unit (0.29.0-2d.1)
    slave = NAME in HDDSYNTH.INI serves a folder (read-only FAT16, its list
    on the heap) or an image as device 1; core 0 serves each fetch from its
    unit's disk; the slave's IDENTIFY has its own model, serial, size and
    geometry; CONFIG and s lines show it; the bus observer accepts either
    unit's IDENTIFY. Host-tested end to end through ATA commands; not yet on
    hardware.
2026-11-02 Folder drive: partitions are whole tracks, as FDISK makes them; CI's image check reports each tool's output
    mtools refuses a volume whose sector count isn't a multiple of the sectors
    per track. CI's folder image step now runs all three checks and turns a
    failing one's output into an annotation.
    [folder_disk.cpp, test_folder_disk.cpp]
2026-11-02 Device 1's CMD lines end in d1; settings, CLAUDE.md and the design doc for the slave (0.29.0-2d.2)
2026-11-03 Settings device0 and device1 in place of image and slave; native tests run on Windows (0.29.0-2d.3)
    ATA's own names for the two drives on a cable. `image` still works as
    device0's old name: files from 0.28.0 and earlier need no change, device0
    counts if a file has both, and console E rewrites an image line as device0.
    CONFIG and stats lines, device 1's IDENTIFY (HDDSYNTH PRO D1, -D1), the code
    and the docs follow.
    test/run_native_tests.sh runs from Git Bash with MinGW g++ (python, UBSan in
    trap mode); rig.sh passes it its Python.
    On the rig, no device 1: -m speed matches 0.28.0 (reads 1.18 MB/s both,
    writes 1.06 against 1.08); slices 1-4 on 2d.2: 20 detections all fine, slices
    2-4 pass, sl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
2026-11-03 Docs: device 0 and device 1 in place of master and slave
    ATA's own names for the two drives on a cable, in the plan, the ATAPI note,
    PCB rev 0.4, the BOM and the retro checklist. The BOM's jumper row says once
    what drives print on theirs. Docs only, so no firmware version.
2026-11-03 Rig findings for 2d.3: the adapter shows device 1, early answers' slow reads
    The JM20337 bridge shows device 1 as a second disk after a USB restart;
    interleaved reads and writes across both were clean. The garbled names are
    inside the adapter (IDENTIFY right on the cable). Early answers hold about
    50,000 reads per speed run past 1,250 ns, on 0.28.0 too; detection has a few
    past it even without them, on 0.28.0 as well. And a note on going back to
    0.28.0 with a file that uses device0. Docs only.
2026-11-03 The data lane: data register reads answered by PIO and DMA, not core 1 (0.29.0-2d.4)
    With early_answers and isa off, ide_bus_data (ide_bus with an address check
    at the strobe) hands each data read to ide_data_in, a second state machine in
    the same block fed by a DMA channel from the device's block (docs/data-lane.md).
    Core 1 starts the channel before the host can see DRQ, moves the device on as
    soon as the block's last word is queued, and starts the next block when the
    host has read it. On the USB adapter: reads 1.54 MB/s (ide_bus 1.41, early
    answers 1.18), writes 1.65; about 17 reads over 1.25 us a speed run, against
    about 50,000 with early answers.
    Also: core 1 runs a queued command as so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
2026-11-03 A first ATAPI CD-ROM drive: the bb48_cdrom build serves an ISO or a test disc over PIO (0.29.0, exploratory)
    atapi::Device (the packet device's signature, IDENTIFY PACKET DEVICE,
    DEVICE RESET, PACKET in PIO) and mmc (the packet commands for a data disc)
    take ata::Device's place in the bb48_cdrom build, behind the same interface,
    picked by drive_device.h. A disc read is one 512-byte DRQ block per fetched
    sector, so ImageDisk serves an ISO unchanged. `cdrom =` in HDDSYNTH.INI.
    The hard disk build's core 1 code is unchanged, instruction for instruction
    at the same addresses as 0.28.0's. Host-tested only; not yet on hardware.
    [atapi_device.cpp, atapi_device.h, bus_observer.cpp, drive_config.cpp, drive_config.h, drive_device.h, ide_bus.cpp]
2026-11-03 Data lane: bounded command wait, lighter read-path lane check
    With a command queued, core 1 answers at most 8 waiting accesses (the first
    polls get BSY at once) before running it: running it at once held IDENTIFY's
    first poll 3 us, and never running it while polls came back to back left
    STATUS at BSY for good. The lane check before a register read only finishes a
    block the host has read, and tests DRQ first when no block is on the lane.
    The bus program's register reads skip the tail jump.
    On the rig: detections, slices 2-4 and -m speed pass (reads 1.53 MB/s, writes
    1.67). Status polls after each written sector and idle Alternate Status polls
    sit at about 1.25 us on every bus program, so bui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
    [config.h, ide_bus.cpp, main.cpp]
2026-11-03 CD-ROM bench prep: a checkable test ISO, a packet lister for slice C0, awkward-host tests, bench steps
    hddproto/test_iso.py builds an ISO whose files follow from their names
    (sim-tested by mounting it with hdiutil); test_cdrom_iso.py checks them on
    the disc the drive serves. hddproto/packets.py rebuilds ATAPI exchanges from
    a raw trace and flags opcodes src/mmc.h doesn't handle. More atapi_device
    tests for hosts that don't behave. docs/atapi.md: the bench, step by step.
    [packets.py, test_atapi_device.cpp, test_cdrom_iso.py, test_iso.py, test_packets.py, test_test_iso.py]
2026-11-03 Retro test results, 3 Nov evening: the data lane on the Evesham, two drives on both PCs, and the folder drive's start-up fault
    Steps 1-3 of docs/retro-test.md on the ICL 386 and the Evesham (0.29.0-2d.4,
    no firmware change). The lane: 2.18 MB/s reads and 1.98 writes on the
    Evesham, against early answers' 1.78 and 1.24, with Status reads held past
    ATA's 1,250 ns (up to 1,540). Both BIOSes find device 1 without DASP#. With
    device1 = GAMES the board doesn't start; the same folder lays out cleanly on
    the host. host/hddproto/test_folder.py makes the test folder.
    [test_folder.py, test_test_folder.py]
2026-11-03 CD-ROM build on its first retro PC (the Evesham), and CDCHECK.COM on the test ISO
    The Evesham's BIOS lists the drive as ATAPI; from a Windows 98 startup
    floppy (OAKCDROM.SYS, MSCDEX) it's D:, and CDCHECK passes all 13 files of
    the test ISO (216 READ(10), none failed). About 19,500 reads past 1,250 ns
    (worst 1,960, the host waited for each); the hard disk build had none on
    this PC, so the cause is in the CD build and still to find.
    CDCHECK.COM (tools/cdcheck, NASM) checks every file's size and CRC-32 on
    DOS; test_iso reads the ISO 9660 names back from a first build for its
    table and leaves out names DOS can't open.
    [test_iso.py, test_test_iso.py]
2026-11-03 Folder drive: the board starts with a folder as device 1 (0.29.0-2d.5)
    Arduino-Pico's libstdc++ is built without exceptions, so new (std::nothrow)
    aborts when memory runs out instead of returning nullptr. chooseDevice1()'s
    first 32 KB request for the folder's list failed (35,848 bytes free, not in
    one piece) and halted core 0, USB with it. malloc returns nullptr, so the
    list halves as intended. Found with a build printing each step.
    Also RIG_WATCHDOG_MS, a rig-only build flag: the hardware watchdog, so a
    build that halts restarts and can be flashed again with nobody to replug.
    [main.cpp, version.h]
2026-11-03 Lane: image checks on the cable; console P picks the bus program (0.29.0-2d.6)
    The bus observer's image checks were switched on with early answers only,
    so nothing was checked on the lane (the Evesham's bus_sectors=0). They are
    on whenever isa is off. On the rig, 16 MB from HDDSYNTH.IMG on the lane:
    5,805 sectors checked, 0 bad, no reads over 1,250 ns.
    Console P then e/l/i/0 picks the bus program until a power cycle (watchdog
    scratch 1). The console's restarts now wait for the reset, which the rig
    watchdog's feeding had put off for good.
    The folder drive seen working on the board, and the adapter's device 1 size
    quirk (the low byte of IDENTIFY word 60) noted.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
    [main.cpp, version.h]
2026-11-04 merge-cdrom on the rig: soak clean; the CD-ROM build meets an adapter that wants DMA for packets
2026-11-04 CD-ROM: PACKET's data by multiword DMA; DMA under early answers fixed (0.30.0-dev.3)
    - atapi::Device offers MDMA 0-2 when the settings do (IDENTIFY PACKET
    DEVICE words 49 and 63, SET FEATURES), and a PACKET with its DMA bit
    sends each block as an ide_dma burst, one interrupt at the status phase.
    The Windows rig's adapter sends every packet that way: Windows now
    mounts an ISO through it, and -m cdrom passes.
    - Early answers' tight loop now runs DMA in its idle work: the main loop's
    DMA step waited out EARLY_BUS_ONLY_US between bursts, so a 64 KB READ
    DMA took 12 s. Now 8.84 MB/s reads, 12.48 MB/s writes.
    [atapi_device.cpp, atapi_device.h, identify.cpp, main.cpp, test_atapi_device.cpp, version.h]
2026-11-04 DMA sim: bursts of a CD-ROM's lengths (4, 9, 18 and 256 words) in modes 0-2
2026-11-04 hdcd::Device: a hard disk as device 0 and a CD-ROM as device 1, host-tested
    Two devices on one cable, as on a real bus: writes to both, reads,
    commands and INTRQ to the one selected. atapi::Device takes a position
    (1: answers when DEV is 1, fetches carry unit 1 and ids with the top bit
    set, DEVICE RESET leaves it selected). Not yet in a build.
    [atapi_device.cpp, atapi_device.h, hdcd_device.cpp, hdcd_device.h, test_hdcd.cpp, test_main.cpp]
2026-11-04 bb48_hdcd: a hard disk as device 0 and a CD-ROM as device 1 (0.30.0-dev.4)
    device1 = cdrom (the cdrom setting's disc) or a device1 name ending in
    .ISO makes device 1 a CD-ROM drive: the ISO, the test disc after T or
    with cdrom = none, or no disc. Early answers instead of the lane with a
    CD-ROM, as in the CD-ROM build. The hard disk build notes such a device1
    as needing bb48_hdcd. bb48_drive's core 1 code is unchanged.
2026-11-04 Review fixes (0.30.0-dev.6): hdcd tracks the selection itself; discs open read-only; device 1 can't be device 0's image
    [hdcd_device.cpp, hdcd_device.h, main.cpp, sd_card.cpp, sd_card.h, test_hdcd.cpp, version.h]
2026-11-04 User docs: every setting and a which-settings table in the welcome README and settings.md; cdrom in the sample HDDSYNTH.INI
2026-11-04 EARLY_POLL_FIRST_NS: a candidate fix for the CD build's slow reads, off by default; warnings tidied (0.30.0-dev.8)
    [ide_bus.cpp, main.cpp, version.h]
2026-11-04 check_folder_img: pyfatfs lists folders before files
    The folder image was right; the checker matched entries in plain name
    order, which held only while every test subfolder sorted first (capital
    names). docs/release-notes, the first lower-case subfolder in docs/, which
    CI copies into its test folder, broke the assumption.
2026-11-04 Brief: mock-ups of the HDD Synth's CD-ROM screens
    Drawn with the synth's Canvas font and FDDSynthPro's layouts by
    tools/oled_mockups/render_cdrom.py: home (reading, seeking, idle, no disc,
    no link), the disc picker, ejecting/loading/refused, a laser trace and both
    drives. $HDL gains frames for the picker's sizes; bb48_hdcd sends $HDD for
    its hard disk too.
2026-11-04 Bench checklist: the branch and board as they are now (dev.8, dev.7 on the board)
2026-11-04 BIN/CUE images for the CD-ROM drive (0.30.0-dev.9)
    cdrom = NAME.CUE (or device1, or console M) serves the sheet's first
    track, if it is data, from its BIN: MODE1/2048, MODE1/2352, MODE2/2352,
    MODE2/2336. The track ends where the next one in its file starts, so a
    mixed-mode game serves its data without its audio. cue_sheet (pure,
    host-tested) parses the sheet and RawTrackDisk maps sectors into the raw
    frames; core 0 only, the hard disk build's core 1 code unchanged.
    tools/iso_to_bincue.py makes test images. Not yet run on the board.
2026-11-04 CUE sheets: a failed parse no longer blanks the open BIN's name; INDEX 1 without its leading zero
    [cue_sheet.cpp, main.cpp, test_cue_sheet.cpp]
2026-11-04 bb48_hdcd: a CD-ROM as device 1 runs on ide_bus, not early answers (0.30.0-dev.10)
    On the bench the USB adapter never got past its power-on register check
    with a CD-ROM as device 1 on early answers (LBA High recorded as 00, no
    read-back, every Status read held 1.7-2.4 us), never detected the drive
    and dropped off USB. On ide_bus both drives were detected and passed:
    the disk at full DMA speed, the CD-ROM's test disc at 3.42 MB/s, both at
    once, and disc changes seen by Windows. Console P e still picks early
    answers, to reproduce it. Bench results in the CHANGELOG.
2026-11-04 Bench: the adapter hangs when a CD-ROM vanishes under it; bench_session --as-is
    Every flash, restart or console V with a CD-ROM as device 1 left the USB
    adapter silent until replugged; hard disks alone were fine all evening.
    bench_session.py --as-is runs a step's tests on the board as it is set up,
    without the flash, console set-up and re-detection that take the drive off
    the bus. The soak now reads the CD-ROM throughout (the test disc, loaded
    first, so the reader wraps at its end). The checklist says what's left.
2026-11-04 Soak: a CD-ROM's ILLEGAL REQUEST to a packet it doesn't support isn't a failure
    bb48_hdcd's CD-ROM refuses opcodes it doesn't handle with sense key 5, as
    a real drive does, and Windows sends a few now and then: two stopped a soak
    after 10 minutes. They're counted and shown in the summary line instead.
    [test_soak.py]
2026-11-04 Bench: bb48_hdcd soaked an hour with the CD-ROM read throughout, clean
    11,976,335 sectors checked on the cable, 0 bad; 1,981 MB written and read
    back without a mismatch; the CD-ROM read 4.4 GB without an error. Worst
    read 3,280 ns (the CD-ROM's known slow reads). Release notes: the hour,
    and that a USB adapter setting the DMA bit on PACKET needs mode = mdma2.
2026-11-04 Bench: the Evesham with a hard disk and a CD-ROM, as the board is set up for it
2026-11-04 The Evesham with a hard disk and a CD-ROM: Doom, disc changes and a BIN/CUE under MSCDEX
    bb48_hdcd dev.10 on its first retro PC (Athlon XP, PCI IDE, ide_bus): both
    drives found, Doom from the CD with its saves on C:, every command good,
    bus_bad=0. MSCDEX notices disc changes; a BIN/CUE serves Doom's files.
    Found: 26 CD data reads the host didn't wait for IORDY, the CD's slow
    status reads (up to 3.6 us), and SD card dropouts that device 1's file
    reads don't recover from, with no CARD line for a quick loss and return.
    retro_log.py sends `M disc` lines with their Enter, as it does `E` lines.
2026-11-04 Device 1 gets over a card that stopped answering; CARD lines for quick dropouts (0.30.0-dev.11)
    From the Evesham session: after one SD card dropout every read of device 1
    (a CD's BIN or ISO) failed until a restart, `S` reported a silent card as
    `SD ok size_mb=0`, and two dropouts printed no CARD line.
    - Device 1's reads, writes and syncs are retried once after restarting the
    card (device 0's checks: the same card and image), and its file is
    reopened by name, at the same size, after any restart.
    - `S`, `M` and CUE sheets wake a silent card first (CMD9; restart if silent).
    - CARD lines compare the loss and restart counts too, so a loss and return
    within one pass prints `CARD lost and ba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
    [main.cpp, sd_card.cpp, sd_card.h, version.h]
2026-11-04 Bench checklist: dev.11's card fixes to check on the board first
2026-11-05 Card retry logic host-tested in card_retry.h; CLAUDE.md status brought up to date (0.30.0-dev.12)
    dev.11's decisions (retry device 1 once after restarting the card, how to
    restart it in each media_watch state, reopen device 1's file only at the
    same size) move from sd_card.cpp to header-only templates over the card's
    operations, tested with a fake card (17 tests). Behaviour unchanged; core 1
    functions at the same addresses and sizes in all three drive builds.
2026-11-05 NOIORDY lines name the command and when; data register slow reads apart (0.30.0-dev.13)
    For the Evesham's unwaited CD data reads, core 0 only: NOIORDY gives the
    command the read fell in or followed (command_history.h, host-tested), its
    device and timing; s adds iordy_ignored_data and the data register's reads
    held past 400 ns by bucket, with the worst. Core 1 functions unchanged in all
    three drive builds.
2026-11-05 Release notes: device 1's card recovery, early answers' slow reads, the Evesham's unwaited CD reads, card swaps
2026-11-08 The PCB build, pcb_drive: the SD card on 4-bit SDIO, PIO blocks shared out by pio_plan (0.31.0-sdio.1)
    SdFat's PIO SDIO driver at 25 MHz from power-up; a card left in SPI mode
    falls back to SPI at boot with a warning. pio_plan.h decides which PIO
    programs start (ide_dma, iocs16, the diagnostics, bus_timing) from SDIO, DMA
    and isa, host-tested, with its instruction counts checked against the
    assembled programs. Recovery uses card detect; the silent-card check ends the
    driver's open multi-sector read before CMD13, which otherwise returned other
    sectors' data with no error. BB48 builds' core 1 code unchanged.
    [config.h, main.cpp, pio_plan.h, sd_card.cpp, sd_card.h, test_main.cpp, test_pio_plan.cpp]
2026-11-08 pcb_drive: the test disk parks the card and gives its PIO block to the diagnostics; restarts to put a card back on SDIO (0.31.0-sdio.2)
2026-11-08 SDIO on the PCB: the parked card's diagnostics and the restart to SDIO, tested on the board
2026-11-08 A soak of the SD card path on HDDBENCH.IMG (-m cardsoak): marked sectors written and read back for hours, for SDIO with DMA, where the bus observer is off
2026-11-08 pcb_drive: our own copy of SdFat's SDIO driver, fixed (0.31.0-sdio.3)
    status/CMD6 end an open read first; only the two state machines it uses are
    claimed and freed, stopped before its programs go, pins back to SIO; no debug
    printing; no accidental bypass. Mounted through CardFs. BB48 builds unchanged.
    [pio_plan.h, sd_card.cpp, sdio_card.cpp, sdio_card.h, test_pio_plan_sizes.py, version.h]
2026-11-08 Undo the KiCad project file swept into the last commit (a local change, not part of it)
2026-11-08 CLAUDE.md: status after v0.30.0 and the PCB's first day
2026-11-08 sdio_card: the driver's own busy checks use a plain CMD13; only outside callers end the transfer first (0.31.0-sdio.4)
    sdio.3 ended every multi-sector write mid-stream (isBusy calls status), caught
    on the board by the speed test: 102 card restarts, data still right.
2026-11-08 Changelog: sdio.4's driver through the board checks
2026-11-08 PCB rev 0.4: the plan revised, and the schematic
    docs/pcb-rev04.md: what rev 0.4 adds, with what the retro PCs, the Amiga, the
    DMA soaks and the CD-ROM drive taught since 29 Oct: IOCS16#, a 44-pin
    connector, the microSD's power switch, series-resistor footprints, DASP#,
    PDIAG# and CSEL, CD audio by PWM, PSRAM and power from a retro PC. The
    debug header and the button are dropped.
    The schematic (gen_schematic.py, a new CD audio sheet), the Molex footprint,
    the new pins in src/config.h (unused by the firmware) and check_netlist.py's
    checks for them. ERC: 0 errors, 0 warnings.
    [audio.kicad_sch, hddsynthpro.kicad_sch, ide.kicad_sch, mcu.kicad_sch, power.kicad_sch, sd.kicad_sch]
2026-11-08 PCB rev 0.4: placed (not routed)
    Every rev 0.4 part placed on the Mk5 outline: the 44-pin header between the
    40-pin one and the edge, the series resistors beside the bus switches' pins,
    the PSRAM by the flash (D5 now a SOD-123 to make room), the microSD's power
    switch by the socket, CD audio on the right edge, the Molex header on the
    bottom edge. DRC: no overlaps or shorts; the connections are unrouted, to be
    routed with Freerouting on the Mac (hardware/README.md says what's left).
    [hddsynthpro.kicad_pcb, power.kicad_sch]
2026-11-08 PCB rev 0.4: first routing, and widen_power.py
    Freerouting 2.5.0 (Java 25 on Windows) routed the placed board in 7.5
    minutes. DRC with --schematic-parity: 0 unconnected pads, 0 differences,
    only rev 0.3's two USB-C silkscreen warnings. widen_power.py widens VB and
    SD_VDD as far as the clearances allow, since Freerouting doesn't keep the
    Power class's width; VB still has thin runs on the Molex and 44-pin paths,
    to be laid by hand next (hardware/README.md).
    [hddsynthpro.kicad_pcb]
2026-11-08 PCB rev 0.4: VB's long branches laid 0.6 mm before routing
    Freerouting ignores the Power class's width and left VB, the 5 V supply,
    at 0.2 mm on the Molex and 44-pin paths (about 0.3 ohm). layout_pcb.py now
    lays those two branches 0.6 mm wide and locked; the run along the top stays
    the router's, as fixing it too crowded the PSRAM and flash's QSPI lines off
    the board. Routed again: DRC with --schematic-parity finds 0 unconnected
    pads and 0 differences, only rev 0.3's two USB-C silkscreen warnings.
    [hddsynthpro.kicad_pcb]
2026-11-09 PCB rev 0.4: pin 20 of both IDE headers an unplated hole
    IDE's key. The headers JLCPCB stocks have a pin 20 and none leaves it out,
    so J5 and J7 now use copies of KiCad's footprints with pin 20 as an
    unplated hole, ringed on the silkscreen: the pin isn't soldered and pushes
    out with pliers after assembly, where rev 0.3's had to be cut. Swapped in
    place on the routed board (pin 20 has no tracks); the labels say to pull
    it. DRC with --schematic-parity: 0 unconnected, plus two expected warnings,
    since KiCad drops an unplated hole's pin number.
    [hddsynthpro.kicad_pcb, ide.kicad_sch]
2026-11-09 The PCB on the Evesham: SDIO and the data lane 4.24 MB/s reads; no unwaited CD reads on the PCB; the PIO card soak
2026-11-09 Plan: one drive build per board, a brief for the Windows rig
2026-11-09 0.32.0-dev.1: one drive build per board (step 2)
    bb48_drive and pcb_drive serve a hard disk, a CD-ROM drive or both by
    HDDSYNTH.INI: hdcd::Device takes the CD-ROM on unit 1 (device1 = cdrom)
    or alone on unit 0 (device0 = cdrom, new), and bb48_cdrom and bb48_hdcd
    are gone. cdSelected() is one mask and one compare for every layout.
    The READY line no longer names a build; the rig tests find a CD-ROM by
    console S.
    Also fixes the PCB parking the card under device 1's image when device 0
    served nothing from it, and console M opening a disc on a borrowed PIO
    block.
    Not yet run on the board: step 1's measurement and step 3 are next
    (docs/one-build-per-board.md).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
    [bus_observer.cpp, bus_observer.h, drive_config.cpp, drive_config.h, drive_device.h, hdcd_device.cpp]
2026-11-09 0.32.0-dev.2-4: one binary, two core 1 loops; a CD-ROM always on ide_bus
    Step 1 on the PCB showed hdcd::Device isn't free for the hard disk alone:
    PIO writes 20-27% slower than 0.31.0's bb48_drive. Core 1's bus code is
    now compiled for ata::Device and for hdcd::Device, and loop1 picks one at
    boot; the hard disk alone matches 0.31.0 within 2.5% (its functions are
    byte-identical, further on in RAM). ide_bus's functions are CORE1_RAM
    overloads around inlined templates, since an explicit instantiation went
    to flash.
    dev.3: a CD-ROM as device 0 runs ide_bus, as device 1's does: on early
    answers the adapter never detected it. dev.4: S and s report the
    diagnostics as off once a disc has taken thei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
2026-11-09 0.32.0-dev.5: the hard disk's core 1 code back at 0.31.0's addresses
    The CD-ROM's core 1 code (atapi_device, hdcd_device, mmc and the
    hdcd::Device copies of ide_bus's and main.cpp's per-access functions) moves
    to a section of its own placed after all of CORE1_RAM, so the hard disk's
    functions sit where 0.31.0 had them. PIO reads on the PCB match 0.31.0
    again (1.20 MB/s, 337 us a sector; dev.4 1.18). Writes stay 2% short, not
    from core 1's per-access code.
    [atapi_device.cpp, core1_ram.h, hdcd_device.cpp, ide_bus.cpp, main.cpp, mmc.cpp, version.h]
2026-11-09 Speed log for one build per board; v0.32.0 release notes (draft)
2026-11-09 Speed log: one drive build per board
2026-11-10 dev.5's CD-ROM works on the board; rig tests ignore a CD-ROM's polls
    The overnight failure was the Evesham's dma = off with an adapter that
    sets the DMA bit on every PACKET: noted in the settings and release notes.
    [drive_log.py, test_drive_log.py]
2026-11-10 CLAUDE.md: the rig and status sections cut to the current state
    History stays in CHANGELOG.md and docs/speed-log.md. The rig notes gain
    this morning's CD-ROM findings; the status gains the known issues and an
    updated next list. 43 KB -> 32 KB.
2026-11-10 Core 1's hard disk code at a fixed place in RAM, checked by CI
    scripts/core1_layout.py patches the generated linker script so CORE1_RAM
    code goes first in .data, file by file in 0.31.0's order;
    scripts/check_core1_layout.py fails CI if any of it moves. Every symbol
    in both drive builds is where it was.
    [core1_ram.h, test_core1_layout.py]
2026-11-10 0.32.0-dev.6: the access log, for the CD-ROM's slow Device reads
    A bench diagnostic (-DHDDPRO_ACCESS_LOG=1): core 1's last jobs before a
    read answered late, printed as ACCLOG lines. Off, core 1's code is
    unchanged (check_core1_layout.py). The slow reads and what the code says
    are in docs/atapi.md.
2026-11-10 Candidate fixes for the CD-ROM's slow reads, off; the bench checklist rewritten
    HDDPRO_HDCD_FAST_WRITES and HDDPRO_HDCD_LAZY_INTRQ keep what the host sees
    as it is; test_hdcd now runs both ways. Off, nothing in the firmware moves.
    [ata_device.h, atapi_device.h, hdcd_device.cpp, hdcd_device.h, ide_bus.cpp, test_hdcd.cpp]
2026-11-10 PCB rev 0.4: R53, a 10k backup pull-up on IORDY (header side, to 3.3 V)
    For hosts that don't pull IORDY up: a floating IORDY can read as not
    ready for good, the likeliest reason a second NS1081 adapter never
    detected rev 0.3. Placed on the routed board between U5 and J5, its
    IORDY pad by a via and a 3.5 mm bottom-layer trace to IORDY's via; no
    other trace moved. DRC as before, check_netlist.py now requires it.
    Production files regenerated (they also pick up yesterday's unplated
    pin 20).
    [audio.kicad_sch, bom.csv, designators.csv, hddsynthpro.kicad_pcb, ide.kicad_sch, positions.csv, sd.kicad_sch]
2026-11-10 0.32.0-dev.7: the CD-ROM fix switches removed, measured no help
    The access log showed core 1 idle before the CD-ROM's slow register reads,
    and the two candidate fixes made no difference on the bench. The firmware
    is dev.5's again; the two new hdcd tests stay. Today's bench results
    (slices 1-2, the card soak, the access log, the comparison) are in the
    CHANGELOG and the release notes.
    [ata_device.h, atapi_device.h, hdcd_device.cpp, hdcd_device.h, ide_bus.cpp, test_hdcd.cpp, version.h]
2026-11-10 PCB rev 0.4: FDD Synth Pro-style labels, the credit and two easter eggs on the back
    Header labels bold and knocked out of a filled box, as on the FDD Synth Pro,
    with the references they stand for hidden; "Nostalgia by Peter Bridger" up
    the back's left edge; Defrag and Park Heads (tools/make_eggs.py) on the back
    where no pad or via is under them. DRC and parity as before; BOM and
    placement unchanged.
    [designators.csv, hddsynthpro.kicad_pcb]
2026-11-10 PCB rev 0.4: Defrag upright between the IDE headers, reading up
    Clear of vias and pads there. Rotations are now set before the flip onto
    the back, so each egg keeps reading the right way from there. DRC, parity,
    ERC and check_netlist as before.
    [hddsynthpro.kicad_pcb]
2026-11-10 Renamed IDE Synth Bay: the new logo on the PCB, the hardware docs
    The project is now IDE Synth Bay (formerly HDD Synth Pro). make_logo.py
    makes LOGO_IDESynthBay from media/IDESynthBay.png (Pillow, so it runs on
    Windows too; BAY's thin bars closed into solid letters); the back's name
    and the schematic's title blocks follow. File names, library names and
    generator IDs keep the old name. ERC clean, DRC and parity as before,
    check_netlist passes, BOM and placement unchanged.
    [audio.kicad_sch, hddsynthpro.kicad_pcb, hddsynthpro.kicad_sch, ide.kicad_sch, mcu.kicad_sch, power.kicad_sch, sd.kicad_sch]
2026-11-10 0.32.0
    One drive build per board: bb48_drive and pcb_drive serve a hard disk, a
    CD-ROM drive or both, by HDDSYNTH.INI. Release notes:
    docs/release-notes/v0.32.0.md.
2026-11-10 PCB rev 0.4 ordered: the status in CLAUDE.md and the hardware docs
2026-11-10 The Evesham: a wrong CD-ROM data word on the cable, Doom quits; logged
2026-11-10 0.32.1-dev.1: time each read's strobe in the bus observer; STUCK names a CD-ROM's command
    For the Evesham's wrong CD-ROM data word (docs/atapi.md):
    - The simulator rules out a host skipping its IORDY wait: IORDY is low in
    time for back-to-back reads down to 20 ns of recovery, and iordy_check
    flags every unwaited read that comes back wrong (test_stale_word_sim.py;
    the host model gains observers, a DD keeper, IORDY rise time, and strobes
    that ignore IORDY).
    - -DHDDPRO_OBSERVER_STROBE=1: bus_observer_strobe counts how long DIOR# was
    low, and BUSERR reports the wrong word's strobe against its neighbours',
    to tell a strobe cut short (electrical) from the drive offering the wrong
    wor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
    [bus_observer.cpp, ide_host_model.py, main.cpp, pio_plan.h, sector_check.cpp, sector_check.h, test_bus_observer_sim.py, test_cdrom_soak.py]
2026-11-11 0.32.1-dev.6: the Evesham's wrong CD-ROM word was the IORDY watchdog; fixed
    A CD-ROM forced isa on (to keep ide_bus), which started iordy_watchdog on
    PCI hosts. It took back-to-back data reads for one 23 us hold and released
    IORDY mid-read, so the host latched DD before the drive drove it. The
    CD-ROM now leaves isa alone (dev.5: 0 bad in 41,640 sectors, against one in
    15,000 before), and the watchdog starts over at every strobe (dev.6). Adds
    EARLYDATA and iordy_early_data.
    [ide_bus.cpp, ide_bus.h, iordy_timer.cpp, iordy_timer.h, main.cpp, test_iordy_watchdog_sim.py, version.h]
2026-11-11 0.32.1
    The CD-ROM no longer turns isa on, which fixed a wrong data word on the
    Evesham (82,176 sectors clean since). dev.6's strobe-aware watchdog is left
    out, on branch watchdog-strobes, until it has run on the ICL 386 (PCB rev
    0.4 wires IOCS16#; the reminder is in CLAUDE.md's Next and pcb-rev04.md).
    [ide_bus.cpp, test_iordy_watchdog_sim.py, version.h]
2026-11-11 0.32.2-dev.3: cheaper register accesses with a CD-ROM (slow Status polls)
    The access log on the Evesham showed each register write costing core 1
    about 1.6 us with a CD-ROM configured, so a status poll after Device Control
    and Device writes waited up to 5 us. hdcd::Device::writeQuiet handles the
    writes that can't start a command without write()'s bookkeeping, and core 1
    skips the INTRQ update after accesses that can't change it; INTRQ is worked
    out inline. The hard disk alone keeps its code (layout unchanged). dev.2 on
    the Evesham: 0.64 slow reads per READ(10) against 1.32, worst 2,810 ns
    against 4,270. Also: core 1's interrupts in s (c1_irq), the bench switch
    -DHDDPRO_C1_NO_IRQ, and the acc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
    [ata_device.h, atapi_device.h, hdcd_device.h, ide_bus.cpp, main.cpp, test_hdcd.cpp, version.h]
2026-11-11 Slice 2: a CD-ROM beside the disk aborts IDENTIFY DEVICE, as it must
    Only the disk's IDENTIFY DEVICE has to succeed; an ATAPI device refuses it
    (the host then sends IDENTIFY PACKET DEVICE).
2026-11-11 0.32.2-dev.4: reads keep their INTRQ update; an hour's CD soak clean
    The read-side INTRQ skip slowed the USB adapter's CD-ROM reads by DMA by a
    quarter; undone. -m cdsoak's first run, an hour on pcb_drive: 498,293 CD
    reads and 99,935 disk reads, 0 wrong, 8.4 million sectors checked on the
    cable, 0 bad.
    [ide_bus.cpp, version.h]
2026-11-11 0.32.3-dev.1: the drive says which bus program it would choose (auto-bus step one)
    src/auto_bus applies docs/auto-bus.md's rule to counters core 0 keeps, from
    each RESET# release, and prints AUTOBUS lines and autobus fields in s.
    Advice only: nothing switches. Inputs are new never-cleared totals. Core 1
    unchanged. Host-tested (test_auto_bus.cpp); not yet on hardware.
    [auto_bus.cpp, auto_bus.h, bus_observer.cpp, bus_observer.h, iordy_timer.cpp, iordy_timer.h, main.cpp]
2026-11-12 PCB: one solder mask opening per row of fine-pitch pads on U1 and J1
    The RP2350B's QFN-80 and the USB-C socket have pads 0.2 mm apart, too close
    for a strip of black solder mask (PCBWay's minimum is 0.22 mm), so PCBWay
    asked whether to leave those strips out. make_footprints.py now makes copies
    of KiCad's two footprints with one F.Mask opening over each such row (and
    the allow_soldermask_bridges attribute); the board, schematic, gen_schematic.py
    and jlcpcb.py use them. Copper and paste unchanged. The narrowest mask strip
    left on the board is 0.25 mm. DRC (schematic parity), ERC and
    check_netlist.py as before. production/ still holds rev 0.4's files as sent.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
    [hddsynthpro.kicad_pcb, mcu.kicad_sch, power.kicad_sch]
2026-11-12 Hardware: check_mask_webs.py, and the solder mask rule in CLAUDE.md
    A fab can't make a strip of black solder mask under 0.22 mm between two
    openings (PCBWay asked about rev 0.4's RP2350B, 11 Nov 2026).
    hardware/tools/check_mask_webs.py (KiCad's Python) merges every mask opening
    on a board and fails on any strip narrower than that, naming the parts: the
    board passes since cb6df98, and failed on U1 and J1 before it. CLAUDE.md
    records the rule, and the hardware README's checks run it.
    [check_mask_webs.py]
