MaverickUK/HDDSynthPro/(notices)

Notices in the files:
parts and their libraries:
Abracon AOTA-B201610S3R3-101-T, 3.3 uH, 2016, polarity marked. From Raspberry Pi's RP2350 minimal design (MIT licence). Pad 1 to the 1.1 V side.
0402 capacitor with Raspberry Pi's wide pad layout (RP2350 minimal design, MIT licence).
